andrastantos/unic/pics/fpga_solder_job.png

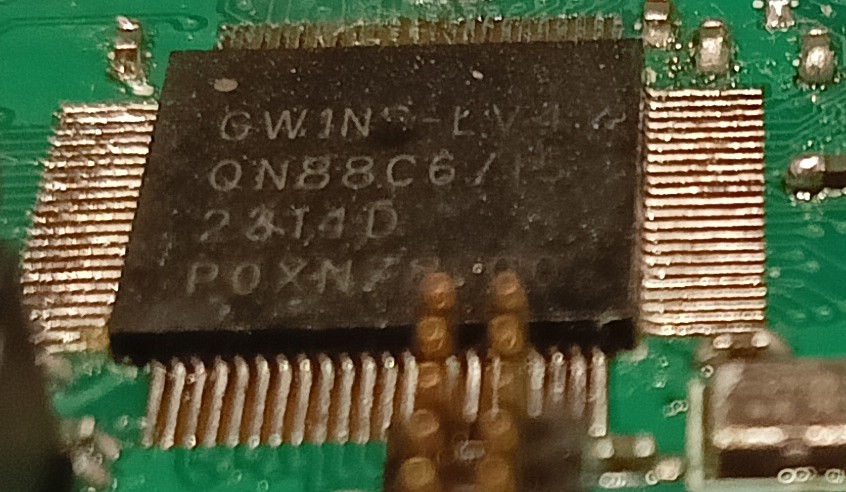
pics/fpga_solder_job.png
