andrastantos/unic/pics/IMG20240216153713.jpg

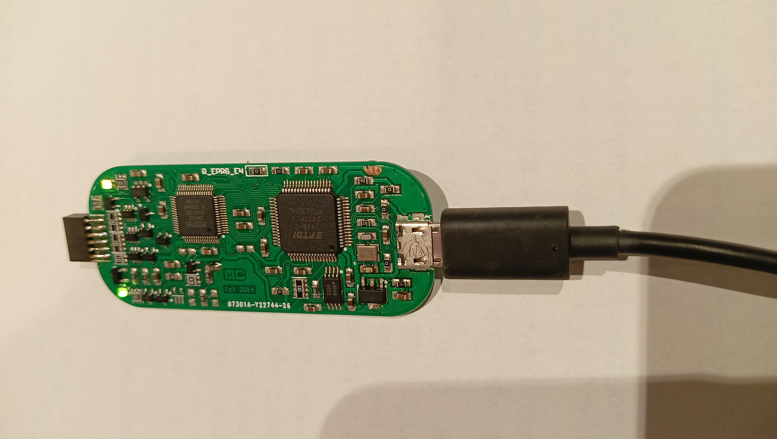
pics/IMG20240216153713.jpg
