andrastantos/unic/cores/unic_8088/readme.txt

cloned from https://github.com/MiSTer-devel/PCXT_MiSTer.git
