andrastantos/unic/datasheets/ledger_nano_s_display.webp

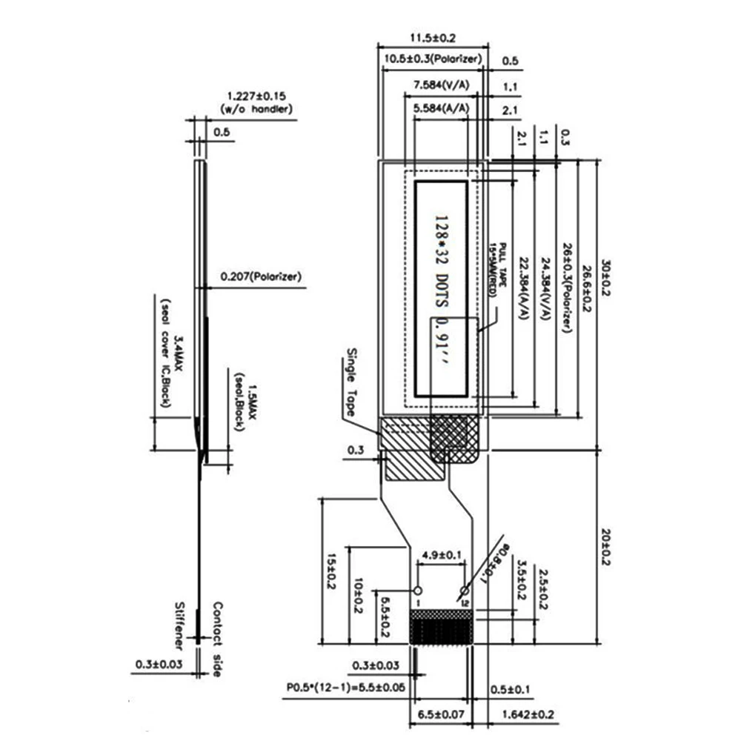
datasheets/ledger_nano_s_display.webp
