andrastantos/unic/pics/esd_protection.png

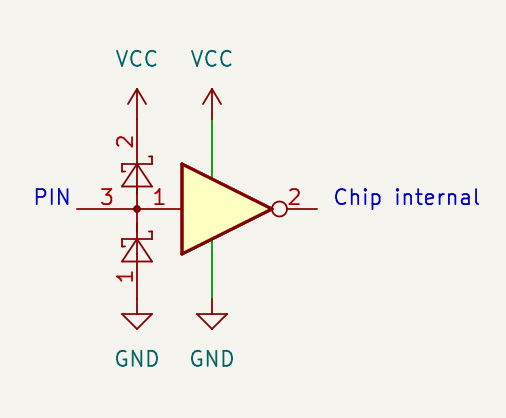
pics/esd_protection.png
