andrastantos/unic/pics/IMG20240216153532.jpg

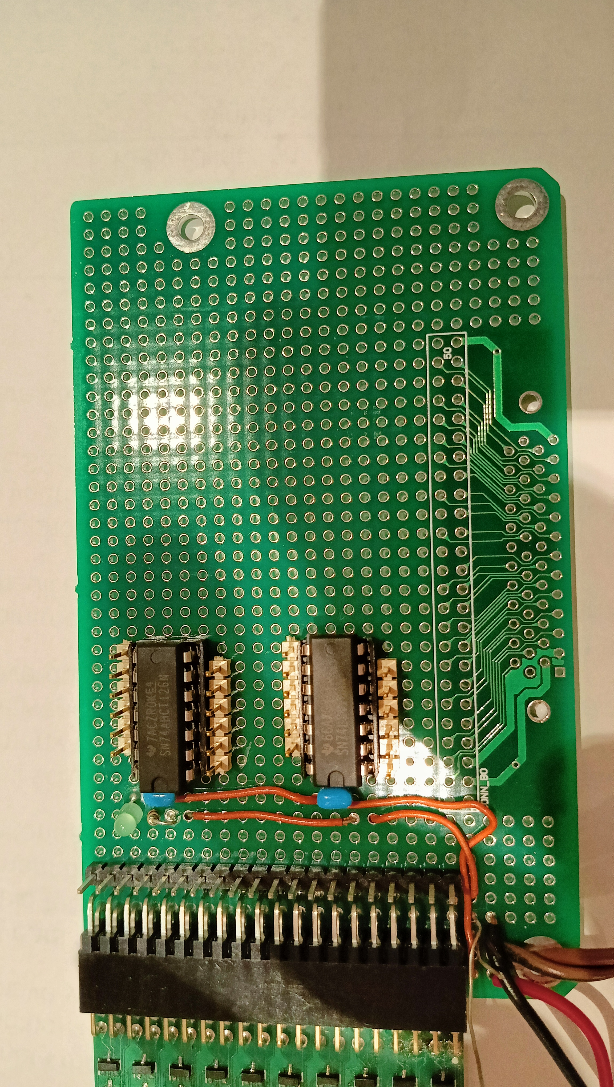
pics/IMG20240216153532.jpg
