andrastantos/unic/pics/IMG20240216153554.jpg

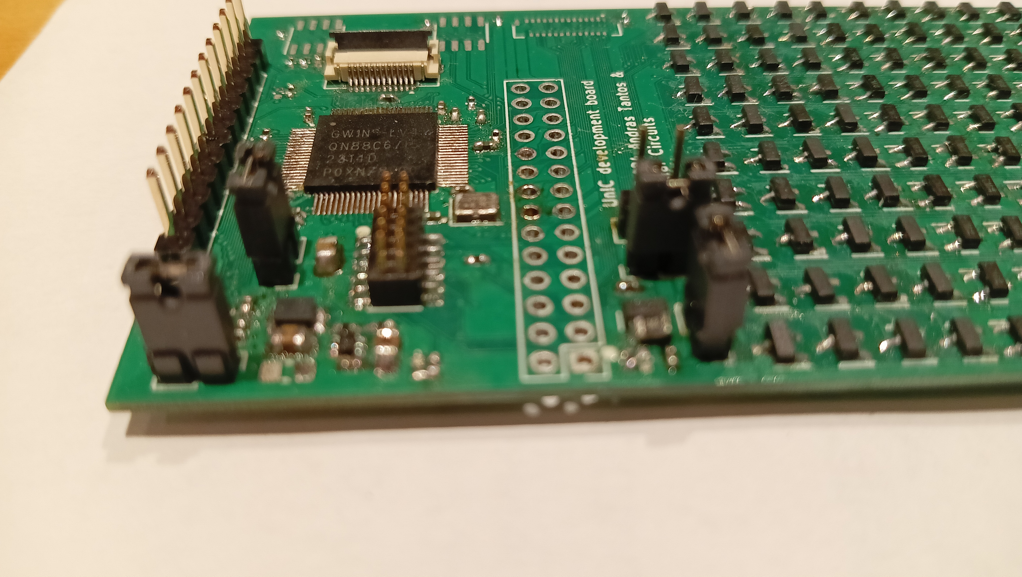
pics/IMG20240216153554.jpg
