andrastantos/unic/pics/level_shifter.png

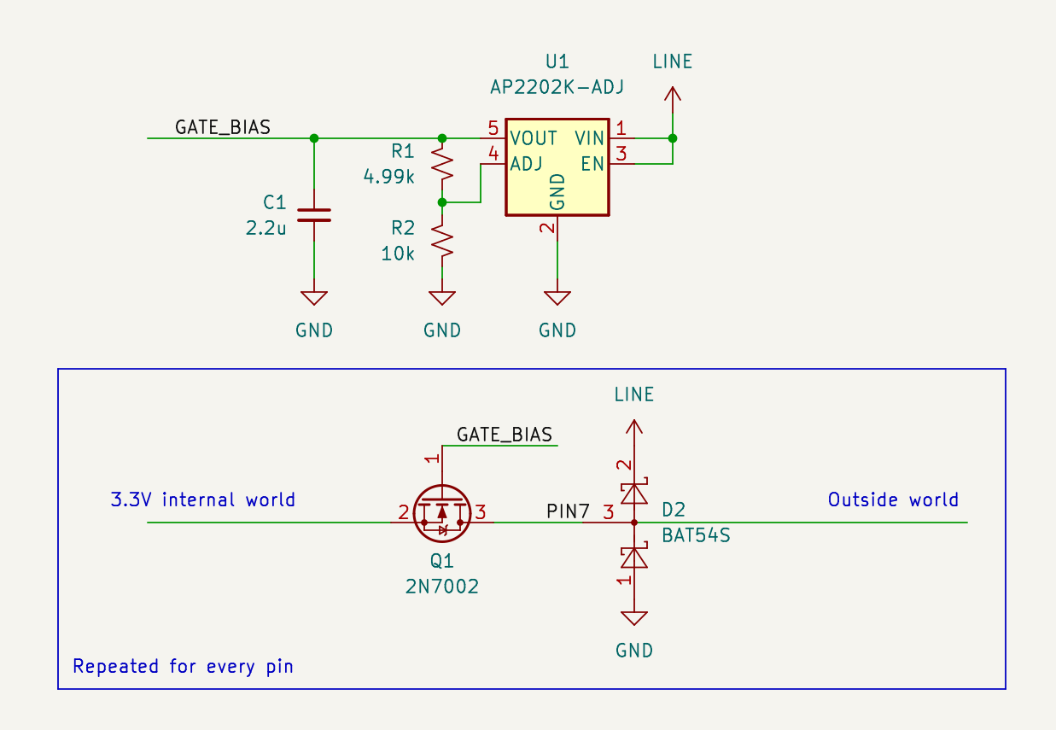
pics/level_shifter.png
