andrastantos/unic/pics/oled.png

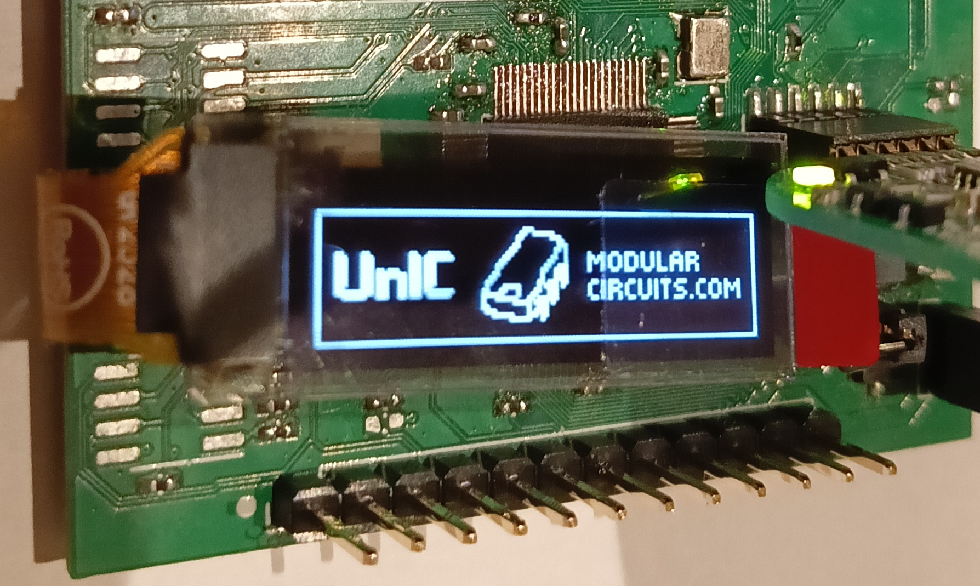
pics/oled.png
