andrastantos/unic/pics/Picture 2024-02-05 17-20-37.png

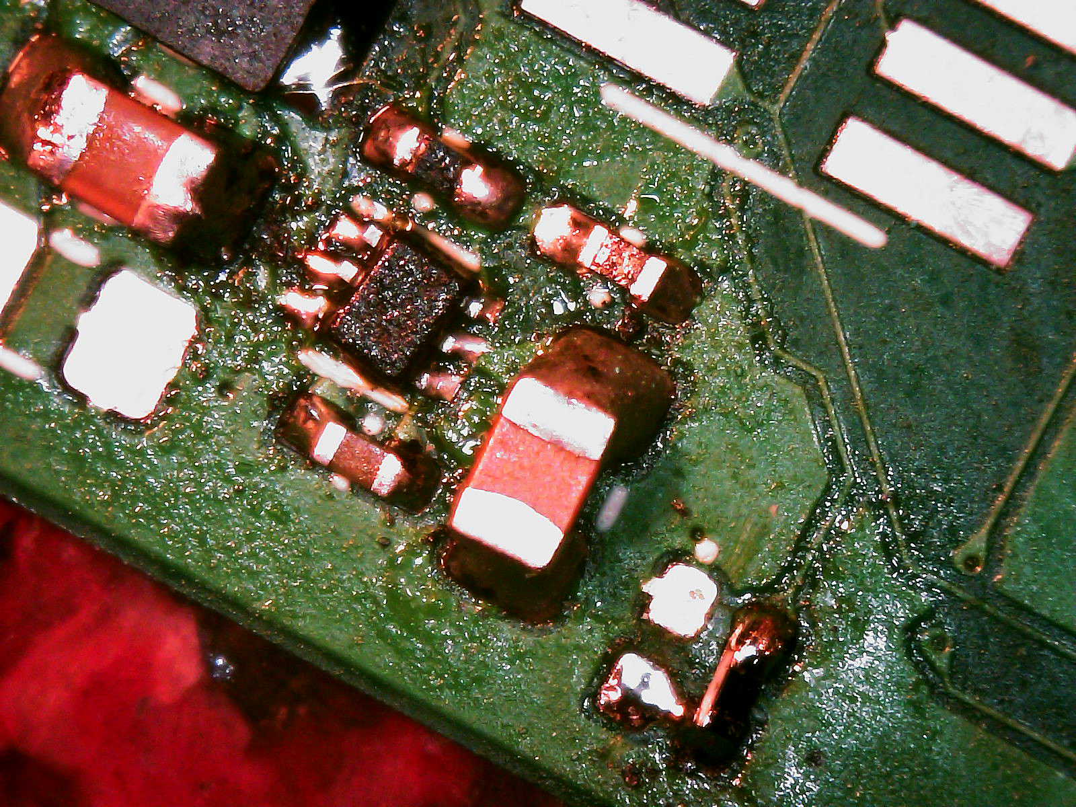
pics/Picture 2024-02-05 17-20-37.png
