andrastantos/unic/pics/SDS00025.png

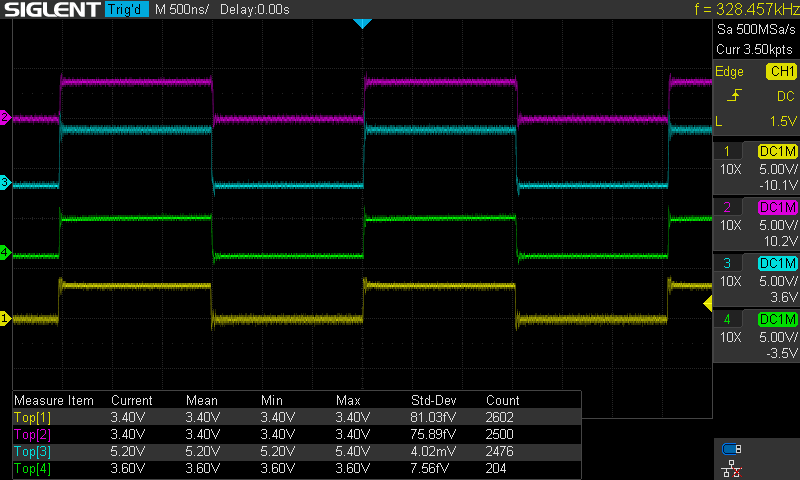
pics/SDS00025.png
