andrastantos/unic/pics/SDS00026.png

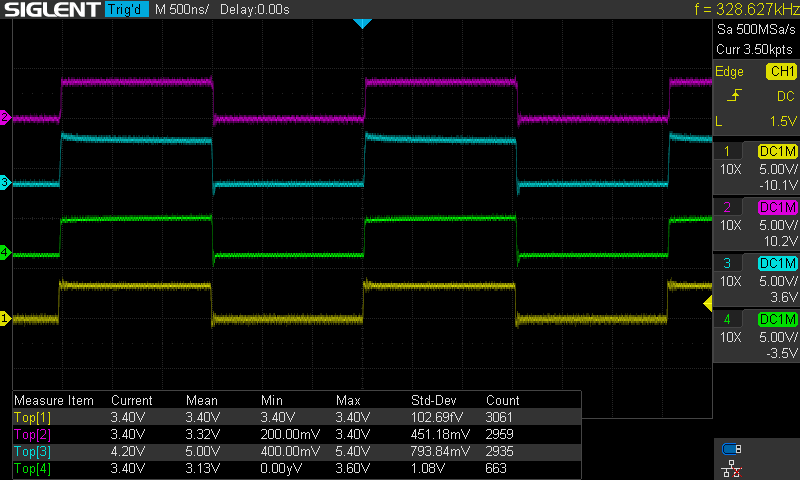
pics/SDS00026.png
