andrastantos/unic/pics/SDS00027.png

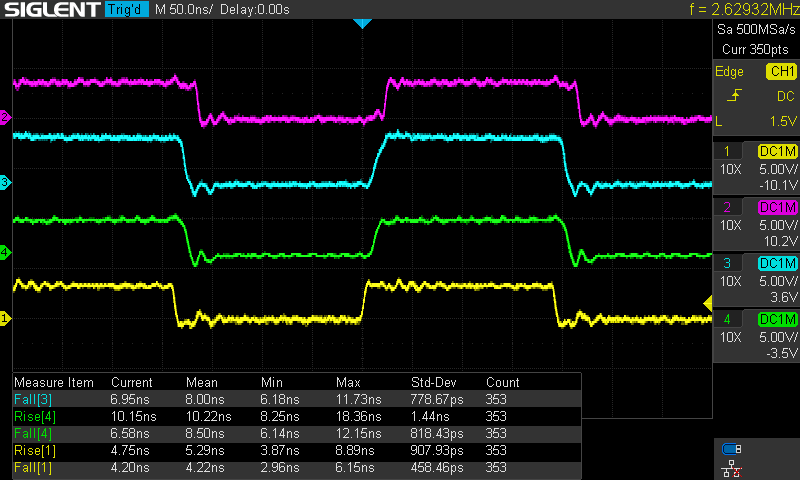
pics/SDS00027.png
