andrastantos/unic/pics/unic_gw1.png

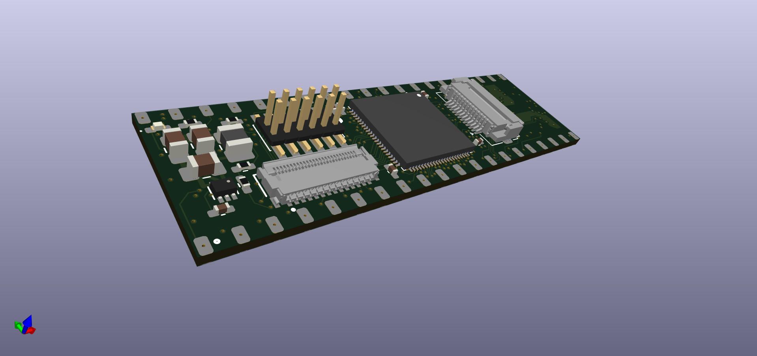
pics/unic_gw1.png
