andrastantos/unic/datasheets/gowin_fpga/UG168-1.2E_GW2A-18 & GW1N-9 FPGA Products Packages Compatibility Comparison.xlsx

Sheet: Version History
Date | Version | Description
03/10/2023 | 1.2E | The compatibility comparison of LQ144 removed.

Sheet: QN88
Note!
The shading with different colors is defined as follows:
1 |  | different pin functions
2 |  | different power
3 |  | different configuration functions
4 |  | different TRUE LVDS
5 | Pins with no shading are compatible
6 | No BANK compatibility comparison
7 | GW2A series VCC with 1.0V, GW1N series VCC with 1.2V
8 | GW2A series includes EXTR pin, GW1N series excludes EXTR pin
GW2A-18 QN88 |  |  |  |  |  |  |  | GW1N-9 QN88
QN88 | Pin Name | Function | DQS | BANK | Configuration Function | Differential Pair | LVDS | QN88 | Pin Name | Function | BANK | Configuration Function | Differential Pair | LVDS | X16
1 | VCC | Power |  | N/A |  |  |  | 1 | VCC | Power | N/A
2 | VSS | Ground |  | N/A |  |  |  | 2 | VSS | Ground | N/A
3 | VCCO7 | Power |  | N/A |  |  |  | 3 | IOL2A | I/O | 3 |  | True_of_IOL2B | TRUE | NONE
4 | IOL7A/LPLL1_T_in | I/O | DQ0 | 7 | LPLL1_T_in | True_of_IOL7B | NONE | 4 | IOL5A/JTAGSEL_N/LPLL_T_in | I/O | 3 | JTAGSEL_N/LPLL_T_in | True_of_IOL5B | NONE | NONE
5 | IOR25B/TMS | I/O | DQ10 | 2 | TMS | Comp_of_IOR25A | NONE | 5 | IOL11A/TMS | I/O | 3 | TMS | True_of_IOL11B | TRUE | NONE
6 | IOR26A/TCK | I/O | DQ10 | 2 | TCK | True_of_IOR26B | TRUE | 6 | IOL11B/TCK | I/O | 3 | TCK | Comp_of_IOL11A | TRUE | NONE
7 | IOR26B/TDI | I/O | DQ10 | 2 | TDI | Comp_of_IOR26A | TRUE | 7 | IOL12B/TDI | I/O | 3 | TDI | Comp_of_IOL12A | NONE | NONE
8 | IOR25A/TDO | I/O | DQ10 | 2 | TDO | True_of_IOR25B | NONE | 8 | IOL13A/TDO | I/O | 3 | TDO | True_of_IOL13B | TRUE | NONE
9 | IOR31B/RECONFIG_N | I/O | DQ9 | 3 | RECONFIG_N | Comp_of_IOR31A | TRUE | 9 | IOL13B/RECONFIG_N | I/O | 3 | RECONFIG_N | Comp_of_IOL13A | TRUE | NONE
10 | IOL29A/GCLKT_6 | I/O | DQ2 | 6 | GCLKT_6 | True_of_IOL29B | TRUE | 10 | IOL14A/DONE | I/O | 3 | DONE | True_of_IOL14B | NONE | NONE
11 | IOL29B/GCLKC_6 | I/O | DQ2 | 6 | GCLKC_6 | Comp_of_IOL29A | TRUE | 11 | IOL15A/GCLKT_6 | I/O | 3 | GCLKT_6 | True_of_IOL15B | TRUE | NONE
12 | VCCX/VCCO2/VCCO6 | Power |  | N/A |  |  |  | 12 | VCCO3 | Power | N/A
13 | IOL45A/LPLL2_T_in | I/O | DQ2 | 6 | LPLL2_T_in | True_of_IOL45B | NONE | 13 | IOL22A | I/O | 3 |  | True_of_IOL22B | TRUE | NONE
14 | VCCPLLL1 | Power |  | N/A |  |  |  | 14 | IOL22B | I/O | 3 |  | Comp_of_IOL22A | TRUE | NONE
15 | IOL47A/LPLL2_T_fb | I/O | DQ3 | 6 | LPLL2_T_fb | True_of_IOL47B | TRUE | 15 | IOL26A | I/O | 3 |  | True_of_IOL26B | TRUE | NONE
16 | IOL47B/LPLL2_C_fb | I/O | DQ3 | 6 | LPLL2_C_fb | Comp_of_IOL47A | TRUE | 16 | IOL26B | I/O | 3 |  | Comp_of_IOL26A | TRUE | NONE
17 | IOL49A | I/O | DQ3 | 6 |  | True_of_IOL49B | TRUE | 17 | IOB2A | I/O | 2 |  | True_of_IOB2B | TRUE | x16
18 | IOL49B | I/O | DQ3 | 6 |  | Comp_of_IOL49A | TRUE | 18 | IOB2B | I/O | 2 |  | Comp_of_IOB2A | TRUE | NONE
19 | IOL51A | I/O | DQ3 | 6 |  | True_of_IOL51B | TRUE | 19 | IOB4A | I/O | 2 |  | True_of_IOB4B | TRUE | x16
20 | IOL51B | I/O | DQ3 | 6 |  | Comp_of_IOL51A | TRUE | 20 | IOB4B | I/O | 2 |  | Comp_of_IOB4A | TRUE | NONE
21 | VSS | Ground |  | N/A |  |  |  | 21 | VSS | Ground | N/A
22 | VCC | Power |  | N/A |  |  |  | 22 | VCC | Power | N/A
23 | VCCO5 | Power |  | N/A |  |  |  | 23 | VCCO2 | Power | N/A
24 | VSS | Ground |  | N/A |  |  |  | 24 | VSS | Ground | N/A
25 | IOB6A | I/O | DQ4 | 5 |  | True_of_IOB6B | TRUE | 25 | IOB8A | I/O | 2 |  | True_of_IOB8B | TRUE | x16
26 | IOB6B | I/O | DQ4 | 5 |  | Comp_of_IOB6A | TRUE | 26 | IOB8B | I/O | 2 |  | Comp_of_IOB8A | TRUE | NONE
27 | IOB8A | I/O | DQ4 | 5 |  | True_of_IOB8B | TRUE | 27 | IOB11A | I/O | 2 |  | True_of_IOB11B | TRUE | x16
28 | IOB8B | I/O | DQ4 | 5 |  | Comp_of_IOB8A | TRUE | 28 | IOB11B | I/O | 2 |  | Comp_of_IOB11A | TRUE | NONE
29 | IOB14A | I/O | DQ5 | 5 |  | True_of_IOB14B | TRUE | 29 | IOB13A | I/O | 2 |  | True_of_IOB13B | TRUE | x16
30 | IOB14B | I/O | DQ5 | 5 |  | Comp_of_IOB14A | TRUE | 30 | IOB13B | I/O | 2 |  | Comp_of_IOB13A | TRUE | NONE
31 | IOB18A | I/O | DQ5 | 5 |  | True_of_IOB18B | TRUE | 31 | IOB17A | I/O | 2 |  | True_of_IOB17B | TRUE | x16
32 | IOB18B | I/O | DQ5 | 5 |  | Comp_of_IOB18A | TRUE | 32 | IOB17B | I/O | 2 |  | Comp_of_IOB17A | TRUE | NONE
33 | IOB24A | I/O | DQ5 | 5 |  | True_of_IOB24B | TRUE | 33 | IOB23A | I/O | 2 |  | True_of_IOB23B | TRUE | x16
34 | IOB24B | I/O | DQ5 | 5 |  | Comp_of_IOB24A | TRUE | 34 | IOB23B | I/O | 2 |  | Comp_of_IOB23A | TRUE | NONE
35 | IOB30A/GCLKT_4 | I/O | DQ6 | 4 | GCLKT_4 | True_of_IOB30B | TRUE | 35 | IOB29A/GCLKT_4 | I/O | 2 | GCLKT_4 | True_of_IOB29B | TRUE | x16
36 | IOB30B/GCLKC_4 | I/O | DQ6 | 4 | GCLKC_4 | Comp_of_IOB30A | TRUE | 36 | IOB29B/GCLKC_4 | I/O | 2 | GCLKC_4 | Comp_of_IOB29A | TRUE | NONE
37 | IOB34A | I/O | DQ6 | 4 |  | True_of_IOB34B | TRUE | 37 | IOB31A | I/O | 2 |  | True_of_IOB31B | TRUE | x16
38 | IOB34B | I/O | DQ6 | 4 |  | Comp_of_IOB34A | TRUE | 38 | IOB31B | I/O | 2 |  | Comp_of_IOB31A | TRUE | NONE
39 | IOB40A | I/O | DQ6 | 4 |  | True_of_IOB40B | TRUE | 39 | IOB33A | I/O | 2 |  | True_of_IOB33B | TRUE | x16
40 | IOB40B | I/O | DQ6 | 4 |  | Comp_of_IOB40A | TRUE | 40 | IOB33B | I/O | 2 |  | Comp_of_IOB33A | TRUE | NONE
41 | IOB43A | I/O | DQ6 | 4 |  | True_of_IOB43B | NONE | 41 | IOB41A | I/O | 2 |  | True_of_IOB41B | TRUE | x16
42 | IOB42B | I/O | DQ6 | 4 |  | Comp_of_IOB42A | TRUE | 42 | IOB41B | I/O | 2 |  | Comp_of_IOB41A | TRUE | NONE
43 | VSS | Ground |  | N/A |  |  |  | 43 | VSS | Ground | N/A
44 | VCCO4 | Power |  | N/A |  |  |  | 44 | VCCO2 | Power | N/A
45 | VCC | Power |  | N/A |  |  |  | 45 | VCC | Power | N/A
46 | VSS | Ground |  | N/A |  |  |  | 46 | VSS | Ground | N/A
47 | EXTR | Ground |  | N/A |  |  |  | 47 | IOB43B | I/O | 2 |  | Comp_of_IOB43A | TRUE | NONE
48 | IOR49B | I/O | DQ8 | 3 |  | Comp_of_IOR49A | TRUE | 48 | IOR24B | I/O | 1 |  | Comp_of_IOR24A | TRUE | NONE
49 | IOR49A | I/O | DQ8 | 3 |  | True_of_IOR49B | TRUE | 49 | IOR24A | I/O | 1 |  | True_of_IOR24B | TRUE | NONE
50 | VCCPLLR1 | Power |  | N/A |  |  |  | 50 | IOR22B | I/O | 1 |  | Comp_of_IOR22A | TRUE | NONE
51 | IOR45A/RPLL2_T_in | I/O | DQ9 | 3 | RPLL2_T_in | True_of_IOR45B | NONE | 51 | IOR17B/GCLKC_3 | I/O | 1 | GCLKC_3 | Comp_of_IOR17A | TRUE | NONE
52 | IOR39A/SCLK | I/O | DQ9 | 3 | SCLK | True_of_IOR39B | NONE | 52 | IOR17A/GCLKT_3 | I/O | 1 | GCLKT_3 | True_of_IOR17B | TRUE | NONE
53 | IOR38B/DOUT/WE_N | I/O | DQ9 | 3 | DOUT/WE_N | Comp_of_IOR38A | TRUE | 53 | IOR15B/DOUT/WE_N | I/O | 1 | DOUT/WE_N | Comp_of_IOR15A | TRUE | NONE
54 | IOR38A/DIN/CLKHOLD_N | I/O | DQ9 | 3 | DIN/CLKHOLD_N | True_of_IOR38B | TRUE | 54 | IOR15A/DIN/CLKHOLD_N | I/O | 1 | DIN/CLKHOLD_N | True_of_IOR15B | TRUE | NONE
55 | IOR36B/SSPI_CS_N/D0 | I/O | DQS9 | 3 | SSPI_CS_N/D0 | Comp_of_IOR36A | NONE | 55 | IOR14B/SSPI_CS_N/D0 | I/O | 1 | SSPI_CS_N/D0 | Comp_of_IOR14A | NONE | NONE
56 | IOR36A/SO/D1 | I/O | DQS9 | 3 | SO/D1 | True_of_IOR36B | NONE | 56 | IOR14A/SO/D1 | I/O | 1 | SO/D1 | True_of_IOR14B | NONE | NONE
57 | IOR35A/FASTRD_N/D3 | I/O | DQ9 | 3 | FASTRD_N/D3 | True_of_IOR35B | TRUE | 57 | IOR13A/FASTRD_N/D3 | I/O | 1 | FASTRD_N/D3 | True_of_IOR13B | TRUE | NONE
58 | VCCO3 | Power |  | N/A |  |  |  | 58 | VCCO1 | Power | N/A
59 | IOR34B/MCLK/D4 | I/O | DQ9 | 3 | MCLK/D4 | Comp_of_IOR34A | NONE | 59 | IOR12B/MCLK/D4 | I/O | 1 | MCLK/D4 | Comp_of_IOR12A | NONE | NONE
60 | IOR34A/MCS_N/D5 | I/O | DQ9 | 3 | MCS_N/D5 | True_of_IOR34B | NONE | 60 | IOR12A/MCS_N/D5 | I/O | 1 | MCS_N/D5 | True_of_IOR12B | NONE | NONE
61 | IOR33B/MO/D6 | I/O | DQ9 | 3 | MO/D6 | Comp_of_IOR33A | TRUE | 61 | IOR11B/MO/D6 | I/O | 1 | MO/D6 | Comp_of_IOR11A | TRUE | NONE
62 | IOR33A/MI/D7 | I/O | DQ9 | 3 | MI/D7 | True_of_IOR33B | TRUE | 62 | IOR11A/MI/D7 | I/O | 1 | MI/D7 | True_of_IOR11B | TRUE | NONE
63 | IOR29A/GCLKT_3 | I/O | DQ9 | 3 | GCLKT_3 | True_of_IOR29B | TRUE | 63 | IOR5A/RPLL_T_in | I/O | 1 | RPLL_T_in | True_of_IOR5B | NONE | NONE
64 | VCCX/VCCO2/VCCO6 | Power |  | N/A |  |  |  | 64 | VCCX | Power | N/A
65 | VSS | Ground |  | N/A |  |  |  | 65 | VSS | Ground | N/A
66 | VCC | Power |  | N/A |  |  |  | 66 | VCC | Power | N/A
67 | VCCO1 | Power |  | N/A |  |  |  | 67 | VCCO0 | Power | N/A
68 | VSS | Ground |  | N/A |  |  |  | 68 | IOT42B | I/O | 1 |  | Comp_of_IOT42A | NONE | NONE
69 | IOT50A | I/O | DQ12 | 1 |  | True_of_IOT50B | TRUE | 69 | IOT42A | I/O | 1 |  | True_of_IOT42B | NONE | NONE
70 | IOT44B | I/O | DQ13 | 1 |  | Comp_of_IOT44A | TRUE | 70 | IOT41B | I/O | 1 |  | Comp_of_IOT41A | NONE | NONE
71 | IOT44A | I/O | DQ13 | 1 |  | True_of_IOT44B | TRUE | 71 | IOT41A | I/O | 1 |  | True_of_IOT41B | NONE | x16
72 | IOT40B | I/O | DQ13 | 1 |  | Comp_of_IOT40A | TRUE | 72 | IOT39B | I/O | 1 |  | Comp_of_IOT39A | NONE | NONE
73 | IOT40A | I/O | DQ13 | 1 |  | True_of_IOT40B | TRUE | 73 | IOT39A | I/O | 1 |  | True_of_IOT39B | NONE | x16
74 | IOT34B | I/O | DQ13 | 1 |  | Comp_of_IOT34A | TRUE | 74 | IOT38B | I/O | 1 |  | Comp_of_IOT38A | NONE | NONE
75 | IOT34A | I/O | DQ13 | 1 |  | True_of_IOT34B | TRUE | 75 | IOT38A | I/O | 1 |  | True_of_IOT38B | NONE | NONE
76 | IOT30B/GCLKC_1 | I/O | DQ13 | 1 | GCLKC_1 | Comp_of_IOT30A | TRUE | 76 | IOT37B | I/O | 1 |  | Comp_of_IOT37A | NONE | NONE
77 | IOT30A/GCLKT_1 | I/O | DQ13 | 1 | GCLKT_1 | True_of_IOT30B | TRUE | 77 | IOT37A | I/O | 1 |  | True_of_IOT37B | NONE | NONE
78 | VCCO0 | Power |  | N/A |  |  |  | 78 | VCCX | Power | N/A
79 | IOT27B/GCLKC_0 | I/O | DQ14 | 0 | GCLKC_0 | Comp_of_IOT27A | NONE | 79 | IOT12B | I/O | 3 |  | Comp_of_IOT12A | NONE | NONE
80 | IOT27A/GCLKT_0 | I/O | DQ14 | 0 | GCLKT_0 | True_of_IOT27B | NONE | 80 | IOT12A | I/O | 3 |  | True_of_IOT12B | NONE | NONE
81 | IOT17B | I/O | DQ14 | 0 |  | Comp_of_IOT17A | NONE | 81 | IOT11B | I/O | 3 |  | Comp_of_IOT11A | NONE | NONE
82 | IOT17A | I/O | DQ14 | 0 |  | True_of_IOT17B | NONE | 82 | IOT11A | I/O | 3 |  | True_of_IOT11B | NONE | x16
83 | IOT6B | I/O | DQ15 | 0 |  | Comp_of_IOT6A | TRUE | 83 | IOT10B | I/O | 3 |  | Comp_of_IOT10A | NONE | NONE
84 | IOT6A | I/O | DQ15 | 0 |  | True_of_IOT6B | TRUE | 84 | IOT10A | I/O | 3 |  | True_of_IOT10B | NONE | NONE
85 | IOT4B | I/O | DQ15 | 0 |  | Comp_of_IOT4A | TRUE | 85 | IOT8B | I/O | 3 |  | Comp_of_IOT8A | NONE | NONE
86 | IOT4A | I/O | DQ15 | 0 |  | True_of_IOT4B | TRUE | 86 | IOT8A | I/O | 3 |  | True_of_IOT8B | NONE | x16
87 | IOR30B/MODE1 | I/O | DQ9 | 3 | MODE1 | Comp_of_IOR30A | NONE | 87 | IOT6B/MODE1 | I/O | 3 | MODE1 | Comp_of_IOT6A | NONE | NONE
88 | IOR30A/MODE0 | I/O | DQ9 | 3 | MODE0 | True_of_IOR30B | NONE | 88 | IOT5A/MODE0 | I/O | 3 | MODE0 | True_of_IOT5B | NONE | NONE

Sheet: PG256
Note!
The shading with different colors is defined as follows:
1 |  | different pin functions
2 |  | different power
3 |  | different configuration functions
4 |  | different TRUE LVDS
5 | Pins with no shading are compatible
6 | No BANK compatibility comparison
7 | GW2A series VCC with 1.0V, GW1N series VCC with 1.2V
8 | GW2A series includes EXTR pin, GW1N series excludes EXTR pin
GW2A-18 PG256 |  |  |  |  |  |  |  | GW1N-9 PG256
PG256 | Pin Name | Function | DQS | BANK | Configuration Function | Differential Pair | LVDS | PG256 | Pin Name | Function | BANK | Configuration Function | Differential Pair | LVDS | X16
A1 | VCC | Power |  | N/A |  |  |  | A1 | VCC | Power | N/A
A10 | IOL33B | I/O | DQ2 | 6 |  | Comp_of_IOL33A | TRUE | A10 | IOL18B | I/O | 3 |  | Comp_of_IOL18A | NONE | NONE
A11 | IOL15A | I/O | DQ1 | 7 |  | True_of_IOL15B | TRUE | A11 | IOL7A | I/O | 3 |  | True_of_IOL7B | NONE | NONE
A12 | IOL13B | I/O | DQ1 | 7 |  | Comp_of_IOL13A | TRUE | A12 | IOL4B | I/O | 3 |  | Comp_of_IOL4A | TRUE | NONE
A13 | IOR32A/READY | I/O | DQ9 | 3 | READY | True_of_IOR32B | NONE | A13 | IOL14B/READY | I/O | 3 | READY | Comp_of_IOL14A | NONE | NONE
A14 | IOL8B/LPLL1_C_fb | I/O | DQ0 | 7 | LPLL1_C_fb | Comp_of_IOL8A | TRUE | A14 | IOL6B/LPLL_C_fb | I/O | 3 | LPLL_C_fb | Comp_of_IOL6A | TRUE | NONE
A15 | IOL2B | I/O | DQ0 | 7 |  | Comp_of_IOL2A | TRUE | A15 | IOL2B | I/O | 3 |  | Comp_of_IOL2A | TRUE | NONE
A16 | VCC | Power |  | N/A |  |  |  | A16 | VCC | Power | N/A
A2 | IOB13B | I/O | DQ5 | 5 |  | Comp_of_IOB13A | NONE | A2 | IOB12B | I/O | 2 |  | Comp_of_IOB12A | NONE | NONE
A3 | IOB4A | I/O | DQ4 | 5 |  | True_of_IOB4B | TRUE | A3 | IOB8A | I/O | 2 |  | True_of_IOB8B | TRUE | x16
A4 | IOB2A | I/O | DQ4 | 5 |  | True_of_IOB2B | TRUE | A4 | IOB6A | I/O | 2 |  | True_of_IOB6B | TRUE | x16
A5 | IOB7A | I/O | DQ4 | 5 |  | True_of_IOB7B | NONE | A5 | IOB7A | I/O | 2 |  | True_of_IOB7B | NONE | NONE
A6 | IOR26B/TDI | I/O | DQ10 | 2 | TDI | Comp_of_IOR26A | TRUE | A6 | IOL12B/TDI | I/O | 3 | TDI | Comp_of_IOL12A | NONE | NONE
A7 | IOR26A/TCK | I/O | DQ10 | 2 | TCK | True_of_IOR26B | TRUE | A7 | IOL11B/TCK | I/O | 3 | TCK | Comp_of_IOL11A | TRUE | NONE
A8 | IOL29B/GCLKC_6 | I/O | DQ2 | 6 | GCLKC_6 | Comp_of_IOL29A | TRUE | A8 | IOL15B/GCLKC_6 | I/O | 3 | GCLKC_6 | Comp_of_IOL15A | TRUE | NONE
A9 | IOL27A/GCLKT_7 | I/O | DQ1 | 7 | GCLKT_7 | True_of_IOL27B | NONE | A9 | IOL9A/GCLKT_7 | I/O | 3 | GCLKT_7 | True_of_IOL9B | NONE | NONE
B1 | IOB8A | I/O | DQ4 | 5 |  | True_of_IOB8B | TRUE | B1 | IOB11A | I/O | 2 |  | True_of_IOB11B | TRUE | x16
B10 | IOR31B/RECONFIG_N | I/O | DQ9 | 3 | RECONFIG_N | Comp_of_IOR31A | TRUE | B10 | IOL13B/RECONFIG_N | I/O | 3 | RECONFIG_N | Comp_of_IOL13A | TRUE | NONE
B11 | IOL13A | I/O | DQ1 | 7 |  | True_of_IOL13B | TRUE | B11 | IOL4A | I/O | 3 |  | True_of_IOL4B | TRUE | NONE
B12 | IOL7B/LPLL1_C_in | I/O | DQ0 | 7 | LPLL1_C_in | Comp_of_IOL7A | NONE | B12 | IOL5B/LPLL_C_in | I/O | 3 | LPLL_C_in | Comp_of_IOL5A | NONE | NONE
B13 | IOL8A/LPLL1_T_fb | I/O | DQ0 | 7 | LPLL1_T_fb | True_of_IOL8B | TRUE | B13 | IOL6A/LPLL_T_fb | I/O | 3 | LPLL_T_fb | True_of_IOL6B | TRUE | NONE
B14 | IOL2A | I/O | DQ0 | 7 |  | True_of_IOL2B | TRUE | B14 | IOL2A | I/O | 3 |  | True_of_IOL2B | TRUE | NONE
B15 | VSS | Ground |  | N/A |  |  |  | B15 | VSS | Ground | N/A
B16 | IOR30B/MODE1 | I/O | DQ9 | 3 | MODE1 | Comp_of_IOR30A | NONE | B16 | IOT6B/MODE1 | I/O | 3 | MODE1 | Comp_of_IOT6A | NONE | NONE
B2 | VSS | Ground |  | N/A |  |  |  | B2 | VSS | Ground | N/A
B3 | IOB13A | I/O | DQ5 | 5 |  | True_of_IOB13B | NONE | B3 | IOB12A | I/O | 2 |  | True_of_IOB12B | NONE | NONE
B4 | IOB4B | I/O | DQ4 | 5 |  | Comp_of_IOB4A | TRUE | B4 | IOB8B | I/O | 2 |  | Comp_of_IOB8A | TRUE | NONE
B5 | IOL47B/LPLL2_C_fb | I/O | DQ3 | 6 | LPLL2_C_fb | Comp_of_IOL47A | TRUE | B5 | IOL24B | I/O | 3 |  | Comp_of_IOL24A | TRUE | NONE
B6 | IOB7B | I/O | DQ4 | 5 |  | Comp_of_IOB7A | NONE | B6 | IOB7B | I/O | 2 |  | Comp_of_IOB7A | NONE | NONE
B7 | IOL40A | I/O | DQ2 | 6 |  | True_of_IOL40B | TRUE | B7 | IOL22A | I/O | 3 |  | True_of_IOL22B | TRUE | NONE
B8 | IOR25B/TMS | I/O | DQ10 | 2 | TMS | Comp_of_IOR25A | NONE | B8 | IOL11A/TMS | I/O | 3 | TMS | True_of_IOL11B | TRUE | NONE
B9 | IOL33A | I/O | DQ2 | 6 |  | True_of_IOL33B | TRUE | B9 | IOL18A | I/O | 3 |  | True_of_IOL18B | NONE | NONE
C1 | IOB14A | I/O | DQ5 | 5 |  | True_of_IOB14B | TRUE | C1 | IOB10A | I/O | 2 |  | True_of_IOB10B | NONE | NONE
C10 | IOR39A/SCLK | I/O | DQ9 | 3 | SCLK | True_of_IOR39B | NONE | C10 | IOL12A/SCLK | I/O | 3 | SCLK | True_of_IOL12B | NONE | NONE
C11 | IOL15B | I/O | DQ1 | 7 |  | Comp_of_IOL15A | TRUE | C11 | IOL7B | I/O | 3 |  | Comp_of_IOL7A | NONE | NONE
C12 | IOL7A/LPLL1_T_in | I/O | DQ0 | 7 | LPLL1_T_in | True_of_IOL7B | NONE | C12 | IOL5A/JTAGSEL_N/LPLL_T_in | I/O | 3 | JTAGSEL_N/LPLL_T_in | True_of_IOL5B | NONE | NONE
C13 | IOR32B/DONE | I/O | DQ9 | 3 | DONE | Comp_of_IOR32A | NONE | C13 | IOL14A/DONE | I/O | 3 | DONE | True_of_IOL14B | NONE | NONE
C14 | VSS | Ground |  | N/A |  |  |  | C14 | VSS | Ground | N/A
C15 | IOR31A/MODE2 | I/O | DQ9 | 3 | MODE2 | True_of_IOR31B | TRUE | C15 | IOT5B/MODE2 | I/O | 3 | MODE2 | Comp_of_IOT5A | NONE | NONE
C16 | IOT5A | I/O | DQ15 | 0 |  | True_of_IOT5B | NONE | C16 | IOT10A | I/O | 3 |  | True_of_IOT10B | NONE | NONE
C2 | IOB8B | I/O | DQ4 | 5 |  | Comp_of_IOB8A | TRUE | C2 | IOB11B | I/O | 2 |  | Comp_of_IOB11A | TRUE | NONE
C3 | VSS | Ground |  | N/A |  |  |  | C3 | VSS | Ground | N/A
C4 | IOL47A/LPLL2_T_fb | I/O | DQ3 | 6 | LPLL2_T_fb | True_of_IOL47B | TRUE | C4 | IOL24A | I/O | 3 |  | True_of_IOL24B | TRUE | NONE
C5 | IOB2B | I/O | DQ4 | 5 |  | Comp_of_IOB2A | TRUE | C5 | IOB6B | I/O | 2 |  | Comp_of_IOB6A | TRUE | NONE
C6 | IOR25A/TDO | I/O | DQ10 | 2 | TDO | True_of_IOR25B | NONE | C6 | IOL13A/TDO | I/O | 3 | TDO | True_of_IOL13B | TRUE | NONE
C7 | IOL40B | I/O | DQ2 | 6 |  | Comp_of_IOL40A | TRUE | C7 | IOL22B | I/O | 3 |  | Comp_of_IOL22A | TRUE | NONE
C8 | IOL29A/GCLKT_6 | I/O | DQ2 | 6 | GCLKT_6 | True_of_IOL29B | TRUE | C8 | IOL15A/GCLKT_6 | I/O | 3 | GCLKT_6 | True_of_IOL15B | TRUE | NONE
C9 | IOL27B/GCLKC_7 | I/O | DQ1 | 7 | GCLKC_7 | Comp_of_IOL27A | NONE | C9 | IOL9B/GCLKC_7 | I/O | 3 | GCLKC_7 | Comp_of_IOL9A | NONE | NONE
D1 | IOB9B | I/O | DQS4 | 5 |  | Comp_of_IOB9A | NONE | D1 | IOB9B | I/O | 2 |  | Comp_of_IOB9A | NONE | NONE
D10 | IOL17A | I/O | DQ1 | 7 |  | True_of_IOL17B | TRUE | D10 | IOL8A | I/O | 3 |  | True_of_IOL8B | TRUE | NONE
D11 | IOL22A | I/O | DQS1 | 7 |  | True_of_IOL22B | TRUE | D11 | IOL3B | I/O | 3 |  | Comp_of_IOL3A | NONE | NONE
D12 | VCCO7 | Power |  | N/A |  |  |  | D12 | VCCO3 | Power | N/A
D13 | VSS | Ground |  | N/A |  |  |  | D13 | VSS | Ground | N/A
D14 | IOT44A | I/O | DQ13 | 1 |  | True_of_IOT44B | TRUE | D14 | IOT38A | I/O | 1 |  | True_of_IOT38B | NONE | NONE
D15 | IOT5B | I/O | DQ15 | 0 |  | Comp_of_IOT5A | NONE | D15 | IOT10B | I/O | 3 |  | Comp_of_IOT10A | NONE | NONE
D16 | IOT4A | I/O | DQ15 | 0 |  | True_of_IOT4B | TRUE | D16 | IOT9A | I/O | 3 |  | True_of_IOT9B | NONE | NONE
D2 | IOB14B | I/O | DQ5 | 5 |  | Comp_of_IOB14A | TRUE | D2 | IOB10B | I/O | 2 |  | Comp_of_IOB10A | NONE | NONE
D3 | IOB9A | I/O | DQS4 | 5 |  | True_of_IOB9B | NONE | D3 | IOB9A | I/O | 2 |  | True_of_IOB9B | NONE | NONE
D4 | VSS | Ground |  | N/A |  |  |  | D4 | VSS | Ground | N/A
D5 | VCCO6 | Power |  | N/A |  |  |  | D5 | VCCO3 | Power | N/A
D6 | IOB3A | I/O | DQ4 | 5 |  | True_of_IOB3B | NONE | D6 | IOB5A | I/O | 2 |  | True_of_IOB5B | NONE | NONE
D7 | IOL53B | I/O | DQ3 | 6 |  | Comp_of_IOL53A | TRUE | D7 | IOL25B | I/O | 3 |  | Comp_of_IOL25A | NONE | NONE
D8 | IOL38A | I/O | DQ2 | 6 |  | True_of_IOL38B | TRUE | D8 | IOL21A | I/O | 3 |  | True_of_IOL21B | NONE | NONE
D9 | IOL35B | I/O | DQ2 | 6 |  | Comp_of_IOL35A | TRUE | D9 | IOL20B | I/O | 3 |  | Comp_of_IOL20A | TRUE | NONE
E1 | IOB16A | I/O | DQ5 | 5 |  | True_of_IOB16B | TRUE | E1 | IOB14A | I/O | 2 |  | True_of_IOB14B | NONE | NONE
E10 | IOL17B | I/O | DQ1 | 7 |  | Comp_of_IOL17A | TRUE | E10 | IOL8B | I/O | 3 |  | Comp_of_IOL8A | TRUE | NONE
E11 | IOL31B | I/O | DQ2 | 6 |  | Comp_of_IOL31A | TRUE | E11 | IOL16B | I/O | 3 |  | Comp_of_IOL16A | NONE | NONE
E12 | VSS | Ground |  | N/A |  |  |  | E12 | VSS | Ground | N/A
E13 | VCCO0 | Power |  | N/A |  |  |  | E13 | VCCO0 | Power | N/A
E14 | IOT4B | I/O | DQ15 | 0 |  | Comp_of_IOT4A | TRUE | E14 | IOT9B | I/O | 3 |  | Comp_of_IOT9A | NONE | NONE
E15 | IOT44B | I/O | DQ13 | 1 |  | Comp_of_IOT44A | TRUE | E15 | IOT38B | I/O | 1 |  | Comp_of_IOT38A | NONE | NONE
E16 | IOT6A | I/O | DQ15 | 0 |  | True_of_IOT6B | TRUE | E16 | IOT13A | I/O | 0 |  | True_of_IOT13B | NONE | x16
E2 | IOB12A | I/O | DQ5 | 5 |  | True_of_IOB12B | TRUE | E2 | IOB13A | I/O | 2 |  | True_of_IOB13B | TRUE | x16
E3 | IOB12B | I/O | DQ5 | 5 |  | Comp_of_IOB12A | TRUE | E3 | IOB13B | I/O | 2 |  | Comp_of_IOB13A | TRUE | NONE
E4 | VCCO5 | Power |  | N/A |  |  |  | E4 | VCCO2 | Power | N/A
E5 | VSS | Ground |  | N/A |  |  |  | E5 | VSS | Ground | N/A
E6 | IOL53A | I/O | DQ3 | 6 |  | True_of_IOL53B | TRUE | E6 | IOL25A | I/O | 3 |  | True_of_IOL25B | NONE | NONE
E7 | IOB3B | I/O | DQ4 | 5 |  | Comp_of_IOB3A | NONE | E7 | IOB5B | I/O | 2 |  | Comp_of_IOB5A | NONE | NONE
E8 | IOL45B/LPLL2_C_in | I/O | DQ2 | 6 | LPLL2_C_in | Comp_of_IOL45A | NONE | E8 | IOL23B | I/O | 3 |  | Comp_of_IOL23A | NONE | NONE
E9 | IOL38B | I/O | DQ2 | 6 |  | Comp_of_IOL38A | TRUE | E9 | IOL21B | I/O | 3 |  | Comp_of_IOL21A | NONE | NONE
F1 | IOB19B | I/O | DQ5 | 5 |  | Comp_of_IOB19A | NONE | F1 | IOB16B | I/O | 2 |  | Comp_of_IOB16A | NONE | NONE
F10 | IOL11A | I/O | DQ1 | 7 |  | True_of_IOL11B | TRUE | F10 | IOL3A | I/O | 3 |  | True_of_IOL3B | NONE | NONE
F11 | VSS | Ground |  | N/A |  |  |  | F11 | VSS | Ground | N/A
F12 | IOT12A | I/O | DQ14 | 0 |  | True_of_IOT12B | TRUE | F12 | IOT16A | I/O | 0 |  | True_of_IOT16B | NONE | NONE
F13 | IOT8A | I/O | DQ15 | 0 |  | True_of_IOT8B | TRUE | F13 | IOT15A | I/O | 0 |  | True_of_IOT15B | NONE | x16
F14 | IOT9A | I/O | DQS15 | 0 |  | True_of_IOT9B | NONE | F14 | IOT14A | I/O | 0 |  | True_of_IOT14B | NONE | NONE
F15 | IOT6B | I/O | DQ15 | 0 |  | Comp_of_IOT6A | TRUE | F15 | IOT13B | I/O | 0 |  | Comp_of_IOT13A | NONE | NONE
F16 | IOT9B | I/O | DQS15 | 0 |  | Comp_of_IOT9A | NONE | F16 | IOT14B | I/O | 0 |  | Comp_of_IOT14A | NONE | NONE
F2 | IOB16B | I/O | DQ5 | 5 |  | Comp_of_IOB16A | TRUE | F2 | IOB14B | I/O | 2 |  | Comp_of_IOB14A | NONE | NONE
F3 | IOB19A | I/O | DQ5 | 5 |  | True_of_IOB19B | NONE | F3 | IOB16A | I/O | 2 |  | True_of_IOB16B | NONE | NONE
F4 | IOB18A | I/O | DQ5 | 5 |  | True_of_IOB18B | TRUE | F4 | IOB15A | I/O | 2 |  | True_of_IOB15B | TRUE | x16
F5 | IOB22A | I/O | DQ5 | 5 |  | True_of_IOB22B | TRUE | F5 | IOB23A | I/O | 2 |  | True_of_IOB23B | TRUE | x16
F6 | VSS | Ground |  | N/A |  |  |  | F6 | VSS | Ground | N/A
F7 | IOL45A/LPLL2_T_in | I/O | DQ2 | 6 | LPLL2_T_in | True_of_IOL45B | NONE | F7 | IOL23A | I/O | 3 |  | True_of_IOL23B | NONE | NONE
F8 | IOL35A | I/O | DQ2 | 6 |  | True_of_IOL35B | TRUE | F8 | IOL20A | I/O | 3 |  | True_of_IOL20B | TRUE | NONE
F9 | IOL31A | I/O | DQ2 | 6 |  | True_of_IOL31B | TRUE | F9 | IOL16A | I/O | 3 |  | True_of_IOL16B | NONE | NONE
G1 | IOB24A | I/O | DQ5 | 5 |  | True_of_IOB24B | TRUE | G1 | IOB26A | I/O | 2 |  | True_of_IOB26B | NONE | NONE
G10 | VCCPLLL | Power |  | N/A |  |  |  | G10 | VCC | Power | N/A
G11 | IOT14A | I/O | DQ14 | 0 |  | True_of_IOT14B | TRUE | G11 | IOT19A | I/O | 0 |  | True_of_IOT19B | NONE | NONE
G12 | IOT8B | I/O | DQ15 | 0 |  | Comp_of_IOT8A | TRUE | G12 | IOT15B | I/O | 0 |  | Comp_of_IOT15A | NONE | NONE
G13 | IOT12B | I/O | DQ14 | 0 |  | Comp_of_IOT12A | TRUE | G13 | IOT16B | I/O | 0 |  | Comp_of_IOT16A | NONE | NONE
G14 | IOT13B | I/O | DQ14 | 0 |  | Comp_of_IOT13A | NONE | G14 | IOT17B | I/O | 0 |  | Comp_of_IOT17A | NONE | NONE
G15 | IOT13A | I/O | DQ14 | 0 |  | True_of_IOT13B | NONE | G15 | IOT17A | I/O | 0 |  | True_of_IOT17B | NONE | x16
G16 | IOT16A | I/O | DQ14 | 0 |  | True_of_IOT16B | TRUE | G16 | IOT20A | I/O | 0 |  | True_of_IOT20B | NONE | NONE
G2 | IOB21A | I/O | DQS5 | 5 |  | True_of_IOB21B | NONE | G2 | IOB22A | I/O | 2 |  | True_of_IOB22B | NONE | NONE
G3 | IOB21B | I/O | DQS5 | 5 |  | Comp_of_IOB21A | NONE | G3 | IOB22B | I/O | 2 |  | Comp_of_IOB22A | NONE | NONE
G4 | IOB20B | I/O | DQ5 | 5 |  | Comp_of_IOB20A | TRUE | G4 | IOB17B | I/O | 2 |  | Comp_of_IOB17A | TRUE | NONE
G5 | IOB20A | I/O | DQ5 | 5 |  | True_of_IOB20B | TRUE | G5 | IOB17A | I/O | 2 |  | True_of_IOB17B | TRUE | x16
G6 | IOB18B | I/O | DQ5 | 5 |  | Comp_of_IOB18A | TRUE | G6 | IOB15B | I/O | 2 |  | Comp_of_IOB15A | TRUE | NONE
G7 | VCC | Power |  | N/A |  |  |  | G7 | VCC | Power | N/A
G8 | VCCX | Power |  | N/A |  |  |  | G8 | VCCX | Power | N/A
G9 | VCCO7 | Power |  | N/A |  |  |  | G9 | VCCO3 | Power | N/A
H1 | IOB32B | I/O | DQ6 | 4 |  | Comp_of_IOB32A | TRUE | H1 | IOB30B | I/O | 2 |  | Comp_of_IOB30A | NONE | NONE
H10 | VCCO0 | Power |  | N/A |  |  |  | H10 | VCCO0 | Power | N/A
H11 | IOT27A/GCLKT_0 | I/O | DQ14 | 0 | GCLKT_0 | True_of_IOT27B | NONE | H11 | IOT28A/GCLKT_0 | I/O | 0 | GCLKT_0 | True_of_IOT28B | NONE | NONE
H12 | IOT14B | I/O | DQ14 | 0 |  | Comp_of_IOT14A | TRUE | H12 | IOT19B | I/O | 0 |  | Comp_of_IOT19A | NONE | NONE
H13 | IOT18A | I/O | DQ14 | 0 |  | True_of_IOT18B | TRUE | H13 | IOT22A | I/O | 0 |  | True_of_IOT22B | NONE | NONE
H14 | IOT20A | I/O | DQ14 | 0 |  | True_of_IOT20B | TRUE | H14 | IOT23A | I/O | 0 |  | True_of_IOT23B | NONE | x16
H15 | IOT16B | I/O | DQ14 | 0 |  | Comp_of_IOT16A | TRUE | H15 | IOT20B | I/O | 0 |  | Comp_of_IOT20A | NONE | NONE
H16 | IOT20B | I/O | DQ14 | 0 |  | Comp_of_IOT20A | TRUE | H16 | IOT23B | I/O | 0 |  | Comp_of_IOT23A | NONE | NONE
H2 | IOB24B | I/O | DQ5 | 5 |  | Comp_of_IOB24A | TRUE | H2 | IOB26B | I/O | 2 |  | Comp_of_IOB26A | NONE | NONE
H3 | IOB32A | I/O | DQ6 | 4 |  | True_of_IOB32B | TRUE | H3 | IOB30A | I/O | 2 |  | True_of_IOB30B | NONE | NONE
H4 | IOB26A | I/O | DQ5 | 5 |  | True_of_IOB26B | TRUE | H4 | IOB27A | I/O | 2 |  | True_of_IOB27B | TRUE | x16
H5 | IOB35A | I/O | DQ6 | 4 |  | True_of_IOB35B | NONE | H5 | IOB32A | I/O | 2 |  | True_of_IOB32B | NONE | NONE
H6 | IOB22B | I/O | DQ5 | 5 |  | Comp_of_IOB22A | TRUE | H6 | IOB23B | I/O | 2 |  | Comp_of_IOB23A | TRUE | NONE
H7 | VCCO5 | Power |  | N/A |  |  |  | H7 | VCCO2 | Power | N/A
H8 | VSS | Ground |  | N/A |  |  |  | H8 | VSS | Ground | N/A
H9 | VSS | Ground |  | N/A |  |  |  | H9 | VSS | Ground | N/A
J1 | IOB27A/GCLKT_5 | I/O | DQ5 | 5 | GCLKT_5 | True_of_IOB27B | NONE | J1 | IOB28A/GCLKT_5 | I/O | 2 | GCLKT_5 | True_of_IOB28B | NONE | NONE
J10 | VCCO1 | Power |  | N/A |  |  |  | J10 | VCCO0 | Power | N/A
J11 | IOT32A | I/O | DQ13 | 1 |  | True_of_IOT32B | TRUE | J11 | IOT30A | I/O | 0 |  | True_of_IOT30B | NONE | NONE
J12 | IOT18B | I/O | DQ14 | 0 |  | Comp_of_IOT18A | TRUE | J12 | IOT22B | I/O | 0 |  | Comp_of_IOT22A | NONE | NONE
J13 | IOT27B/GCLKC_0 | I/O | DQ14 | 0 | GCLKC_0 | Comp_of_IOT27A | NONE | J13 | IOT28B/GCLKC_0 | I/O | 0 | GCLKC_0 | Comp_of_IOT28A | NONE | NONE
J14 | IOT22B | I/O | DQ14 | 0 |  | Comp_of_IOT22A | TRUE | J14 | IOT25B | I/O | 0 |  | Comp_of_IOT25A | NONE | NONE
J15 | IOT24A | I/O | DQ14 | 0 |  | True_of_IOT24B | TRUE | J15 | IOT27A | I/O | 0 |  | True_of_IOT27B | NONE | x16
J16 | IOT22A | I/O | DQ14 | 0 |  | True_of_IOT22B | TRUE | J16 | IOT25A | I/O | 0 |  | True_of_IOT25B | NONE | x16
J2 | IOB34A | I/O | DQ6 | 4 |  | True_of_IOB34B | TRUE | J2 | IOB31A | I/O | 2 |  | True_of_IOB31B | TRUE | x16
J3 | IOB27B/GCLKC_5 | I/O | DQ5 | 5 | GCLKC_5 | Comp_of_IOB27A | NONE | J3 | IOB28B/GCLKC_5 | I/O | 2 | GCLKC_5 | Comp_of_IOB28A | NONE | NONE
J4 | IOB35B | I/O | DQ6 | 4 |  | Comp_of_IOB35A | NONE | J4 | IOB32B | I/O | 2 |  | Comp_of_IOB32A | NONE | NONE
J5 | IOB37A | I/O | DQS6 | 4 |  | True_of_IOB37B | NONE | J5 | IOB34A | I/O | 2 |  | True_of_IOB34B | NONE | NONE
J6 | IOB26B | I/O | DQ5 | 5 |  | Comp_of_IOB26A | TRUE | J6 | IOB27B | I/O | 2 |  | Comp_of_IOB27A | TRUE | NONE
J7 | VCCO4 | Power |  | N/A |  |  |  | J7 | VCCO2 | Power | N/A
J8 | VSS | Ground |  | N/A |  |  |  | J8 | VSS | Ground | N/A
J9 | VSS | Ground |  | N/A |  |  |  | J9 | VSS | Ground | N/A
K1 | IOB34B | I/O | DQ6 | 4 |  | Comp_of_IOB34A | TRUE | K1 | IOB31B | I/O | 2 |  | Comp_of_IOB31A | TRUE | NONE
K10 | VCC | Power |  | N/A |  |  |  | K10 | VCC | Power | N/A
K11 | IOT38A | I/O | DQ13 | 1 |  | True_of_IOT38B | TRUE | K11 | IOT36A | I/O | 1 |  | True_of_IOT36B | NONE | NONE
K12 | IOT36B | I/O | DQ13 | 1 |  | Comp_of_IOT36A | TRUE | K12 | IOT34B | I/O | 0 |  | Comp_of_IOT34A | NONE | NONE
K13 | IOT36A | I/O | DQ13 | 1 |  | True_of_IOT36B | TRUE | K13 | IOT34A | I/O | 0 |  | True_of_IOT34B | NONE | NONE
K14 | IOT30A/GCLKT_1 | I/O | DQ13 | 1 | GCLKT_1 | True_of_IOT30B | TRUE | K14 | IOT29A/GCLKT_1 | I/O | 0 | GCLKT_1 | True_of_IOT29B | NONE | x16
K15 | IOT30B/GCLKC_1 | I/O | DQ13 | 1 | GCLKC_1 | Comp_of_IOT30A | TRUE | K15 | IOT29B/GCLKC_1 | I/O | 0 | GCLKC_1 | Comp_of_IOT29A | NONE | NONE
K16 | IOT24B | I/O | DQ14 | 0 |  | Comp_of_IOT24A | TRUE | K16 | IOT27B | I/O | 0 |  | Comp_of_IOT27A | NONE | NONE
K2 | IOB36B | I/O | DQ6 | 4 |  | Comp_of_IOB36A | TRUE | K2 | IOB33B | I/O | 2 |  | Comp_of_IOB33A | TRUE | NONE
K3 | IOB36A | I/O | DQ6 | 4 |  | True_of_IOB36B | TRUE | K3 | IOB33A | I/O | 2 |  | True_of_IOB33B | TRUE | x16
K4 | IOB39A | I/O | DQ6 | 4 |  | True_of_IOB39B | NONE | K4 | IOB36A | I/O | 2 |  | True_of_IOB36B | NONE | NONE
K5 | IOB40A | I/O | DQ6 | 4 |  | True_of_IOB40B | TRUE | K5 | IOB37A | I/O | 2 |  | True_of_IOB37B | NONE | NONE
K6 | IOB37B | I/O | DQS6 | 4 |  | Comp_of_IOB37A | NONE | K6 | IOB34B | I/O | 2 |  | Comp_of_IOB34A | NONE | NONE
K7 | VCCPLLR | Power |  | N/A |  |  |  | K7 | VCC | Power | N/A
K8 | VCCO3 | Power |  | N/A |  |  |  | K8 | VCCO1 | Power | N/A
K9 | VCCX | Power |  | N/A |  |  |  | K9 | VCCX | Power | N/A
L1 | IOB38A | I/O | DQ6 | 4 |  | True_of_IOB38B | TRUE | L1 | IOB35A | I/O | 2 |  | True_of_IOB35B | TRUE | x16
L10 | IOR34B/MCLK/D4 | I/O | DQ9 | 3 | MCLK/D4 | Comp_of_IOR34A | NONE | L10 | IOR12B/MCLK/D4 | I/O | 1 | MCLK/D4 | Comp_of_IOR12A | NONE | NONE
L11 | VSS | Ground |  | N/A |  |  |  | L11 | VSS | Ground | N/A
L12 | IOT32B | I/O | DQ13 | 1 |  | Comp_of_IOT32A | TRUE | L12 | IOT30B | I/O | 0 |  | Comp_of_IOT30A | NONE | NONE
L13 | IOT38B | I/O | DQ13 | 1 |  | Comp_of_IOT38A | TRUE | L13 | IOT36B | I/O | 1 |  | Comp_of_IOT36A | NONE | NONE
L14 | IOT34B | I/O | DQ13 | 1 |  | Comp_of_IOT34A | TRUE | L14 | IOT32B | I/O | 0 |  | Comp_of_IOT32A | NONE | NONE
L15 | IOT2A | I/O | DQ15 | 0 |  | True_of_IOT2B | TRUE | L15 | IOT2A | I/O | 3 |  | True_of_IOT2B | NONE | x16
L16 | IOT34A | I/O | DQ13 | 1 |  | True_of_IOT34B | TRUE | L16 | IOT32A | I/O | 0 |  | True_of_IOT32B | NONE | NONE
L2 | IOB30A/GCLKT_4 | I/O | DQ6 | 4 | GCLKT_4 | True_of_IOB30B | TRUE | L2 | IOB29A/GCLKT_4 | I/O | 2 | GCLKT_4 | True_of_IOB29B | TRUE | x16
L3 | IOB38B | I/O | DQ6 | 4 |  | Comp_of_IOB38A | TRUE | L3 | IOB35B | I/O | 2 |  | Comp_of_IOB35A | TRUE | NONE
L4 | IOB40B | I/O | DQ6 | 4 |  | Comp_of_IOB40A | TRUE | L4 | IOB37B | I/O | 2 |  | Comp_of_IOB37A | NONE | NONE
L5 | IOB39B | I/O | DQ6 | 4 |  | Comp_of_IOB39A | NONE | L5 | IOB36B | I/O | 2 |  | Comp_of_IOB36A | NONE | NONE
L6 | VSS | Ground |  | N/A |  |  |  | L6 | VSS | Ground | N/A
L7 | EXTR | Ground |  | N/A |  |  |  | L7 | IOR24B | I/O | 1 |  | Comp_of_IOR24A | TRUE | NONE
L8 | IOR44B | I/O | DQ9 | 3 |  | Comp_of_IOR44A | TRUE | L8 | IOR21B | I/O | 1 |  | Comp_of_IOR21A | NONE | NONE
L9 | IOR40B | I/O | DQ9 | 3 |  | Comp_of_IOR40A | TRUE | L9 | IOR18B | I/O | 1 |  | Comp_of_IOR18A | NONE | NONE
M1 | IOB30B/GCLKC_4 | I/O | DQ6 | 4 | GCLKC_4 | Comp_of_IOB30A | TRUE | M1 | IOB29B/GCLKC_4 | I/O | 2 | GCLKC_4 | Comp_of_IOB29A | TRUE | NONE
M10 | IOR22A | I/O | DQS10 | 2 |  | True_of_IOR22B | TRUE | M10 | IOR7A | I/O | 1 |  | True_of_IOR7B | NONE | NONE
M11 | IOR27B/GCLKC_2 | I/O | DQ10 | 2 | GCLKC_2 | Comp_of_IOR27A | NONE | M11 | IOR9B/GCLKC_2 | I/O | 1 | GCLKC_2 | Comp_of_IOR9A | NONE | NONE
M12 | VSS | Ground |  | N/A |  |  |  | M12 | VSS | Ground | N/A
M13 | VCCO1 | Power |  | N/A |  |  |  | M13 | VCCO0 | Power | N/A
M14 | IOT40A | I/O | DQ13 | 1 |  | True_of_IOT40B | TRUE | M14 | IOT37A | I/O | 1 |  | True_of_IOT37B | NONE | NONE
M15 | IOT40B | I/O | DQ13 | 1 |  | Comp_of_IOT40A | TRUE | M15 | IOT37B | I/O | 1 |  | Comp_of_IOT37A | NONE | NONE
M16 | IOR30A/MODE0 | I/O | DQ9 | 3 | MODE0 | True_of_IOR30B | NONE | M16 | IOT5A/MODE0 | I/O | 3 | MODE0 | True_of_IOT5B | NONE | NONE
M2 | IOB43A | I/O | DQ6 | 4 |  | True_of_IOB43B | NONE | M2 | IOB40A | I/O | 2 |  | True_of_IOB40B | NONE | NONE
M3 | IOB42A | I/O | DQ6 | 4 |  | True_of_IOB42B | TRUE | M3 | IOB39A | I/O | 2 |  | True_of_IOB39B | TRUE | x16
M4 | VCCO4 | Power |  | N/A |  |  |  | M4 | VCCO2 | Power | N/A
M5 | VSS | Ground |  | N/A |  |  |  | M5 | VSS | Ground | N/A
M6 | IOR44A | I/O | DQ9 | 3 |  | True_of_IOR44B | TRUE | M6 | IOR21A | I/O | 1 |  | True_of_IOR21B | NONE | NONE
M7 | IOR47A/RPLL2_T_fb | I/O | DQ8 | 3 | RPLL2_T_fb | True_of_IOR47B | TRUE | M7 | IOR22A | I/O | 1 |  | True_of_IOR22B | TRUE | NONE
M8 | IOR36A/SO/D1 | I/O | DQS9 | 3 | SO/D1 | True_of_IOR36B | NONE | M8 | IOR14A/SO/D1 | I/O | 1 | SO/D1 | True_of_IOR14B | NONE | NONE
M9 | IOR34A/MCS_N/D5 | I/O | DQ9 | 3 | MCS_N/D5 | True_of_IOR34B | NONE | M9 | IOR12A/MCS_N/D5 | I/O | 1 | MCS_N/D5 | True_of_IOR12B | NONE | NONE
N1 | IOB42B | I/O | DQ6 | 4 |  | Comp_of_IOB42A | TRUE | N1 | IOB39B | I/O | 2 |  | Comp_of_IOB39A | TRUE | NONE
N10 | IOR27A/GCLKT_2 | I/O | DQ10 | 2 | GCLKT_2 | True_of_IOR27B | NONE | N10 | IOR9A/GCLKT_2 | I/O | 1 | GCLKT_2 | True_of_IOR9B | NONE | NONE
N11 | IOR22B | I/O | DQS10 | 2 |  | Comp_of_IOR22A | TRUE | N11 | IOR7B | I/O | 1 |  | Comp_of_IOR7A | NONE | NONE
N12 | VCCO2 | Power |  | N/A |  |  |  | N12 | VCCO1 | Power | N/A
N13 | VSS | Ground |  | N/A |  |  |  | N13 | VSS | Ground | N/A
N14 | IOT52B | I/O | DQ12 | 1 |  | Comp_of_IOT52A | TRUE | N14 | IOT41B | I/O | 1 |  | Comp_of_IOT41A | NONE | NONE
N15 | IOT48A | I/O | DQS12 | 1 |  | True_of_IOT48B | TRUE | N15 | IOT39A | I/O | 1 |  | True_of_IOT39B | NONE | x16
N16 | IOT52A | I/O | DQ12 | 1 |  | True_of_IOT52B | TRUE | N16 | IOT41A | I/O | 1 |  | True_of_IOT41B | NONE | x16
N2 | IOB41A | I/O | DQ6 | 4 |  | True_of_IOB41B | NONE | N2 | IOB38A | I/O | 2 |  | True_of_IOB38B | NONE | NONE
N3 | IOB43B | I/O | DQ6 | 4 |  | Comp_of_IOB43A | NONE | N3 | IOB40B | I/O | 2 |  | Comp_of_IOB40A | NONE | NONE
N4 | VSS | Ground |  | N/A |  |  |  | N4 | VSS | Ground | N/A
N5 | VCCO3 | Power |  | N/A |  |  |  | N5 | VCCO1 | Power | N/A
N6 | IOR51A | I/O | DQ8 | 3 |  | True_of_IOR51B | TRUE | N6 | IOR24A | I/O | 1 |  | True_of_IOR24B | TRUE | NONE
N7 | IOR47B/RPLL2_C_fb | I/O | DQ8 | 3 | RPLL2_C_fb | Comp_of_IOR47A | TRUE | N7 | IOR22B | I/O | 1 |  | Comp_of_IOR22A | TRUE | NONE
N8 | IOR40A | I/O | DQ9 | 3 |  | True_of_IOR40B | TRUE | N8 | IOR18A | I/O | 1 |  | True_of_IOR18B | NONE | NONE
N9 | IOR36B/SSPI_CS_N/D0 | I/O | DQS9 | 3 | SSPI_CS_N/D0 | Comp_of_IOR36A | NONE | N9 | IOR14B/SSPI_CS_N/D0 | I/O | 1 | SSPI_CS_N/D0 | Comp_of_IOR14A | NONE | NONE
P1 | IOB41B | I/O | DQ6 | 4 |  | Comp_of_IOB41A | NONE | P1 | IOB38B | I/O | 2 |  | Comp_of_IOB38A | NONE | NONE
P10 | IOR33A/MI/D7 | I/O | DQ9 | 3 | MI/D7 | True_of_IOR33B | TRUE | P10 | IOR11A/MI/D7 | I/O | 1 | MI/D7 | True_of_IOR11B | TRUE | NONE
P11 | IOR24B | I/O | DQ10 | 2 |  | Comp_of_IOR24A | TRUE | P11 | IOR8B | I/O | 1 |  | Comp_of_IOR8A | TRUE | NONE
P12 | IOR8A/RPLL1_T_fb | I/O | DQ11 | 2 | RPLL1_T_fb | True_of_IOR8B | TRUE | P12 | IOR6A/RPLL_T_fb | I/O | 1 | RPLL_T_fb | True_of_IOR6B | TRUE | NONE
P13 | IOR11B | I/O | DQ10 | 2 |  | Comp_of_IOR11A | TRUE | P13 | IOT46B | I/O | 1 |  | Comp_of_IOT46A | NONE | NONE
P14 | VSS | Ground |  | N/A |  |  |  | P14 | VSS | Ground | N/A
P15 | IOT54A | I/O | DQ12 | 1 |  | True_of_IOT54B | TRUE | P15 | IOT42A | I/O | 1 |  | True_of_IOT42B | NONE | NONE
P16 | IOT48B | I/O | DQS12 | 1 |  | Comp_of_IOT48A | TRUE | P16 | IOT39B | I/O | 1 |  | Comp_of_IOT39A | NONE | NONE
P2 | IOB44B | I/O | DQ6 | 4 |  | Comp_of_IOB44A | TRUE | P2 | IOB41B | I/O | 2 |  | Comp_of_IOB41A | TRUE | NONE
P3 | VSS | Ground |  | N/A |  |  |  | P3 | VSS | Ground | N/A
P4 | IOB45A | I/O | DQ6 | 4 |  | True_of_IOB45B | NONE | P4 | IOB42B | I/O | 2 |  | Comp_of_IOB42A | NONE | NONE
P5 | IOB50A | I/O | DQ7 | 4 |  | True_of_IOB50B | TRUE | P5 | IOB44B | I/O | 2 |  | Comp_of_IOB44A | NONE | NONE
P6 | IOR53A | I/O | DQ8 | 3 |  | True_of_IOR53B | TRUE | P6 | IOR25A | I/O | 1 |  | True_of_IOR25B | NONE | NONE
P7 | IOR49B | I/O | DQ8 | 3 |  | Comp_of_IOR49A | TRUE | P7 | IOR23B | I/O | 1 |  | Comp_of_IOR23A | NONE | NONE
P8 | IOR42A | I/O | DQ9 | 3 |  | True_of_IOR42B | TRUE | P8 | IOR20A | I/O | 1 |  | True_of_IOR20B | TRUE | NONE
P9 | IOR38B/DOUT/WE_N | I/O | DQ9 | 3 | DOUT/WE_N | Comp_of_IOR38A | TRUE | P9 | IOR15B/DOUT/WE_N | I/O | 1 | DOUT/WE_N | Comp_of_IOR15A | TRUE | NONE
R1 | IOB44A | I/O | DQ6 | 4 |  | True_of_IOB44B | TRUE | R1 | IOB41A | I/O | 2 |  | True_of_IOB41B | TRUE | x16
R10 | IOR33B/MO/D6 | I/O | DQ9 | 3 | MO/D6 | Comp_of_IOR33A | TRUE | R10 | IOR11B/MO/D6 | I/O | 1 | MO/D6 | Comp_of_IOR11A | TRUE | NONE
R11 | IOR17A | I/O | DQ10 | 2 |  | True_of_IOR17B | TRUE | R11 | IOR3A | I/O | 1 |  | True_of_IOR3B | NONE | NONE
R12 | IOR11A | I/O | DQ10 | 2 |  | True_of_IOR11B | TRUE | R12 | IOT46A | I/O | 1 |  | True_of_IOT46B | NONE | NONE
R13 | IOR20A | I/O | DQ10 | 2 |  | True_of_IOR20B | TRUE | R13 | IOR4A | I/O | 1 |  | True_of_IOR4B | TRUE | NONE
R14 | IOR7B/RPLL1_C_in | I/O | DQ11 | 2 | RPLL1_C_in | Comp_of_IOR7A | NONE | R14 | IOR5B/RPLL_C_in | I/O | 1 | RPLL_C_in | Comp_of_IOR5A | NONE | NONE
R15 | VSS | Ground |  | N/A |  |  |  | R15 | VSS | Ground | N/A
R16 | IOT54B | I/O | DQ12 | 1 |  | Comp_of_IOT54A | TRUE | R16 | IOT42B | I/O | 1 |  | Comp_of_IOT42A | NONE | NONE
R2 | VSS | Ground |  | N/A |  |  |  | R2 | VSS | Ground | N/A
R3 | IOB48A | I/O | DQS7 | 4 |  | True_of_IOB48B | TRUE | R3 | IOB43B | I/O | 2 |  | Comp_of_IOB43A | TRUE | NONE
R4 | IOB52A | I/O | DQ7 | 4 |  | True_of_IOB52B | TRUE | R4 | IOB45B | I/O | 2 |  | Comp_of_IOB45A | TRUE | NONE
R5 | IOB50B | I/O | DQ7 | 4 |  | Comp_of_IOB50A | TRUE | R5 | IOB44A | I/O | 2 |  | True_of_IOB44B | NONE | NONE
R6 | IOB54A | I/O | DQ7 | 4 |  | True_of_IOB54B | TRUE | R6 | IOR27B | I/O | 1 |  | Comp_of_IOR27A | NONE | NONE
R7 | IOR49A | I/O | DQ8 | 3 |  | True_of_IOR49B | TRUE | R7 | IOR23A | I/O | 1 |  | True_of_IOR23B | NONE | NONE
R8 | IOR29B/GCLKC_3 | I/O | DQ9 | 3 | GCLKC_3 | Comp_of_IOR29A | TRUE | R8 | IOR17B/GCLKC_3 | I/O | 1 | GCLKC_3 | Comp_of_IOR17A | TRUE | NONE
R9 | IOR35A/FASTRD_N/D3 | I/O | DQ9 | 3 | FASTRD_N/D3 | True_of_IOR35B | TRUE | R9 | IOR13A/FASTRD_N/D3 | I/O | 1 | FASTRD_N/D3 | True_of_IOR13B | TRUE | NONE
T1 | VCC | Power |  | N/A |  |  |  | T1 | VCC | Power | N/A
T10 | IOR35B/SI/D2 | I/O | DQ9 | 3 | SI/D2 | Comp_of_IOR35A | TRUE | T10 | IOR13B/SI/D2 | I/O | 1 | SI/D2 | Comp_of_IOR13A | TRUE | NONE
T11 | IOR24A | I/O | DQ10 | 2 |  | True_of_IOR24B | TRUE | T11 | IOR8A | I/O | 1 |  | True_of_IOR8B | TRUE | NONE
T12 | IOR17B | I/O | DQ10 | 2 |  | Comp_of_IOR17A | TRUE | T12 | IOR3B | I/O | 1 |  | Comp_of_IOR3A | NONE | NONE
T13 | IOR8B/RPLL1_C_fb | I/O | DQ11 | 2 | RPLL1_C_fb | Comp_of_IOR8A | TRUE | T13 | IOR6B/RPLL_C_fb | I/O | 1 | RPLL_C_fb | Comp_of_IOR6A | TRUE | NONE
T14 | IOR20B | I/O | DQ10 | 2 |  | Comp_of_IOR20A | TRUE | T14 | IOR4B | I/O | 1 |  | Comp_of_IOR4A | TRUE | NONE
T15 | IOR7A/RPLL1_T_in | I/O | DQ11 | 2 | RPLL1_T_in | True_of_IOR7B | NONE | T15 | IOR5A/RPLL_T_in | I/O | 1 | RPLL_T_in | True_of_IOR5B | NONE | NONE
T16 | VCC | Power |  | N/A |  |  |  | T16 | VCC | Power | N/A
T2 | IOB48B | I/O | DQS7 | 4 |  | Comp_of_IOB48A | TRUE | T2 | IOB43A | I/O | 2 |  | True_of_IOB43B | TRUE | x16
T3 | IOB52B | I/O | DQ7 | 4 |  | Comp_of_IOB52A | TRUE | T3 | IOB45A | I/O | 2 |  | True_of_IOB45B | TRUE | x16
T4 | IOB45B | I/O | DQ6 | 4 |  | Comp_of_IOB45A | NONE | T4 | IOB42A | I/O | 2 |  | True_of_IOB42B | NONE | NONE
T5 | IOB54B | I/O | DQ7 | 4 |  | Comp_of_IOB54A | TRUE | T5 | IOR27A | I/O | 1 |  | True_of_IOR27B | NONE | NONE
T6 | IOR53B | I/O | DQ8 | 3 |  | Comp_of_IOR53A | TRUE | T6 | IOR25B | I/O | 1 |  | Comp_of_IOR25A | NONE | NONE
T7 | IOR29A/GCLKT_3 | I/O | DQ9 | 3 | GCLKT_3 | True_of_IOR29B | TRUE | T7 | IOR17A/GCLKT_3 | I/O | 1 | GCLKT_3 | True_of_IOR17B | TRUE | NONE
T8 | IOR42B | I/O | DQ9 | 3 |  | Comp_of_IOR42A | TRUE | T8 | IOR20B | I/O | 1 |  | Comp_of_IOR20A | TRUE | NONE
T9 | IOR38A/DIN/CLKHOLD_N | I/O | DQ9 | 3 | DIN/CLKHOLD_N | True_of_IOR38B | TRUE | T9 | IOR15A/DIN/CLKHOLD_N | I/O | 1 | DIN/CLKHOLD_N | True_of_IOR15B | TRUE | NONE
