andrastantos/unic/devel_gw1/devel_gw1_bom.xlsx

Prj: | UNIC 40 |  |  |  |  |  | Board Qty: | 2
Co.: | Modular Circuits |  |  |  |  |  | Unit Cost: | $32.35
Prj date: | Thu 04 Jan 2024 12:11:40 PM PST |  |  |  |  |  | Total Cost: | $64.70 |  |  |  |  | $58.27 | 26 of 29 parts found |  |  |  |  | $38.96 | 18 of 29 parts found |  |  |  |  | $26.36 | 3 of 29 parts found
$ date: | 2024-01-04 12:13:38
Global Part Info |  |  |  |  |  |  |  |  | Digi-Key |  |  |  |  |  | Mouser |  |  |  |  |  | Local
Refs | Value | Desc | Footprint | Manf | Manf# | Qty | Unit$ | Ext$ | Avail | Purch | Unit$ | MOQ | Ext$ | Cat# | Avail | Purch | Unit$ | MOQ | Ext$ | Cat# | Avail | Purch | Unit$ | MOQ | Ext$ | Cat#
C1-C4,C6,C9-C11,C13-C23 | 2.2u | OK | C_0402_1005Metric_Pad0.74x0.62mm_HandSolder |  | CC0402MRX5R6BB225 | 38 | $0.036 | $1.37 | 120429 | 38 | $0.061 | 1 | $2.32 | 311-1733-1-ND (https://www.digikey.com/en/products/detail/yageo/CC0402MRX5R6BB225/5195142) | 49932 |  | $0.036 | 1 | $1.37 | 603-CC402MRX5R6BB225 (https://www.mouser.com/ProductDetail/YAGEO/CC0402MRX5R6BB225?qs=HEu%2FF%2FCqxzLmtiQC%2Fs%252BBmA%3D%3D)
C5,C12 | 10u | OK | C_0805_2012Metric_Pad1.18x1.45mm_HandSolder |  | CL21A106KAYNNNG | 4 | $0.180 | $0.72 | 434824 | 4 | $0.180 | 1 | $0.72 | 1276-6454-1-ND (https://www.digikey.com/en/products/detail/samsung-electro-mechanics/CL21A106KAYNNNG/3894413) | 285104 |  | $0.180 | 1 | $0.72 | 187-CL21A106KAYNNNG (https://www.mouser.com/ProductDetail/Samsung-Electro-Mechanics/CL21A106KAYNNNG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)
C7,C8 | 22u | OK | C_0805_2012Metric_Pad1.18x1.45mm_HandSolder |  | CL21A226MQQNNNE | 4 | $0.130 | $0.52 | 1122902 | 4 | $0.130 | 1 | $0.52 | 1276-1100-1-ND (https://www.digikey.com/en/products/detail/samsung-electro-mechanics/CL21A226MQQNNNE/3886758) | 26485 |  | $0.130 | 1 | $0.52 | 187-CL21A226MQQNNNE (https://www.mouser.com/ProductDetail/Samsung-Electro-Mechanics/CL21A226MQQNNNE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)
D1,D2,D4,D6,D8,D11,D13,D15,D17,D19,D21,D23,D25,D27,D29,D31,D33,D35,D37,D39,D41,D43,D45,D47,D49,D51,D53,D55,D57,D59,D61,D63,D65,D67,D69,D71,D73,D75,D77,D79 | BAT54 | OK | SOT-23 |  | BAT54-7-F (https://www.diodes.com/assets/Datasheets/BAT54_A_C_S.pdf) | 80 | $0.073 | $5.84 | 222608 | 80 | $0.108 | 1 | $8.64 | BAT54-FDICT-ND (https://www.digikey.com/en/products/detail/diodes-incorporated/BAT54-7-F/717699) | 291880 |  | $0.073 | 1 | $5.84 | 621-BAT54-F (https://www.mouser.com/ProductDetail/Diodes-Incorporated/BAT54-7-F?qs=MTaYh%2FqtpVeQXpTE0N4TXQ%3D%3D)
D3,D5,D7,D9,D10,D12,D14,D16,D18,D20,D22,D24,D26,D28,D30,D32,D34,D36,D38,D40,D42,D44,D46,D48,D50,D52,D54,D56,D58,D60,D62,D64,D66,D68,D70,D72,D74,D76,D78,D80 | BAT54S | OK | SOT-23 |  | BAT54S-7-F (https://www.diodes.com/assets/Datasheets/ds11005.pdf) | 80 | $0.099 | $7.92 | 422480 | 80 | $0.141 | 1 | $11.28 | BAT54S-FDICT-ND (https://www.digikey.com/en/products/detail/diodes-incorporated/BAT54S-7-F/717925) | 1204943 |  | $0.099 | 1 | $7.92 | 621-BAT54S-F (https://www.mouser.com/ProductDetail/Diodes-Incorporated/BAT54S-7-F?qs=SrifhsLOLf4kNGw4QqCzrA%3D%3D)
DISPLAY1 | Housing |  | CFAL12832C-0091B-W_A |  | https://www.crystalfontz.com/products/document/4150/CFAL12832C-0091B-W_Datasheet.pdf | 2 | $6.590 | $13.18 |  | 0 |  |  |  |  |  |  |  |  |  |  | NonStk |  | $6.590 | 1 | $13.18 | #NO_CATALOG0001 (https://www.crystalfontz.com/product/cfal12832c0091bw-small-oled-white-monochrome)
J2 | Conn_01x02 | OK | PinHeader_1x02_P2.54mm_Vertical |  | PRPC002SAAN-RC | 2 | $0.100 | $0.20 | 24412 | 2 | $0.100 | 1 | $0.20 | S1011EC-02-ND (https://www.digikey.com/en/products/detail/sullins-connector-solutions/PRPC002SAAN-RC/2775252)
JP1-JP4 | Jumper_2_Bridged | OK | PinHeader_1x02_P2.54mm_Vertical |  | PRPC002SAAN-RC | 8 | $0.100 | $0.80 | 24412 | 8 | $0.100 | 1 | $0.80 | S1011EC-02-ND (https://www.digikey.com/en/products/detail/sullins-connector-solutions/PRPC002SAAN-RC/2775252)
J_DISPLAY1 | Conn_01x12_MountingPin | OK | CF4212FH0R0-05-NH |  | CF4212FH0R0-05-NH (https://www.cvilux.com/uploads/drawings/101/210/CF4201S.pdf) | 2 | $0.280 | $0.56 | 2728 | 2 | $0.280 | 1 | $0.56 | 2987-CF4212FH0R0-05-NHCT-ND (https://www.digikey.com/en/products/detail/cvilux-usa/CF4212FH0R0-05-NH/15793122)
J_DISPLAY2 | Conn_01x12 | OK | PinHeader_1x12_P2.54mm_Vertical |  | PRPC012SAAN-RC | 2 | $0.290 | $0.58 | 2091 | 2 | $0.290 | 1 | $0.58 | S1011EC-12-ND (https://www.digikey.com/en/products/detail/sullins-connector-solutions/PRPC012SAAN-RC/2775242)
J_DISPLAY3 | Conn_01x12_MountingPin | OK | CF31121D0R0-05-NH |  | CF31121D0R0-05-NH (https://www.cvilux.com/uploads/drawings/101/073/CF3103S.pdf) | 2 | $0.270 | $0.54 | 939 | 2 | $0.270 | 1 | $0.54 | 2987-CF31121D0R0-05-NHCT-ND (https://www.digikey.com/en/products/detail/cvilux-usa/CF31121D0R0-05-NH/15792917)
J_EXT1 | Conn_01x27_MountingPin | OK | Molex_502598-2793_2Rows-23P~0.60mm_Horizontal |  | 502598-2793 | 2 | $2.240 | $4.48 | 35131 | 2 | $2.260 | 1 | $4.52 | WM9774CT-ND (https://www.digikey.com/en/products/detail/molex/5025982793/4141911) | 2549 |  | $2.240 | 1 | $4.48 | 538-502598-2793 (https://www.mouser.com/ProductDetail/Molex/502598-2793?qs=yd8XiKYcH9mkFMks3MrQ0A%3D%3D)
J_EXT2 | Conn_01x27 | OK | PinHeader_2x14_P2.54mm_Vertical |  | PRPC014DAAN-RC | 2 | $0.580 | $1.16 | 938 | 2 | $0.580 | 1 | $1.16 | S2011EC-14-ND (https://www.digikey.com/en/products/detail/sullins-connector-solutions/PRPC014DAAN-RC/2775280)
J_JTAG1 | Conn_02x06_Odd_Even | OK | PinHeader_2x06_P1.27mm_Vertical_SMD |  | 10152265-1121HF | 2 | $0.760 | $1.52 | 13000 | 2 | $0.760 | 1 | $1.52 | 609-10152265-1121HFCT-ND (https://www.digikey.com/en/products/detail/amphenol-cs-fci/10152265-1121HF/21592876) | NonStk |  | MOQ=26000 | 26000 |  | 649-10152265-1121HF (https://www.mouser.com/ProductDetail/Amphenol-FCI/10152265-1121HF?qs=1Kr7Jg1SGW%252BgBc0SJsgwZQ%3D%3D) | NonStk |  | $6.590 | 1 | $13.18 | 10152265-1121HF (https://www.crystalfontz.com/product/cfal12832c0091bw-small-oled-white-monochrome)
L1 | 10uH | OK | L_1008_2520Metric_Pad1.43x2.20mm_HandSolder |  | UHP 252012BF-100M (https://mm.digikey.com/Volume0/opasdata/d220001/medias/docus/4806/UHP%20Series.pdf) | 2 | $0.180 | $0.36 | 3698 | 2 | $0.180 | 1 | $0.36 | 4816-UHP252012BF-100MCT-ND (https://www.digikey.com/en/products/detail/tai-tech-advanced-electronics-co-ltd/UHP-252012BF-100M/17835969)
LED_DONE1 | LED | OK | LED_0402_1005Metric_Pad0.77x0.64mm_HandSolder |  | CS42C-QL4 (https://chromeled.com/pdf/smd/CS42C-QL4.pdf) | 2 | $0.040 | $0.08 | 50000 | 2 | $0.040 | 1 | $0.08 | 2661-CS42C-QL4TR-ND (https://www.digikey.com/en/products/detail/chromeled/CS42C-QL4/12819246)
Q1-Q39,Q41 | 2N7002 | OK | SOT-23 |  | 2N7002NXAKR (https://assets.nexperia.com/documents/data-sheet/2N7002NXAK.pdf) | 80 | $0.108 | $8.64 | 71565 | 80 | $0.138 | 1 | $11.04 | 1727-8643-1-ND (https://www.digikey.com/en/products/detail/nexperia-usa-inc/2N7002NXAKR/10416554) | 1981751 |  | $0.108 | 1 | $8.64 | 771-2N7002NXAKR (https://www.mouser.com/ProductDetail/Nexperia/2N7002NXAKR?qs=%252B6g0mu59x7JoAsZYPFXqhw%3D%3D)
R1 | 220 | OK | R_0402_1005Metric_Pad0.72x0.64mm_HandSolder |  | CR0402-JW-221GLF | 2 | $0.100 | $0.20 | 58482 | 2 | $0.100 | 1 | $0.20 | CR0402-JW-221GLFCT-ND (https://www.digikey.com/en/products/detail/bourns-inc/CR0402-JW-221GLF/3724075) | 43547 |  | $0.100 | 1 | $0.20 | 652-CR0402JW-221GLF (https://www.mouser.com/ProductDetail/Bourns/CR0402-JW-221GLF?qs=K5ddiUFZPT76N0%252BwSTMuPg%3D%3D)
R2 | 1k | OK | R_0402_1005Metric_Pad0.72x0.64mm_HandSolder |  | CR0402-JW-102GLF | 2 | $0.100 | $0.20 | 377620 | 2 | $0.100 | 1 | $0.20 | CR0402-JW-102GLFCT-ND (https://www.digikey.com/en/products/detail/bourns-inc/CR0402-JW-102GLF/3783558) | 137935 |  | $0.100 | 1 | $0.20 | 652-CR0402JW-102GLF (https://www.mouser.com/ProductDetail/Bourns/CR0402-JW-102GLF?qs=K5ddiUFZPT6U8pP11HX1MQ%3D%3D)
R3,R5-R13,R15,R16 | 10k | OK | R_0402_1005Metric_Pad0.72x0.64mm_HandSolder |  | CR0402-FX-1002GLF | 24 | $0.007 | $0.17 | 1619226 | 24 | $0.012 | 1 | $0.29 | CR0402-FX-1002GLFCT-ND (https://www.digikey.com/en/products/detail/bourns-inc/CR0402-FX-1002GLF/3593192) | 200745 |  | $0.007 | 1 | $0.17 | 652-CR0402FX-1002GLF (https://www.mouser.com/ProductDetail/Bourns/CR0402-FX-1002GLF?qs=URDPQ%2Fj0cz0Xgk2sZso66A%3D%3D)
R4,R14 | 4.99k | OK | R_0402_1005Metric_Pad0.72x0.64mm_HandSolder |  | ERJ-2RKF4991X | 4 | $0.100 | $0.40 | 2978941 | 4 | $0.100 | 1 | $0.40 | P4.99KLCT-ND (https://www.digikey.com/en/products/detail/panasonic-electronic-components/ERJ-2RKF4991X/192345) | 745965 |  | $0.100 | 1 | $0.40 | 667-ERJ-2RKF4991X (https://www.mouser.com/ProductDetail/Panasonic/ERJ-2RKF4991X?qs=6%252BUraArZVSDr040UMVCnHQ%3D%3D)
SOCKET1 | Conn_02x20_Odd_Even | OK | PinSocket_2x20_P2.54mm_Horizontal |  | PPPC202LJBN-RC | 2 | $2.550 | $5.10 | 8655 | 2 | $2.550 | 1 | $5.10 | S5573-ND (https://www.digikey.com/en/products/detail/sullins-connector-solutions/PPPC202LJBN-RC/776031)
U1 | GW1N-LV9QN88C6_I5_ |  | Package | Gowin Semiconductor | GW1N-LV9QN88C6/I5/ (https://www.digikey.com/en/models/776031) | 2 |  |  |  | 0 |  |  |  |  | NonStk |  | MOQ=168 | 168 |  | 192-GW1N-LV9QN88C6I5 (https://www.mouser.com/ProductDetail/GOWIN-Semiconductor/GW1N-LV9QN88C6-I5?qs=OlC7AqGiEDnJD9x4EJLEKQ%3D%3D) | NonStk |  | MOQ=100 | 100 |  | GW1N-LV9QN88C6/I5/
U2 | LM3480-3.3 | OK | SOT-23 |  | LM3480IM3X-3.3/NOPB (http://www.ti.com/lit/ds/symlink/lm3480.pdf) | 2 | $1.210 | $2.42 | 5849 | 2 | $1.210 | 1 | $2.42 | LM3480IM3X-3.3/NOPBCT-ND (https://www.digikey.com/en/products/detail/texas-instruments/LM3480IM3X-3-3-NOPB/367043) | 30472 |  | $1.210 | 1 | $2.42 | 926-LM3480IM3X33NOPB (https://www.mouser.com/ProductDetail/Texas-Instruments/LM3480IM3X-3.3-NOPB?qs=X1J7HmVL2ZFPur3vrG7qOw%3D%3D)
U3 | AP2202K-ADJ | OK | SOT-23-5 |  | AP2202K-ADJTRE1 (https://www.diodes.com/assets/Datasheets/AP2204.pdf) | 2 | $0.630 | $1.26 | 3000 | 2 | $0.630 | 1 | $1.26 | 31-AP2202K-ADJTRE1CT-ND (https://www.digikey.com/en/products/detail/diodes-incorporated/AP2202K-ADJTRE1/5305708) | 8981 |  | $0.630 | 1 | $1.26 | 621-AP2202K-ADJTRE1 (https://www.mouser.com/ProductDetail/Diodes-Incorporated/AP2202K-ADJTRE1?qs=M%2FOdCRO8QQ2ktyrXGlOKlQ%3D%3D)
U4 | APS6404L-3SQR-SN |  | SOIC-8_3.9x4.9mm_P1.27mm |  | APS6404L-3SQR-SN (https://www.mouser.com/datasheet/2/1127/APM_PSRAM_QSPI_APS6404L_3SQR_v2_3_PKG-1954826.pdf) | 2 | $1.460 | $2.92 |  | 0 |  |  |  |  | 48339 |  | $1.460 | 1 | $2.92 | 878-APS6404L-3SQR-SN (https://www.mouser.com/ProductDetail/AP-Memory/APS6404L-3SQR-SN?qs=IS%252B4QmGtzzqsn3S5xo%2FEEg%3D%3D)
U6 | AP62150Z6 | OK | SOT-563 |  | AP62150Z6-7 (https://www.diodes.com/assets/Datasheets/AP62150.pdf) | 2 | $0.510 | $1.02 | 2279 | 2 | $0.510 | 1 | $1.02 | 31-AP62150Z6-7CT-ND (https://www.digikey.com/en/products/detail/diodes-incorporated/AP62150Z6-7/13161383) | 34488 |  | $0.510 | 1 | $1.02 | 621-AP62150Z6-7 (https://www.mouser.com/ProductDetail/Diodes-Incorporated/AP62150Z6-7?qs=yqaQSyyJnNiFuYpiXgADRw%3D%3D)
U7 | AT25SF081-SSHB-X | OK | SOIC-8_3.9x4.9mm_P1.27mm |  | AT25SF081B-SSHB-T (https://www.renesas.com/us/en/document/dst/at25sf081b-datasheet) | 2 | $0.440 | $0.88 | 129150 | 2 | $0.440 | 1 | $0.88 | 1265-AT25SF081B-SSHB-TCT-ND (https://www.digikey.com/en/products/detail/renesas-electronics-corporation/AT25SF081B-SSHB-T/12180765) | 14176 |  | $0.440 | 1 | $0.88 | 724-AT25SF081BSSHBT (https://www.mouser.com/ProductDetail/Renesas-Dialog/AT25SF081B-SSHB-T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)
X1 | 27MHz | OK | Oscillator_SMD_Abracon_ASE-4Pin_3.2x2.5mm |  | O 27,0-JO32-B-1V3-1-T1-LF (https://www.jauch.com/downloadfile/5ef1edcfb8e2f73163c8ce8009ef659d1/jo32-1.8-3.3v.pdf) | 2 | $0.830 | $1.66 | 1015 | 2 | $0.830 | 1 | $1.66 | 1908-O270-JO32-B-1V3-1-T1-LFCT-ND (https://www.digikey.com/en/products/detail/jauch-quartz/O-27-0-JO32-B-1V3-1-T1-LF/10416292)
 |  |  |  |  |  |  | Total Purchase: | $58.27 | Buy here (https://www.digikey.com/ordering/shoppingcart) | 26 of 26 parts purchased |  |  | $58.27 |  | Buy here (https://mouser.com/bom/) |  |  |  | $0.00 |  |  |  |  |  | $0.00
KiCost® v1.1.18 |  |  |  |  |  |  | Purchase description: |  |  | 38,311-1733-1-ND,C1-C4;C6;C9-C11;C13-C23 4,1276-6454-1-ND,C5;C12 4,1276-1100-1-ND,C7;C8 80,BAT54-FDICT-ND,D1;D2;D4;D6;D8;D11;D13;D15;D17;D19;D21;D23;D25;D27;D29;D31;D33;D35;D37;D39;D41;D43;D45;D47;D49;D51;D53;D55;D57;D59;D61;D63;D65;D67;D69;D71;D73;D75;D77;D79 80,BAT54S-FDICT-ND,D3;D5;D7;D9;D10;D12;D14;D16;D18;D20;D22;D24;D26;D28;D30;D32;D34;D36;D38;D40;D42;D44;D46;D48;D50;D52;D54;D56;D58;D60;D62;D64;D66;D68;D70;D72;D74;D76;D78;D80 2,S1011EC-02-ND,J2 8,S1011EC-02-ND,JP1-JP4 2,2987-CF4212FH0R0-05-NHCT-ND,J_DISPLAY1 2,S1011EC-12-ND,J_DISPLAY2 2,2987-CF31121D0R0-05-NHCT-ND,J_DISPLAY3 2,WM9774CT-ND,J_EXT1 2,S2011EC-14-ND,J_EXT2 2,609-10152265-1121HFCT-ND,J_JTAG1 2,4816-UHP252012BF-100MCT-ND,L1 2,2661-CS42C-QL4TR-ND,LED_DONE1 80,1727-8643-1-ND,Q1-Q39;Q41 2,CR0402-JW-221GLFCT-ND,R1 2,CR0402-JW-102GLFCT-ND,R2 24,CR0402-FX-1002GLFCT-ND,R3;R5-R13;R15;R16 4,P4.99KLCT-ND,R4;R14 2,S5573-ND,SOCKET1 2,LM3480IM3X-3.3/NOPBCT-ND,U2 2,31-AP2202K-ADJTRE1CT-ND,U3 2,31-AP62150Z6-7CT-ND,U6 2,1265-AT25SF081B-SSHB-TCT-ND,U7 2,1908-O270-JO32-B-1V3-1-T1-LFCT-ND,X1
 |  |  |  |  |  |  |  |  |  | 38,311-1733-1-ND,C1-C4;C6;C9-C11;C13-C23
 |  |  |  |  |  |  |  |  |  | 4,1276-6454-1-ND,C5;C12
 |  |  |  |  |  |  |  |  |  | 4,1276-1100-1-ND,C7;C8
 |  |  |  |  |  |  |  |  |  | 80,BAT54-FDICT-ND,D1;D2;D4;D6;D8;D11;D13;D15;D17;D19;D21;D23;D25;D27;D29;D31;D33;D35;D37;D39;D41;D43;D45;D47;D49;D51;D53;D55;D57;D59;D61;D63;D65;D67;D69;D71;D73;D75;D77;D79
 |  |  |  |  |  |  |  |  |  | 80,BAT54S-FDICT-ND,D3;D5;D7;D9;D10;D12;D14;D16;D18;D20;D22;D24;D26;D28;D30;D32;D34;D36;D38;D40;D42;D44;D46;D48;D50;D52;D54;D56;D58;D60;D62;D64;D66;D68;D70;D72;D74;D76;D78;D80
 |  |  |  |  |  |  |  |  |  | 2,S1011EC-02-ND,J2
 |  |  |  |  |  |  |  |  |  | 8,S1011EC-02-ND,JP1-JP4
 |  |  |  |  |  |  |  |  |  | 2,2987-CF4212FH0R0-05-NHCT-ND,J_DISPLAY1
 |  |  |  |  |  |  |  |  |  | 2,S1011EC-12-ND,J_DISPLAY2
 |  |  |  |  |  |  |  |  |  | 2,2987-CF31121D0R0-05-NHCT-ND,J_DISPLAY3
 |  |  |  |  |  |  |  |  |  | 2,WM9774CT-ND,J_EXT1
 |  |  |  |  |  |  |  |  |  | 2,S2011EC-14-ND,J_EXT2
 |  |  |  |  |  |  |  |  |  | 2,609-10152265-1121HFCT-ND,J_JTAG1
 |  |  |  |  |  |  |  |  |  | 2,4816-UHP252012BF-100MCT-ND,L1
 |  |  |  |  |  |  |  |  |  | 2,2661-CS42C-QL4TR-ND,LED_DONE1
 |  |  |  |  |  |  |  |  |  | 80,1727-8643-1-ND,Q1-Q39;Q41
 |  |  |  |  |  |  |  |  |  | 2,CR0402-JW-221GLFCT-ND,R1
 |  |  |  |  |  |  |  |  |  | 2,CR0402-JW-102GLFCT-ND,R2
 |  |  |  |  |  |  |  |  |  | 24,CR0402-FX-1002GLFCT-ND,R3;R5-R13;R15;R16
 |  |  |  |  |  |  |  |  |  | 4,P4.99KLCT-ND,R4;R14
 |  |  |  |  |  |  |  |  |  | 2,S5573-ND,SOCKET1
 |  |  |  |  |  |  |  |  |  | 2,LM3480IM3X-3.3/NOPBCT-ND,U2
 |  |  |  |  |  |  |  |  |  | 2,31-AP2202K-ADJTRE1CT-ND,U3
 |  |  |  |  |  |  |  |  |  | 2,31-AP62150Z6-7CT-ND,U6
 |  |  |  |  |  |  |  |  |  | 2,1265-AT25SF081B-SSHB-TCT-ND,U7
 |  |  |  |  |  |  |  |  |  | 2,1908-O270-JO32-B-1V3-1-T1-LFCT-ND,X1
