andrastantos/unic/cover/cover.FCStd

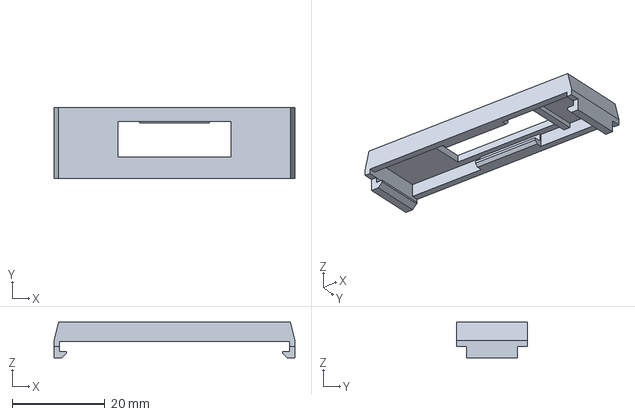
[picture p14: CAD file, 2025-01-09]
cover/cover.FCStd
52.0 x 15.2 x 7.70 mm
