andrastantos/unic/board_gw1/release/unic_gw1-F_Fab.pdf

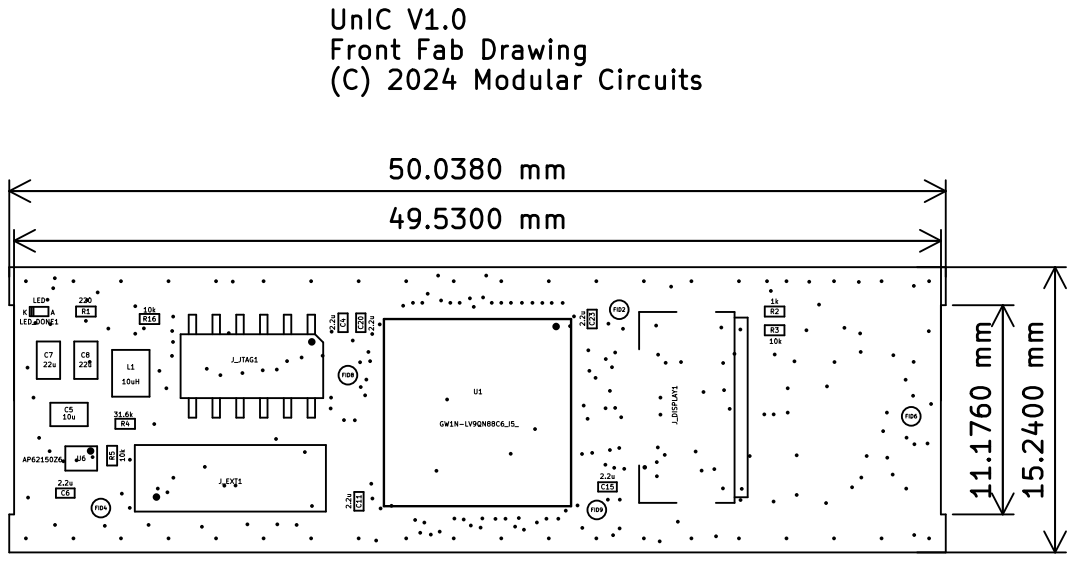
[picture p15: page 1]
