andrastantos/unic/board_gw1/release/unic_gw1_B_Fab.pdf

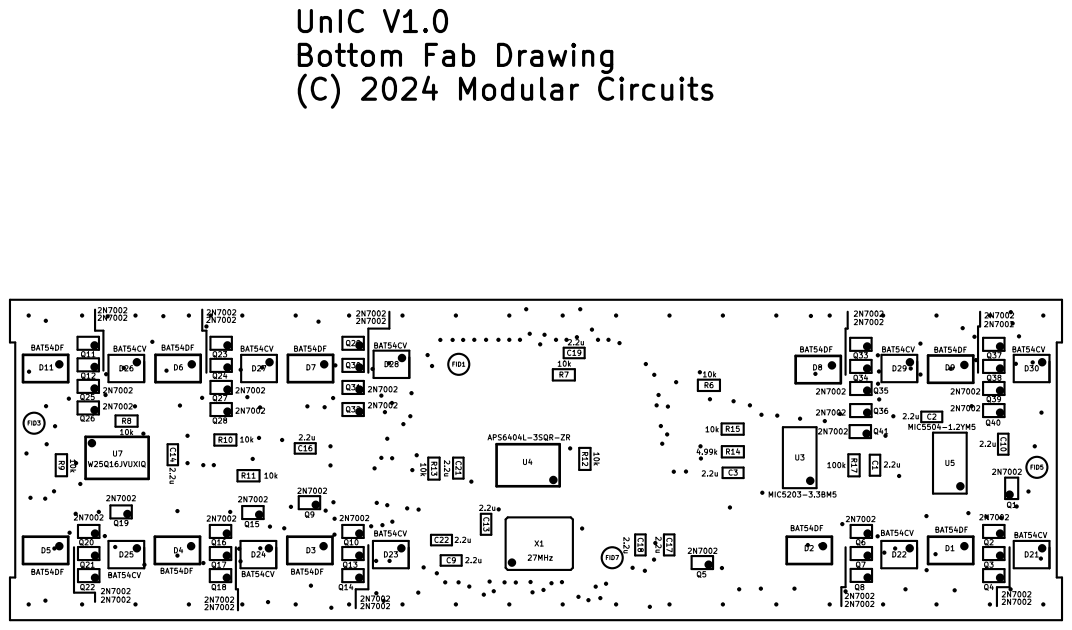
[picture p16: page 1]
