andrastantos/unic/sims/diode-tester.asc

D1: schottky; MBR0520L
I1: current; PULSE(0 0.1 0 1 1 1 4 10)
Named nets: 0
.tran 1
