andrastantos/unic/sims/gnd_bounce.asc

C1: cap; 1n
C2: cap; 100p
C3: cap; 100p
D1: schottky; BAT54
D2: schottky; BAT54
M1: nmos; 2N7002
M2: nmos; 2N7002
M3: nmos; 2N7002
R1: res; 100
R2: res; 0.1
R3: res; 10
R4: res; 0.1
R5: res; 10k
R6: res; 0.1
R7: res; 10k
V1: voltage; PULSE(0 3.3 0 1n 1n 100n 2000n 10)
V2: voltage; 5
Named nets: 0, toggle, open, low, VGND
.tran 10000n
Toggle gate
Open gate
Drive low gate
