andrastantos/unic/sims/bias_circuit.asc

C1: cap; 2.2µ
C2: cap; 2.2µ
C3: cap; 2.2µ
C4: cap; 2.2µ
M1: nmos; 2N7002
M2: nmos; 2N7002
M4: nmos; 2N7002
R1: res; 10k
R2: res; 1000k
R3: res; 1000k
U1: LT1790-3.3
U2: LT1790-3.3
V1: voltage; 5
V2: voltage; 1.435
V3: voltage; 5
Named nets: 0, Vout, Vfpga, Vout2, Vfpga2
.dc V1 0 12 0.1
.temp -40 25 85
