andrastantos/unic/sims/high-voltage-pin-protection-mosfet.asc

C1: cap; 15p
C2: cap; 20p
C3: cap; 1µ
C4: cap; 50p
C5: cap; 1µ
C6: cap; 2p
C7: cap; 2p
D1: schottky; BAT54
D2: schottky; BAT54
D3: schottky; BAT54
D4: schottky; BAT54
M1: nmos; RK7002BM
M2: nmos; RK7002BM
M3: nmos; RK7002BM
M4: nmos; RK7002BM
M5: nmos; RK7002BM
M6: nmos; RK7002BM
M7: nmos; RK7002BM
R1: res; 1Mega
R2: res; 0.01
R3: res; 1Mega
R4: res; 100
R5: res; 1Mega
R6: res; 100k
R7: res; 1Mega
R8: res; 10
R9: res; 100k
R10: res; 1Mega
R11: res; 100k
R12: res; 1Mega
R13: res; 100
R14: res; 100k
R15: res; 10
R16: res; 3.3k
R17: res; 1Mega
R18: res; 50
R19: res; 1Mega
R20: res; 50
V1: voltage; PULSE(0 5 0 1n 1n 100n 200n 2000)
V2: voltage; 4.5
V3: voltage; PULSE(0 3.3 0 1n 1n 100n 200n 20)
V4: voltage; 4.5
V5: voltage; PULSE(0 5 1n 1n 1n 1000 1000 1000)
V6: voltage; 5
V7: voltage; PULSE(0 3.3 1n 1n 1n 1000 1000 1000)
V8: voltage; 5
V9: voltage; PULSE(5 0 1n 1n 1n 1000 1000 1000)
V10: voltage; 5
V11: voltage; 5
V12: voltage; PULSE(3.3 0 1n 1n 1n 1000 1000 1000)
V13: voltage; PULSE(0 5 0 1n 1n 100n 200n 20)
V14: voltage; 3.3
V15: voltage; PULSE(1.025 1.375 0 100p 100p 4n 8n 200)
V16: voltage; 4.5
V17: voltage; PULSE(1.025 1.375 0 100p 100p 1n 2n 200)
V18: voltage; 5
V19: voltage; 3.3
Named nets: 0, LVDS_OUT, LVDS_OUT_REF
.tran 400n
Lots of good data of logic signals: https://www.ti.com/lit/an/sdya009c/sdya009c.pdf?ts=1687728163429
The problem seems to be that the MOSFET presents 
a really high input capacitance
thus, slowing the signal down quite a bit.
 
If this ciruit was inserted into a large fan-out
net, things would get ugly pretty quickly.
 
As it stands now, we add abour 5ns of
rise/fall to a 50pF reference load. That is
high, but probably acceptable.
11ns rise/fall
20pF external load gets us to 11ns rise/fall
This means ~30pF load from the circuit.
15pF external load gets us to ~11ns rise/fall
This means ~35pF load from the circuit.
;.step temp 0 85 85
This is a simulation for an LVDS output from GoWin
This is a simulation for an LVDS output from GoWin without the limiter circuit
