andrastantos/unic/sims/high-voltage-pin-protection.asc

J2: pjf; J175
R1: res; 1k
R2: res; 100
V1: voltage; PULSE(-10 10 0 1 1 5 10 2)
V2: voltage; 3.3
Named nets: 0
.tran 20
