andrastantos/unic/sims/pin-protection.asc

D1: schottky; BAT54
D2: schottky; BAT54
D3: schottky; BAT54
D4: schottky; BAT54
D5: schottky; BAT54
R1: res; 330
R2: res; 30
U1: ADP160-3.3
V1: voltage; 5
Named nets: 0
.tran 1u
The front BAS70SDW has 4 diodes, so can do the front-end of 2 pins.
Similarly a single BAS70CDW can handle the back-end of 4 pins.
 
A total of 30 of these device ($0.03 in quantity each) can do a DIP40.
 
A SN74S1053 can give us 16 pin front-end protection.
