andrastantos/unic/board_gw1_40/board_gw1_40.kicad_pcb

## KiCad design board_gw1_40/board_gw1_40.kicad_pcb (2025-01-27)

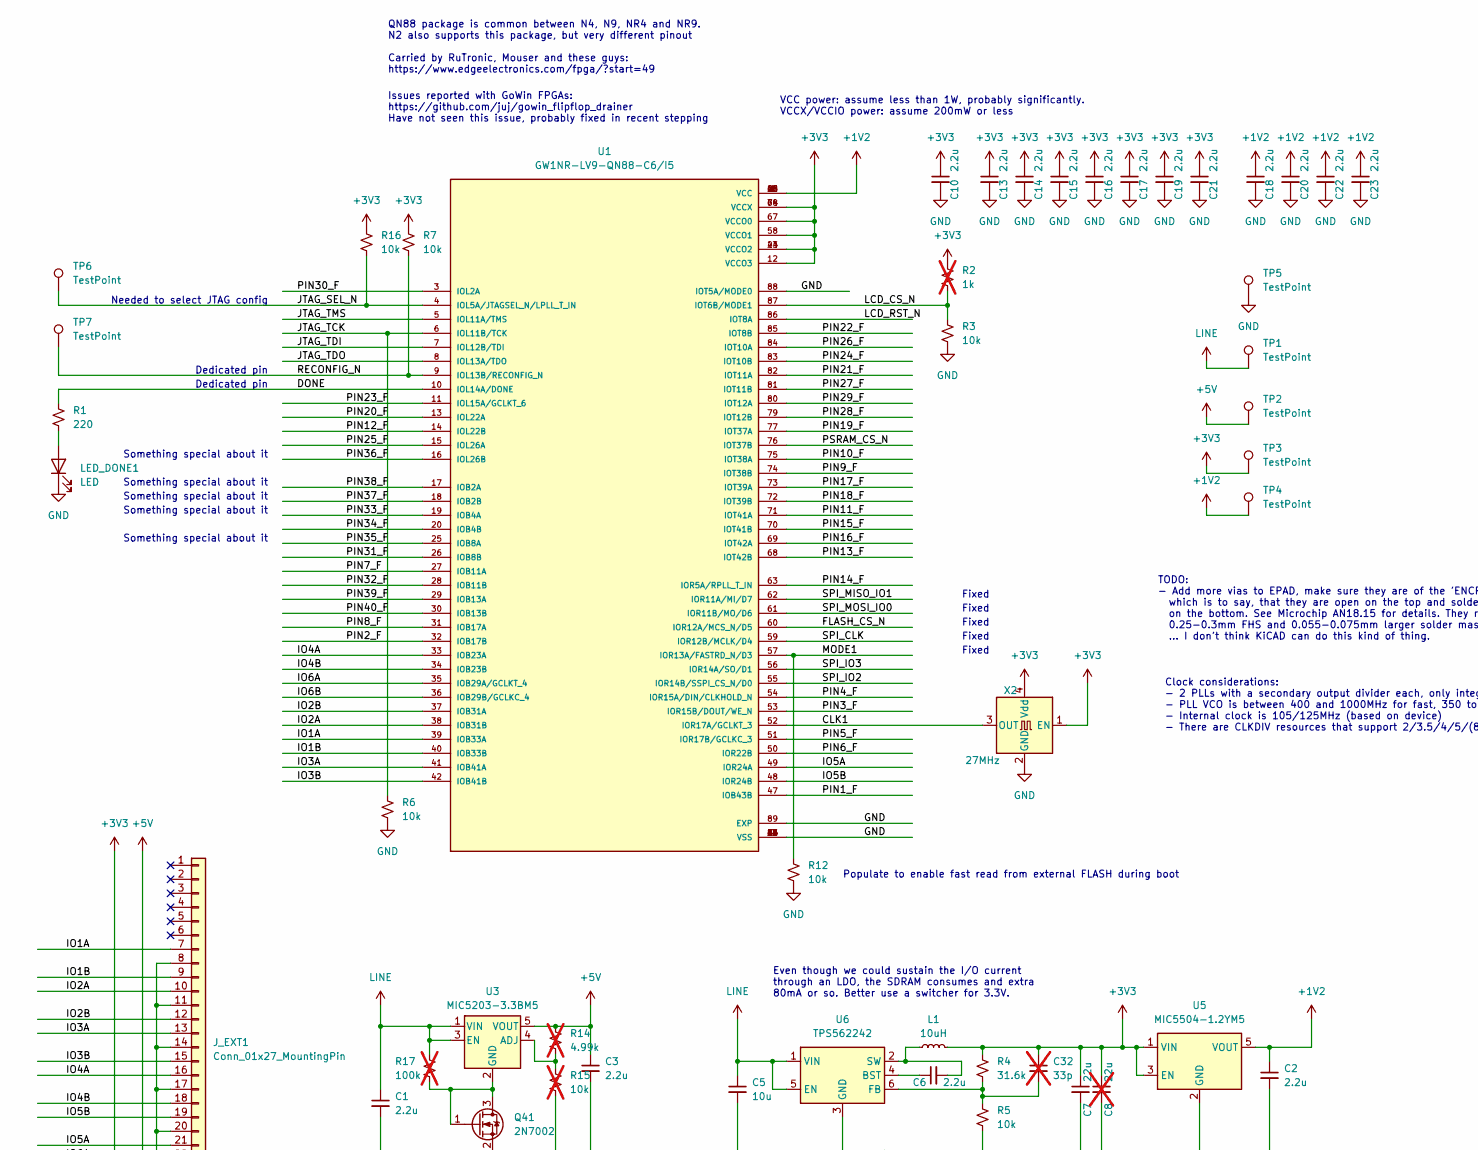
[picture p17: schematic board_gw1_40.kicad_sch, UNIC 40, part in row 1, column 1]

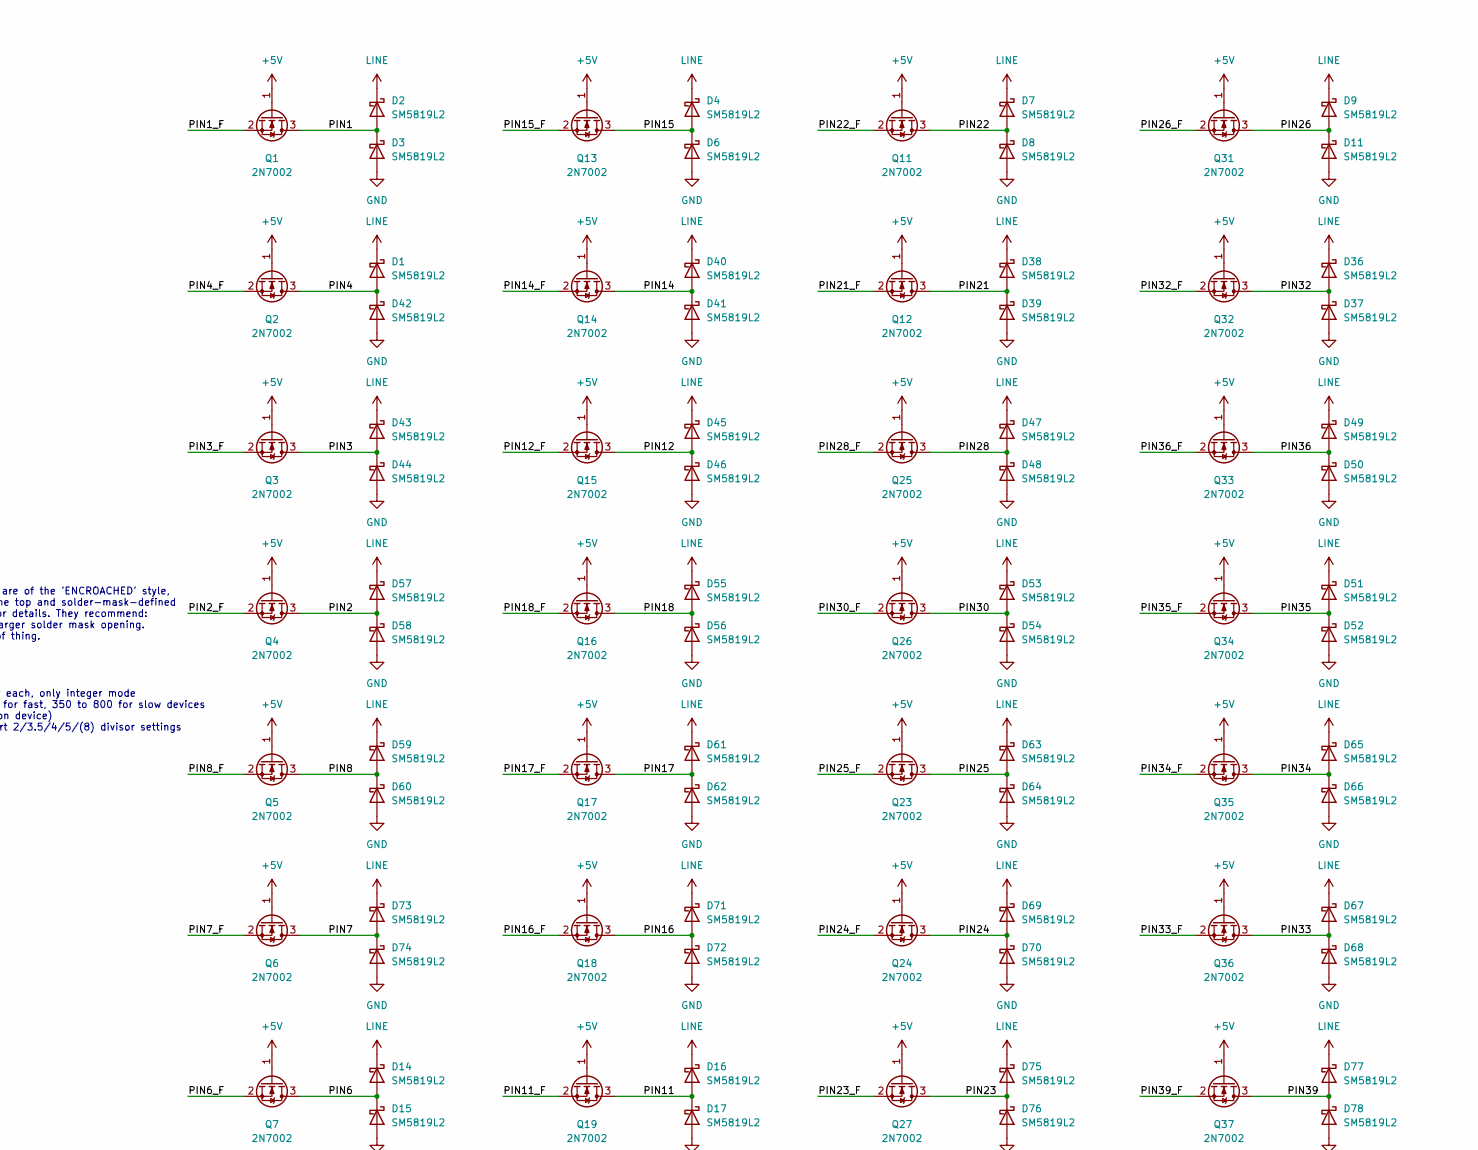
[picture p18: schematic board_gw1_40.kicad_sch, UNIC 40, part in row 1, column 2]

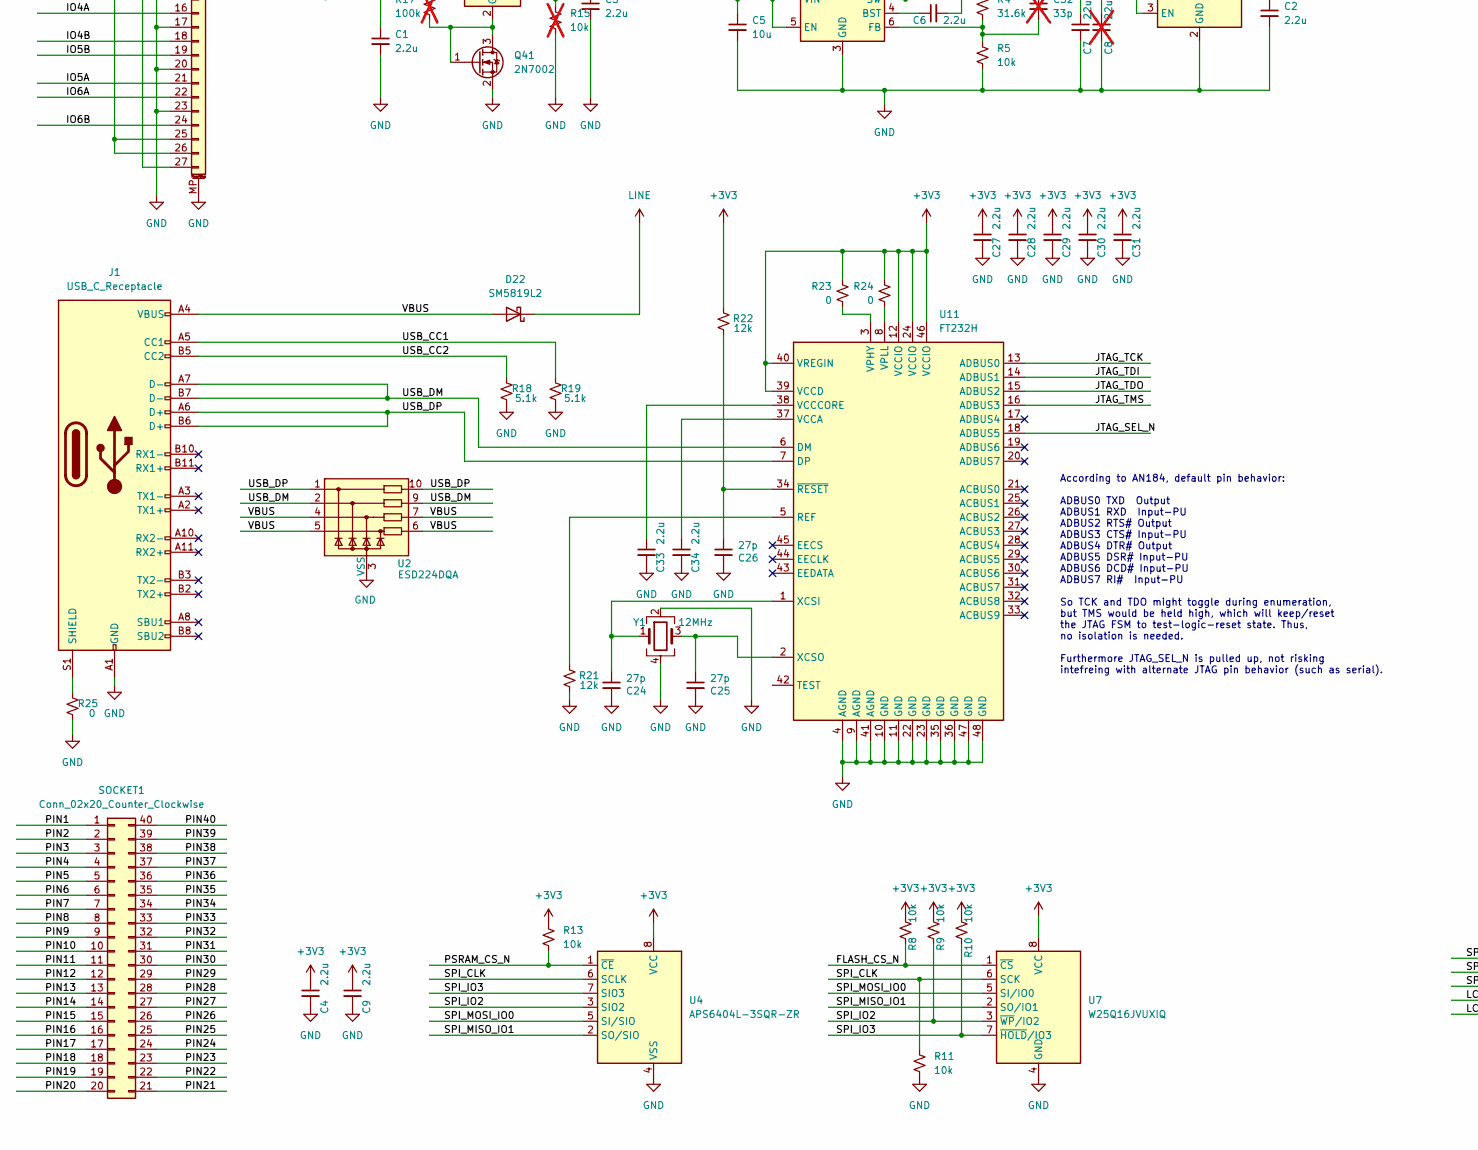
[picture p19: schematic board_gw1_40.kicad_sch, UNIC 40, part in row 2, column 1]

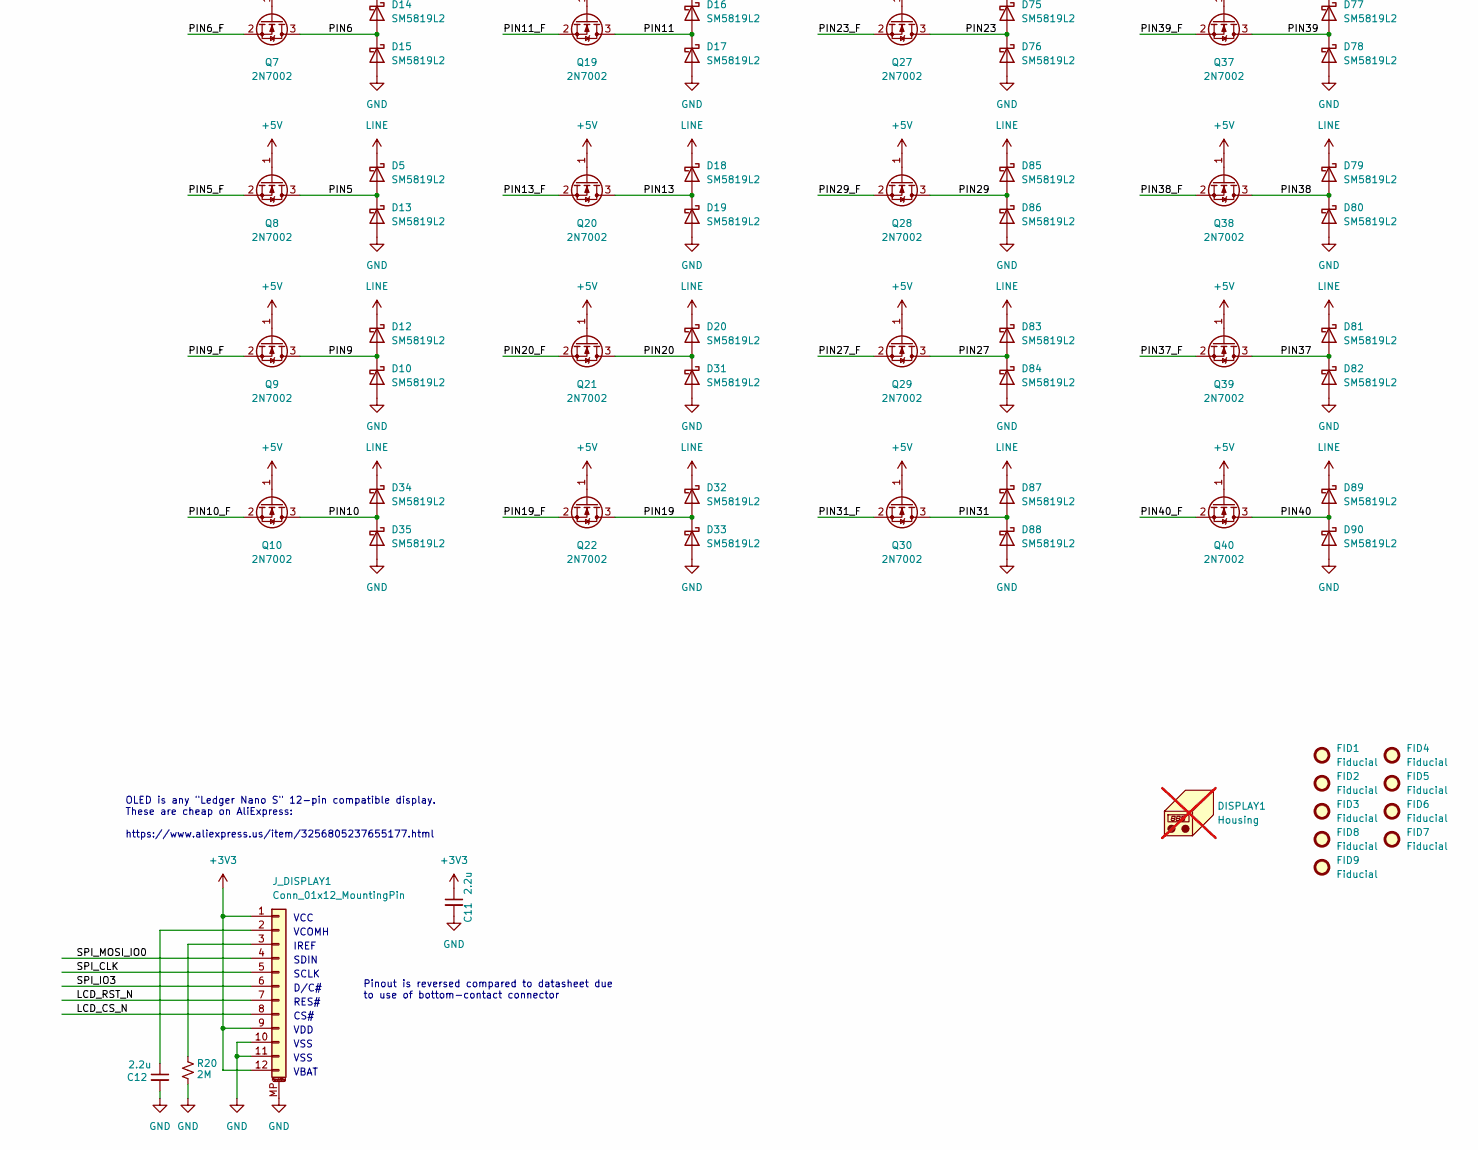
[picture p20: schematic board_gw1_40.kicad_sch, UNIC 40, part in row 2, column 2]

Parts:
C1: 2.2u; C_0402_1005Metric_Pad0.74x0.62mm_HandSolder; mpn CC0402MRX5R6BB225
C2, C3, C4, C6, C9, C10, C11, C12, C13, C14, C15, C16, C17, C18, C19, C20, C21, C22, C23, C27, C28, C29, C30, C31, C33, C34: 2.2u; C_0201_0603Metric; mpn CC0402MRX5R6BB225
C5: 10u; C_0805_2012Metric_Pad1.18x1.45mm_HandSolder; mpn CL21A106KAYNNNG
C7: 22u; C_0805_2012Metric_Pad1.18x1.45mm_HandSolder; mpn CL21A226MQQNNNE
C8: 22u; C_0805_2012Metric_Pad1.18x1.45mm_HandSolder; mpn CL21A226MQQNNNE; not fitted
C24, C25, C26: 27p; C_0201_0603Metric
C32: 33p; C_0201_0603Metric; mpn CC0402MRX5R6BB225; not fitted
D1, D2, D3, D4, D5, D6, D7, D8, D9, D10, D11, D12, D13, D14, D15, D16, D17, D18, D19, D20, D22, D31, D32, D33, D34, D35, D36, D37, D38, D39, D40, D41, D42, D43, D44, D45, D46, D47, D48, D49, D50, D51, D52, D53, D54, D55, D56, D57, D58, D59, D60, D61, D62, D63, D64, D65, D66, D67, D68, D69, D70, D71, D72, D73, D74, D75, D76, D77, D78, D79, D80, D81, D82, D83, D84, D85, D86, D87, D88, D89, D90: SM5819L2; D_SOD-882
DISPLAY1: Housing; CFAL12832C-0091B-W_A; mpn CFAL12832C-0091B-W_A; not fitted
FID1, FID2, FID3, FID4, FID5, FID6, FID7, FID8, FID9: Fiducial; Fiducial_0.5mm_Mask1mm
J1: USB_C_Receptacle; USB_C_Receptacle_GCT_USB4115-03-C
J_DISPLAY1: Conn_01x12_MountingPin; CF4212FH0R0-05-NH; mpn CF31121D0R0-05-NH
J_EXT1: Conn_01x27_MountingPin; Molex_502598-2793_2Rows-23P~0.60mm_Horizontal; mpn 502598-2793
L1: 10uH; L_1008_2520Metric_Pad1.43x2.20mm_HandSolder; mpn UHP 252012BF-100M
LED_DONE1: LED; LED_0402_1005Metric_Pad0.77x0.64mm_HandSolder; mpn CS42C-QL4
Q1, Q2, Q3, Q4, Q5, Q6, Q7, Q8, Q9, Q10, Q11, Q12, Q13, Q14, Q15, Q16, Q17, Q18, Q19, Q20, Q21, Q22, Q23, Q24, Q25, Q26, Q27, Q28, Q29, Q30, Q31, Q32, Q33, Q34, Q35, Q36, Q37, Q38, Q39, Q40, Q41: 2N7002; SOT-883; mpn 2N7002KL3A-TP
R1: 220; R_0201_0603Metric; mpn CR0402-JW-221GLF
R2: 1k; R_0201_0603Metric; mpn CR0402-JW-102GLF; not fitted
R3, R5, R6, R7, R8, R9, R10, R11, R12, R13, R16: 10k; R_0201_0603Metric; mpn CR0402-FX-1002GLF
R4: 31.6k; R_0201_0603Metric; mpn CR0402-FX-3162GLF
R14: 4.99k; R_0201_0603Metric; mpn CR0402-FX-4991GLF; not fitted
R15: 10k; R_0201_0603Metric; mpn CR0402-FX-1002GLF; not fitted
R17: 100k; R_0201_0603Metric; mpn CR0402-FX-1002GLF; not fitted
R18, R19: 5.1k; R_0201_0603Metric
R20: 2M; R_0201_0603Metric
R21, R22: 12k; R_0201_0603Metric
R23, R24, R25: 0; R_0201_0603Metric
SOCKET1: Conn_02x20_Counter_Clockwise; DIP-40_pin_header; mpn BA3760-TUBL-4A-F5
TP1, TP2, TP3, TP4, TP5, TP6, TP7: TestPoint; TestPoint_Pad_D2.0mm
U1: GW1NR-LV9-QN88-C6/I5; QFN40P1000X1000X95-89N; PARTREV UG103-2.3E
U2: ESD224DQA; Diodes_UDFN-10_1.0x2.5mm_P0.5mm; mpn TVU1240R1ADG
U3: MIC5203-3.3BM5; SOT-23-5; mpn MIC5203-3.3YM5-TR
U4: APS6404L-3SQR-ZR; W25Q16JVUXIQ_TR; mpn APS6404L-3SQR-ZR
U5: MIC5504-1.2YM5; SOT-23-5; mpn MIC5504-1.2YM5-TR
U6: TPS562242; SOT-563; mpn TPS562242
U7: W25Q16JVUXIQ; W25Q16JVUXIQ_TR; mpn W25Q16JVUXIQ TR
U11: FT232H; LQFP-48_7x7mm_P0.5mm
X2: 27MHz; Oscillator_SMD_2.5x2.0mm; mpn SG-210STF 27.0000ML5
Y1: 12MHz; Crystal_SMD_2016-4Pin_2.0x1.6mm; mpn E9X250101G03

Connections:
+1V2: C2.1, C18.1, C20.1, C22.1, C23.1, TP4.1, U1.1 (VCC), U1.22 (VCC), U1.45 (VCC), U1.66 (VCC), U5.5 (VOUT)
+3V3: C4.1, C7.1, C8.1, C9.1, C10.1, C11.1, C13.1, C14.1, C15.1, C16.1, C17.1, C19.1, C21.1, C27.1, C28.1, C29.1, C30.1, C31.1, C32.1, J_DISPLAY1.1, J_DISPLAY1.9, J_DISPLAY1.12, J_EXT1.25, J_EXT1.26, L1.2, R2.1, R4.1, R7.1, R8.1, R9.1, R10.1, R13.1, R16.1, R22.2, R23.2, R24.2, TP3.1, U1.12 (VCCO3), U1.23 (VCCO2), U1.44 (VCCO2), U1.58 (VCCO1), U1.64 (VCCX), U1.67 (VCCO0), U1.78 (VCCX), U4.8 (VCC), U5.1 (VIN), U5.3 (EN), U7.8 (VCC), U11.12 (VCCIO), U11.24 (VCCIO), U11.39 (VCCD), U11.40 (VREGIN), U11.46 (VCCIO), X2.1 (EN), X2.4 (Vdd)
+5V: C3.1, J_EXT1.27, Q1.1 (G), Q2.1 (G), Q3.1 (G), Q4.1 (G), Q5.1 (G), Q6.1 (G), Q7.1 (G), Q8.1 (G), Q9.1 (G), Q10.1 (G), Q11.1 (G), Q12.1 (G), Q13.1 (G), Q14.1 (G), Q15.1 (G), Q16.1 (G), Q17.1 (G), Q18.1 (G), Q19.1 (G), Q20.1 (G), Q21.1 (G), Q22.1 (G), Q23.1 (G), Q24.1 (G), Q25.1 (G), Q26.1 (G), Q27.1 (G), Q28.1 (G), Q29.1 (G), Q30.1 (G), Q31.1 (G), Q32.1 (G), Q33.1 (G), Q34.1 (G), Q35.1 (G), Q36.1 (G), Q37.1 (G), Q38.1 (G), Q39.1 (G), Q40.1 (G), R14.1, TP2.1, U3.5 (VOUT)
/CLK1: U1.52 (IOR17A/GCLKT_3), X2.3 (OUT)
/DONE: R1.1, U1.10 (IOL14A/DONE)
/FLASH_CS_N: R8.2, U1.60 (IOR12A/MCS_N/D5), U7.1 (~CS)
/IO1A: J_EXT1.7, U1.39 (IOB33A)
/IO1B: J_EXT1.9, U1.40 (IOB33B)
/IO2A: J_EXT1.10, U1.38 (IOB31B)
/IO2B: J_EXT1.12, U1.37 (IOB31A)
/IO3A: J_EXT1.13, U1.41 (IOB41A)
/IO3B: J_EXT1.15, U1.42 (IOB41B)
/IO4A: J_EXT1.16, U1.33 (IOB23A)
/IO4B: J_EXT1.18, U1.34 (IOB23B)
/IO5A: J_EXT1.21, U1.49 (IOR24A)
/IO5B: J_EXT1.19, U1.48 (IOR24B)
/IO6A: J_EXT1.22, U1.35 (IOB29A/GCLKT_4)
/IO6B: J_EXT1.24, U1.36 (IOB29B/GCLKC_4)
/JTAG_SEL_N: R16.2, TP6.1, U1.4 (IOL5A/JTAGSEL_N/LPLL_T_IN), U11.18 (ADBUS5)
/JTAG_TCK: R6.1, U1.6 (IOL11B/TCK), U11.13 (ADBUS0)
/JTAG_TDI: U1.7 (IOL12B/TDI), U11.14 (ADBUS1)
/JTAG_TDO: U1.8 (IOL13A/TDO), U11.15 (ADBUS2)
/JTAG_TMS: U1.5 (IOL11A/TMS), U11.16 (ADBUS3)
/LCD_CS_N: J_DISPLAY1.8, R2.2, R3.1, U1.87 (IOT6B/MODE1)
/LCD_RST_N: J_DISPLAY1.7, U1.86 (IOT8A)
/MODE1: R12.1, U1.57 (IOR13A/FASTRD_N/D3)
/PIN1: D2.2 (A), D3.1 (K), Q1.3 (D), SOCKET1.1
/PIN1_F: Q1.2 (S), U1.47 (IOB43B)
/PIN2: D57.2 (A), D58.1 (K), Q4.3 (D), SOCKET1.2
/PIN2_F: Q4.2 (S), U1.32 (IOB17B)
/PIN3: D43.2 (A), D44.1 (K), Q3.3 (D), SOCKET1.3
/PIN3_F: Q3.2 (S), U1.53 (IOR15B/DOUT/WE_N)
/PIN4: D1.2 (A), D42.1 (K), Q2.3 (D), SOCKET1.4
/PIN4_F: Q2.2 (S), U1.54 (IOR15A/DIN/CLKHOLD_N)
/PIN5: D5.2 (A), D13.1 (K), Q8.3 (D), SOCKET1.5
/PIN5_F: Q8.2 (S), U1.51 (IOR17B/GCLKC_3)
/PIN6: D14.2 (A), D15.1 (K), Q7.3 (D), SOCKET1.6
/PIN6_F: Q7.2 (S), U1.50 (IOR22B)
/PIN7: D73.2 (A), D74.1 (K), Q6.3 (D), SOCKET1.7
/PIN7_F: Q6.2 (S), U1.27 (IOB11A)
/PIN8: D59.2 (A), D60.1 (K), Q5.3 (D), SOCKET1.8
/PIN8_F: Q5.2 (S), U1.31 (IOB17A)
/PIN9: D10.1 (K), D12.2 (A), Q9.3 (D), SOCKET1.9
/PIN9_F: Q9.2 (S), U1.74 (IOT38B)
/PIN10: D34.2 (A), D35.1 (K), Q10.3 (D), SOCKET1.10
/PIN10_F: Q10.2 (S), U1.75 (IOT38A)
/PIN11: D16.2 (A), D17.1 (K), Q19.3 (D), SOCKET1.11
/PIN11_F: Q19.2 (S), U1.71 (IOT41A)
/PIN12: D45.2 (A), D46.1 (K), Q15.3 (D), SOCKET1.12
/PIN12_F: Q15.2 (S), U1.14 (IOL22B)
/PIN13: D18.2 (A), D19.1 (K), Q20.3 (D), SOCKET1.13
/PIN13_F: Q20.2 (S), U1.68 (IOT42B)
/PIN14: D40.2 (A), D41.1 (K), Q14.3 (D), SOCKET1.14
/PIN14_F: Q14.2 (S), U1.63 (IOR5A/RPLL_T_IN)
/PIN15: D4.2 (A), D6.1 (K), Q13.3 (D), SOCKET1.15
/PIN15_F: Q13.2 (S), U1.70 (IOT41B)
/PIN16: D71.2 (A), D72.1 (K), Q18.3 (D), SOCKET1.16
/PIN16_F: Q18.2 (S), U1.69 (IOT42A)
/PIN17: D61.2 (A), D62.1 (K), Q17.3 (D), SOCKET1.17
/PIN17_F: Q17.2 (S), U1.73 (IOT39A)
/PIN18: D55.2 (A), D56.1 (K), Q16.3 (D), SOCKET1.18
/PIN18_F: Q16.2 (S), U1.72 (IOT39B)
/PIN19: D32.2 (A), D33.1 (K), Q22.3 (D), SOCKET1.19
/PIN19_F: Q22.2 (S), U1.77 (IOT37A)
/PIN20: D20.2 (A), D31.1 (K), Q21.3 (D), SOCKET1.20
/PIN20_F: Q21.2 (S), U1.13 (IOL22A)
/PIN21: D38.2 (A), D39.1 (K), Q12.3 (D), SOCKET1.21
/PIN21_F: Q12.2 (S), U1.82 (IOT11A)
/PIN22: D7.2 (A), D8.1 (K), Q11.3 (D), SOCKET1.22
/PIN22_F: Q11.2 (S), U1.85 (IOT8B)
/PIN23: D75.2 (A), D76.1 (K), Q27.3 (D), SOCKET1.23
/PIN23_F: Q27.2 (S), U1.11 (IOL15A/GCLKT_6)
/PIN24: D69.2 (A), D70.1 (K), Q24.3 (D), SOCKET1.24
/PIN24_F: Q24.2 (S), U1.83 (IOT10B)
/PIN25: D63.2 (A), D64.1 (K), Q23.3 (D), SOCKET1.25
/PIN25_F: Q23.2 (S), U1.15 (IOL26A)
/PIN26: D9.2 (A), D11.1 (K), Q31.3 (D), SOCKET1.26
/PIN26_F: Q31.2 (S), U1.84 (IOT10A)
/PIN27: D83.2 (A), D84.1 (K), Q29.3 (D), SOCKET1.27
/PIN27_F: Q29.2 (S), U1.81 (IOT11B)
/PIN28: D47.2 (A), D48.1 (K), Q25.3 (D), SOCKET1.28
/PIN28_F: Q25.2 (S), U1.79 (IOT12B)
/PIN29: D85.2 (A), D86.1 (K), Q28.3 (D), SOCKET1.29
/PIN29_F: Q28.2 (S), U1.80 (IOT12A)
/PIN30: D53.2 (A), D54.1 (K), Q26.3 (D), SOCKET1.30
/PIN30_F: Q26.2 (S), U1.3 (IOL2A)
/PIN31: D87.2 (A), D88.1 (K), Q30.3 (D), SOCKET1.31
/PIN31_F: Q30.2 (S), U1.26 (IOB8B)
/PIN32: D36.2 (A), D37.1 (K), Q32.3 (D), SOCKET1.32
/PIN32_F: Q32.2 (S), U1.28 (IOB11B)
/PIN33: D67.2 (A), D68.1 (K), Q36.3 (D), SOCKET1.33
/PIN33_F: Q36.2 (S), U1.19 (IOB4A)
/PIN34: D65.2 (A), D66.1 (K), Q35.3 (D), SOCKET1.34
/PIN34_F: Q35.2 (S), U1.20 (IOB4B)
/PIN35: D51.2 (A), D52.1 (K), Q34.3 (D), SOCKET1.35
/PIN35_F: Q34.2 (S), U1.25 (IOB8A)
/PIN36: D49.2 (A), D50.1 (K), Q33.3 (D), SOCKET1.36
/PIN36_F: Q33.2 (S), U1.16 (IOL26B)
/PIN37: D81.2 (A), D82.1 (K), Q39.3 (D), SOCKET1.37
/PIN37_F: Q39.2 (S), U1.18 (IOB2B)
/PIN38: D79.2 (A), D80.1 (K), Q38.3 (D), SOCKET1.38
/PIN38_F: Q38.2 (S), U1.17 (IOB2A)
/PIN39: D77.2 (A), D78.1 (K), Q37.3 (D), SOCKET1.39
/PIN39_F: Q37.2 (S), U1.29 (IOB13A)
/PIN40: D89.2 (A), D90.1 (K), Q40.3 (D), SOCKET1.40
/PIN40_F: Q40.2 (S), U1.30 (IOB13B)
/PSRAM_CS_N: R13.2, U1.76 (IOT37B), U4.1 (~CE)
/RECONFIG_N: R7.2, TP7.1, U1.9 (IOL13B/RECONFIG_N)
/SPI_CLK: J_DISPLAY1.5, R11.1, U1.59 (IOR12B/MCLK/D4), U4.6 (SCLK), U7.6 (SCK)
/SPI_IO2: R9.2, U1.55 (IOR14B/SSPI_CS_N/D0), U4.3 (SIO2), U7.3 (~WP/IO2)
/SPI_IO3: J_DISPLAY1.6, R10.2, U1.56 (IOR14A/SO/D1), U4.7 (SIO3), U7.7 (~HOLD/IO3)
/SPI_MISO_IO1: U1.62 (IOR11A/MI/D7), U4.2 (SO/SIO), U7.2 (SO/IO1)
/SPI_MOSI_IO0: J_DISPLAY1.4, U1.61 (IOR11B/MO/D6), U4.5 (SI/SIO), U7.5 (SI/IO0)
/USB_CC1: J1.A5 (CC1), R19.2
/USB_CC2: J1.B5 (CC2), R18.2
/USB_DM: J1.A7 (D-), J1.B7 (D-), U2.2, U2.9, U11.6 (DM)
/USB_DP: J1.A6 (D+), J1.B6 (D+), U2.1, U2.10, U11.7 (DP)
/VBUS: D22.2 (A), J1.A4 (VBUS), J1.A9 (VBUS), J1.B4 (VBUS), J1.B9 (VBUS), U2.4, U2.5, U2.6, U2.7
GND: C1.2, C2.2, C3.2, C4.2, C5.2, C7.2, C8.2, C9.2, C10.2, C11.2, C12.2, C13.2, C14.2, C15.2, C16.2, C17.2, C18.2, C19.2, C20.2, C21.2, C22.2, C23.2, C24.2, C25.2, C26.2, C27.2, C28.2, C29.2, C30.2, C31.2, C33.2, C34.2, D3.2 (A), D6.2 (A), D8.2 (A), D10.2 (A), D11.2 (A), D13.2 (A), D15.2 (A), D17.2 (A), D19.2 (A), D31.2 (A), D33.2 (A), D35.2 (A), D37.2 (A), D39.2 (A), D41.2 (A), D42.2 (A), D44.2 (A), D46.2 (A), D48.2 (A), D50.2 (A), D52.2 (A), D54.2 (A), D56.2 (A), D58.2 (A), D60.2 (A), D62.2 (A), D64.2 (A), D66.2 (A), D68.2 (A), D70.2 (A), D72.2 (A), D74.2 (A), D76.2 (A), D78.2 (A), D80.2 (A), D82.2 (A), D84.2 (A), D86.2 (A), D88.2 (A), D90.2 (A), J1.A1 (GND), J1.A12 (GND), J1.B1 (GND), J1.B12 (GND), J_DISPLAY1.10, J_DISPLAY1.11, J_DISPLAY1.MP (MountPin), J_EXT1.8, J_EXT1.11, J_EXT1.14, J_EXT1.17, J_EXT1.20, J_EXT1.23, J_EXT1.MP (MountPin), LED_DONE1.1 (K), Q41.2 (S), R3.2, R5.2, R6.2, R11.2, R12.2, R15.2, R18.1, R19.1, R20.2, R21.1, R25.1, TP5.1, U1.2 (VSS), U1.21 (VSS), U1.24 (VSS), U1.43 (VSS), U1.46 (VSS), U1.65 (VSS), U1.88 (IOT5A/MODE0), U1.89 (EXP), U2.3 (VSS), U2.8 (VSS), U4.4 (VSS), U5.2 (GND), U6.3 (GND), U7.4 (GND), U11.4 (AGND), U11.9 (AGND), U11.10 (GND), U11.11 (GND), U11.22 (GND), U11.23 (GND), U11.35 (GND), U11.36 (GND), U11.41 (AGND), U11.47 (GND), U11.48 (GND), X2.2 (GND), Y1.2, Y1.4
LINE: C1.1, C5.1, D1.1 (K), D2.1 (K), D4.1 (K), D5.1 (K), D7.1 (K), D9.1 (K), D12.1 (K), D14.1 (K), D16.1 (K), D18.1 (K), D20.1 (K), D22.1 (K), D32.1 (K), D34.1 (K), D36.1 (K), D38.1 (K), D40.1 (K), D43.1 (K), D45.1 (K), D47.1 (K), D49.1 (K), D51.1 (K), D53.1 (K), D55.1 (K), D57.1 (K), D59.1 (K), D61.1 (K), D63.1 (K), D65.1 (K), D67.1 (K), D69.1 (K), D71.1 (K), D73.1 (K), D75.1 (K), D77.1 (K), D79.1 (K), D81.1 (K), D83.1 (K), D85.1 (K), D87.1 (K), D89.1 (K), R17.1, TP1.1, U3.1 (VIN), U3.3 (EN), U6.1 (VIN), U6.5 (EN)
unnamed: J1.S1 (SHIELD), R25.2
unnamed: C12.1, J_DISPLAY1.2
unnamed: J_DISPLAY1.3, R20.1
unnamed: LED_DONE1.2 (A), R1.2
unnamed: Q41.1 (G), Q41.3 (D), R17.2, U3.2 (GND)
unnamed: R14.2, R15.1, U3.4 (ADJ)
unnamed: C6.1, U6.4 (BST)
unnamed: C32.2, R4.2, R5.1, U6.6 (FB)
unnamed: C6.2, L1.1, U6.2 (SW)
unnamed: R21.2, U11.5 (REF)
unnamed: C34.1, U11.37 (VCCA)
unnamed: C33.1, U11.38 (VCCCORE)
unnamed: R23.1, U11.3 (VPHY)
unnamed: R24.1, U11.8 (VPLL)
unnamed: C24.1, U11.1 (XCSI), Y1.1
unnamed: C25.1, U11.2 (XCSO), Y1.3
unnamed: C26.1, R22.1, U11.34 (~RESET)

Notes on the sheet:
Issues reported with GoWin FPGAs: https://github.com/juj/gowin_flipflop_drainer Have not seen this issue, probably fixed in recent stepping
Populate to enable fast read from external FLASH during boot
Pinout is reversed compared to datasheet due to use of bottom-contact connector
Fixed
Something special about it
CS#
TODO: - Add more vias to EPAD, make sure they are of the 'ENCROACHED' style, which is to say, that they are open on the top and solder-mask-defined on the bottom. See Microchip AN18.15 for details. They recommend: 0.25-0.3mm FHS and 0.055-0.075mm larger solder mask opening. ... I don't think KiCAD 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
VCC
VSS
VCC power: assume less than 1W, probably significantly. VCCX/VCCIO power: assume 200mW or less
OLED is any "Ledger Nano S" 12-pin compatible display. These are cheap on AliExpress: https://www.aliexpress.us/item/3256805237655177.html
SCLK
Clock considerations: - 2 PLLs with a secondary output divider each, only integer mode - PLL VCO is between 400 and 1000MHz for fast, 350 to 800 for slow devices - Internal clock is 105/125MHz (based on device) - There are CLKDIV resources that support 2/3.5/4/5/(8) divisor settings
Even though we could sustain the I/O current through an LDO, the SDRAM consumes and extra 80mA or so. Better use a switcher for 3.3V.
Dedicated pin
VDD
RES#
SDIN
Needed to select JTAG config
VCOMH
IREF
QN88 package is common between N4, N9, NR4 and NR9. N2 also supports this package, but very different pinout Carried by RuTronic, Mouser and these guys: https://www.edgeelectronics.com/fpga/?start=49
According to AN184, default pin behavior: ADBUS0 TXD Output ADBUS1 RXD Input-PU ADBUS2 RTS# Output ADBUS3 CTS# Input-PU ADBUS4 DTR# Output ADBUS5 DSR# Input-PU ADBUS6 DCD# Input-PU ADBUS7 RI# Input-PU So TCK and TDO might toggle during enumeration, but TMS would be held high, which will keep/reset 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
D/C#
VBAT

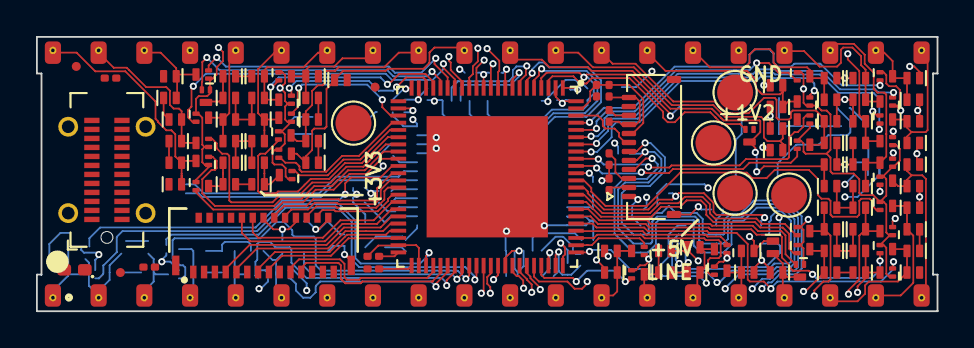
[picture p21: board board_gw1_40.kicad_pcb from above]

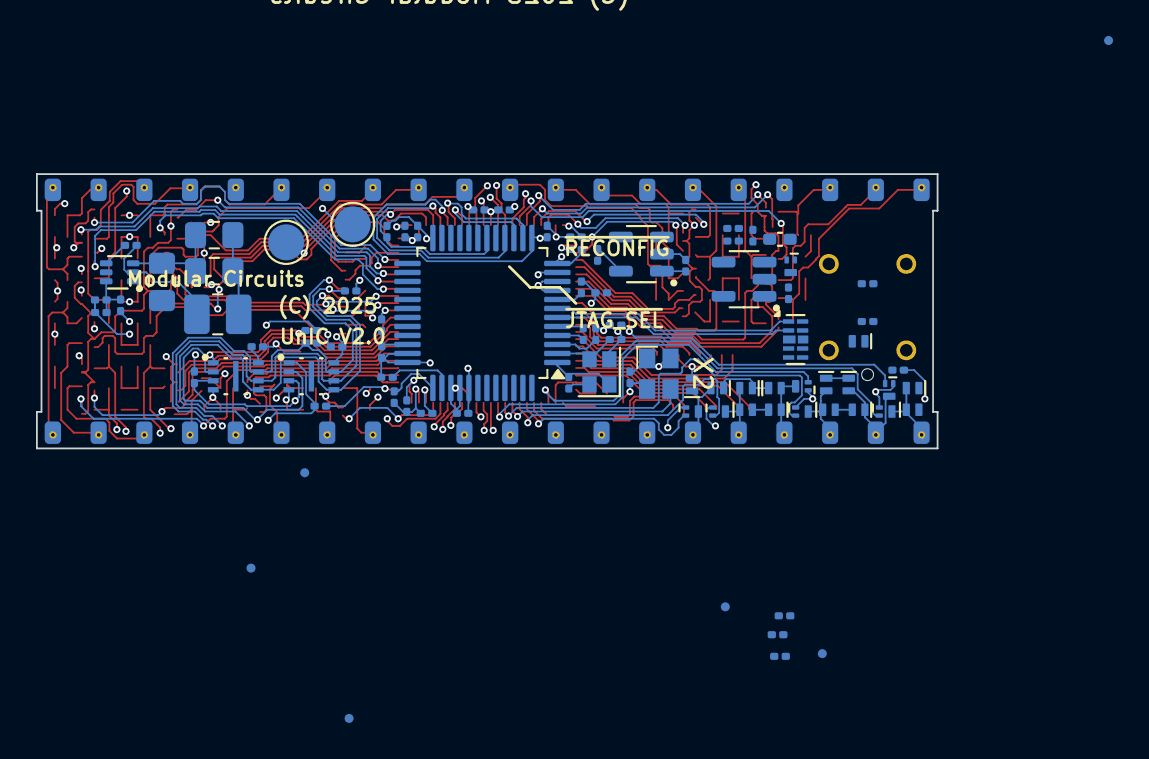
[picture p22: board board_gw1_40.kicad_pcb from below]

Board: 4 copper layers, 50.0 x 15.2 mm, 214 parts (88 on the bottom side), 137 nets.
