andrastantos/unic/z80_sampler/z80_sampler.kicad_pcb

## KiCad design z80_sampler/z80_sampler.kicad_pcb (2024-10-23)

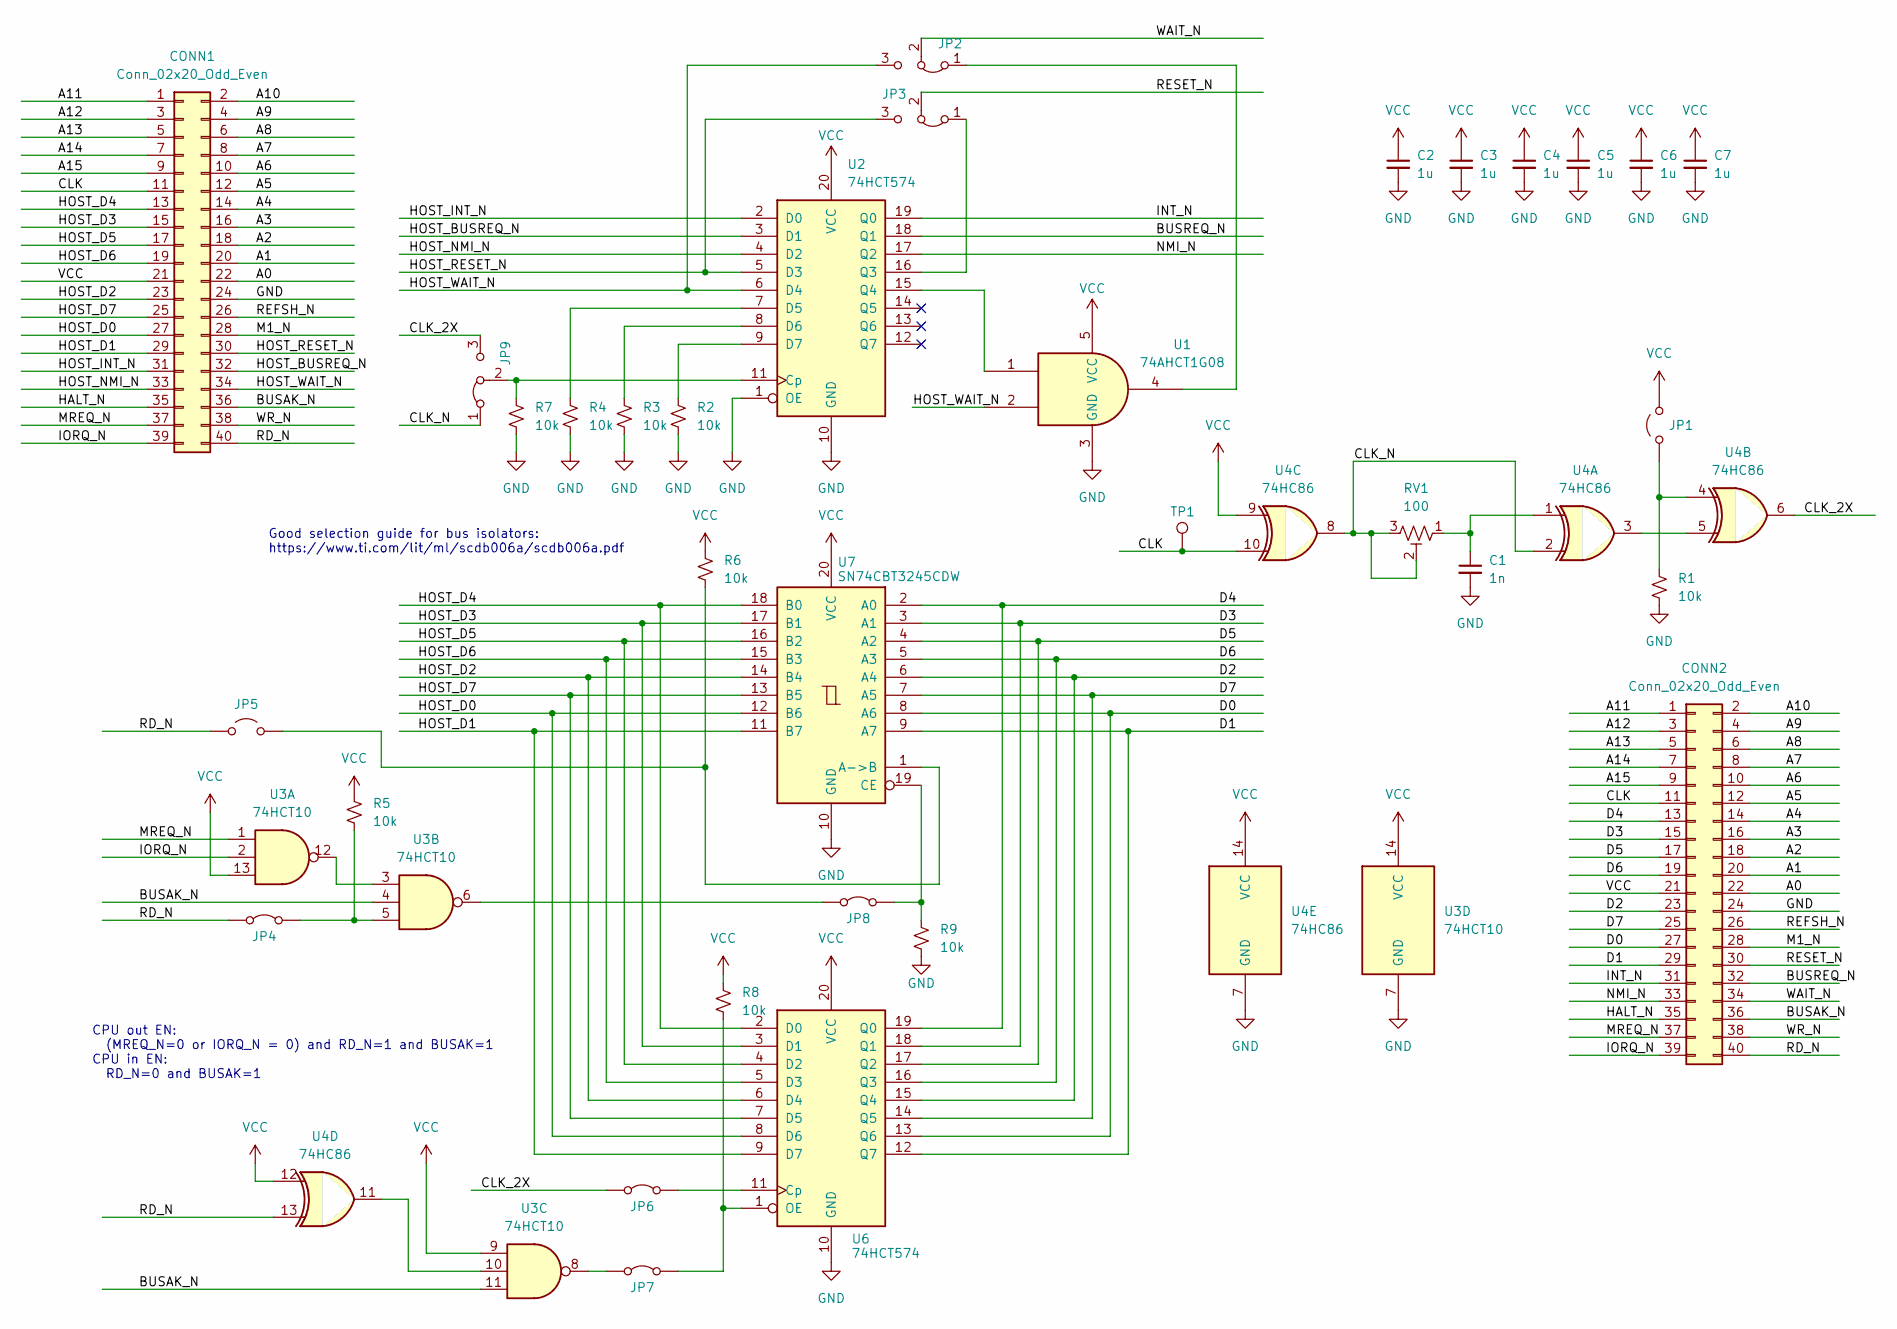
[picture p27: schematic z80_sampler.kicad_sch, Shadow Tracer Z80 Sampler]

Parts:
C1: 1n; C_0603_1608Metric_Pad1.08x0.95mm_HandSolder
C2, C3, C4, C5, C6, C7: 1u; C_0603_1608Metric_Pad1.08x0.95mm_HandSolder
CONN1: Conn_02x20_Odd_Even; PinSocket_2x20_P2.54mm_Horizontal
CONN2: Conn_02x20_Odd_Even; PinHeader_2x20_P2.54mm_Horizontal
JP1, JP5: Jumper_2_Open; PinHeader_1x02_P2.54mm_Vertical
JP2, JP3, JP9: Jumper_3_Bridged12; PinHeader_1x03_P2.54mm_Vertical
JP4, JP6, JP7, JP8: Jumper_2_Bridged; PinHeader_1x02_P2.54mm_Vertical
R1, R2, R3, R4, R5, R6, R7, R8, R9: 10k; R_0603_1608Metric_Pad0.98x0.95mm_HandSolder
RV1: 100; Potentiometer_Bourns_TC33X_Vertical; mpn TC33X-2-101E
TP1: TestPoint; PinHeader_1x01_P2.54mm_Vertical
U1: 74AHCT1G08; SOT-353_SC-70-5_Handsoldering
U2, U6: 74HCT574; SOIC-20W_7.5x12.8mm_P1.27mm
U3: 74HCT10; SOIC-14_3.9x8.7mm_P1.27mm
U4: 74HC86; SOIC-14_3.9x8.7mm_P1.27mm
U7: SN74CBT3245CDW; SOIC-20W_7.5x12.8mm_P1.27mm

Connections:
/A0: CONN1.22, CONN2.22
/A1: CONN1.20, CONN2.20
/A2: CONN1.18, CONN2.18
/A3: CONN1.16, CONN2.16
/A4: CONN1.14, CONN2.14
/A5: CONN1.12, CONN2.12
/A6: CONN1.10, CONN2.10
/A7: CONN1.8, CONN2.8
/A8: CONN1.6, CONN2.6
/A9: CONN1.4, CONN2.4
/A10: CONN1.2, CONN2.2
/A11: CONN1.1, CONN2.1
/A12: CONN1.3, CONN2.3
/A13: CONN1.5, CONN2.5
/A14: CONN1.7, CONN2.7
/A15: CONN1.9, CONN2.9
/BUSAK_N: CONN1.36, CONN2.36, U3.4, U3.11
/BUSREQ_N: CONN2.32, U2.18 (Q1)
/CLK: CONN1.11, CONN2.11, TP1.1, U4.10
/CLK_2X: JP6.1 (A), JP9.3 (B), U4.6
/CLK_N: JP9.1 (A), RV1.2, RV1.3, U4.2, U4.8
/D0: CONN2.27, U6.13 (Q6), U7.8 (A6)
/D1: CONN2.29, U6.12 (Q7), U7.9 (A7)
/D2: CONN2.23, U6.15 (Q4), U7.6 (A4)
/D3: CONN2.15, U6.18 (Q1), U7.3 (A1)
/D4: CONN2.13, U6.19 (Q0), U7.2 (A0)
/D5: CONN2.17, U6.17 (Q2), U7.4 (A2)
/D6: CONN2.19, U6.16 (Q3), U7.5 (A3)
/D7: CONN2.25, U6.14 (Q5), U7.7 (A5)
/HALT_N: CONN1.35, CONN2.35
/HOST_BUSREQ_N: CONN1.32, U2.3 (D1)
/HOST_D0: CONN1.27, U6.8 (D6), U7.12 (B6)
/HOST_D1: CONN1.29, U6.9 (D7), U7.11 (B7)
/HOST_D2: CONN1.23, U6.6 (D4), U7.14 (B4)
/HOST_D3: CONN1.15, U6.3 (D1), U7.17 (B1)
/HOST_D4: CONN1.13, U6.2 (D0), U7.18 (B0)
/HOST_D5: CONN1.17, U6.4 (D2), U7.16 (B2)
/HOST_D6: CONN1.19, U6.5 (D3), U7.15 (B3)
/HOST_D7: CONN1.25, U6.7 (D5), U7.13 (B5)
/HOST_INT_N: CONN1.31, U2.2 (D0)
/HOST_NMI_N: CONN1.33, U2.4 (D2)
/HOST_RESET_N: CONN1.30, JP3.3 (B), U2.5 (D3)
/HOST_WAIT_N: CONN1.34, JP2.3 (B), U1.2, U2.6 (D4)
/INT_N: CONN2.31, U2.19 (Q0)
/IORQ_N: CONN1.39, CONN2.39, U3.2
/M1_N: CONN1.28, CONN2.28
/MREQ_N: CONN1.37, CONN2.37, U3.1
/NMI_N: CONN2.33, U2.17 (Q2)
/RD_N: CONN1.40, CONN2.40, JP4.1 (A), JP5.1 (A), U4.13
/REFSH_N: CONN1.26, CONN2.26
/RESET_N: CONN2.30, JP3.2 (C)
/WAIT_N: CONN2.34, JP2.2 (C)
/WR_N: CONN1.38, CONN2.38
GND: C1.2, C2.2, C3.2, C4.2, C5.2, C6.2, C7.2, CONN1.24, CONN2.24, R1.2, R2.2, R3.2, R4.2, R7.2, R9.2, U1.3 (GND), U2.1 (OE), U2.10 (GND), U3.7 (GND), U4.7 (GND), U6.10 (GND), U7.10 (GND)
unnamed: C1.1, RV1.1, U4.1
unnamed: JP1.1 (A), R1.1, U4.4
unnamed: JP2.1 (A), U1.4
unnamed: JP3.1 (A), U2.16 (Q3)
unnamed: JP4.2 (B), R5.2, U3.5
unnamed: JP5.2 (B), R6.2, U7.1 (A->B)
unnamed: JP6.2 (B), U6.11 (Cp)
unnamed: JP7.1 (A), U3.8
unnamed: JP7.2 (B), R8.2, U6.1 (OE)
unnamed: JP8.1 (A), U3.6
unnamed: JP8.2 (B), R9.1, U7.19 (CE)
unnamed: JP9.2 (C), R7.1, U2.11 (Cp)
unnamed: R4.1, U2.7 (D5)
unnamed: R3.1, U2.8 (D6)
unnamed: R2.1, U2.9 (D7)
unnamed: U1.1, U2.15 (Q4)
unnamed: U3.10, U4.11
unnamed: U3.3, U3.12
unnamed: U4.3, U4.5
VCC: C2.1, C3.1, C4.1, C5.1, C6.1, C7.1, CONN1.21, CONN2.21, JP1.2 (B), R5.1, R6.1, R8.1, U1.5 (VCC), U2.20 (VCC), U3.9, U3.13, U3.14 (VCC), U4.9, U4.12, U4.14 (VCC), U6.20 (VCC), U7.20 (VCC)

Notes on the sheet:
Good selection guide for bus isolators: https://www.ti.com/lit/ml/scdb006a/scdb006a.pdf
CPU out EN: (MREQ_N=0 or IORQ_N = 0) and RD_N=1 and BUSAK=1 CPU in EN: RD_N=0 and BUSAK=1

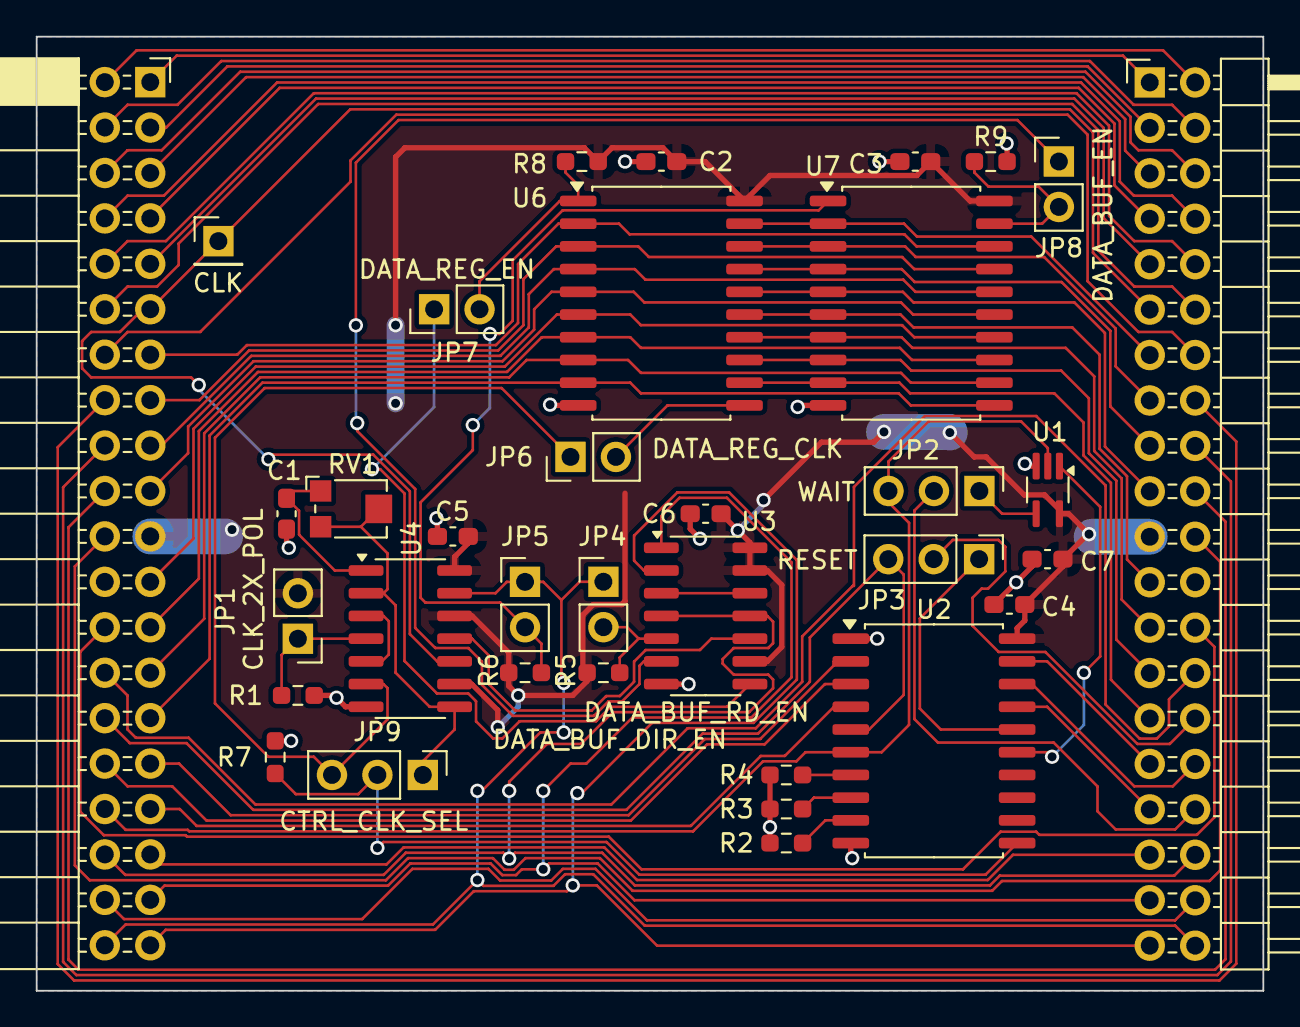
[picture p28: board z80_sampler.kicad_pcb from above]

Board: 2 copper layers, 68.6 x 53.3 mm, 35 parts (0 on the bottom side), 74 nets.
