andrastantos/unic/programmer2/programmer2.kicad_pcb

## KiCad design programmer2/programmer2.kicad_pcb (2024-09-08)

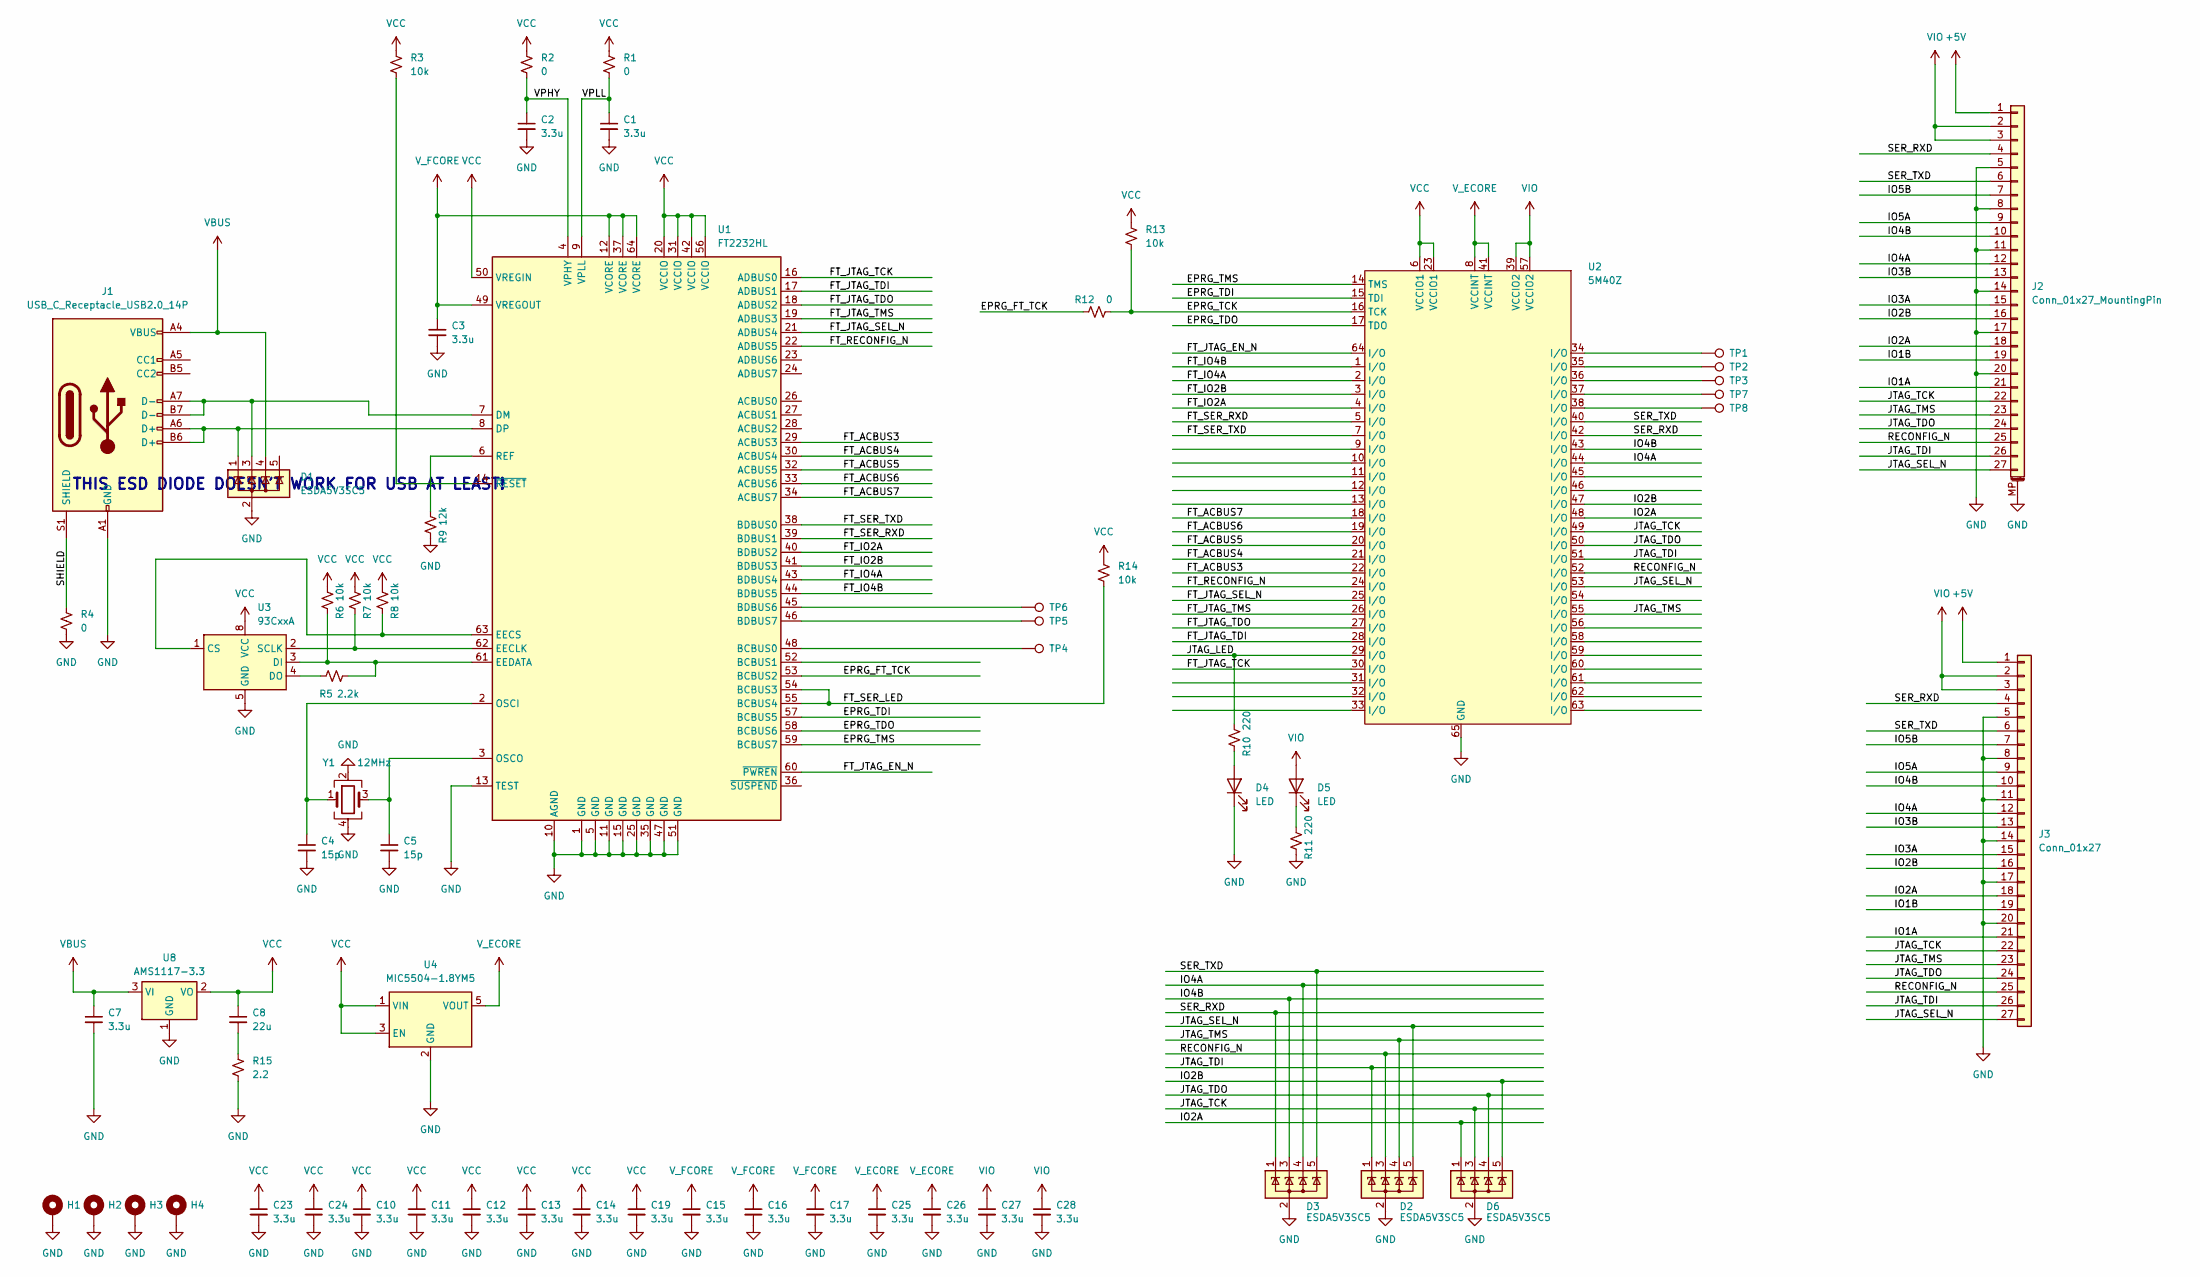
[picture p29: schematic programmer2.kicad_sch, UNIC Programmer 2]

Parts:
C1, C2, C3, C7, C10, C11, C12, C13, C14, C15, C16, C17, C19, C23, C24, C25, C26, C27, C28: 3.3u; C_0603_1608Metric_Pad1.08x0.95mm_HandSolder
C4, C5: 15p; C_0603_1608Metric_Pad1.08x0.95mm_HandSolder
C8: 22u; C_0805_2012Metric_Pad1.18x1.45mm_HandSolder
D1, D2, D3, D6: ESDA5V3SC5; SOT-23-5
D4, D5: LED; LED_0603_1608Metric_Pad1.05x0.95mm_HandSolder
H1, H2, H3, H4: MountingHole; MountingHole_3.2mm_M3_DIN965_Pad
J1: USB_C_Receptacle_USB2.0_14P; USB_C_Receptacle_HRO_TYPE-C-31-M-12; mpn 44116B01231
J2: Conn_01x27_MountingPin; Molex_502598-2793_2Rows-23P~0.60mm_Horizontal; mpn 502598-2793
J3: Conn_01x27; PinHeader_2x14_P2.54mm_Vertical
R1, R2, R4, R12: 0; R_0603_1608Metric_Pad0.98x0.95mm_HandSolder
R3, R6, R7, R8, R13, R14: 10k; R_0603_1608Metric_Pad0.98x0.95mm_HandSolder
R5: 2.2k; R_0603_1608Metric_Pad0.98x0.95mm_HandSolder
R9: 12k; R_0603_1608Metric_Pad0.98x0.95mm_HandSolder
R10, R11: 220; R_0603_1608Metric_Pad0.98x0.95mm_HandSolder
R15: 2.2; R_0603_1608Metric_Pad0.98x0.95mm_HandSolder
TP1, TP2, TP3, TP4, TP5, TP6, TP7, TP8: TestPoint; TestPoint_THTPad_1.0x1.0mm_Drill0.5mm
U1: FT2232HL; LQFP-64_10x10mm_P0.5mm
U2: 5M40Z; TQFP-64-1EP_10x10mm_P0.5mm_EP8x8mm
U3: 93CxxA; SO-8_3.9x4.9mm_P1.27mm
U4: MIC5504-1.8YM5; SOT-23-5
U8: AMS1117-3.3; SOT-223-3_TabPin2
Y1: 12MHz; Oscillator_SMD_Abracon_ASE-4Pin_3.2x2.5mm; mpn RH100-13.560-10-1020-EXT-TR

Connections:
+5V: J2.1, J3.1
/EPRG_FT_TCK: R12.1, U1.53 (BCBUS2)
/EPRG_TCK: R12.2, R13.2, U2.16 (TCK)
/EPRG_TDI: U1.57 (BCBUS5), U2.15 (TDI)
/EPRG_TDO: U1.58 (BCBUS6), U2.17 (TDO)
/EPRG_TMS: U1.59 (BCBUS7), U2.14 (TMS)
/FT_ACBUS3: U1.29 (ACBUS3), U2.22 (I/O)
/FT_ACBUS4: U1.30 (ACBUS4), U2.21 (I/O)
/FT_ACBUS5: U1.32 (ACBUS5), U2.20 (I/O)
/FT_ACBUS6: U1.33 (ACBUS6), U2.19 (I/O)
/FT_ACBUS7: U1.34 (ACBUS7), U2.18 (I/O)
/FT_IO2A: U1.40 (BDBUS2), U2.4 (I/O)
/FT_IO2B: U1.41 (BDBUS3), U2.3 (I/O)
/FT_IO4A: U1.43 (BDBUS4), U2.2 (I/O)
/FT_IO4B: U1.44 (BDBUS5), U2.1 (I/O)
/FT_JTAG_EN_N: U1.60 (~PWREN), U2.64 (I/O)
/FT_JTAG_SEL_N: U1.21 (ADBUS4), U2.25 (I/O)
/FT_JTAG_TCK: U1.16 (ADBUS0), U2.30 (I/O)
/FT_JTAG_TDI: U1.17 (ADBUS1), U2.28 (I/O)
/FT_JTAG_TDO: U1.18 (ADBUS2), U2.27 (I/O)
/FT_JTAG_TMS: U1.19 (ADBUS3), U2.26 (I/O)
/FT_RECONFIG_N: U1.22 (ADBUS5), U2.24 (I/O)
/FT_SER_LED: R14.2, U1.54 (BCBUS3), U1.55 (BCBUS4)
/FT_SER_RXD: U1.39 (BDBUS1), U2.5 (I/O)
/FT_SER_TXD: U1.38 (BDBUS0), U2.7 (I/O)
/IO1A: J2.21, J3.21
/IO1B: J2.19, J3.19
/IO2A: D6.1 (K), J2.18, J3.18, U2.48 (I/O)
/IO2B: D6.5 (K), J2.16, J3.16, U2.47 (I/O)
/IO3A: J2.15, J3.15
/IO3B: J2.13, J3.13
/IO4A: D3.4 (K), J2.12, J3.12, U2.44 (I/O)
/IO4B: D3.3 (K), J2.10, J3.10, U2.43 (I/O)
/IO5A: J2.9, J3.9
/IO5B: J2.7, J3.7
/JTAG_LED: R10.1, U2.29 (I/O)
/JTAG_SEL_N: D2.5 (K), J2.27, J3.27, U2.53 (I/O)
/JTAG_TCK: D6.3 (K), J2.22, J3.22, U2.49 (I/O)
/JTAG_TDI: D2.1 (K), J2.26, J3.26, U2.51 (I/O)
/JTAG_TDO: D6.4 (K), J2.24, J3.24, U2.50 (I/O)
/JTAG_TMS: D2.4 (K), J2.23, J3.23, U2.55 (I/O)
/RECONFIG_N: D2.3 (K), J2.25, J3.25, U2.52 (I/O)
/SER_RXD: D3.1 (K), J2.4, J3.4, U2.42 (I/O)
/SER_TXD: D3.5 (K), J2.6, J3.6, U2.40 (I/O)
/SHIELD: J1.S1 (SHIELD), R4.1
/VPHY: C2.1, R2.2, U1.4 (VPHY)
/VPLL: C1.1, R1.2, U1.9 (VPLL)
GND: C1.2, C2.2, C3.2, C4.2, C5.2, C7.2, C10.2, C11.2, C12.2, C13.2, C14.2, C15.2, C16.2, C17.2, C19.2, C23.2, C24.2, C25.2, C26.2, C27.2, C28.2, D1.2 (A), D2.2 (A), D3.2 (A), D4.1 (K), D6.2 (A), H1.1, H2.1, H3.1, H4.1, J1.A1 (GND), J1.A12 (GND), J1.B1 (GND), J1.B12 (GND), J2.5, J2.8, J2.11, J2.14, J2.17, J2.20, J2.MP (MountPin), J3.5, J3.8, J3.11, J3.14, J3.17, J3.20, R4.2, R9.2, R11.2, R15.2, U1.1 (GND), U1.5 (GND), U1.10 (AGND), U1.11 (GND), U1.13 (TEST), U1.15 (GND), U1.25 (GND), U1.35 (GND), U1.47 (GND), U1.51 (GND), U2.65 (GND), U3.5 (GND), U4.2 (GND), U8.1 (GND), Y1.2, Y1.4
unnamed: C8.2, R15.1
unnamed: D4.2 (A), R10.2
unnamed: D5.1 (K), R11.1
unnamed: TP1.1, U2.34 (I/O)
unnamed: TP2.1, U2.35 (I/O)
unnamed: TP3.1, U2.36 (I/O)
unnamed: TP7.1, U2.37 (I/O)
unnamed: TP8.1, U2.38 (I/O)
unnamed: TP4.1, U1.48 (BCBUS0)
unnamed: TP6.1, U1.45 (BDBUS6)
unnamed: TP5.1, U1.46 (BDBUS7)
unnamed: D1.3 (K), J1.A7 (D-), J1.B7 (D-), U1.7 (DM)
unnamed: D1.1 (K), J1.A6 (D+), J1.B6 (D+), U1.8 (DP)
unnamed: R7.2, U1.62 (EECLK), U3.2 (SCLK)
unnamed: R8.2, U1.63 (EECS), U3.1 (CS)
unnamed: R5.2, R6.2, U1.61 (EEDATA), U3.3 (DI)
unnamed: C4.1, U1.2 (OSCI), Y1.1
unnamed: C5.1, U1.3 (OSCO), Y1.3
unnamed: R9.1, U1.6 (REF)
unnamed: R3.2, U1.14 (~RESET)
unnamed: R5.1, U3.4 (DO)
VBUS: C7.1, D1.4 (K), J1.A4 (VBUS), J1.A9 (VBUS), J1.B4 (VBUS), J1.B9 (VBUS), U8.3 (VI)
VCC: C8.1, C10.1, C11.1, C12.1, C13.1, C14.1, C19.1, C23.1, C24.1, R1.1, R2.1, R3.1, R6.1, R7.1, R8.1, R13.1, R14.1, U1.20 (VCCIO), U1.31 (VCCIO), U1.42 (VCCIO), U1.50 (VREGIN), U1.56 (VCCIO), U2.6 (VCCIO1), U2.23 (VCCIO1), U3.8 (VCC), U4.1 (VIN), U4.3 (EN), U8.2 (VO)
VIO: C27.1, C28.1, D5.2 (A), J2.2, J2.3, J3.2, J3.3, U2.39 (VCCIO2), U2.57 (VCCIO2)
V_ECORE: C25.1, C26.1, U2.8 (VCCINT), U2.41 (VCCINT), U4.5 (VOUT)
V_FCORE: C3.1, C15.1, C16.1, C17.1, U1.12 (VCORE), U1.37 (VCORE), U1.49 (VREGOUT), U1.64 (VCORE)

Notes on the sheet:
THIS ESD DIODE DOESN'T WORK FOR USB AT LEAST!

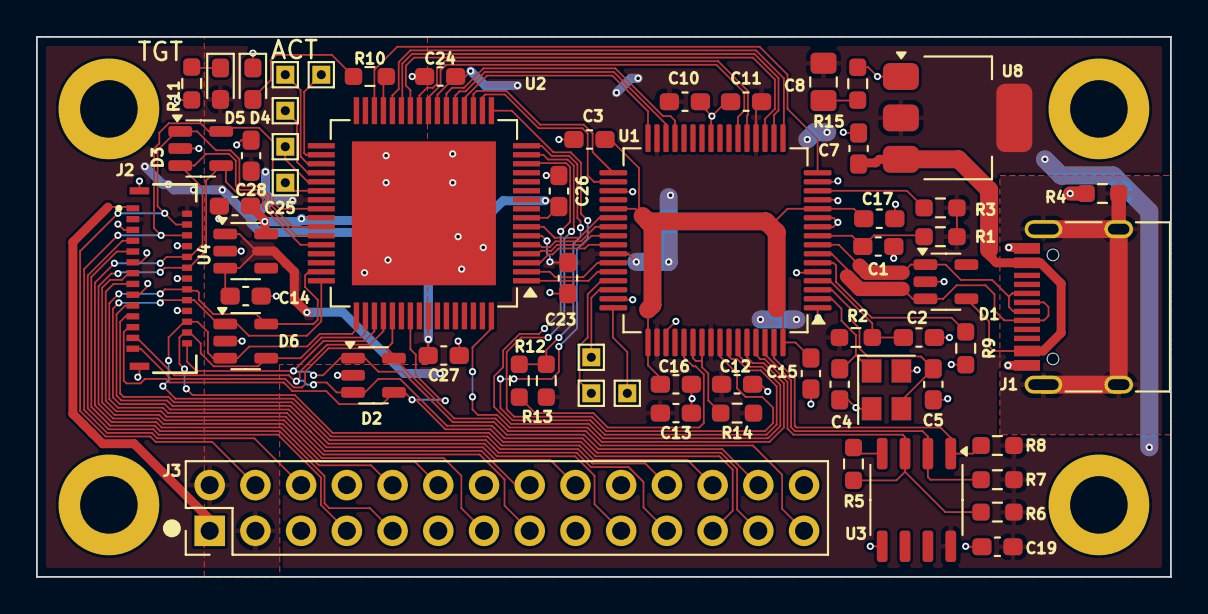
[picture p30: board programmer2.kicad_pcb from above]

Board: 2 copper layers, 63.0 x 30.0 mm, 64 parts (0 on the bottom side), 74 nets.
