andrastantos/unic/board_rp/unic_rp.kicad_pcb

## KiCad design board_rp/unic_rp.kicad_pcb (2024-09-04)

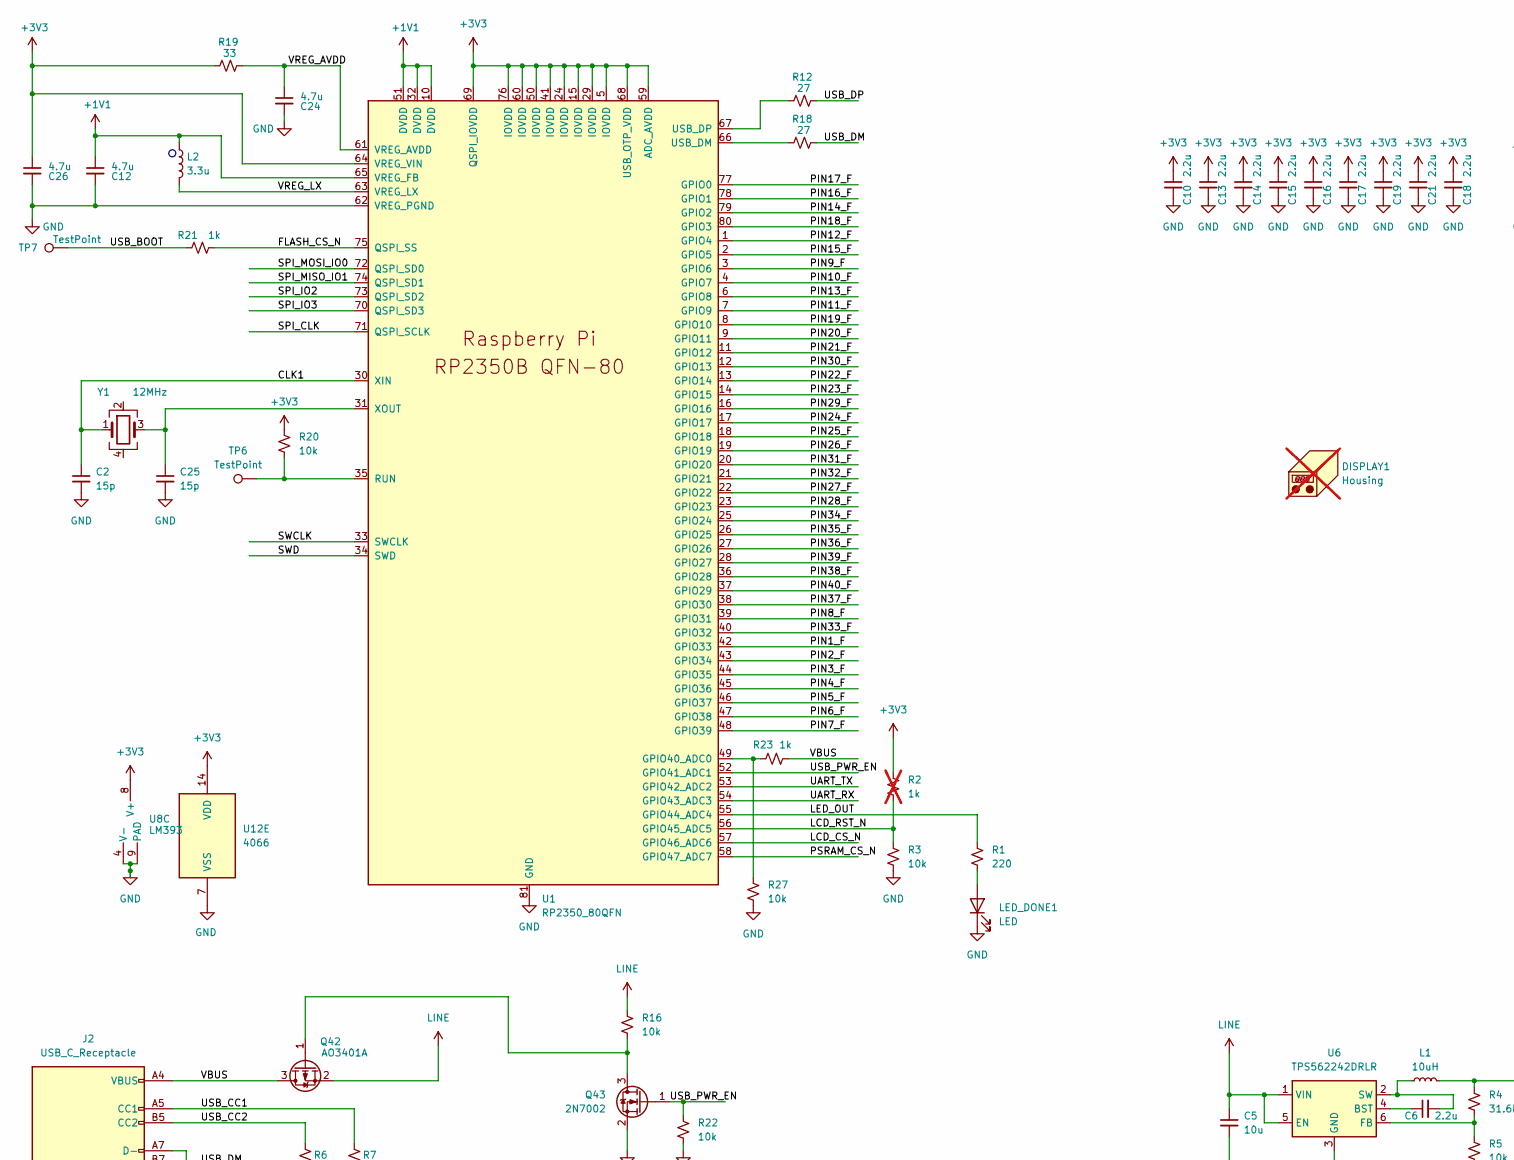
[picture p31: schematic unic_rp.kicad_sch, UNIC 40, part in row 1, column 1]

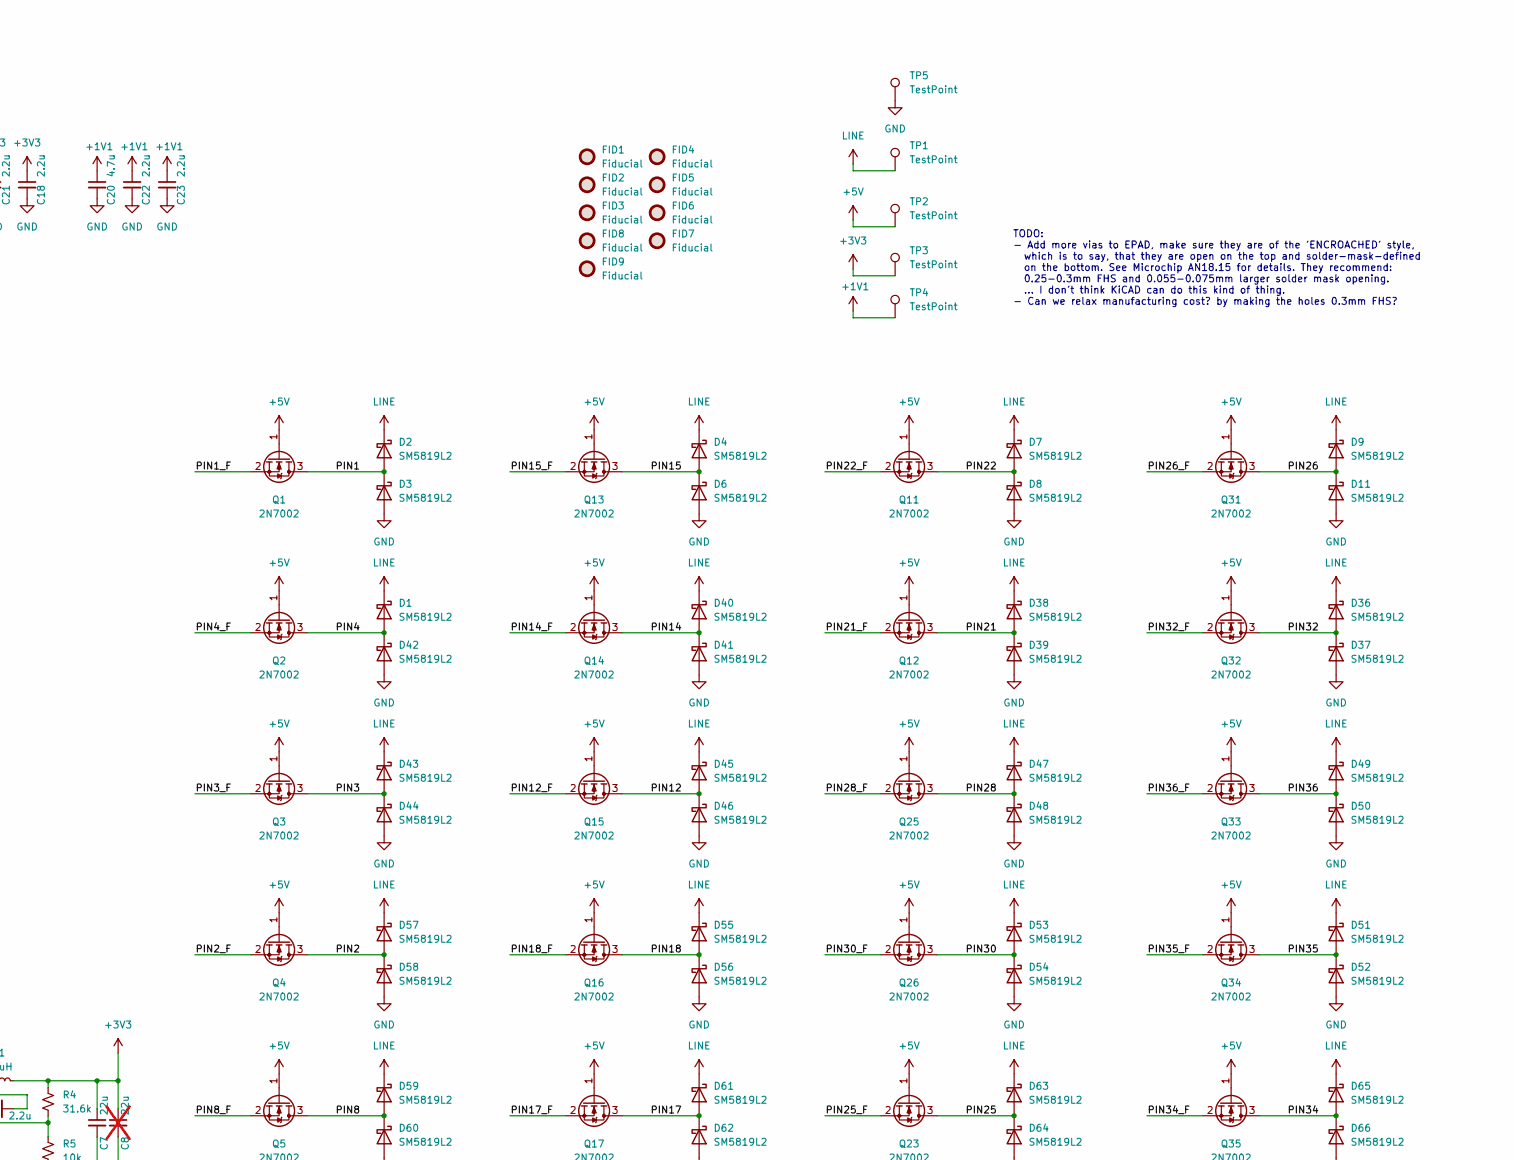
[picture p32: schematic unic_rp.kicad_sch, UNIC 40, part in row 1, column 2]

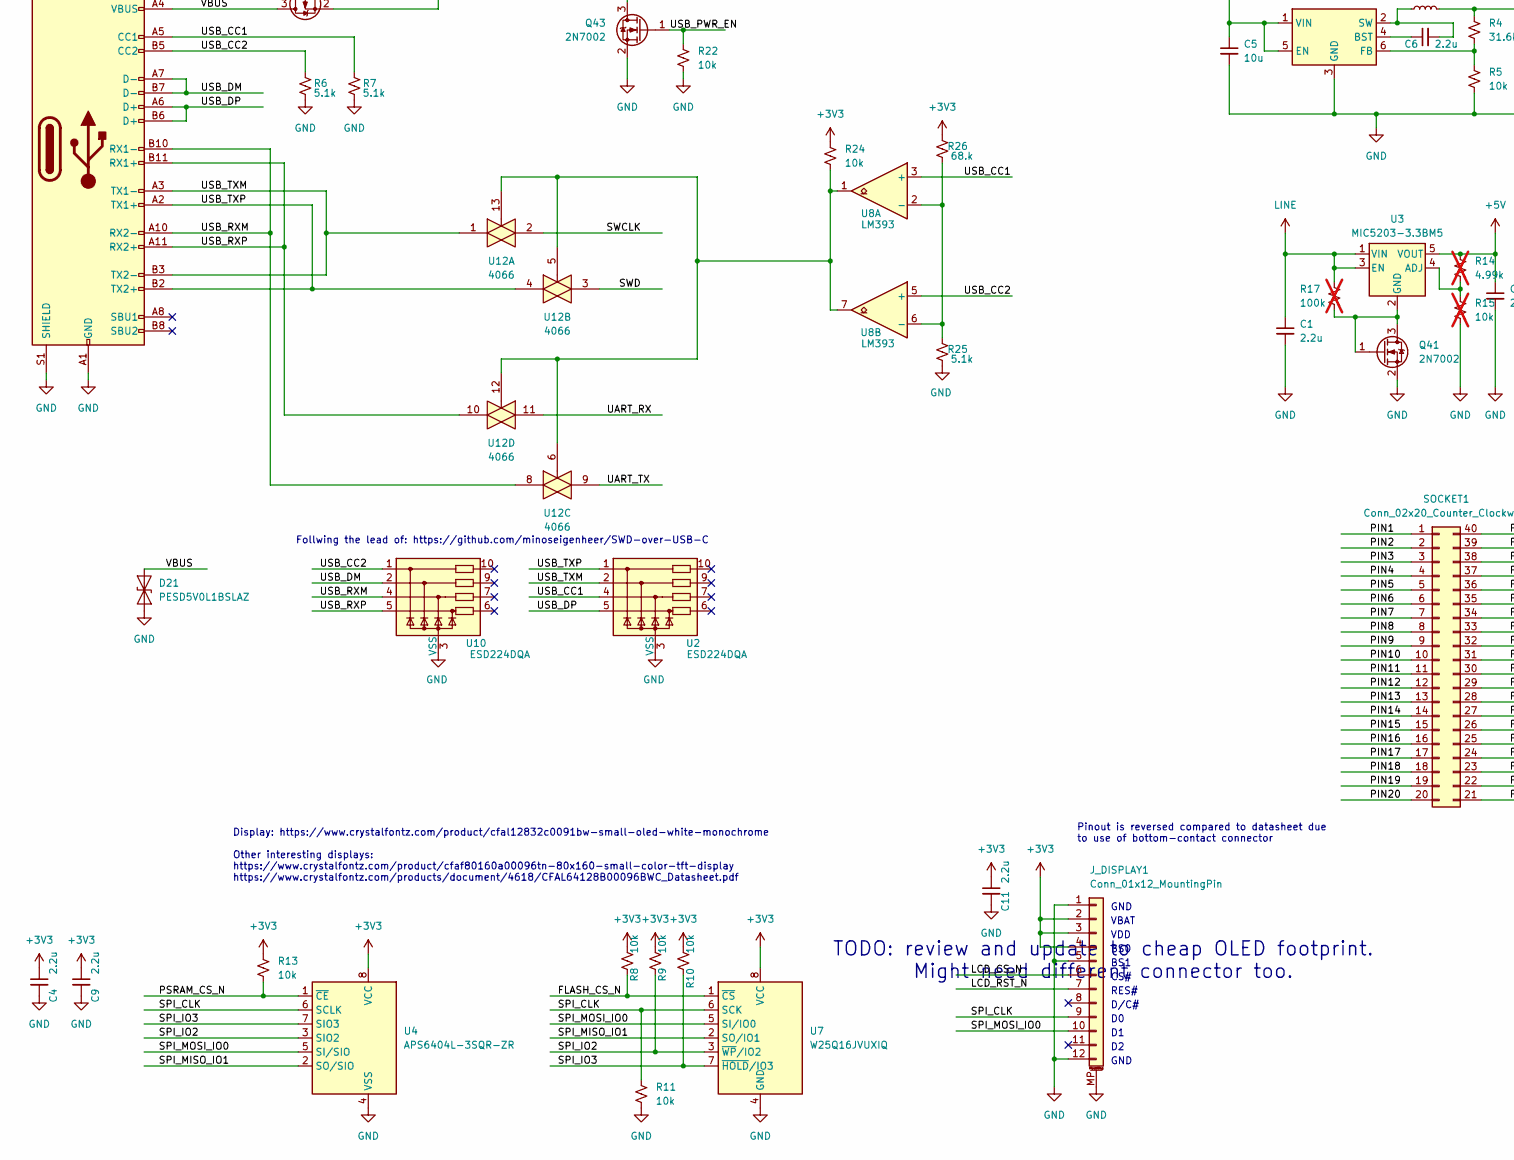
[picture p33: schematic unic_rp.kicad_sch, UNIC 40, part in row 2, column 1]

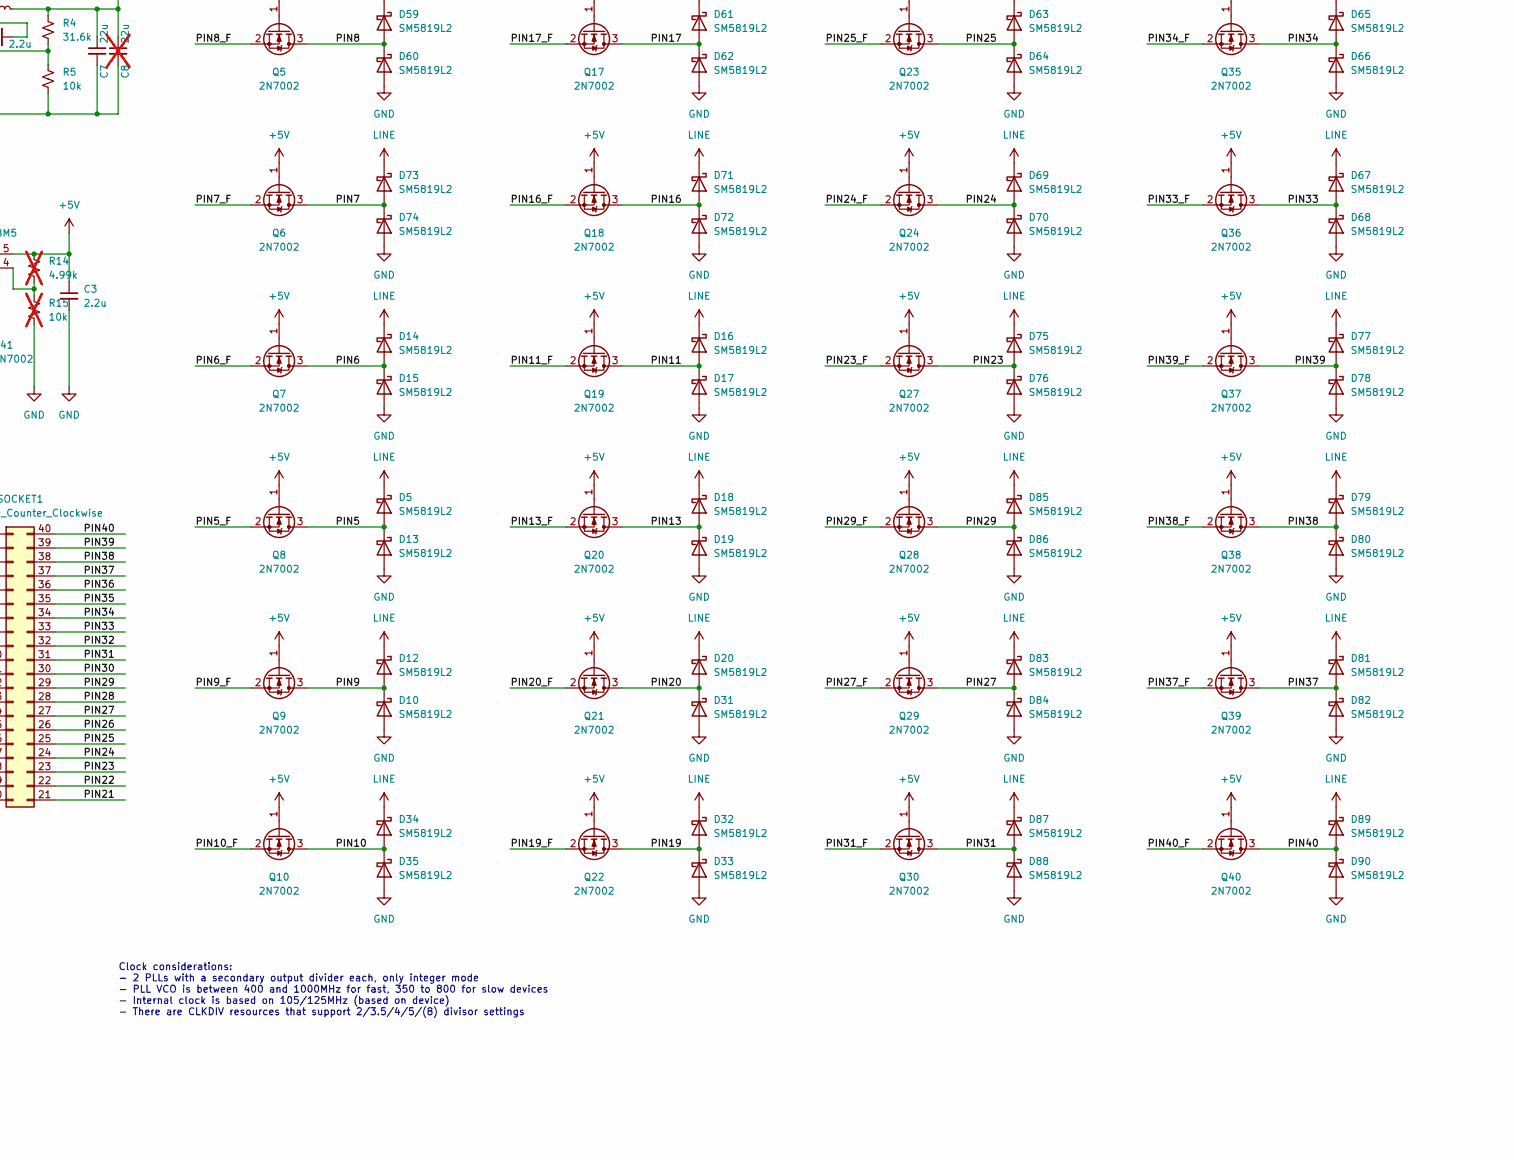
[picture p34: schematic unic_rp.kicad_sch, UNIC 40, part in row 2, column 2]

Parts:
C1, C3, C4, C6, C9, C10, C11, C13, C14, C15, C16, C17, C18, C19, C21, C22, C23: 2.2u; C_0402_1005Metric_Pad0.74x0.62mm_HandSolder; mpn CC0402MRX5R6BB225
C2, C25: 15p; C_0402_1005Metric_Pad0.74x0.62mm_HandSolder
C5: 10u; C_0805_2012Metric_Pad1.18x1.45mm_HandSolder; mpn CL21A106KAYNNNG
C7: 22u; C_0805_2012Metric_Pad1.18x1.45mm_HandSolder; mpn CL21A226MQQNNNE
C8: 22u; C_0805_2012Metric_Pad1.18x1.45mm_HandSolder; mpn CL21A226MQQNNNE; not fitted
C12, C20, C24, C26: 4.7u; C_0402_1005Metric_Pad0.74x0.62mm_HandSolder
D1, D2, D3, D4, D5, D6, D7, D8, D9, D10, D11, D12, D13, D14, D15, D16, D17, D18, D19, D20, D31, D32, D33, D34, D35, D36, D37, D38, D39, D40, D41, D42, D43, D44, D45, D46, D47, D48, D49, D50, D51, D52, D53, D54, D55, D56, D57, D58, D59, D60, D61, D62, D63, D64, D65, D66, D67, D68, D69, D70, D71, D72, D73, D74, D75, D76, D77, D78, D79, D80, D81, D82, D83, D84, D85, D86, D87, D88, D89, D90: SM5819L2; D_SOD-882
D21: PESD5V0L1BSLAZ; D_SOD-882
DISPLAY1: Housing; CFAL12832C-0091B-W_A; mpn CFAL12832C-0091B-W_A; not fitted
FID1, FID2, FID3, FID4, FID5, FID6, FID7, FID8, FID9: Fiducial; Fiducial_0.5mm_Mask1mm
J2: USB_C_Receptacle; USB_C_Receptacle_GCT_USB4115-03-C
J_DISPLAY1: Conn_01x12_MountingPin; CF31121D0R0-05-NH; mpn CF31121D0R0-05-NH
L1: 10uH; L_1008_2520Metric_Pad1.43x2.20mm_HandSolder; mpn UHP 252012BF-100M
L2: 3.3u; L_Cenker_CKCS201610; mpn WIP201610S-4R7MLDG
LED_DONE1: LED; LED_0402_1005Metric_Pad0.77x0.64mm_HandSolder; mpn CS42C-QL4
Q1, Q2, Q3, Q4, Q5, Q6, Q7, Q8, Q9, Q10, Q11, Q12, Q13, Q14, Q15, Q16, Q17, Q18, Q19, Q20, Q21, Q22, Q23, Q24, Q25, Q26, Q27, Q28, Q29, Q30, Q31, Q32, Q33, Q34, Q35, Q36, Q37, Q38, Q39, Q40, Q41, Q43: 2N7002; SOT-883; mpn 2N7002KL3A-TP
Q42: AO3401A; SOT-23
R1: 220; R_0402_1005Metric_Pad0.72x0.64mm_HandSolder; mpn CR0402-JW-221GLF
R2: 1k; R_0402_1005Metric_Pad0.72x0.64mm_HandSolder; mpn CR0402-JW-102GLF; not fitted
R3, R5, R8, R9, R10, R11, R13, R16, R20, R22, R24, R27: 10k; R_0402_1005Metric_Pad0.72x0.64mm_HandSolder; mpn CR0402-FX-1002GLF
R4: 31.6k; R_0402_1005Metric_Pad0.72x0.64mm_HandSolder; mpn CR0402-FX-3162GLF
R6, R7, R25: 5.1k; R_0402_1005Metric_Pad0.72x0.64mm_HandSolder
R12, R18: 27; R_0402_1005Metric_Pad0.72x0.64mm_HandSolder
R14: 4.99k; R_0402_1005Metric_Pad0.72x0.64mm_HandSolder; mpn CR0402-FX-4991GLF; not fitted
R15: 10k; R_0402_1005Metric_Pad0.72x0.64mm_HandSolder; mpn CR0402-FX-1002GLF; not fitted
R17: 100k; R_0402_1005Metric_Pad0.72x0.64mm_HandSolder; mpn CR0402-FX-1002GLF; not fitted
R19: 33; R_0402_1005Metric_Pad0.72x0.64mm_HandSolder
R21: 1k; R_0402_1005Metric_Pad0.72x0.64mm_HandSolder
R23: 1k; R_0402_1005Metric_Pad0.72x0.64mm_HandSolder; mpn CR0402-JW-102GLF
R26: 68.k; R_0402_1005Metric_Pad0.72x0.64mm_HandSolder
SOCKET1: Conn_02x20_Counter_Clockwise; DIP-40_pin_header; mpn BA3760-TUBL-4A-F5
TP1, TP2, TP3, TP4, TP5, TP6, TP7: TestPoint; TestPoint_Pad_D2.0mm
U1: RP2350_80QFN; RP2350-QFN-80-1EP_10x10_P0.4mm_EP3.4x3.4mm
U2, U10: ESD224DQA; Diodes_UDFN-10_1.0x2.5mm_P0.5mm; mpn TVU1240R1ADG
U3: MIC5203-3.3BM5; SOT-23-5; mpn MIC5203-3.3YM5-TR
U4: APS6404L-3SQR-ZR; W25Q16JVUXIQ_TR; mpn APS6404L-3SQR-ZR
U6: TPS562242DRLR; SOT-563; mpn AP62150Z6-7
U7: W25Q16JVUXIQ; W25Q16JVUXIQ_TR; mpn W25Q16JVUXIQ TR
U8: LM393; WSON-8-1EP_2x2mm_P0.5mm_EP0.9x1.6mm; mpn LM393BIDSGR
U12: 4066; DHVQFN-14-1EP_2.5x3mm_P0.5mm_EP1x1.5mm; mpn 74HC4066BQ,115
Y1: 12MHz; Oscillator_SMD_Abracon_ASE-4Pin_3.2x2.5mm; mpn RH100-13.560-10-1020-EXT-TR

Connections:
+1V1: C12.1, C20.1, C22.1, C23.1, L2.1, TP4.1, U1.10 (DVDD), U1.32 (DVDD), U1.51 (DVDD), U1.65 (VREG_FB)
+3V3: C4.1, C7.1, C8.1, C9.1, C10.1, C11.1, C13.1, C14.1, C15.1, C16.1, C17.1, C18.1, C19.1, C21.1, C26.1, J_DISPLAY1.2, J_DISPLAY1.3, J_DISPLAY1.4, L1.2, R2.1, R4.1, R8.1, R9.1, R10.1, R13.1, R19.1, R20.1, R24.1, R26.2, TP3.1, U1.5 (IOVDD), U1.15 (IOVDD), U1.24 (IOVDD), U1.29 (IOVDD), U1.41 (IOVDD), U1.50 (IOVDD), U1.59 (ADC_AVDD), U1.60 (IOVDD), U1.64 (VREG_VIN), U1.68 (USB_OTP_VDD), U1.69 (QSPI_IOVDD), U1.76 (IOVDD), U4.8 (VCC), U7.8 (VCC), U8.8 (V+), U12.14 (VDD)
+5V: C3.1, Q1.1 (G), Q2.1 (G), Q3.1 (G), Q4.1 (G), Q5.1 (G), Q6.1 (G), Q7.1 (G), Q8.1 (G), Q9.1 (G), Q10.1 (G), Q11.1 (G), Q12.1 (G), Q13.1 (G), Q14.1 (G), Q15.1 (G), Q16.1 (G), Q17.1 (G), Q18.1 (G), Q19.1 (G), Q20.1 (G), Q21.1 (G), Q22.1 (G), Q23.1 (G), Q24.1 (G), Q25.1 (G), Q26.1 (G), Q27.1 (G), Q28.1 (G), Q29.1 (G), Q30.1 (G), Q31.1 (G), Q32.1 (G), Q33.1 (G), Q34.1 (G), Q35.1 (G), Q36.1 (G), Q37.1 (G), Q38.1 (G), Q39.1 (G), Q40.1 (G), R14.1, TP2.1, U3.5 (VOUT)
/CLK1: C2.1, U1.30 (XIN), Y1.1
/FLASH_CS_N: R8.2, R21.2, U1.75 (QSPI_SS), U7.1 (~CS)
/LCD_CS_N: J_DISPLAY1.6, U1.57 (GPIO46_ADC6)
/LCD_RST_N: J_DISPLAY1.7, R2.2, R3.1, U1.56 (GPIO45_ADC5)
/LED_OUT: R1.1, U1.55 (GPIO44_ADC4)
/PIN1: D2.2 (A), D3.1 (K), Q1.3 (D), SOCKET1.1
/PIN1_F: Q1.2 (S), U1.42 (GPIO33)
/PIN2: D57.2 (A), D58.1 (K), Q4.3 (D), SOCKET1.2
/PIN2_F: Q4.2 (S), U1.43 (GPIO34)
/PIN3: D43.2 (A), D44.1 (K), Q3.3 (D), SOCKET1.3
/PIN3_F: Q3.2 (S), U1.44 (GPIO35)
/PIN4: D1.2 (A), D42.1 (K), Q2.3 (D), SOCKET1.4
/PIN4_F: Q2.2 (S), U1.45 (GPIO36)
/PIN5: D5.2 (A), D13.1 (K), Q8.3 (D), SOCKET1.5
/PIN5_F: Q8.2 (S), U1.46 (GPIO37)
/PIN6: D14.2 (A), D15.1 (K), Q7.3 (D), SOCKET1.6
/PIN6_F: Q7.2 (S), U1.47 (GPIO38)
/PIN7: D73.2 (A), D74.1 (K), Q6.3 (D), SOCKET1.7
/PIN7_F: Q6.2 (S), U1.48 (GPIO39)
/PIN8: D59.2 (A), D60.1 (K), Q5.3 (D), SOCKET1.8
/PIN8_F: Q5.2 (S), U1.39 (GPIO31)
/PIN9: D10.1 (K), D12.2 (A), Q9.3 (D), SOCKET1.9
/PIN9_F: Q9.2 (S), U1.3 (GPIO6)
/PIN10: D34.2 (A), D35.1 (K), Q10.3 (D), SOCKET1.10
/PIN10_F: Q10.2 (S), U1.4 (GPIO7)
/PIN11: D16.2 (A), D17.1 (K), Q19.3 (D), SOCKET1.11
/PIN11_F: Q19.2 (S), U1.7 (GPIO9)
/PIN12: D45.2 (A), D46.1 (K), Q15.3 (D), SOCKET1.12
/PIN12_F: Q15.2 (S), U1.1 (GPIO4)
/PIN13: D18.2 (A), D19.1 (K), Q20.3 (D), SOCKET1.13
/PIN13_F: Q20.2 (S), U1.6 (GPIO8)
/PIN14: D40.2 (A), D41.1 (K), Q14.3 (D), SOCKET1.14
/PIN14_F: Q14.2 (S), U1.79 (GPIO2)
/PIN15: D4.2 (A), D6.1 (K), Q13.3 (D), SOCKET1.15
/PIN15_F: Q13.2 (S), U1.2 (GPIO5)
/PIN16: D71.2 (A), D72.1 (K), Q18.3 (D), SOCKET1.16
/PIN16_F: Q18.2 (S), U1.78 (GPIO1)
/PIN17: D61.2 (A), D62.1 (K), Q17.3 (D), SOCKET1.17
/PIN17_F: Q17.2 (S), U1.77 (GPIO0)
/PIN18: D55.2 (A), D56.1 (K), Q16.3 (D), SOCKET1.18
/PIN18_F: Q16.2 (S), U1.80 (GPIO3)
/PIN19: D32.2 (A), D33.1 (K), Q22.3 (D), SOCKET1.19
/PIN19_F: Q22.2 (S), U1.8 (GPIO10)
/PIN20: D20.2 (A), D31.1 (K), Q21.3 (D), SOCKET1.20
/PIN20_F: Q21.2 (S), U1.9 (GPIO11)
/PIN21: D38.2 (A), D39.1 (K), Q12.3 (D), SOCKET1.21
/PIN21_F: Q12.2 (S), U1.11 (GPIO12)
/PIN22: D7.2 (A), D8.1 (K), Q11.3 (D), SOCKET1.22
/PIN22_F: Q11.2 (S), U1.13 (GPIO14)
/PIN23: D75.2 (A), D76.1 (K), Q27.3 (D), SOCKET1.23
/PIN23_F: Q27.2 (S), U1.14 (GPIO15)
/PIN24: D69.2 (A), D70.1 (K), Q24.3 (D), SOCKET1.24
/PIN24_F: Q24.2 (S), U1.17 (GPIO17)
/PIN25: D63.2 (A), D64.1 (K), Q23.3 (D), SOCKET1.25
/PIN25_F: Q23.2 (S), U1.18 (GPIO18)
/PIN26: D9.2 (A), D11.1 (K), Q31.3 (D), SOCKET1.26
/PIN26_F: Q31.2 (S), U1.19 (GPIO19)
/PIN27: D83.2 (A), D84.1 (K), Q29.3 (D), SOCKET1.27
/PIN27_F: Q29.2 (S), U1.22 (GPIO22)
/PIN28: D47.2 (A), D48.1 (K), Q25.3 (D), SOCKET1.28
/PIN28_F: Q25.2 (S), U1.23 (GPIO23)
/PIN29: D85.2 (A), D86.1 (K), Q28.3 (D), SOCKET1.29
/PIN29_F: Q28.2 (S), U1.16 (GPIO16)
/PIN30: D53.2 (A), D54.1 (K), Q26.3 (D), SOCKET1.30
/PIN30_F: Q26.2 (S), U1.12 (GPIO13)
/PIN31: D87.2 (A), D88.1 (K), Q30.3 (D), SOCKET1.31
/PIN31_F: Q30.2 (S), U1.20 (GPIO20)
/PIN32: D36.2 (A), D37.1 (K), Q32.3 (D), SOCKET1.32
/PIN32_F: Q32.2 (S), U1.21 (GPIO21)
/PIN33: D67.2 (A), D68.1 (K), Q36.3 (D), SOCKET1.33
/PIN33_F: Q36.2 (S), U1.40 (GPIO32)
/PIN34: D65.2 (A), D66.1 (K), Q35.3 (D), SOCKET1.34
/PIN34_F: Q35.2 (S), U1.25 (GPIO24)
/PIN35: D51.2 (A), D52.1 (K), Q34.3 (D), SOCKET1.35
/PIN35_F: Q34.2 (S), U1.26 (GPIO25)
/PIN36: D49.2 (A), D50.1 (K), Q33.3 (D), SOCKET1.36
/PIN36_F: Q33.2 (S), U1.27 (GPIO26)
/PIN37: D81.2 (A), D82.1 (K), Q39.3 (D), SOCKET1.37
/PIN37_F: Q39.2 (S), U1.38 (GPIO30)
/PIN38: D79.2 (A), D80.1 (K), Q38.3 (D), SOCKET1.38
/PIN38_F: Q38.2 (S), U1.36 (GPIO28)
/PIN39: D77.2 (A), D78.1 (K), Q37.3 (D), SOCKET1.39
/PIN39_F: Q37.2 (S), U1.28 (GPIO27)
/PIN40: D89.2 (A), D90.1 (K), Q40.3 (D), SOCKET1.40
/PIN40_F: Q40.2 (S), U1.37 (GPIO29)
/PSRAM_CS_N: R13.2, U1.58 (GPIO47_ADC7), U4.1 (~CE)
/SPI_CLK: J_DISPLAY1.9, R11.1, U1.71 (QSPI_SCLK), U4.6 (SCLK), U7.6 (SCK)
/SPI_IO2: R9.2, U1.73 (QSPI_SD2), U4.3 (SIO2), U7.3 (~WP/IO2)
/SPI_IO3: R10.2, U1.70 (QSPI_SD3), U4.7 (SIO3), U7.7 (~HOLD/IO3)
/SPI_MISO_IO1: U1.74 (QSPI_SD1), U4.2 (SO/SIO), U7.2 (SO/IO1)
/SPI_MOSI_IO0: J_DISPLAY1.10, U1.72 (QSPI_SD0), U4.5 (SI/SIO), U7.5 (SI/IO0)
/SWCLK: U1.33 (SWCLK), U12.2
/SWD: U1.34 (SWD), U12.3
/UART_RX: U1.54 (GPIO43_ADC3), U12.11
/UART_TX: U1.53 (GPIO42_ADC2), U12.9
/USB_BOOT: R21.1, TP7.1
/USB_CC1: J2.A5 (CC1), R7.2, U2.4, U8.3 (+)
/USB_CC2: J2.B5 (CC2), R6.2, U8.5 (+), U10.1
/USB_DM: J2.A7 (D-), J2.B7 (D-), R18.2, U10.2
/USB_DP: J2.A6 (D+), J2.B6 (D+), R12.2, U2.5
/USB_PWR_EN: Q43.1 (G), R22.1, U1.52 (GPIO41_ADC1)
/USB_RXM: J2.A10 (RX2-), J2.B10 (RX1-), U10.4, U12.8
/USB_RXP: J2.A11 (RX2+), J2.B11 (RX1+), U10.5, U12.10
/USB_TXM: J2.A3 (TX1-), J2.B3 (TX2-), U2.2, U12.1
/USB_TXP: J2.A2 (TX1+), J2.B2 (TX2+), U2.1, U12.4
/VBUS: D21.2 (A2), J2.A4 (VBUS), J2.A9 (VBUS), J2.B4 (VBUS), J2.B9 (VBUS), Q42.3 (D), R23.2
/VREG_AVDD: C24.1, R19.2, U1.61 (VREG_AVDD)
/VREG_LX: L2.2, U1.63 (VREG_LX)
GND: C1.2, C2.2, C3.2, C4.2, C5.2, C7.2, C8.2, C9.2, C10.2, C11.2, C12.2, C13.2, C14.2, C15.2, C16.2, C17.2, C18.2, C19.2, C20.2, C21.2, C22.2, C23.2, C24.2, C25.2, C26.2, D3.2 (A), D6.2 (A), D8.2 (A), D10.2 (A), D11.2 (A), D13.2 (A), D15.2 (A), D17.2 (A), D19.2 (A), D21.1 (A1), D31.2 (A), D33.2 (A), D35.2 (A), D37.2 (A), D39.2 (A), D41.2 (A), D42.2 (A), D44.2 (A), D46.2 (A), D48.2 (A), D50.2 (A), D52.2 (A), D54.2 (A), D56.2 (A), D58.2 (A), D60.2 (A), D62.2 (A), D64.2 (A), D66.2 (A), D68.2 (A), D70.2 (A), D72.2 (A), D74.2 (A), D76.2 (A), D78.2 (A), D80.2 (A), D82.2 (A), D84.2 (A), D86.2 (A), D88.2 (A), D90.2 (A), J2.A1 (GND), J2.A12 (GND), J2.B1 (GND), J2.B12 (GND), J2.S1 (SHIELD), J_DISPLAY1.1, J_DISPLAY1.5, J_DISPLAY1.12, J_DISPLAY1.MP (MountPin), LED_DONE1.1 (K), Q41.2 (S), Q43.2 (S), R3.2, R5.2, R6.1, R7.1, R11.2, R15.2, R22.2, R25.1, R27.2, TP5.1, U1.62 (VREG_PGND), U1.81 (GND), U2.3 (VSS), U2.8 (VSS), U4.4 (VSS), U6.3 (GND), U7.4 (GND), U8.4 (V-), U8.9 (PAD), U10.3 (VSS), U10.8 (VSS), U12.7 (VSS)
LINE: C1.1, C5.1, D1.1 (K), D2.1 (K), D4.1 (K), D5.1 (K), D7.1 (K), D9.1 (K), D12.1 (K), D14.1 (K), D16.1 (K), D18.1 (K), D20.1 (K), D32.1 (K), D34.1 (K), D36.1 (K), D38.1 (K), D40.1 (K), D43.1 (K), D45.1 (K), D47.1 (K), D49.1 (K), D51.1 (K), D53.1 (K), D55.1 (K), D57.1 (K), D59.1 (K), D61.1 (K), D63.1 (K), D65.1 (K), D67.1 (K), D69.1 (K), D71.1 (K), D73.1 (K), D75.1 (K), D77.1 (K), D79.1 (K), D81.1 (K), D83.1 (K), D85.1 (K), D87.1 (K), D89.1 (K), Q42.2 (S), R16.1, R17.1, TP1.1, U3.1 (VIN), U3.3 (EN), U6.1 (VIN), U6.5 (EN)
unnamed: LED_DONE1.2 (A), R1.2
unnamed: Q41.1 (G), Q41.3 (D), R17.2, U3.2 (GND)
unnamed: Q42.1 (G), Q43.3 (D), R16.2
unnamed: R24.2, U8.1, U8.7, U12.5, U12.6, U12.12, U12.13
unnamed: R23.1, R27.1, U1.49 (GPIO40_ADC0)
unnamed: R20.2, TP6.1, U1.35 (RUN)
unnamed: R18.1, U1.66 (USB_DM)
unnamed: R12.1, U1.67 (USB_DP)
unnamed: C25.1, U1.31 (XOUT), Y1.3
unnamed: R14.2, R15.1, U3.4 (ADJ)
unnamed: C6.1, U6.4 (BST)
unnamed: R4.2, R5.1, U6.6 (FB)
unnamed: C6.2, L1.1, U6.2 (SW)
unnamed: R25.2, R26.1, U8.2 (-), U8.6 (-)

Notes on the sheet:
Pinout is reversed compared to datasheet due to use of bottom-contact connector
CS#
Follwing the lead of: https://github.com/minoseigenheer/SWD-over-USB-C
TODO: - Add more vias to EPAD, make sure they are of the 'ENCROACHED' style, which is to say, that they are open on the top and solder-mask-defined on the bottom. See Microchip AN18.15 for details. They recommend: 0.25-0.3mm FHS and 0.055-0.075mm larger solder mask opening. ... I don't think KiCAD 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
GND
Clock considerations: - 2 PLLs with a secondary output divider each, only integer mode - PLL VCO is between 400 and 1000MHz for fast, 350 to 800 for slow devices - Internal clock is based on 105/125MHz (based on device) - There are CLKDIV resources that support 2/3.5/4/5/(8) divisor settings
VDD
RES#
BS1
TODO: review and update to cheap OLED footprint. Might need different connector too.
D/C#
Display: https://www.crystalfontz.com/product/cfal12832c0091bw-small-oled-white-monochrome Other interesting displays: https://www.crystalfontz.com/product/cfaf80160a00096tn-80x160-small-color-tft-display https://www.crystalfontz.com/products/document/4618/CFAL64128B00096BWC_Datasheet.pdf
BS0
VBAT

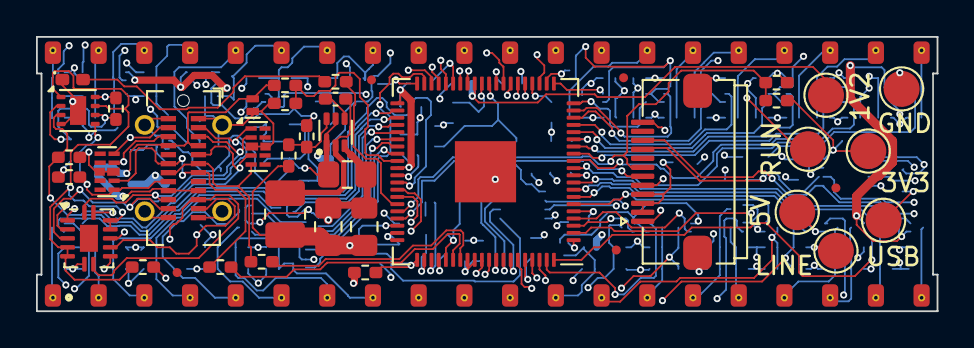
[picture p35: board unic_rp.kicad_pcb from above]

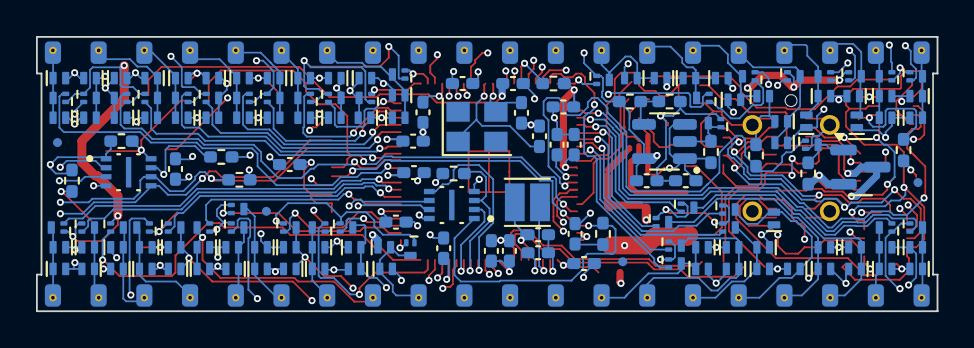
[picture p36: board unic_rp.kicad_pcb from below]

Board: 4 copper layers, 50.0 x 15.2 mm, 210 parts (167 on the bottom side), 127 nets.
