andrastantos/unic/shadow_tracer/shadow_tracer.kicad_pcb

## KiCad design shadow_tracer/shadow_tracer.kicad_pcb (2024-08-21)

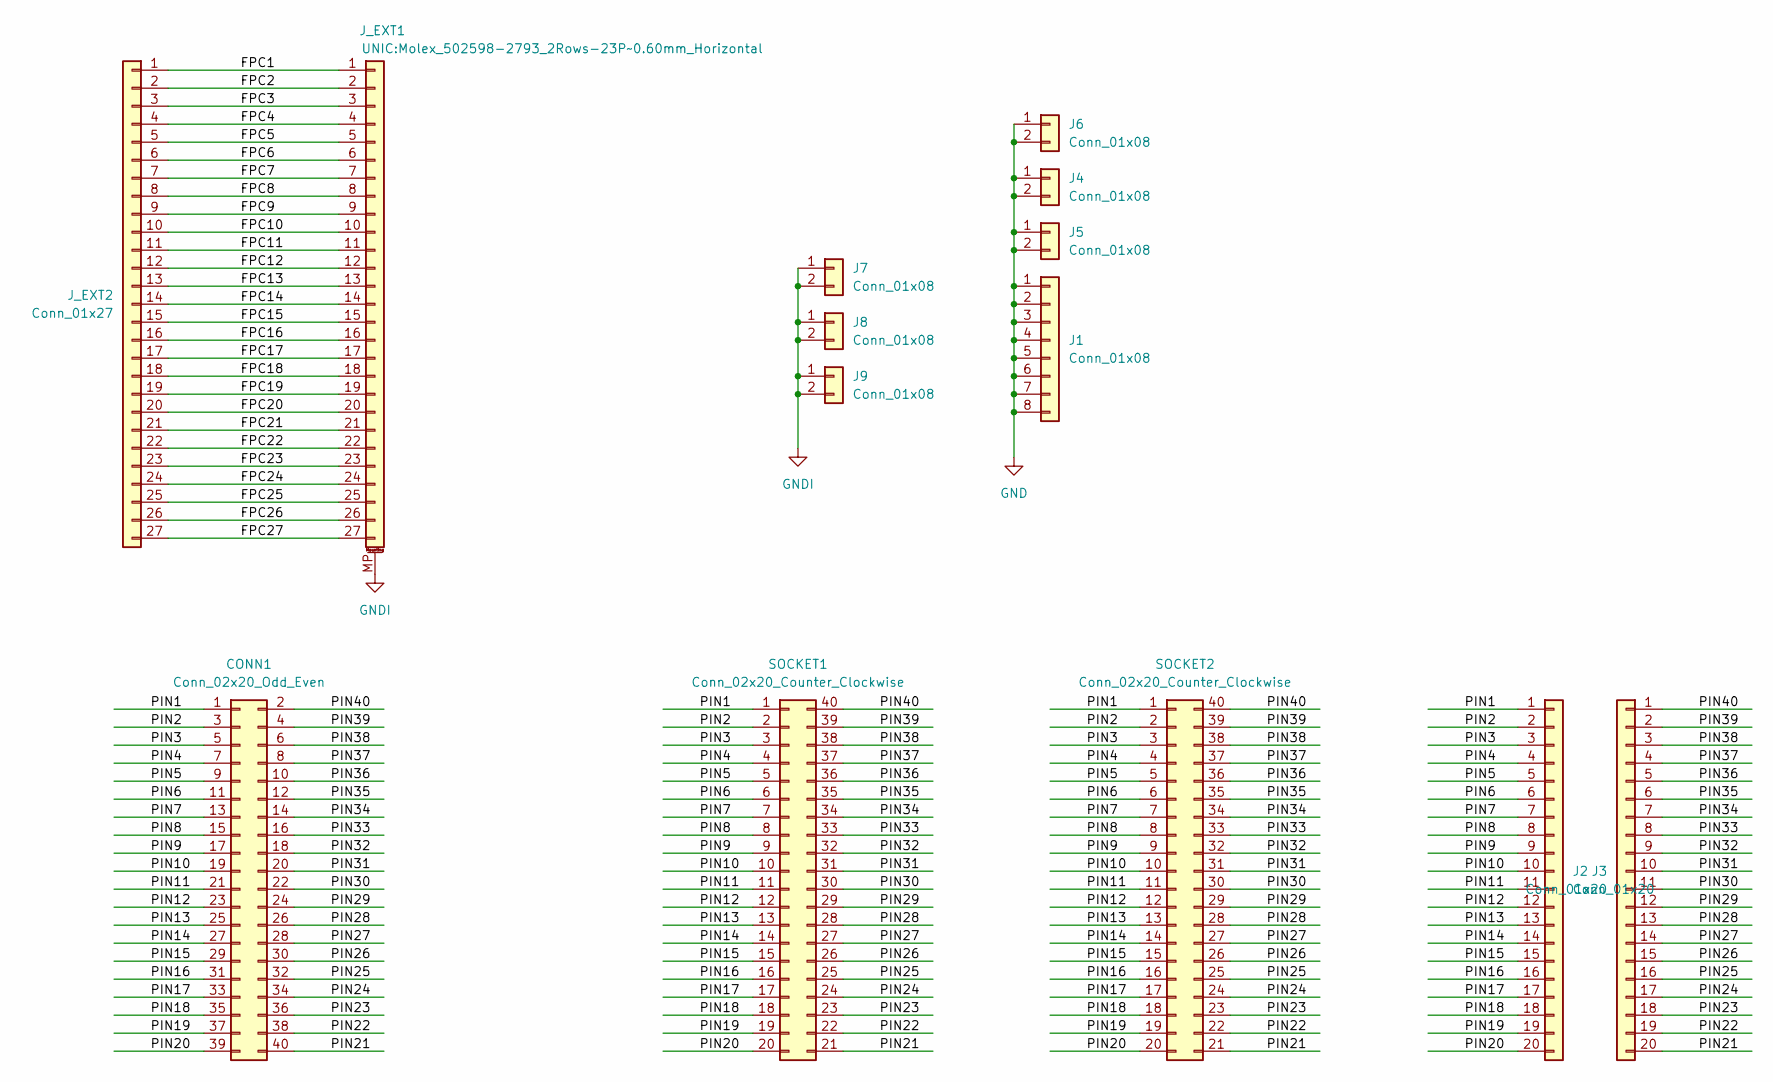
[picture p37: schematic shadow_tracer.kicad_sch, UNIC 40]

Parts:
CONN1: Conn_02x20_Odd_Even; PinSocket_2x20_P2.54mm_Horizontal
J1: Conn_01x08; PinHeader_1x08_P2.54mm_Vertical
J2, J3: Conn_01x20; PinHeader_1x20_P2.54mm_Vertical
J4, J5, J6, J7, J8, J9: Conn_01x08; PinHeader_1x02_P2.54mm_Vertical
J_EXT1: Conn_01x27_MountingPin; Molex_502598-2793_2Rows-23P~0.60mm_Horizontal
J_EXT2: Conn_01x27; PinHeader_2x14_P2.54mm_Vertical
SOCKET1, SOCKET2: Conn_02x20_Counter_Clockwise; DIP-40_W15.24mm_Socket_LongPads

Connections:
/FPC1: J_EXT1.1, J_EXT2.1
/FPC2: J_EXT1.2, J_EXT2.2
/FPC3: J_EXT1.3, J_EXT2.3
/FPC4: J_EXT1.4, J_EXT2.4
/FPC5: J_EXT1.5, J_EXT2.5
/FPC6: J_EXT1.6, J_EXT2.6
/FPC7: J_EXT1.7, J_EXT2.7
/FPC8: J_EXT1.8, J_EXT2.8
/FPC9: J_EXT1.9, J_EXT2.9
/FPC10: J_EXT1.10, J_EXT2.10
/FPC11: J_EXT1.11, J_EXT2.11
/FPC12: J_EXT1.12, J_EXT2.12
/FPC13: J_EXT1.13, J_EXT2.13
/FPC14: J_EXT1.14, J_EXT2.14
/FPC15: J_EXT1.15, J_EXT2.15
/FPC16: J_EXT1.16, J_EXT2.16
/FPC17: J_EXT1.17, J_EXT2.17
/FPC18: J_EXT1.18, J_EXT2.18
/FPC19: J_EXT1.19, J_EXT2.19
/FPC20: J_EXT1.20, J_EXT2.20
/FPC21: J_EXT1.21, J_EXT2.21
/FPC22: J_EXT1.22, J_EXT2.22
/FPC23: J_EXT1.23, J_EXT2.23
/FPC24: J_EXT1.24, J_EXT2.24
/FPC25: J_EXT1.25, J_EXT2.25
/FPC26: J_EXT1.26, J_EXT2.26
/FPC27: J_EXT1.27, J_EXT2.27
/PIN1: CONN1.1, J2.1, SOCKET1.1, SOCKET2.1
/PIN2: CONN1.3, J2.2, SOCKET1.2, SOCKET2.2
/PIN3: CONN1.5, J2.3, SOCKET1.3, SOCKET2.3
/PIN4: CONN1.7, J2.4, SOCKET1.4, SOCKET2.4
/PIN5: CONN1.9, J2.5, SOCKET1.5, SOCKET2.5
/PIN6: CONN1.11, J2.6, SOCKET1.6, SOCKET2.6
/PIN7: CONN1.13, J2.7, SOCKET1.7, SOCKET2.7
/PIN8: CONN1.15, J2.8, SOCKET1.8, SOCKET2.8
/PIN9: CONN1.17, J2.9, SOCKET1.9, SOCKET2.9
/PIN10: CONN1.19, J2.10, SOCKET1.10, SOCKET2.10
/PIN11: CONN1.21, J2.11, SOCKET1.11, SOCKET2.11
/PIN12: CONN1.23, J2.12, SOCKET1.12, SOCKET2.12
/PIN13: CONN1.25, J2.13, SOCKET1.13, SOCKET2.13
/PIN14: CONN1.27, J2.14, SOCKET1.14, SOCKET2.14
/PIN15: CONN1.29, J2.15, SOCKET1.15, SOCKET2.15
/PIN16: CONN1.31, J2.16, SOCKET1.16, SOCKET2.16
/PIN17: CONN1.33, J2.17, SOCKET1.17, SOCKET2.17
/PIN18: CONN1.35, J2.18, SOCKET1.18, SOCKET2.18
/PIN19: CONN1.37, J2.19, SOCKET1.19, SOCKET2.19
/PIN20: CONN1.39, J2.20, SOCKET1.20, SOCKET2.20
/PIN21: CONN1.40, J3.20, SOCKET1.21, SOCKET2.21
/PIN22: CONN1.38, J3.19, SOCKET1.22, SOCKET2.22
/PIN23: CONN1.36, J3.18, SOCKET1.23, SOCKET2.23
/PIN24: CONN1.34, J3.17, SOCKET1.24, SOCKET2.24
/PIN25: CONN1.32, J3.16, SOCKET1.25, SOCKET2.25
/PIN26: CONN1.30, J3.15, SOCKET1.26, SOCKET2.26
/PIN27: CONN1.28, J3.14, SOCKET1.27, SOCKET2.27
/PIN28: CONN1.26, J3.13, SOCKET1.28, SOCKET2.28
/PIN29: CONN1.24, J3.12, SOCKET1.29, SOCKET2.29
/PIN30: CONN1.22, J3.11, SOCKET1.30, SOCKET2.30
/PIN31: CONN1.20, J3.10, SOCKET1.31, SOCKET2.31
/PIN32: CONN1.18, J3.9, SOCKET1.32, SOCKET2.32
/PIN33: CONN1.16, J3.8, SOCKET1.33, SOCKET2.33
/PIN34: CONN1.14, J3.7, SOCKET1.34, SOCKET2.34
/PIN35: CONN1.12, J3.6, SOCKET1.35, SOCKET2.35
/PIN36: CONN1.10, J3.5, SOCKET1.36, SOCKET2.36
/PIN37: CONN1.8, J3.4, SOCKET1.37, SOCKET2.37
/PIN38: CONN1.6, J3.3, SOCKET1.38, SOCKET2.38
/PIN39: CONN1.4, J3.2, SOCKET1.39, SOCKET2.39
/PIN40: CONN1.2, J3.1, SOCKET1.40, SOCKET2.40
GND: J1.1, J1.2, J1.3, J1.4, J1.5, J1.6, J1.7, J1.8, J4.1, J4.2, J5.1, J5.2, J6.1, J6.2
GNDI: J7.1, J7.2, J8.1, J8.2, J9.1, J9.2, J_EXT1.MP (MountPin)

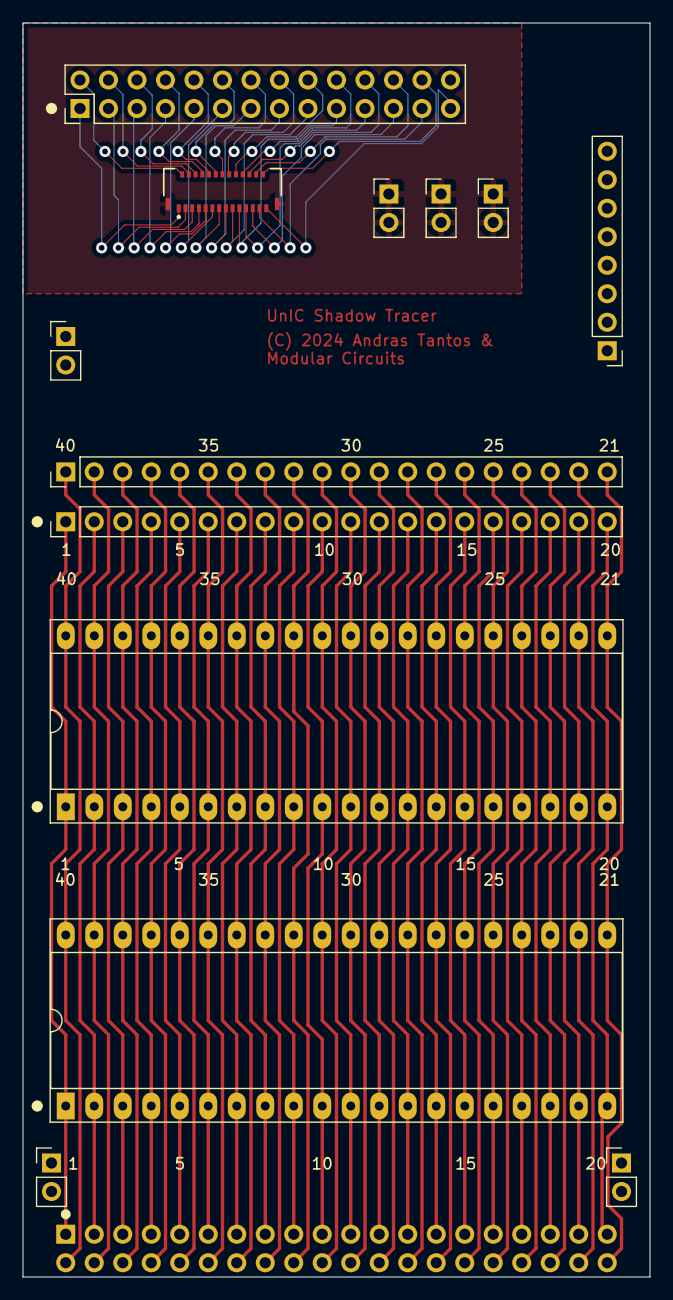
[picture p38: board shadow_tracer.kicad_pcb from above]

Board: 2 copper layers, 55.9 x 111.8 mm, 14 parts (0 on the bottom side), 69 nets.
