andrastantos/unic/diode_upgrade/diode_upgrade.kicad_pcb

## KiCad design diode_upgrade/diode_upgrade.kicad_pcb (2024-08-19)

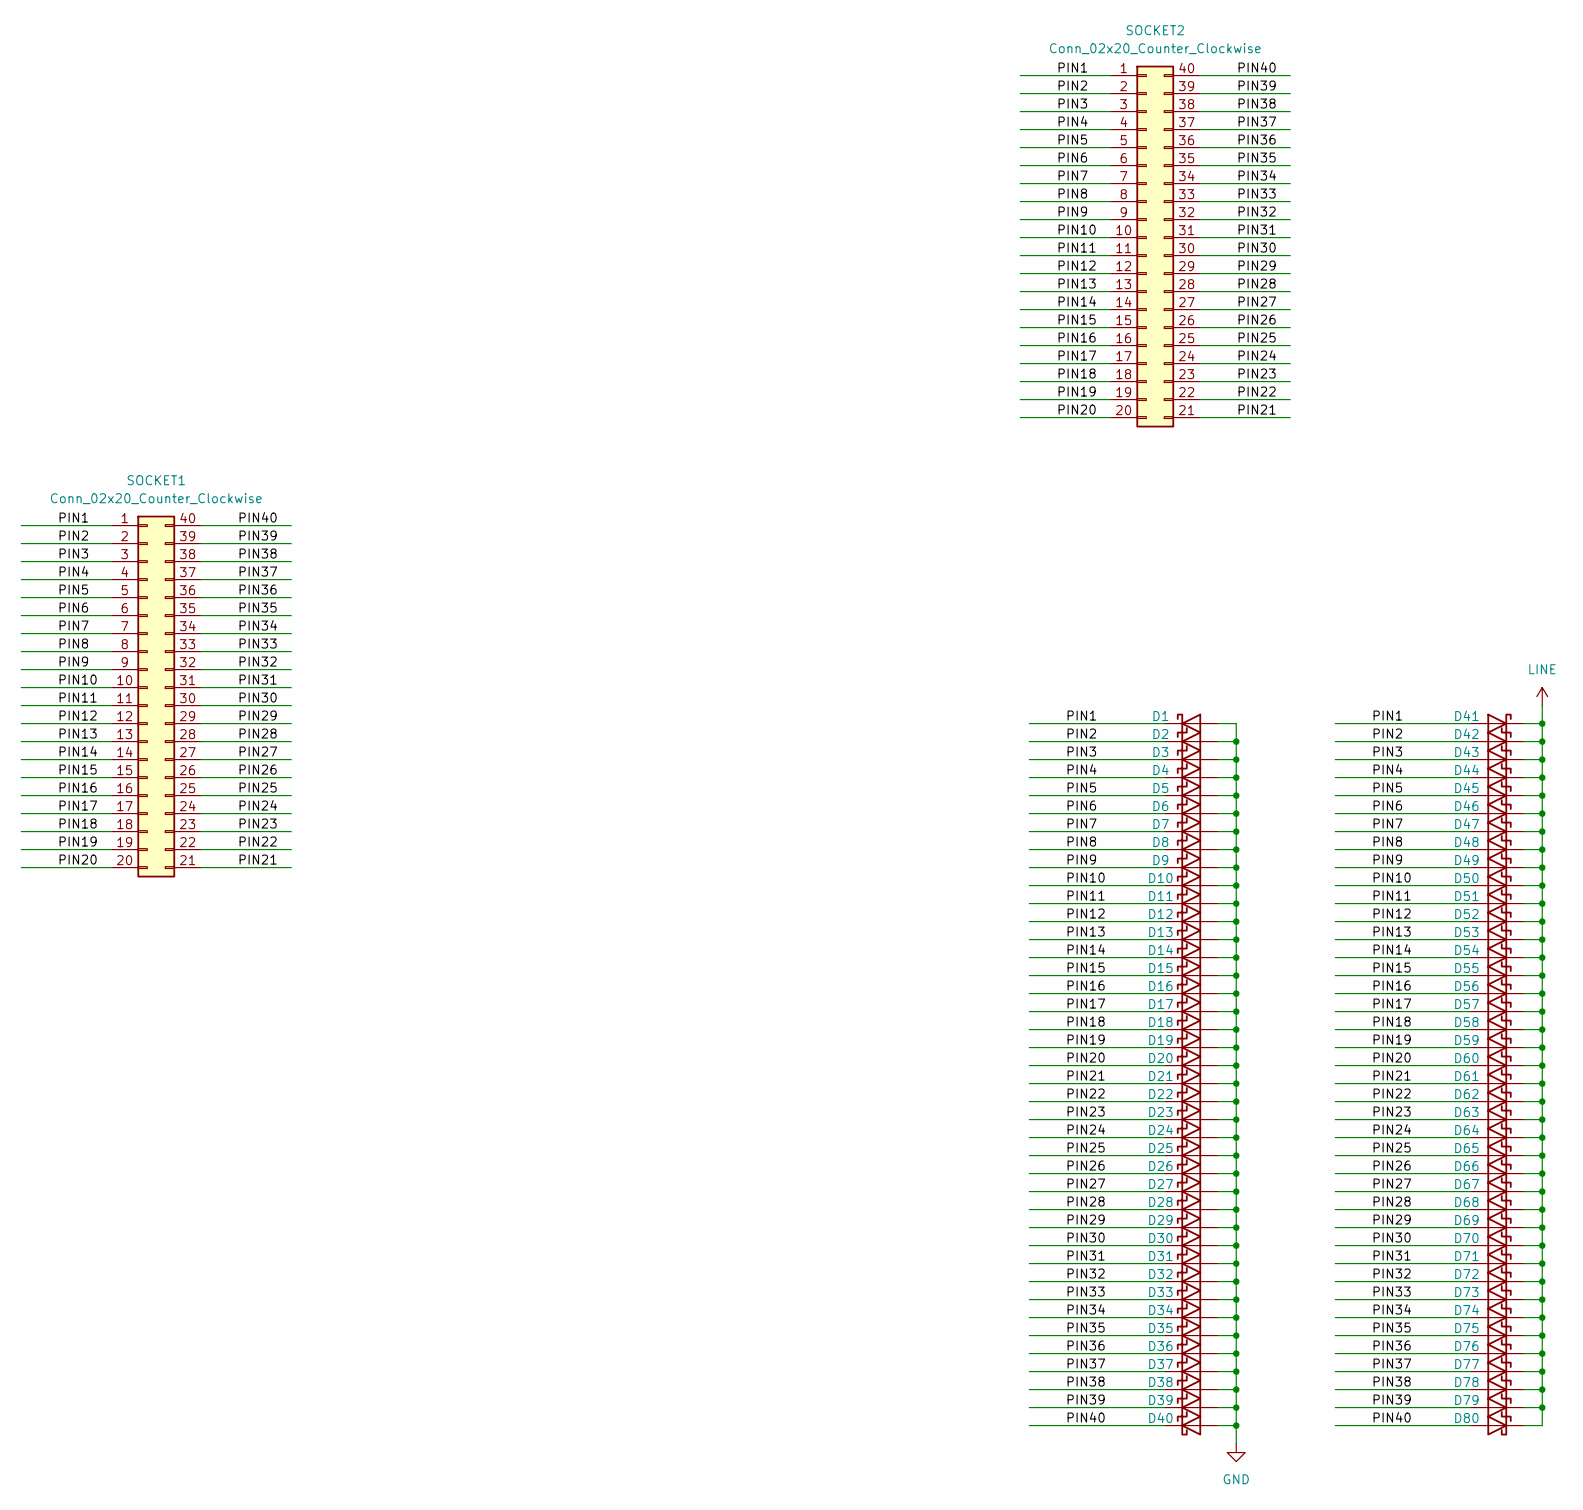
[picture p39: schematic diode_upgrade.kicad_sch, UNIC 40]

Parts:
D1, D2, D3, D4, D5, D6, D7, D8, D9, D10, D11, D12, D13, D14, D15, D16, D17, D18, D19, D20, D21, D22, D23, D24, D25, D26, D27, D28, D29, D30, D31, D32, D33, D34, D35, D36, D37, D38, D39, D40, D41, D42, D43, D44, D45, D46, D47, D48, D49, D50, D51, D52, D53, D54, D55, D56, D57, D58, D59, D60, D61, D62, D63, D64, D65, D66, D67, D68, D69, D70, D71, D72, D73, D74, D75, D76, D77, D78, D79, D80: D_Schottky; D_SOD-123; mpn SM5817PL-TP
SOCKET1: Conn_02x20_Counter_Clockwise; DIP-40_pin_header; mpn BA3760-TUBL-4A-F5
SOCKET2: Conn_02x20_Counter_Clockwise; DIP-40_W15.24mm_Socket_LongPads

Connections:
/PIN1: D1.1 (K), D41.2 (A), SOCKET1.1, SOCKET2.1
/PIN2: D2.1 (K), D42.2 (A), SOCKET1.2, SOCKET2.2
/PIN3: D3.1 (K), D43.2 (A), SOCKET1.3, SOCKET2.3
/PIN4: D4.1 (K), D44.2 (A), SOCKET1.4, SOCKET2.4
/PIN5: D5.1 (K), D45.2 (A), SOCKET1.5, SOCKET2.5
/PIN6: D6.1 (K), D46.2 (A), SOCKET1.6, SOCKET2.6
/PIN7: D7.1 (K), D47.2 (A), SOCKET1.7, SOCKET2.7
/PIN8: D8.1 (K), D48.2 (A), SOCKET1.8, SOCKET2.8
/PIN9: D9.1 (K), D49.2 (A), SOCKET1.9, SOCKET2.9
/PIN10: D10.1 (K), D50.2 (A), SOCKET1.10, SOCKET2.10
/PIN11: D11.1 (K), D51.2 (A), SOCKET1.11, SOCKET2.11
/PIN12: D12.1 (K), D52.2 (A), SOCKET1.12, SOCKET2.12
/PIN13: D13.1 (K), D53.2 (A), SOCKET1.13, SOCKET2.13
/PIN14: D14.1 (K), D54.2 (A), SOCKET1.14, SOCKET2.14
/PIN15: D15.1 (K), D55.2 (A), SOCKET1.15, SOCKET2.15
/PIN16: D16.1 (K), D56.2 (A), SOCKET1.16, SOCKET2.16
/PIN17: D17.1 (K), D57.2 (A), SOCKET1.17, SOCKET2.17
/PIN18: D18.1 (K), D58.2 (A), SOCKET1.18, SOCKET2.18
/PIN19: D19.1 (K), D59.2 (A), SOCKET1.19, SOCKET2.19
/PIN20: D20.1 (K), D60.2 (A), SOCKET1.20, SOCKET2.20
/PIN21: D21.1 (K), D61.2 (A), SOCKET1.21, SOCKET2.21
/PIN22: D22.1 (K), D62.2 (A), SOCKET1.22, SOCKET2.22
/PIN23: D23.1 (K), D63.2 (A), SOCKET1.23, SOCKET2.23
/PIN24: D24.1 (K), D64.2 (A), SOCKET1.24, SOCKET2.24
/PIN25: D25.1 (K), D65.2 (A), SOCKET1.25, SOCKET2.25
/PIN26: D26.1 (K), D66.2 (A), SOCKET1.26, SOCKET2.26
/PIN27: D27.1 (K), D67.2 (A), SOCKET1.27, SOCKET2.27
/PIN28: D28.1 (K), D68.2 (A), SOCKET1.28, SOCKET2.28
/PIN29: D29.1 (K), D69.2 (A), SOCKET1.29, SOCKET2.29
/PIN30: D30.1 (K), D70.2 (A), SOCKET1.30, SOCKET2.30
/PIN31: D31.1 (K), D71.2 (A), SOCKET1.31, SOCKET2.31
/PIN32: D32.1 (K), D72.2 (A), SOCKET1.32, SOCKET2.32
/PIN33: D33.1 (K), D73.2 (A), SOCKET1.33, SOCKET2.33
/PIN34: D34.1 (K), D74.2 (A), SOCKET1.34, SOCKET2.34
/PIN35: D35.1 (K), D75.2 (A), SOCKET1.35, SOCKET2.35
/PIN36: D36.1 (K), D76.2 (A), SOCKET1.36, SOCKET2.36
/PIN37: D37.1 (K), D77.2 (A), SOCKET1.37, SOCKET2.37
/PIN38: D38.1 (K), D78.2 (A), SOCKET1.38, SOCKET2.38
/PIN39: D39.1 (K), D79.2 (A), SOCKET1.39, SOCKET2.39
/PIN40: D40.1 (K), D80.2 (A), SOCKET1.40, SOCKET2.40
GND: D1.2 (A), D2.2 (A), D3.2 (A), D4.2 (A), D5.2 (A), D6.2 (A), D7.2 (A), D8.2 (A), D9.2 (A), D10.2 (A), D11.2 (A), D12.2 (A), D13.2 (A), D14.2 (A), D15.2 (A), D16.2 (A), D17.2 (A), D18.2 (A), D19.2 (A), D20.2 (A), D21.2 (A), D22.2 (A), D23.2 (A), D24.2 (A), D25.2 (A), D26.2 (A), D27.2 (A), D28.2 (A), D29.2 (A), D30.2 (A), D31.2 (A), D32.2 (A), D33.2 (A), D34.2 (A), D35.2 (A), D36.2 (A), D37.2 (A), D38.2 (A), D39.2 (A), D40.2 (A)
LINE: D41.1 (K), D42.1 (K), D43.1 (K), D44.1 (K), D45.1 (K), D46.1 (K), D47.1 (K), D48.1 (K), D49.1 (K), D50.1 (K), D51.1 (K), D52.1 (K), D53.1 (K), D54.1 (K), D55.1 (K), D56.1 (K), D57.1 (K), D58.1 (K), D59.1 (K), D60.1 (K), D61.1 (K), D62.1 (K), D63.1 (K), D64.1 (K), D65.1 (K), D66.1 (K), D67.1 (K), D68.1 (K), D69.1 (K), D70.1 (K), D71.1 (K), D72.1 (K), D73.1 (K), D74.1 (K), D75.1 (K), D76.1 (K), D77.1 (K), D78.1 (K), D79.1 (K), D80.1 (K)

Board: 2 copper layers, 82 parts (40 on the bottom side), 42 nets, no tracks yet.
