andrastantos/unic/dip64_gw/dip64_gw.kicad_pcb

## KiCad design dip64_gw/dip64_gw.kicad_pcb (2024-02-12)

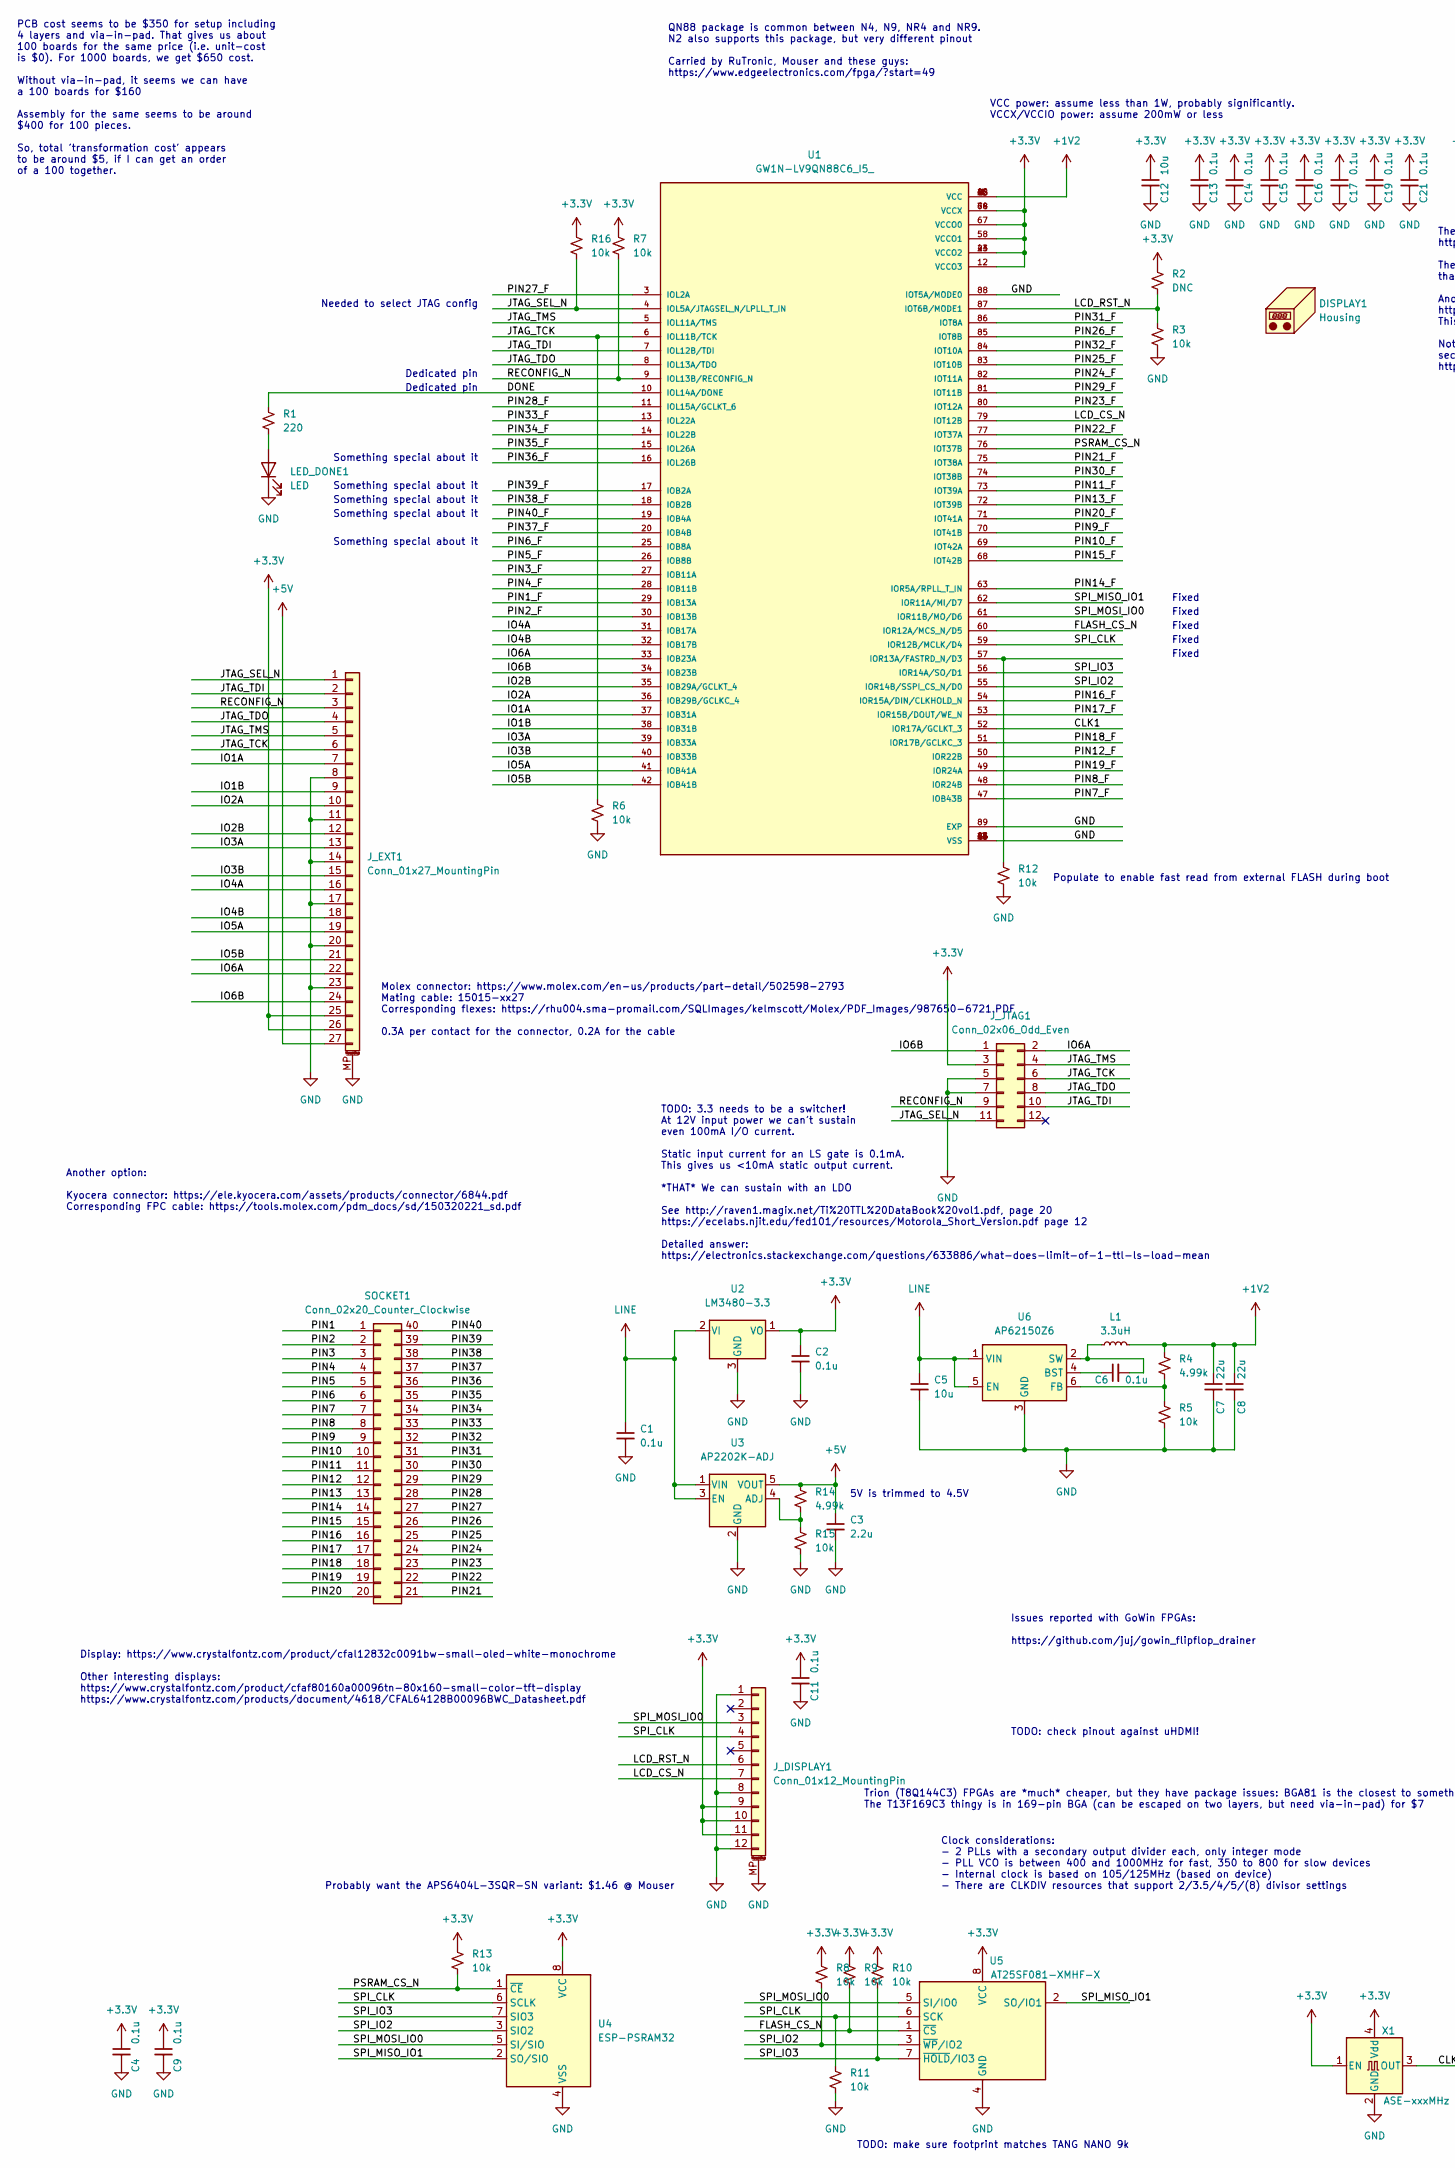
[picture p40: schematic dip64_gw.kicad_sch, UNIC 40, part in row 1, column 1]

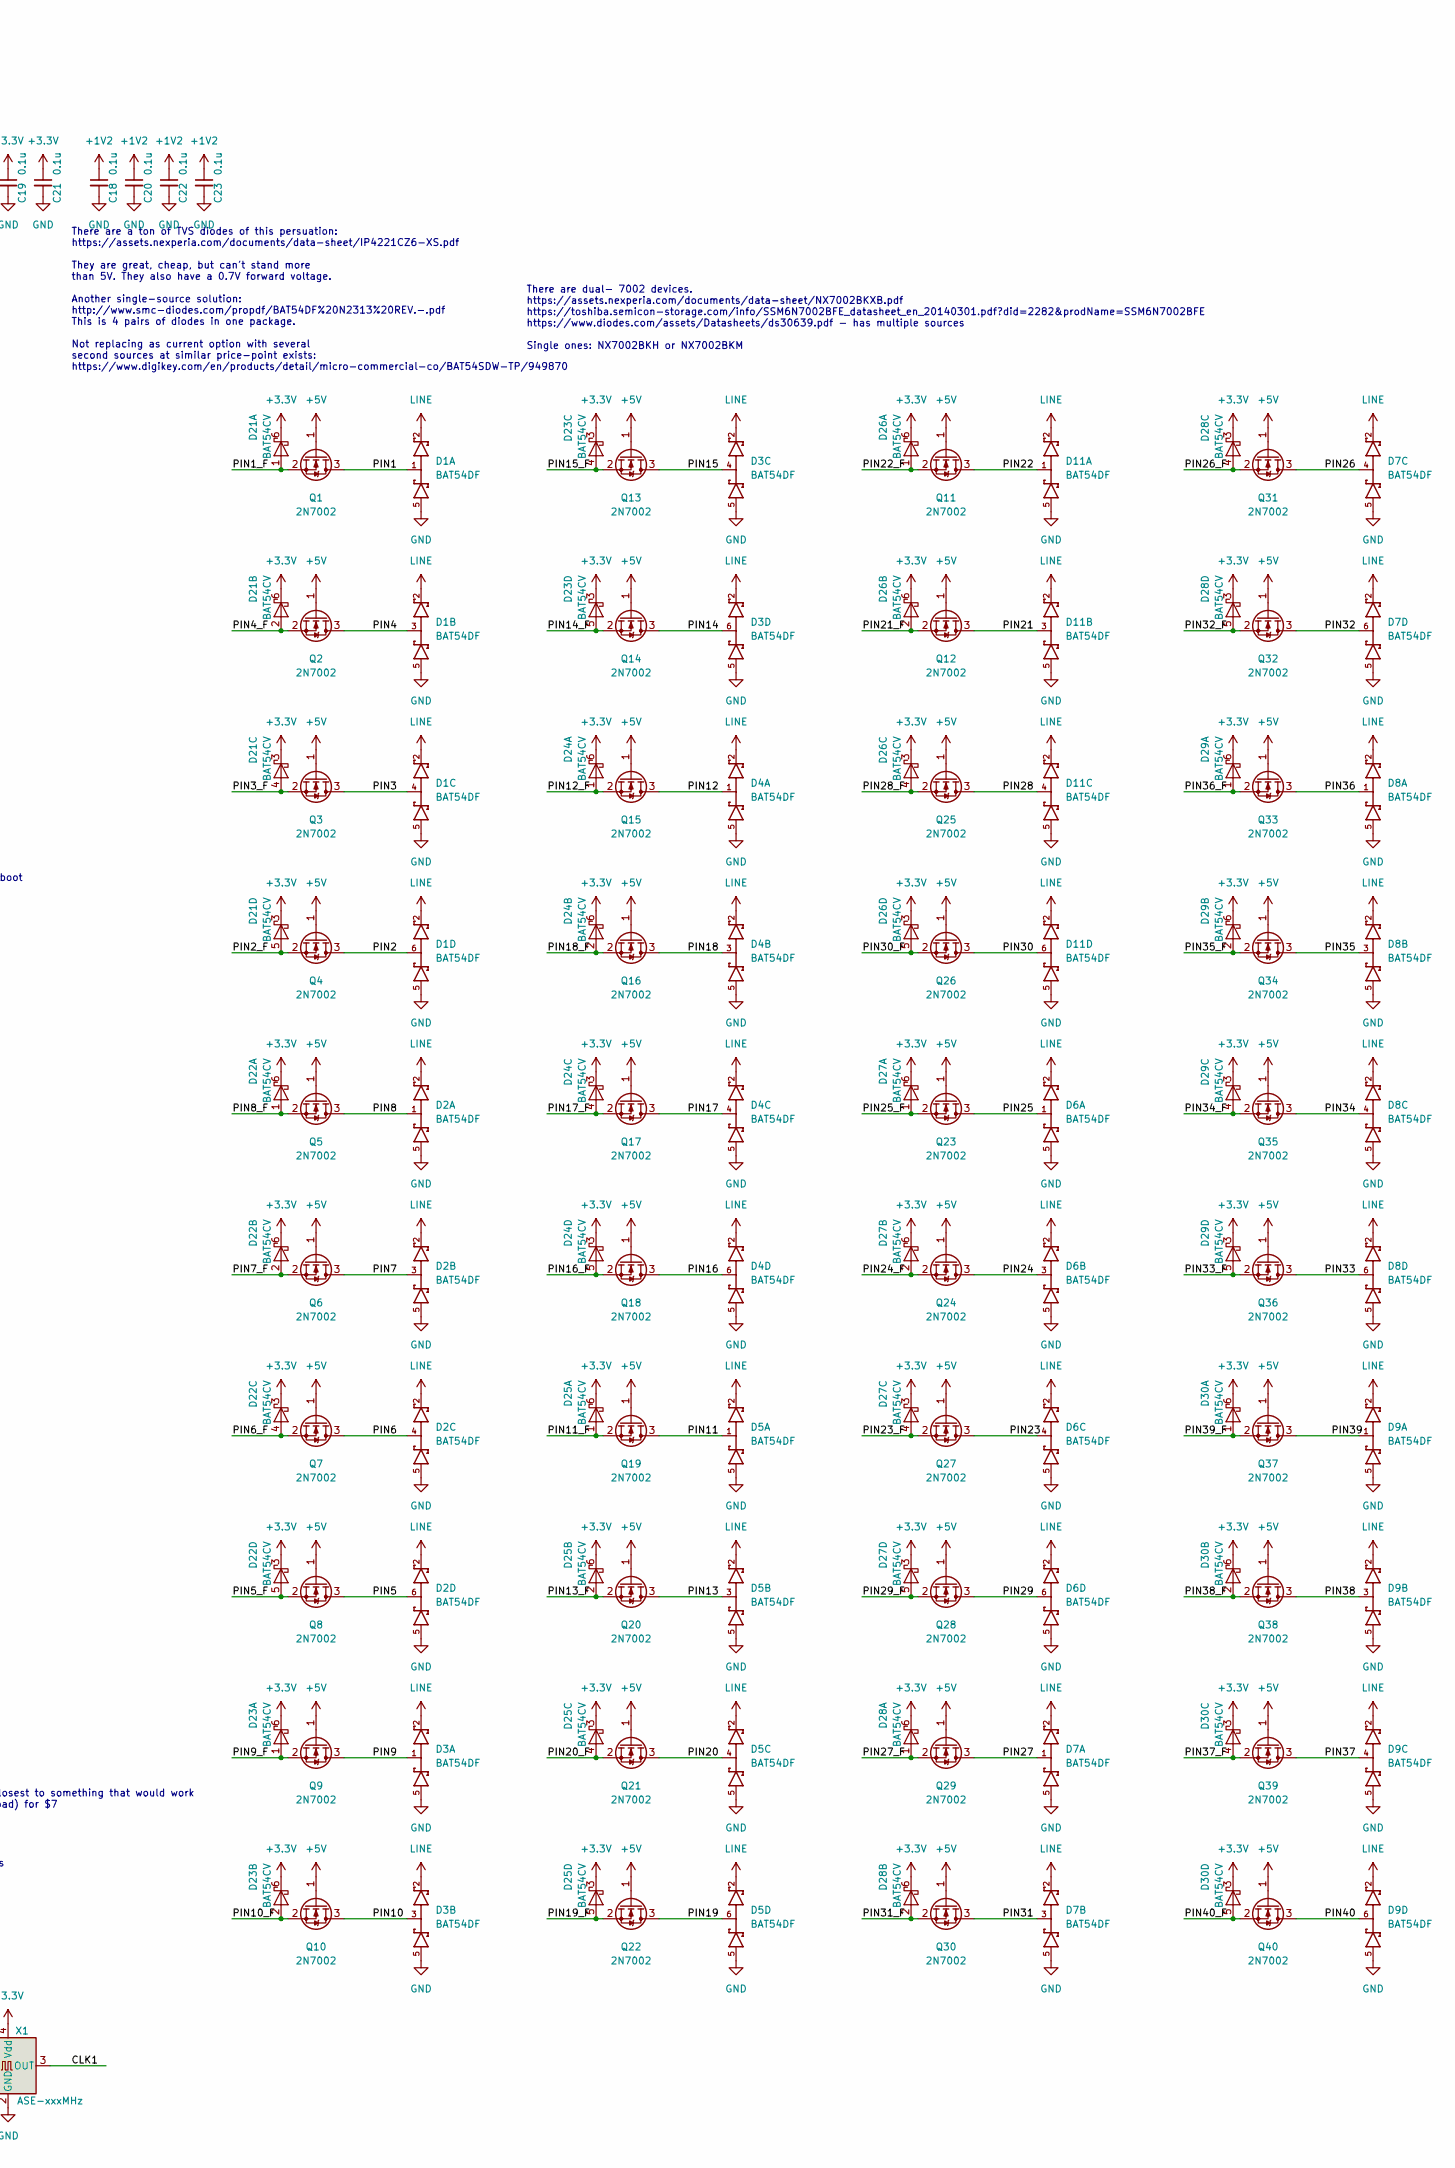
[picture p41: schematic dip64_gw.kicad_sch, UNIC 40, part in row 1, column 2]

Parts:
C1, C2, C4, C6, C9, C11, C13, C14, C15, C16, C17, C18, C19, C20, C21, C22, C23: 0.1u; C_0402_1005Metric_Pad0.74x0.62mm_HandSolder
C3: 2.2u; C_0402_1005Metric_Pad0.74x0.62mm_HandSolder
C5: 10u; C_0805_2012Metric_Pad1.18x1.45mm_HandSolder
C7, C8: 22u; C_0805_2012Metric_Pad1.18x1.45mm_HandSolder
C12: 10u; C_0603_1608Metric_Pad1.08x0.95mm_HandSolder
D1, D2, D3, D4, D5, D6, D7, D8, D9, D11: BAT54DF; SOT65P210X110-6N
D21, D22, D23, D24, D25, D26, D27, D28, D29, D30: BAT54CV; SOT-666
DISPLAY1: Housing; CFAL12832C-0091B-W_A
J_DISPLAY1: Conn_01x12_MountingPin; CF31121D0R0-05-NH
J_EXT1: Conn_01x27_MountingPin; Molex_502598-2793_2Rows-23P~0.60mm_Horizontal
J_JTAG1: Conn_02x06_Odd_Even; PinHeader_2x06_P1.27mm_Vertical_SMD
L1: 3.3uH; L_1008_2520Metric_Pad1.43x2.20mm_HandSolder
LED_DONE1: LED; LED_0402_1005Metric_Pad0.77x0.64mm_HandSolder
Q1, Q2, Q3, Q4, Q5, Q6, Q7, Q8, Q9, Q10, Q11, Q12, Q13, Q14, Q15, Q16, Q17, Q18, Q19, Q20, Q21, Q22, Q23, Q24, Q25, Q26, Q27, Q28, Q29, Q30, Q31, Q32, Q33, Q34, Q35, Q36, Q37, Q38, Q39, Q40: 2N7002; SOT-883
R1: 220; R_0402_1005Metric_Pad0.72x0.64mm_HandSolder
R2: DNC; R_0402_1005Metric_Pad0.72x0.64mm_HandSolder
R3, R5, R6, R7, R8, R9, R10, R11, R12, R13, R15, R16: 10k; R_0402_1005Metric_Pad0.72x0.64mm_HandSolder
R4, R14: 4.99k; R_0402_1005Metric_Pad0.72x0.64mm_HandSolder
SOCKET1: Conn_02x20_Counter_Clockwise; DIP-40_pin_header
U1: GW1N-LV9QN88C6_I5_; QFN40P1000X1000X95-89N; PARTREV UG103-2.3E
U2: LM3480-3.3; SOT-23
U3: AP2202K-ADJ; SOT-23-5
U4: ESP-PSRAM32; SOIC-8_3.9x4.9mm_P1.27mm
U5: AT25SF081-XMHF-X; TSSOP-8_4.4x3mm_P0.65mm
U6: AP62150Z6; SOT-563
X1: ASE-xxxMHz; Oscillator_SMD_Abracon_ASE-4Pin_3.2x2.5mm

Connections:
+1V2: C7.1, C8.1, C18.1, C20.1, C22.1, C23.1, L1.2, R4.1, U1.1 (VCC), U1.22 (VCC), U1.45 (VCC), U1.66 (VCC)
+3V3: C2.1, C4.1, C9.1, C11.1, C12.1, C13.1, C14.1, C15.1, C16.1, C17.1, C19.1, C21.1, D21.3 (A), D21.6 (A), D22.3 (A), D22.6 (A), D23.3 (A), D23.6 (A), D24.3 (A), D24.6 (A), D25.3 (A), D25.6 (A), D26.3 (A), D26.6 (A), D27.3 (A), D27.6 (A), D28.3 (A), D28.6 (A), D29.3 (A), D29.6 (A), D30.3 (A), D30.6 (A), J_DISPLAY1.9, J_DISPLAY1.10, J_DISPLAY1.11, J_EXT1.25, J_EXT1.26, J_JTAG1.3, R2.1, R7.1, R8.1, R9.1, R10.1, R13.1, R16.1, U1.12 (VCCO3), U1.23 (VCCO2), U1.44 (VCCO2), U1.58 (VCCO1), U1.64 (VCCX), U1.67 (VCCO0), U1.78 (VCCX), U2.1 (VO), U4.8 (VCC), U5.8 (VCC), X1.1 (EN), X1.4 (Vdd)
+5V: C3.1, J_EXT1.27, Q1.1 (G), Q2.1 (G), Q3.1 (G), Q4.1 (G), Q5.1 (G), Q6.1 (G), Q7.1 (G), Q8.1 (G), Q9.1 (G), Q10.1 (G), Q11.1 (G), Q12.1 (G), Q13.1 (G), Q14.1 (G), Q15.1 (G), Q16.1 (G), Q17.1 (G), Q18.1 (G), Q19.1 (G), Q20.1 (G), Q21.1 (G), Q22.1 (G), Q23.1 (G), Q24.1 (G), Q25.1 (G), Q26.1 (G), Q27.1 (G), Q28.1 (G), Q29.1 (G), Q30.1 (G), Q31.1 (G), Q32.1 (G), Q33.1 (G), Q34.1 (G), Q35.1 (G), Q36.1 (G), Q37.1 (G), Q38.1 (G), Q39.1 (G), Q40.1 (G), R14.1, U3.5 (VOUT)
/CLK1: U1.52 (IOR17A/GCLKT_3), X1.3 (OUT)
/DONE: R1.1, U1.10 (IOL14A/DONE)
/FLASH_CS_N: R9.2, U1.60 (IOR12A/MCS_N/D5), U5.1 (~CS)
/IO1A: J_EXT1.7, U1.37 (IOB31A)
/IO1B: J_EXT1.9, U1.38 (IOB31B)
/IO2A: J_EXT1.10, U1.36 (IOB29B/GCLKC_4)
/IO2B: J_EXT1.12, U1.35 (IOB29A/GCLKT_4)
/IO3A: J_EXT1.13, U1.39 (IOB33A)
/IO3B: J_EXT1.15, U1.40 (IOB33B)
/IO4A: J_EXT1.16, U1.31 (IOB17A)
/IO4B: J_EXT1.18, U1.32 (IOB17B)
/IO5A: J_EXT1.19, U1.41 (IOB41A)
/IO5B: J_EXT1.21, U1.42 (IOB41B)
/IO6A: J_EXT1.22, J_JTAG1.2, U1.33 (IOB23A)
/IO6B: J_EXT1.24, J_JTAG1.1, U1.34 (IOB23B)
/JTAG_SEL_N: J_EXT1.1, J_JTAG1.11, R16.2, U1.4 (IOL5A/JTAGSEL_N/LPLL_T_IN)
/JTAG_TCK: J_EXT1.6, J_JTAG1.6, R6.1, U1.6 (IOL11B/TCK)
/JTAG_TDI: J_EXT1.2, J_JTAG1.10, U1.7 (IOL12B/TDI)
/JTAG_TDO: J_EXT1.4, J_JTAG1.8, U1.8 (IOL13A/TDO)
/JTAG_TMS: J_EXT1.5, J_JTAG1.4, U1.5 (IOL11A/TMS)
/LCD_CS_N: J_DISPLAY1.7, U1.79 (IOT12B)
/LCD_RST_N: J_DISPLAY1.6, R2.2, R3.1, U1.87 (IOT6B/MODE1)
/PIN1: D1.1, Q1.3 (D), SOCKET1.1
/PIN1_F: D21.1 (K), Q1.2 (S), U1.29 (IOB13A)
/PIN2: D1.6, Q4.3 (D), SOCKET1.2
/PIN2_F: D21.5 (K), Q4.2 (S), U1.30 (IOB13B)
/PIN3: D1.4, Q3.3 (D), SOCKET1.3
/PIN3_F: D21.4 (K), Q3.2 (S), U1.27 (IOB11A)
/PIN4: D1.3, Q2.3 (D), SOCKET1.4
/PIN4_F: D21.2 (K), Q2.2 (S), U1.28 (IOB11B)
/PIN5: D2.6, Q8.3 (D), SOCKET1.5
/PIN5_F: D22.5 (K), Q8.2 (S), U1.26 (IOB8B)
/PIN6: D2.4, Q7.3 (D), SOCKET1.6
/PIN6_F: D22.4 (K), Q7.2 (S), U1.25 (IOB8A)
/PIN7: D2.3, Q6.3 (D), SOCKET1.7
/PIN7_F: D22.2 (K), Q6.2 (S), U1.47 (IOB43B)
/PIN8: D2.1, Q5.3 (D), SOCKET1.8
/PIN8_F: D22.1 (K), Q5.2 (S), U1.48 (IOR24B)
/PIN9: D3.1, Q9.3 (D), SOCKET1.9
/PIN9_F: D23.1 (K), Q9.2 (S), U1.70 (IOT41B)
/PIN10: D3.3, Q10.3 (D), SOCKET1.10
/PIN10_F: D23.2 (K), Q10.2 (S), U1.69 (IOT42A)
/PIN11: D5.1, Q19.3 (D), SOCKET1.11
/PIN11_F: D25.1 (K), Q19.2 (S), U1.73 (IOT39A)
/PIN12: D4.1, Q15.3 (D), SOCKET1.12
/PIN12_F: D24.1 (K), Q15.2 (S), U1.50 (IOR22B)
/PIN13: D5.3, Q20.3 (D), SOCKET1.13
/PIN13_F: D25.2 (K), Q20.2 (S), U1.72 (IOT39B)
/PIN14: D3.6, Q14.3 (D), SOCKET1.14
/PIN14_F: D23.5 (K), Q14.2 (S), U1.63 (IOR5A/RPLL_T_IN)
/PIN15: D3.4, Q13.3 (D), SOCKET1.15
/PIN15_F: D23.4 (K), Q13.2 (S), U1.68 (IOT42B)
/PIN16: D4.6, Q18.3 (D), SOCKET1.16
/PIN16_F: D24.5 (K), Q18.2 (S), U1.54 (IOR15A/DIN/CLKHOLD_N)
/PIN17: D4.4, Q17.3 (D), SOCKET1.17
/PIN17_F: D24.4 (K), Q17.2 (S), U1.53 (IOR15B/DOUT/WE_N)
/PIN18: D4.3, Q16.3 (D), SOCKET1.18
/PIN18_F: D24.2 (K), Q16.2 (S), U1.51 (IOR17B/GCLKC_3)
/PIN19: D5.6, Q22.3 (D), SOCKET1.19
/PIN19_F: D25.5 (K), Q22.2 (S), U1.49 (IOR24A)
/PIN20: D5.4, Q21.3 (D), SOCKET1.20
/PIN20_F: D25.4 (K), Q21.2 (S), U1.71 (IOT41A)
/PIN21: D11.3, Q12.3 (D), SOCKET1.21
/PIN21_F: D26.2 (K), Q12.2 (S), U1.75 (IOT38A)
/PIN22: D11.1, Q11.3 (D), SOCKET1.22
/PIN22_F: D26.1 (K), Q11.2 (S), U1.77 (IOT37A)
/PIN23: D6.4, Q27.3 (D), SOCKET1.23
/PIN23_F: D27.4 (K), Q27.2 (S), U1.80 (IOT12A)
/PIN24: D6.3, Q24.3 (D), SOCKET1.24
/PIN24_F: D27.2 (K), Q24.2 (S), U1.82 (IOT11A)
/PIN25: D6.1, Q23.3 (D), SOCKET1.25
/PIN25_F: D27.1 (K), Q23.2 (S), U1.83 (IOT10B)
/PIN26: D7.4, Q31.3 (D), SOCKET1.26
/PIN26_F: D28.4 (K), Q31.2 (S), U1.85 (IOT8B)
/PIN27: D7.1, Q29.3 (D), SOCKET1.27
/PIN27_F: D28.1 (K), Q29.2 (S), U1.3 (IOL2A)
/PIN28: D11.4, Q25.3 (D), SOCKET1.28
/PIN28_F: D26.4 (K), Q25.2 (S), U1.11 (IOL15A/GCLKT_6)
/PIN29: D6.6, Q28.3 (D), SOCKET1.29
/PIN29_F: D27.5 (K), Q28.2 (S), U1.81 (IOT11B)
/PIN30: D11.6, Q26.3 (D), SOCKET1.30
/PIN30_F: D26.5 (K), Q26.2 (S), U1.74 (IOT38B)
/PIN31: D7.3, Q30.3 (D), SOCKET1.31
/PIN31_F: D28.2 (K), Q30.2 (S), U1.86 (IOT8A)
/PIN32: D7.6, Q32.3 (D), SOCKET1.32
/PIN32_F: D28.5 (K), Q32.2 (S), U1.84 (IOT10A)
/PIN33: D8.6, Q36.3 (D), SOCKET1.33
/PIN33_F: D29.5 (K), Q36.2 (S), U1.13 (IOL22A)
/PIN34: D8.4, Q35.3 (D), SOCKET1.34
/PIN34_F: D29.4 (K), Q35.2 (S), U1.14 (IOL22B)
/PIN35: D8.3, Q34.3 (D), SOCKET1.35
/PIN35_F: D29.2 (K), Q34.2 (S), U1.15 (IOL26A)
/PIN36: D8.1, Q33.3 (D), SOCKET1.36
/PIN36_F: D29.1 (K), Q33.2 (S), U1.16 (IOL26B)
/PIN37: D9.4, Q39.3 (D), SOCKET1.37
/PIN37_F: D30.4 (K), Q39.2 (S), U1.20 (IOB4B)
/PIN38: D9.3, Q38.3 (D), SOCKET1.38
/PIN38_F: D30.2 (K), Q38.2 (S), U1.18 (IOB2B)
/PIN39: D9.1, Q37.3 (D), SOCKET1.39
/PIN39_F: D30.1 (K), Q37.2 (S), U1.17 (IOB2A)
/PIN40: D9.6, Q40.3 (D), SOCKET1.40
/PIN40_F: D30.5 (K), Q40.2 (S), U1.19 (IOB4A)
/PSRAM_CS_N: R13.2, U1.76 (IOT37B), U4.1 (~CE)
/RECONFIG_N: J_EXT1.3, J_JTAG1.9, R7.2, U1.9 (IOL13B/RECONFIG_N)
/SPI_CLK: J_DISPLAY1.4, R11.1, U1.59 (IOR12B/MCLK/D4), U4.6 (SCLK), U5.6 (SCK)
/SPI_IO2: R8.2, U1.55 (IOR14B/SSPI_CS_N/D0), U4.3 (SIO2), U5.3 (~WP/IO2)
/SPI_IO3: R10.2, U1.56 (IOR14A/SO/D1), U4.7 (SIO3), U5.7 (~HOLD/IO3)
/SPI_MISO_IO1: U1.62 (IOR11A/MI/D7), U4.2 (SO/SIO), U5.2 (SO/IO1)
/SPI_MOSI_IO0: J_DISPLAY1.3, U1.61 (IOR11B/MO/D6), U4.5 (SI/SIO), U5.5 (SI/IO0)
GND: C1.2, C2.2, C3.2, C4.2, C5.2, C7.2, C8.2, C9.2, C11.2, C12.2, C13.2, C14.2, C15.2, C16.2, C17.2, C18.2, C19.2, C20.2, C21.2, C22.2, C23.2, D1.5, D2.5, D3.5, D4.5, D5.5, D6.5, D7.5, D8.5, D9.5, D11.5, J_DISPLAY1.1, J_DISPLAY1.8, J_DISPLAY1.12, J_DISPLAY1.MP (MountPin), J_EXT1.8, J_EXT1.11, J_EXT1.14, J_EXT1.17, J_EXT1.20, J_EXT1.23, J_EXT1.MP (MountPin), J_JTAG1.5, J_JTAG1.7, LED_DONE1.1 (K), R3.2, R5.2, R6.2, R11.2, R12.2, R15.2, U1.2 (VSS), U1.21 (VSS), U1.24 (VSS), U1.43 (VSS), U1.46 (VSS), U1.65 (VSS), U1.88 (IOT5A/MODE0), U1.89 (EXP), U2.3 (GND), U3.2 (GND), U4.4 (VSS), U5.4 (GND), U6.3 (GND), X1.2 (GND)
LINE: C1.1, C5.1, D1.2, D2.2, D3.2, D4.2, D5.2, D6.2, D7.2, D8.2, D9.2, D11.2, U2.2 (VI), U3.1 (VIN), U3.3 (EN), U6.1 (VIN), U6.5 (EN)
unnamed: C6.1, U6.4 (BST)
unnamed: C6.2, L1.1, U6.2 (SW)
unnamed: LED_DONE1.2 (A), R1.2
unnamed: R4.2, R5.1, U6.6 (FB)
unnamed: R12.1, U1.57 (IOR13A/FASTRD_N/D3)
unnamed: R14.2, R15.1, U3.4 (ADJ)

Notes on the sheet:
Issues reported with GoWin FPGAs: https://github.com/juj/gowin_flipflop_drainer
Populate to enable fast read from external FLASH during boot
Fixed
Something special about it
PCB cost seems to be $350 for setup including 4 layers and via-in-pad. That gives us about 100 boards for the same price (i.e. unit-cost is $0). For 1000 boards, we get $650 cost. Without via-in-pad, it seems we can have a 100 boards for $160 Assembly for the same seems to be around $400 for 100 pi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
VCC power: assume less than 1W, probably significantly. VCCX/VCCIO power: assume 200mW or less
Molex connector: https://www.molex.com/en-us/products/part-detail/502598-2793 Mating cable: 15015-xx27 Corresponding flexes: https://rhu004.sma-promail.com/SQLImages/kelmscott/Molex/PDF_Images/987650-6721.PDF 0.3A per contact for the connector, 0.2A for the cable
Another option: Kyocera connector: https://ele.kyocera.com/assets/products/connector/6844.pdf Corresponding FPC cable: https://tools.molex.com/pdm_docs/sd/150320221_sd.pdf
There are a ton of TVS diodes of this persuation: https://assets.nexperia.com/documents/data-sheet/IP4221CZ6-XS.pdf They are great, cheap, but can't stand more than 5V. They also have a 0.7V forward voltage. Another single-source solution: http://www.smc-diodes.com/propdf/BAT54DF%20N2313%20REV.-.pd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
Clock considerations: - 2 PLLs with a secondary output divider each, only integer mode - PLL VCO is between 400 and 1000MHz for fast, 350 to 800 for slow devices - Internal clock is based on 105/125MHz (based on device) - There are CLKDIV resources that support 2/3.5/4/5/(8) divisor settings
TODO: 3.3 needs to be a switcher! At 12V input power we can't sustain even 100mA I/O current. Static input current for an LS gate is 0.1mA. This gives us <10mA static output current. *THAT* We can sustain with an LDO See http://raven1.magix.net/Ti%20TTL%20DataBook%20vol1.pdf, page 20 https://ecelab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
Dedicated pin
Needed to select JTAG config
QN88 package is common between N4, N9, NR4 and NR9. N2 also supports this package, but very different pinout Carried by RuTronic, Mouser and these guys: https://www.edgeelectronics.com/fpga/?start=49
5V is trimmed to 4.5V
Probably want the APS6404L-3SQR-SN variant: $1.46 @ Mouser
TODO: make sure footprint matches TANG NANO 9k
Display: https://www.crystalfontz.com/product/cfal12832c0091bw-small-oled-white-monochrome Other interesting displays: https://www.crystalfontz.com/product/cfaf80160a00096tn-80x160-small-color-tft-display https://www.crystalfontz.com/products/document/4618/CFAL64128B00096BWC_Datasheet.pdf
Trion (T8Q144C3) FPGAs are *much* cheaper, but they have package issues: BGA81 is the closest to something that would work The T13F169C3 thingy is in 169-pin BGA (can be escaped on two layers, but need via-in-pad) for $7
TODO: check pinout against uHDMI!
There are dual- 7002 devices. https://assets.nexperia.com/documents/data-sheet/NX7002BKXB.pdf https://toshiba.semicon-storage.com/info/SSM6N7002BFE_datasheet_en_20140301.pdf?did=2282&prodName=SSM6N7002BFE https://www.diodes.com/assets/Datasheets/ds30639.pdf - has multiple sources Single ones: NX700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

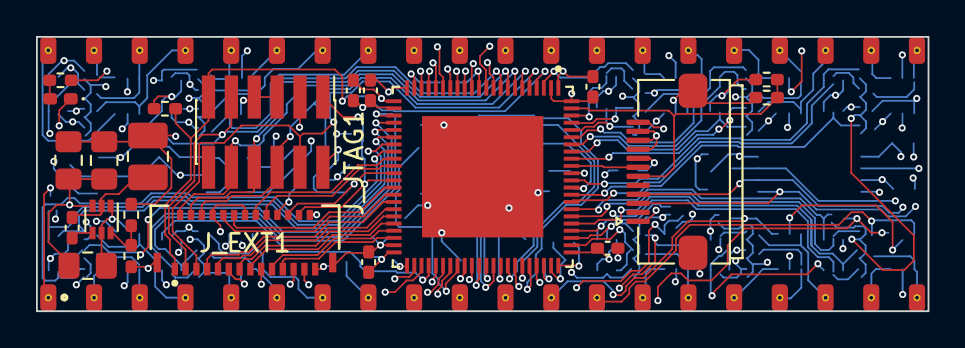
[picture p42: board dip64_gw.kicad_pcb from above]

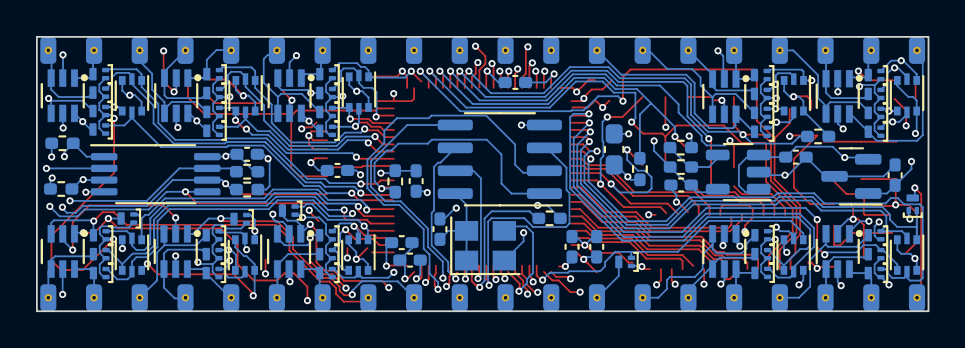
[picture p43: board dip64_gw.kicad_pcb from below]

Board: 4 copper layers, 49.5 x 15.2 mm, 112 parts (88 on the bottom side), 120 nets.
