andrastantos/unic/devel_adapter/devel_adapter.kicad_pcb

## KiCad design devel_adapter/devel_adapter.kicad_pcb (2024-01-04)

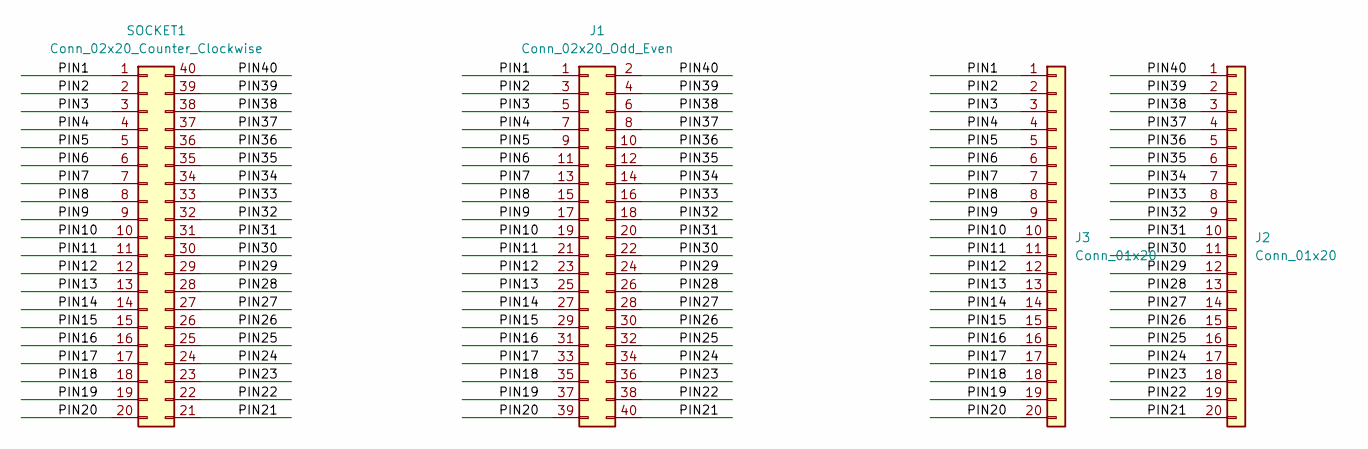
[picture p44: schematic devel_adapter.kicad_sch, UNIC 40]

Parts:
J1: Conn_02x20_Odd_Even; PinHeader_2x20_P2.54mm_Vertical
J2, J3: Conn_01x20; PinHeader_1x20_P2.54mm_Vertical
SOCKET1: Conn_02x20_Counter_Clockwise; DIP-40_pin_header

Connections:
/PIN1: J1.1, J3.1, SOCKET1.1
/PIN2: J1.3, J3.2, SOCKET1.2
/PIN3: J1.5, J3.3, SOCKET1.3
/PIN4: J1.7, J3.4, SOCKET1.4
/PIN5: J1.9, J3.5, SOCKET1.5
/PIN6: J1.11, J3.6, SOCKET1.6
/PIN7: J1.13, J3.7, SOCKET1.7
/PIN8: J1.15, J3.8, SOCKET1.8
/PIN9: J1.17, J3.9, SOCKET1.9
/PIN10: J1.19, J3.10, SOCKET1.10
/PIN11: J1.21, J3.11, SOCKET1.11
/PIN12: J1.23, J3.12, SOCKET1.12
/PIN13: J1.25, J3.13, SOCKET1.13
/PIN14: J1.27, J3.14, SOCKET1.14
/PIN15: J1.29, J3.15, SOCKET1.15
/PIN16: J1.31, J3.16, SOCKET1.16
/PIN17: J1.33, J3.17, SOCKET1.17
/PIN18: J1.35, J3.18, SOCKET1.18
/PIN19: J1.37, J3.19, SOCKET1.19
/PIN20: J1.39, J3.20, SOCKET1.20
/PIN21: J1.40, J2.20, SOCKET1.21
/PIN22: J1.38, J2.19, SOCKET1.22
/PIN23: J1.36, J2.18, SOCKET1.23
/PIN24: J1.34, J2.17, SOCKET1.24
/PIN25: J1.32, J2.16, SOCKET1.25
/PIN26: J1.30, J2.15, SOCKET1.26
/PIN27: J1.28, J2.14, SOCKET1.27
/PIN28: J1.26, J2.13, SOCKET1.28
/PIN29: J1.24, J2.12, SOCKET1.29
/PIN30: J1.22, J2.11, SOCKET1.30
/PIN31: J1.20, J2.10, SOCKET1.31
/PIN32: J1.18, J2.9, SOCKET1.32
/PIN33: J1.16, J2.8, SOCKET1.33
/PIN34: J1.14, J2.7, SOCKET1.34
/PIN35: J1.12, J2.6, SOCKET1.35
/PIN36: J1.10, J2.5, SOCKET1.36
/PIN37: J1.8, J2.4, SOCKET1.37
/PIN38: J1.6, J2.3, SOCKET1.38
/PIN39: J1.4, J2.2, SOCKET1.39
/PIN40: J1.2, J2.1, SOCKET1.40

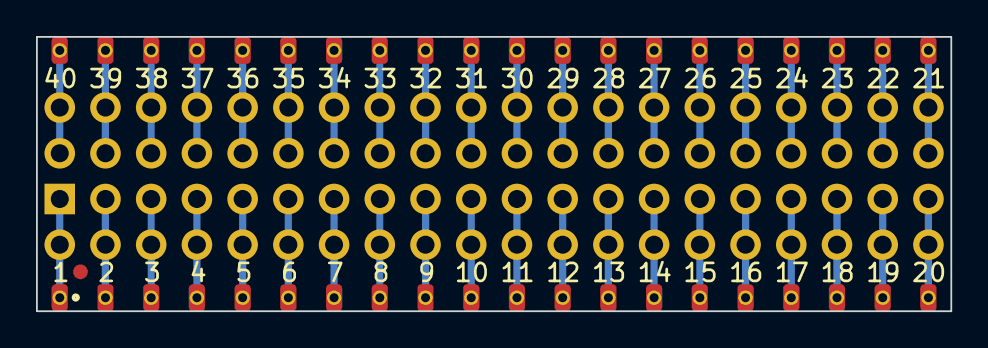
[picture p45: board devel_adapter.kicad_pcb from above]

Board: 2 copper layers, 50.8 x 15.2 mm, 4 parts (0 on the bottom side), 40 nets.
