andrastantos/unic/devel_gw1/devel_gw1.kicad_pcb

## KiCad design devel_gw1/devel_gw1.kicad_pcb (2024-01-04)

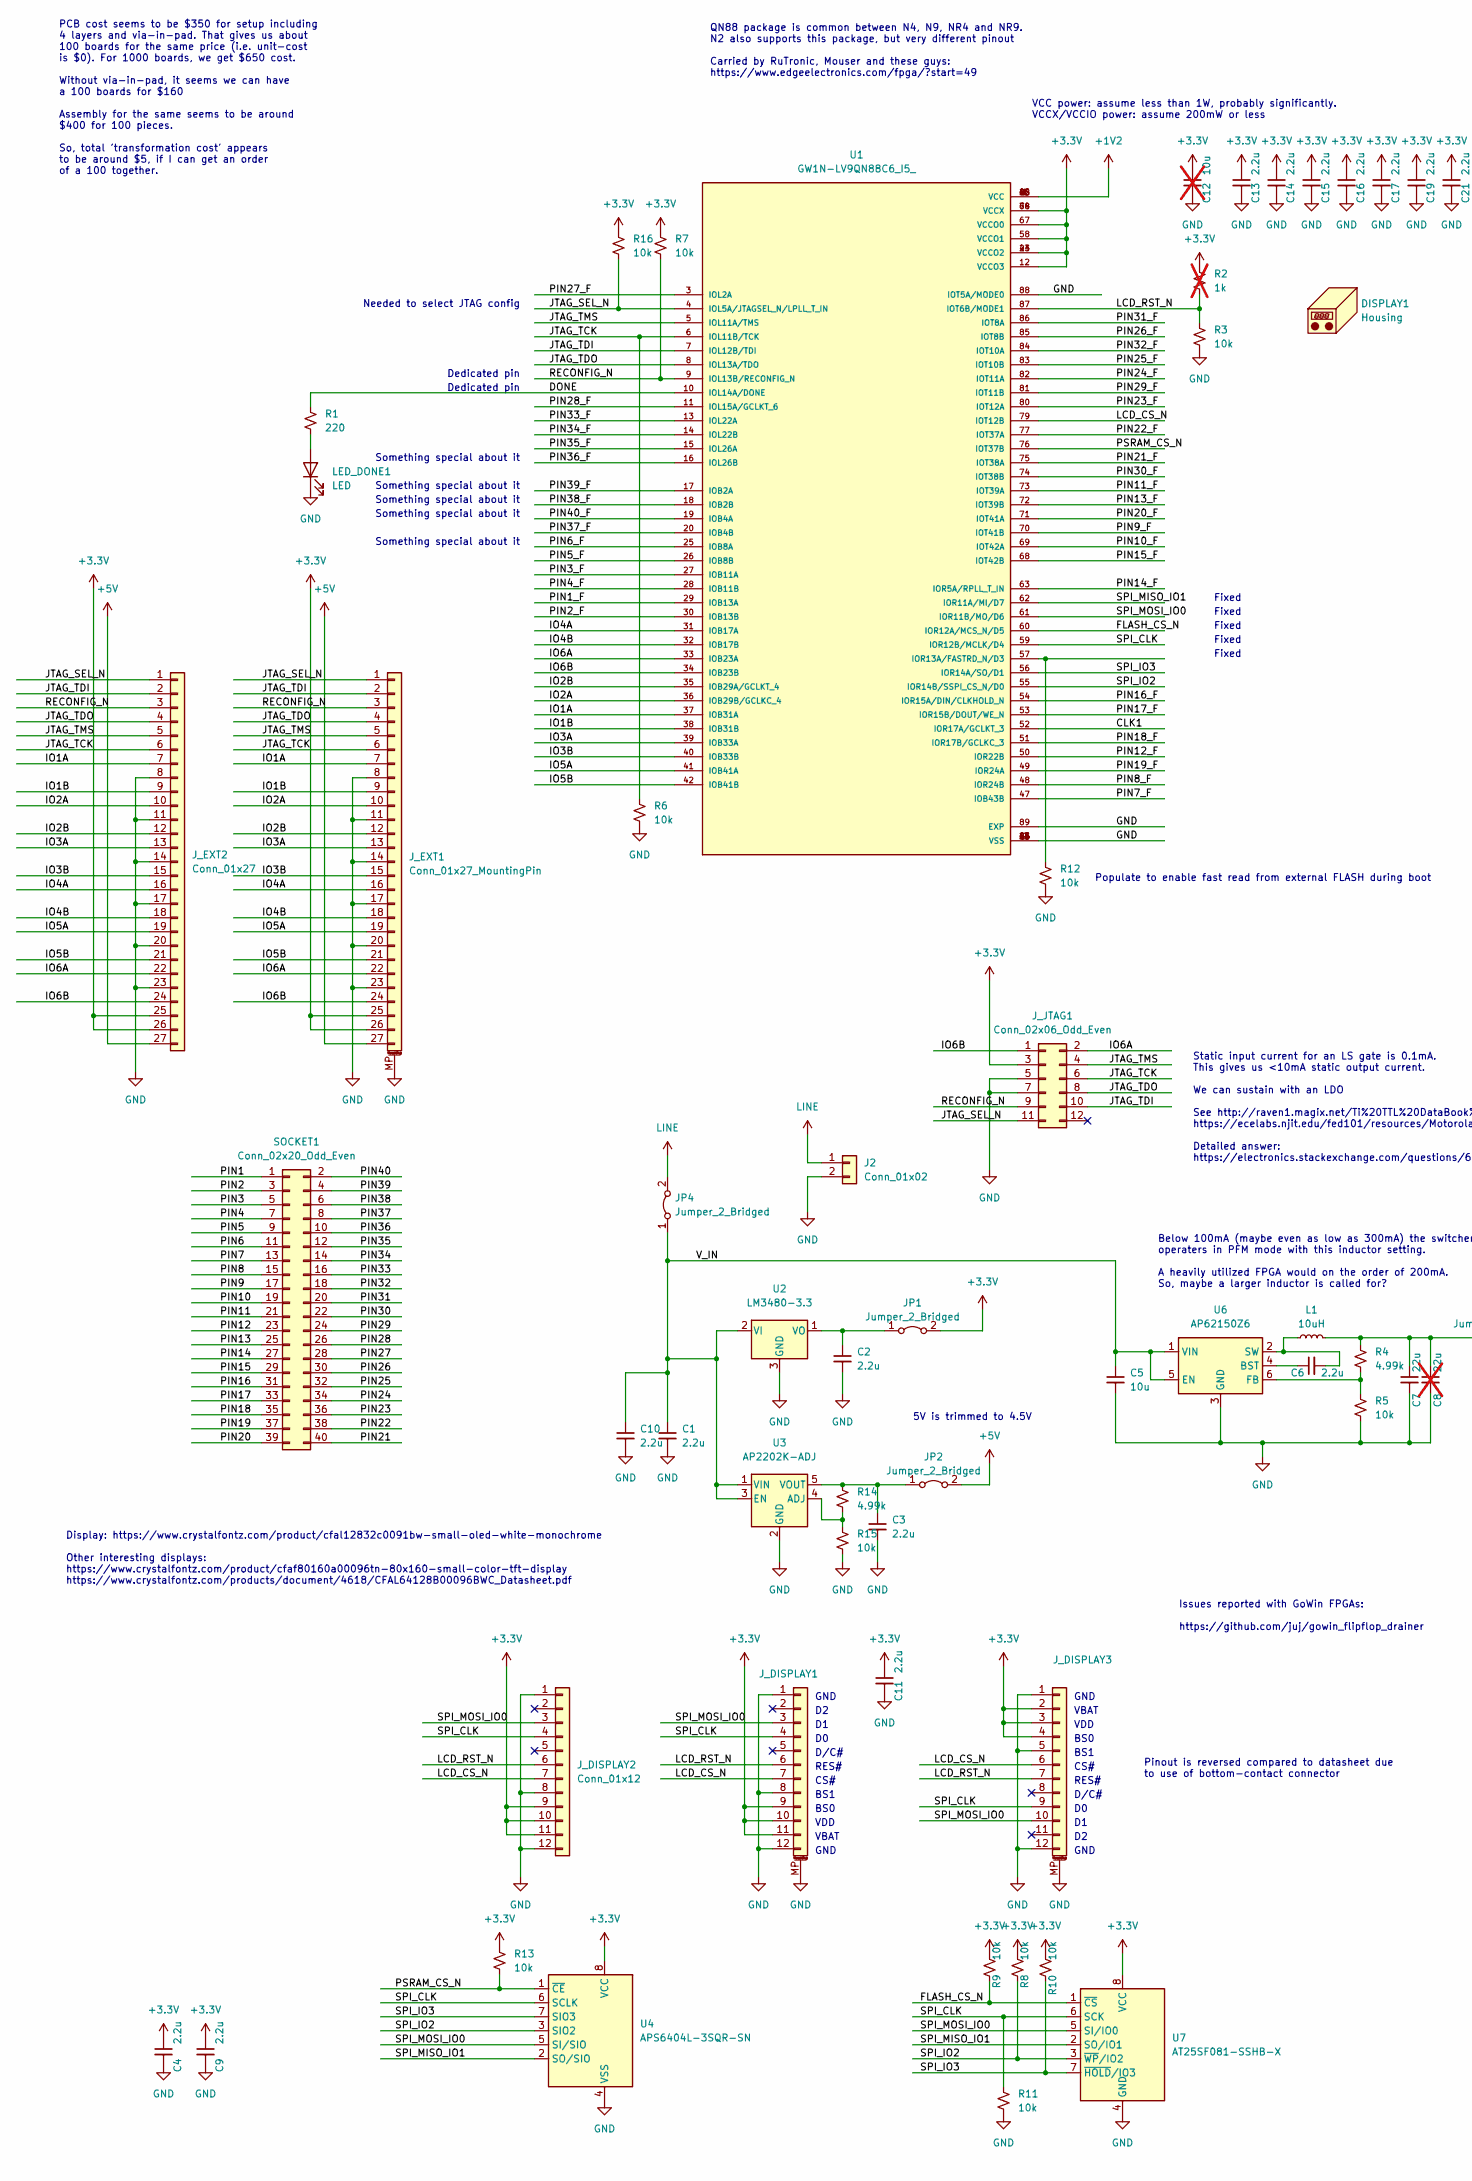
[picture p46: schematic devel_gw1.kicad_sch, UNIC 40, part in row 1, column 1]

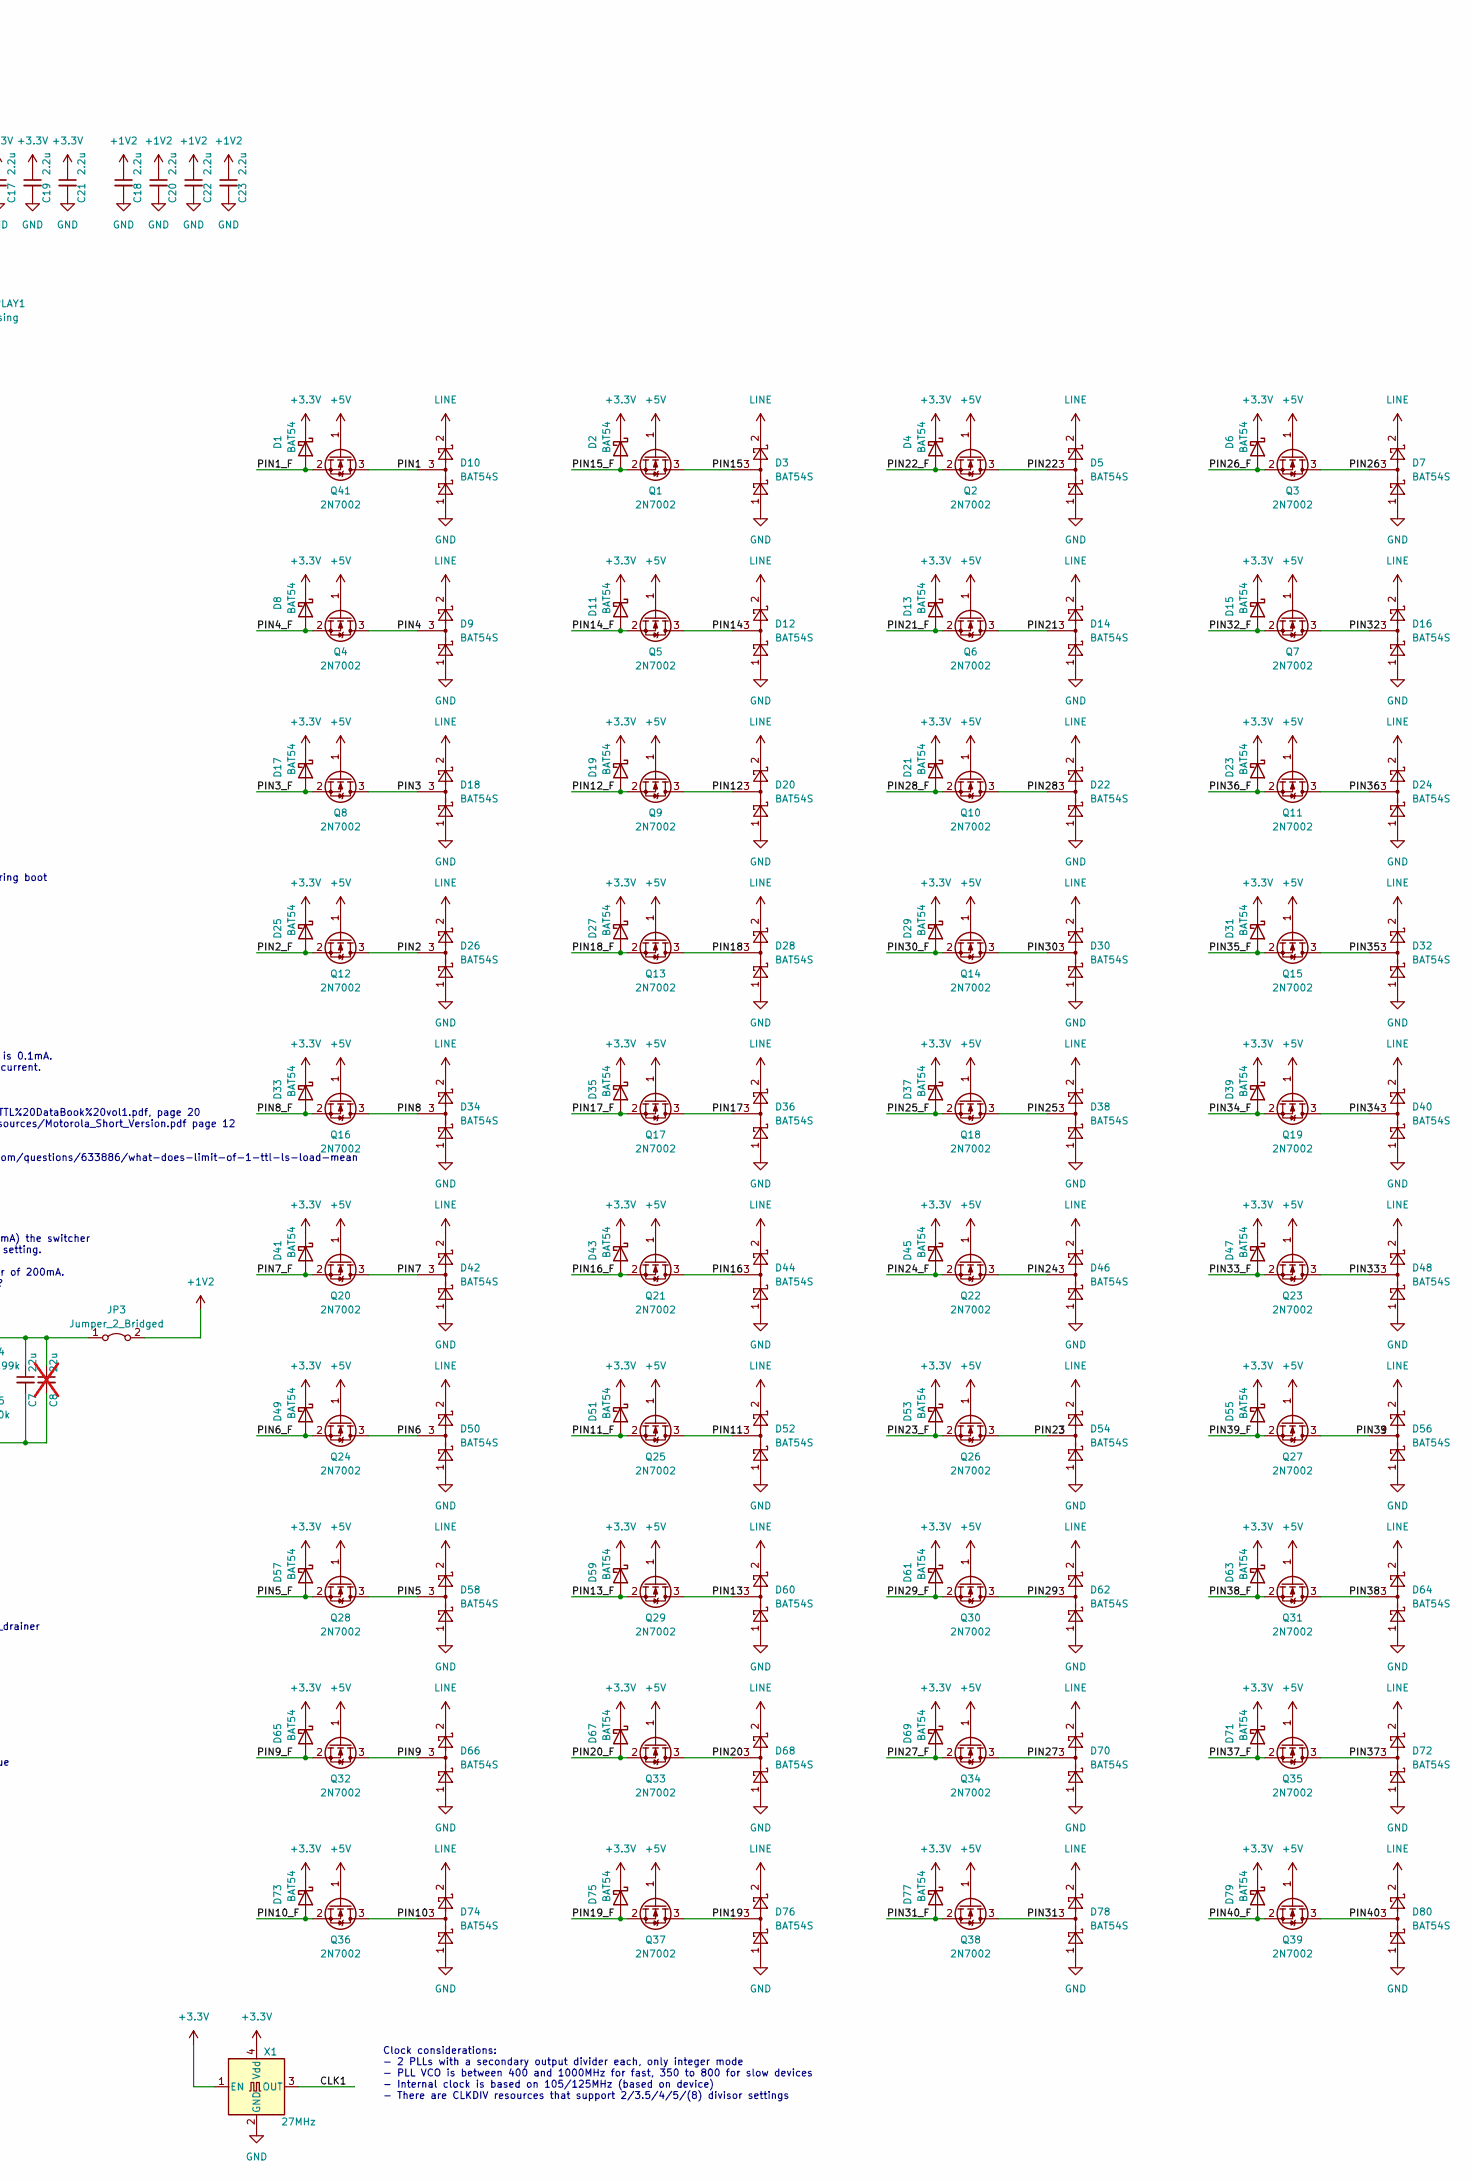
[picture p47: schematic devel_gw1.kicad_sch, UNIC 40, part in row 1, column 2]

Parts:
C1, C2, C3, C4, C6, C9, C10, C11, C13, C14, C15, C16, C17, C18, C19, C20, C21, C22, C23: 2.2u; C_0402_1005Metric_Pad0.74x0.62mm_HandSolder
C5: 10u; C_0805_2012Metric_Pad1.18x1.45mm_HandSolder
C7: 22u; C_0805_2012Metric_Pad1.18x1.45mm_HandSolder
C8: 22u; C_0805_2012Metric_Pad1.18x1.45mm_HandSolder; not fitted
C12: 10u; C_0805_2012Metric_Pad1.18x1.45mm_HandSolder; not fitted
D1, D2, D4, D6, D8, D11, D13, D15, D17, D19, D21, D23, D25, D27, D29, D31, D33, D35, D37, D39, D41, D43, D45, D47, D49, D51, D53, D55, D57, D59, D61, D63, D65, D67, D69, D71, D73, D75, D77, D79: BAT54; SOT-23
D3, D5, D7, D9, D10, D12, D14, D16, D18, D20, D22, D24, D26, D28, D30, D32, D34, D36, D38, D40, D42, D44, D46, D48, D50, D52, D54, D56, D58, D60, D62, D64, D66, D68, D70, D72, D74, D76, D78, D80: BAT54S; SOT-23
DISPLAY1: Housing; CFAL12832C-0091B-W_A
J2: Conn_01x02; PinHeader_1x02_P2.54mm_Vertical
JP1, JP2, JP3, JP4: Jumper_2_Bridged; PinHeader_1x02_P2.54mm_Vertical
J_DISPLAY1: Conn_01x12_MountingPin; CF4212FH0R0-05-NH
J_DISPLAY2: Conn_01x12; PinHeader_1x12_P2.54mm_Vertical
J_DISPLAY3: Conn_01x12_MountingPin; CF31121D0R0-05-NH
J_EXT1: Conn_01x27_MountingPin; Molex_502598-2793_2Rows-23P~0.60mm_Horizontal
J_EXT2: Conn_01x27; PinHeader_2x14_P2.54mm_Vertical
J_JTAG1: Conn_02x06_Odd_Even; PinHeader_2x06_P1.27mm_Vertical_SMD
L1: 10uH; L_1008_2520Metric_Pad1.43x2.20mm_HandSolder
LED_DONE1: LED; LED_0402_1005Metric_Pad0.77x0.64mm_HandSolder
Q1, Q2, Q3, Q4, Q5, Q6, Q7, Q8, Q9, Q10, Q11, Q12, Q13, Q14, Q15, Q16, Q17, Q18, Q19, Q20, Q21, Q22, Q23, Q24, Q25, Q26, Q27, Q28, Q29, Q30, Q31, Q32, Q33, Q34, Q35, Q36, Q37, Q38, Q39, Q41: 2N7002; SOT-23
R1: 220; R_0402_1005Metric_Pad0.72x0.64mm_HandSolder
R2: 1k; R_0402_1005Metric_Pad0.72x0.64mm_HandSolder; not fitted
R3, R5, R6, R7, R8, R9, R10, R11, R12, R13, R15, R16: 10k; R_0402_1005Metric_Pad0.72x0.64mm_HandSolder
R4, R14: 4.99k; R_0402_1005Metric_Pad0.72x0.64mm_HandSolder
SOCKET1: Conn_02x20_Odd_Even; PinSocket_2x20_P2.54mm_Horizontal
U1: GW1N-LV9QN88C6_I5_; QFN40P1000X1000X95-89N_hand_solder; PARTREV UG103-2.3E
U2: LM3480-3.3; SOT-23
U3: AP2202K-ADJ; SOT-23-5
U4: APS6404L-3SQR-SN; SOIC-8_3.9x4.9mm_P1.27mm
U6: AP62150Z6; SOT-563
U7: AT25SF081-SSHB-X; SOIC-8_3.9x4.9mm_P1.27mm
X1: 27MHz; Oscillator_SMD_Abracon_ASE-4Pin_3.2x2.5mm

Connections:
+1V2: C18.1, C20.1, C22.1, C23.1, JP3.2 (B), U1.1 (VCC), U1.22 (VCC), U1.45 (VCC), U1.66 (VCC)
+3V3: C4.1, C9.1, C11.1, C12.1, C13.1, C14.1, C15.1, C16.1, C17.1, C19.1, C21.1, D1.3 (K), D2.3 (K), D4.3 (K), D6.3 (K), D8.3 (K), D11.3 (K), D13.3 (K), D15.3 (K), D17.3 (K), D19.3 (K), D21.3 (K), D23.3 (K), D25.3 (K), D27.3 (K), D29.3 (K), D31.3 (K), D33.3 (K), D35.3 (K), D37.3 (K), D39.3 (K), D41.3 (K), D43.3 (K), D45.3 (K), D47.3 (K), D49.3 (K), D51.3 (K), D53.3 (K), D55.3 (K), D57.3 (K), D59.3 (K), D61.3 (K), D63.3 (K), D65.3 (K), D67.3 (K), D69.3 (K), D71.3 (K), D73.3 (K), D75.3 (K), D77.3 (K), D79.3 (K), JP1.2 (B), J_DISPLAY1.9, J_DISPLAY1.10, J_DISPLAY1.11, J_DISPLAY2.9, J_DISPLAY2.10, J_DISPLAY2.11, J_DISPLAY3.2, J_DISPLAY3.3, J_DISPLAY3.4, J_EXT1.25, J_EXT1.26, J_EXT2.25, J_EXT2.26, J_JTAG1.3, R2.1, R7.1, R8.1, R9.1, R10.1, R13.1, R16.1, U1.12 (VCCO3), U1.23 (VCCO2), U1.44 (VCCO2), U1.58 (VCCO1), U1.64 (VCCX), U1.67 (VCCO0), U1.78 (VCCX), U4.8 (VCC), U7.8 (VCC), X1.1 (EN), X1.4 (Vdd)
+5V: JP2.2 (B), J_EXT1.27, J_EXT2.27, Q1.1 (G), Q2.1 (G), Q3.1 (G), Q4.1 (G), Q5.1 (G), Q6.1 (G), Q7.1 (G), Q8.1 (G), Q9.1 (G), Q10.1 (G), Q11.1 (G), Q12.1 (G), Q13.1 (G), Q14.1 (G), Q15.1 (G), Q16.1 (G), Q17.1 (G), Q18.1 (G), Q19.1 (G), Q20.1 (G), Q21.1 (G), Q22.1 (G), Q23.1 (G), Q24.1 (G), Q25.1 (G), Q26.1 (G), Q27.1 (G), Q28.1 (G), Q29.1 (G), Q30.1 (G), Q31.1 (G), Q32.1 (G), Q33.1 (G), Q34.1 (G), Q35.1 (G), Q36.1 (G), Q37.1 (G), Q38.1 (G), Q39.1 (G), Q41.1 (G)
/CLK1: U1.52 (IOR17A/GCLKT_3), X1.3 (OUT)
/DONE: R1.1, U1.10 (IOL14A/DONE)
/FLASH_CS_N: R9.2, U1.60 (IOR12A/MCS_N/D5), U7.1 (~CS)
/IO1A: J_EXT1.7, J_EXT2.7, U1.37 (IOB31A)
/IO1B: J_EXT1.9, J_EXT2.9, U1.38 (IOB31B)
/IO2A: J_EXT1.10, J_EXT2.10, U1.36 (IOB29B/GCLKC_4)
/IO2B: J_EXT1.12, J_EXT2.12, U1.35 (IOB29A/GCLKT_4)
/IO3A: J_EXT1.13, J_EXT2.13, U1.39 (IOB33A)
/IO3B: J_EXT1.15, J_EXT2.15, U1.40 (IOB33B)
/IO4A: J_EXT1.16, J_EXT2.16, U1.31 (IOB17A)
/IO4B: J_EXT1.18, J_EXT2.18, U1.32 (IOB17B)
/IO5A: J_EXT1.19, J_EXT2.19, U1.41 (IOB41A)
/IO5B: J_EXT1.21, J_EXT2.21, U1.42 (IOB41B)
/IO6A: J_EXT1.22, J_EXT2.22, J_JTAG1.2, U1.33 (IOB23A)
/IO6B: J_EXT1.24, J_EXT2.24, J_JTAG1.1, U1.34 (IOB23B)
/JTAG_SEL_N: J_EXT1.1, J_EXT2.1, J_JTAG1.11, R16.2, U1.4 (IOL5A/JTAGSEL_N/LPLL_T_IN)
/JTAG_TCK: J_EXT1.6, J_EXT2.6, J_JTAG1.6, R6.1, U1.6 (IOL11B/TCK)
/JTAG_TDI: J_EXT1.2, J_EXT2.2, J_JTAG1.10, U1.7 (IOL12B/TDI)
/JTAG_TDO: J_EXT1.4, J_EXT2.4, J_JTAG1.8, U1.8 (IOL13A/TDO)
/JTAG_TMS: J_EXT1.5, J_EXT2.5, J_JTAG1.4, U1.5 (IOL11A/TMS)
/LCD_CS_N: J_DISPLAY1.7, J_DISPLAY2.7, J_DISPLAY3.6, U1.79 (IOT12B)
/LCD_RST_N: J_DISPLAY1.6, J_DISPLAY2.6, J_DISPLAY3.7, R2.2, R3.1, U1.87 (IOT6B/MODE1)
/PIN1: D10.3, Q41.3 (D), SOCKET1.1
/PIN1_F: D1.1 (A), Q41.2 (S), U1.29 (IOB13A)
/PIN2: D26.3, Q12.3 (D), SOCKET1.3
/PIN2_F: D25.1 (A), Q12.2 (S), U1.30 (IOB13B)
/PIN3: D18.3, Q8.3 (D), SOCKET1.5
/PIN3_F: D17.1 (A), Q8.2 (S), U1.27 (IOB11A)
/PIN4: D9.3, Q4.3 (D), SOCKET1.7
/PIN4_F: D8.1 (A), Q4.2 (S), U1.28 (IOB11B)
/PIN5: D58.3, Q28.3 (D), SOCKET1.9
/PIN5_F: D57.1 (A), Q28.2 (S), U1.26 (IOB8B)
/PIN6: D50.3, Q24.3 (D), SOCKET1.11
/PIN6_F: D49.1 (A), Q24.2 (S), U1.25 (IOB8A)
/PIN7: D42.3, Q20.3 (D), SOCKET1.13
/PIN7_F: D41.1 (A), Q20.2 (S), U1.47 (IOB43B)
/PIN8: D34.3, Q16.3 (D), SOCKET1.15
/PIN8_F: D33.1 (A), Q16.2 (S), U1.48 (IOR24B)
/PIN9: D66.3, Q32.3 (D), SOCKET1.17
/PIN9_F: D65.1 (A), Q32.2 (S), U1.70 (IOT41B)
/PIN10: D74.3, Q36.3 (D), SOCKET1.19
/PIN10_F: D73.1 (A), Q36.2 (S), U1.69 (IOT42A)
/PIN11: D52.3, Q25.3 (D), SOCKET1.21
/PIN11_F: D51.1 (A), Q25.2 (S), U1.73 (IOT39A)
/PIN12: D20.3, Q9.3 (D), SOCKET1.23
/PIN12_F: D19.1 (A), Q9.2 (S), U1.50 (IOR22B)
/PIN13: D60.3, Q29.3 (D), SOCKET1.25
/PIN13_F: D59.1 (A), Q29.2 (S), U1.72 (IOT39B)
/PIN14: D12.3, Q5.3 (D), SOCKET1.27
/PIN14_F: D11.1 (A), Q5.2 (S), U1.63 (IOR5A/RPLL_T_IN)
/PIN15: D3.3, Q1.3 (D), SOCKET1.29
/PIN15_F: D2.1 (A), Q1.2 (S), U1.68 (IOT42B)
/PIN16: D44.3, Q21.3 (D), SOCKET1.31
/PIN16_F: D43.1 (A), Q21.2 (S), U1.54 (IOR15A/DIN/CLKHOLD_N)
/PIN17: D36.3, Q17.3 (D), SOCKET1.33
/PIN17_F: D35.1 (A), Q17.2 (S), U1.53 (IOR15B/DOUT/WE_N)
/PIN18: D28.3, Q13.3 (D), SOCKET1.35
/PIN18_F: D27.1 (A), Q13.2 (S), U1.51 (IOR17B/GCLKC_3)
/PIN19: D76.3, Q37.3 (D), SOCKET1.37
/PIN19_F: D75.1 (A), Q37.2 (S), U1.49 (IOR24A)
/PIN20: D68.3, Q33.3 (D), SOCKET1.39
/PIN20_F: D67.1 (A), Q33.2 (S), U1.71 (IOT41A)
/PIN21: D14.3, Q6.3 (D), SOCKET1.40
/PIN21_F: D13.1 (A), Q6.2 (S), U1.75 (IOT38A)
/PIN22: D5.3, Q2.3 (D), SOCKET1.38
/PIN22_F: D4.1 (A), Q2.2 (S), U1.77 (IOT37A)
/PIN23: D54.3, Q26.3 (D), SOCKET1.36
/PIN23_F: D53.1 (A), Q26.2 (S), U1.80 (IOT12A)
/PIN24: D46.3, Q22.3 (D), SOCKET1.34
/PIN24_F: D45.1 (A), Q22.2 (S), U1.82 (IOT11A)
/PIN25: D38.3, Q18.3 (D), SOCKET1.32
/PIN25_F: D37.1 (A), Q18.2 (S), U1.83 (IOT10B)
/PIN26: D7.3, Q3.3 (D), SOCKET1.30
/PIN26_F: D6.1 (A), Q3.2 (S), U1.85 (IOT8B)
/PIN27: D70.3, Q34.3 (D), SOCKET1.28
/PIN27_F: D69.1 (A), Q34.2 (S), U1.3 (IOL2A)
/PIN28: D22.3, Q10.3 (D), SOCKET1.26
/PIN28_F: D21.1 (A), Q10.2 (S), U1.11 (IOL15A/GCLKT_6)
/PIN29: D62.3, Q30.3 (D), SOCKET1.24
/PIN29_F: D61.1 (A), Q30.2 (S), U1.81 (IOT11B)
/PIN30: D30.3, Q14.3 (D), SOCKET1.22
/PIN30_F: D29.1 (A), Q14.2 (S), U1.74 (IOT38B)
/PIN31: D78.3, Q38.3 (D), SOCKET1.20
/PIN31_F: D77.1 (A), Q38.2 (S), U1.86 (IOT8A)
/PIN32: D16.3, Q7.3 (D), SOCKET1.18
/PIN32_F: D15.1 (A), Q7.2 (S), U1.84 (IOT10A)
/PIN33: D48.3, Q23.3 (D), SOCKET1.16
/PIN33_F: D47.1 (A), Q23.2 (S), U1.13 (IOL22A)
/PIN34: D40.3, Q19.3 (D), SOCKET1.14
/PIN34_F: D39.1 (A), Q19.2 (S), U1.14 (IOL22B)
/PIN35: D32.3, Q15.3 (D), SOCKET1.12
/PIN35_F: D31.1 (A), Q15.2 (S), U1.15 (IOL26A)
/PIN36: D24.3, Q11.3 (D), SOCKET1.10
/PIN36_F: D23.1 (A), Q11.2 (S), U1.16 (IOL26B)
/PIN37: D72.3, Q35.3 (D), SOCKET1.8
/PIN37_F: D71.1 (A), Q35.2 (S), U1.20 (IOB4B)
/PIN38: D64.3, Q31.3 (D), SOCKET1.6
/PIN38_F: D63.1 (A), Q31.2 (S), U1.18 (IOB2B)
/PIN39: D56.3, Q27.3 (D), SOCKET1.4
/PIN39_F: D55.1 (A), Q27.2 (S), U1.17 (IOB2A)
/PIN40: D80.3, Q39.3 (D), SOCKET1.2
/PIN40_F: D79.1 (A), Q39.2 (S), U1.19 (IOB4A)
/PSRAM_CS_N: R13.2, U1.76 (IOT37B), U4.1 (~CE)
/RECONFIG_N: J_EXT1.3, J_EXT2.3, J_JTAG1.9, R7.2, U1.9 (IOL13B/RECONFIG_N)
/SPI_CLK: J_DISPLAY1.4, J_DISPLAY2.4, J_DISPLAY3.9, R11.1, U1.59 (IOR12B/MCLK/D4), U4.6 (SCLK), U7.6 (SCK)
/SPI_IO2: R8.2, U1.55 (IOR14B/SSPI_CS_N/D0), U4.3 (SIO2), U7.3 (~WP/IO2)
/SPI_IO3: R10.2, U1.56 (IOR14A/SO/D1), U4.7 (SIO3), U7.7 (~HOLD/IO3)
/SPI_MISO_IO1: U1.62 (IOR11A/MI/D7), U4.2 (SO/SIO), U7.2 (SO/IO1)
/SPI_MOSI_IO0: J_DISPLAY1.3, J_DISPLAY2.3, J_DISPLAY3.10, U1.61 (IOR11B/MO/D6), U4.5 (SI/SIO), U7.5 (SI/IO0)
/V_IN: C1.1, C5.1, C10.1, JP4.1 (A), U2.2 (VI), U3.1 (VIN), U3.3 (EN), U6.1 (VIN), U6.5 (EN)
GND: C1.2, C2.2, C3.2, C4.2, C5.2, C7.2, C8.2, C9.2, C10.2, C11.2, C12.2, C13.2, C14.2, C15.2, C16.2, C17.2, C18.2, C19.2, C20.2, C21.2, C22.2, C23.2, D3.1, D5.1, D7.1, D9.1, D10.1, D12.1, D14.1, D16.1, D18.1, D20.1, D22.1, D24.1, D26.1, D28.1, D30.1, D32.1, D34.1, D36.1, D38.1, D40.1, D42.1, D44.1, D46.1, D48.1, D50.1, D52.1, D54.1, D56.1, D58.1, D60.1, D62.1, D64.1, D66.1, D68.1, D70.1, D72.1, D74.1, D76.1, D78.1, D80.1, J2.2, J_DISPLAY1.1, J_DISPLAY1.8, J_DISPLAY1.12, J_DISPLAY1.MP (MountPin), J_DISPLAY2.1, J_DISPLAY2.8, J_DISPLAY2.12, J_DISPLAY3.1, J_DISPLAY3.5, J_DISPLAY3.12, J_DISPLAY3.MP (MountPin), J_EXT1.8, J_EXT1.11, J_EXT1.14, J_EXT1.17, J_EXT1.20, J_EXT1.23, J_EXT1.MP (MountPin), J_EXT2.8, J_EXT2.11, J_EXT2.14, J_EXT2.17, J_EXT2.20, J_EXT2.23, J_JTAG1.5, J_JTAG1.7, LED_DONE1.1 (K), R3.2, R5.2, R6.2, R11.2, R12.2, R15.2, U1.2 (VSS), U1.21 (VSS), U1.24 (VSS), U1.43 (VSS), U1.46 (VSS), U1.65 (VSS), U1.88 (IOT5A/MODE0), U1.89 (EXP), U2.3 (GND), U3.2 (GND), U4.4 (VSS), U6.3 (GND), U7.4 (GND), X1.2 (GND)
LINE: D3.2, D5.2, D7.2, D9.2, D10.2, D12.2, D14.2, D16.2, D18.2, D20.2, D22.2, D24.2, D26.2, D28.2, D30.2, D32.2, D34.2, D36.2, D38.2, D40.2, D42.2, D44.2, D46.2, D48.2, D50.2, D52.2, D54.2, D56.2, D58.2, D60.2, D62.2, D64.2, D66.2, D68.2, D70.2, D72.2, D74.2, D76.2, D78.2, D80.2, J2.1, JP4.2 (B)
unnamed: C2.1, JP1.1 (A), U2.1 (VO)
unnamed: C3.1, JP2.1 (A), R14.1, U3.5 (VOUT)
unnamed: C7.1, C8.1, JP3.1 (A), L1.2, R4.1
unnamed: LED_DONE1.2 (A), R1.2
unnamed: R12.1, U1.57 (IOR13A/FASTRD_N/D3)
unnamed: R14.2, R15.1, U3.4 (ADJ)
unnamed: C6.1, U6.4 (BST)
unnamed: R4.2, R5.1, U6.6 (FB)
unnamed: C6.2, L1.1, U6.2 (SW)

Notes on the sheet:
BS0
Issues reported with GoWin FPGAs: https://github.com/juj/gowin_flipflop_drainer
D/C#
Populate to enable fast read from external FLASH during boot
VBAT
Fixed
Something special about it
BS1
PCB cost seems to be $350 for setup including 4 layers and via-in-pad. That gives us about 100 boards for the same price (i.e. unit-cost is $0). For 1000 boards, we get $650 cost. Without via-in-pad, it seems we can have a 100 boards for $160 Assembly for the same seems to be around $400 for 100 pi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
RES#
GND
VCC power: assume less than 1W, probably significantly. VCCX/VCCIO power: assume 200mW or less
CS#
Clock considerations: - 2 PLLs with a secondary output divider each, only integer mode - PLL VCO is between 400 and 1000MHz for fast, 350 to 800 for slow devices - Internal clock is based on 105/125MHz (based on device) - There are CLKDIV resources that support 2/3.5/4/5/(8) divisor settings
Static input current for an LS gate is 0.1mA. This gives us <10mA static output current. We can sustain with an LDO See http://raven1.magix.net/Ti%20TTL%20DataBook%20vol1.pdf, page 20 https://ecelabs.njit.edu/fed101/resources/Motorola_Short_Version.pdf page 12 Detailed answer: https://electronics.s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
Dedicated pin
Pinout is reversed compared to datasheet due to use of bottom-contact connector
Needed to select JTAG config
Below 100mA (maybe even as low as 300mA) the switcher operaters in PFM mode with this inductor setting. A heavily utilized FPGA would on the order of 200mA. So, maybe a larger inductor is called for?
QN88 package is common between N4, N9, NR4 and NR9. N2 also supports this package, but very different pinout Carried by RuTronic, Mouser and these guys: https://www.edgeelectronics.com/fpga/?start=49
5V is trimmed to 4.5V
Display: https://www.crystalfontz.com/product/cfal12832c0091bw-small-oled-white-monochrome Other interesting displays: https://www.crystalfontz.com/product/cfaf80160a00096tn-80x160-small-color-tft-display https://www.crystalfontz.com/products/document/4618/CFAL64128B00096BWC_Datasheet.pdf
VDD

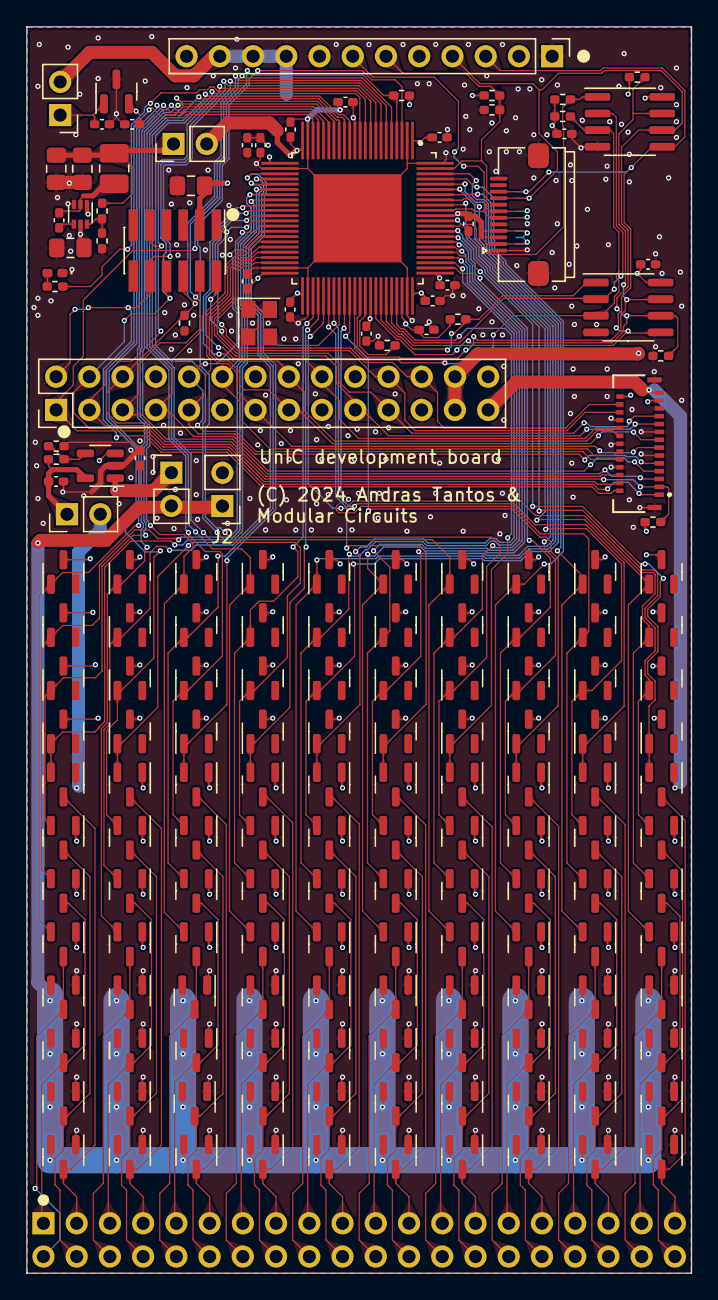
[picture p48: board devel_gw1.kicad_pcb from above]

Board: 2 copper layers, 50.8 x 95.2 mm, 181 parts (1 on the bottom side), 124 nets.
