andrastantos/unic/board_t13/unic_t13.kicad_pcb

## KiCad design board_t13/unic_t13.kicad_pcb (2023-12-11)

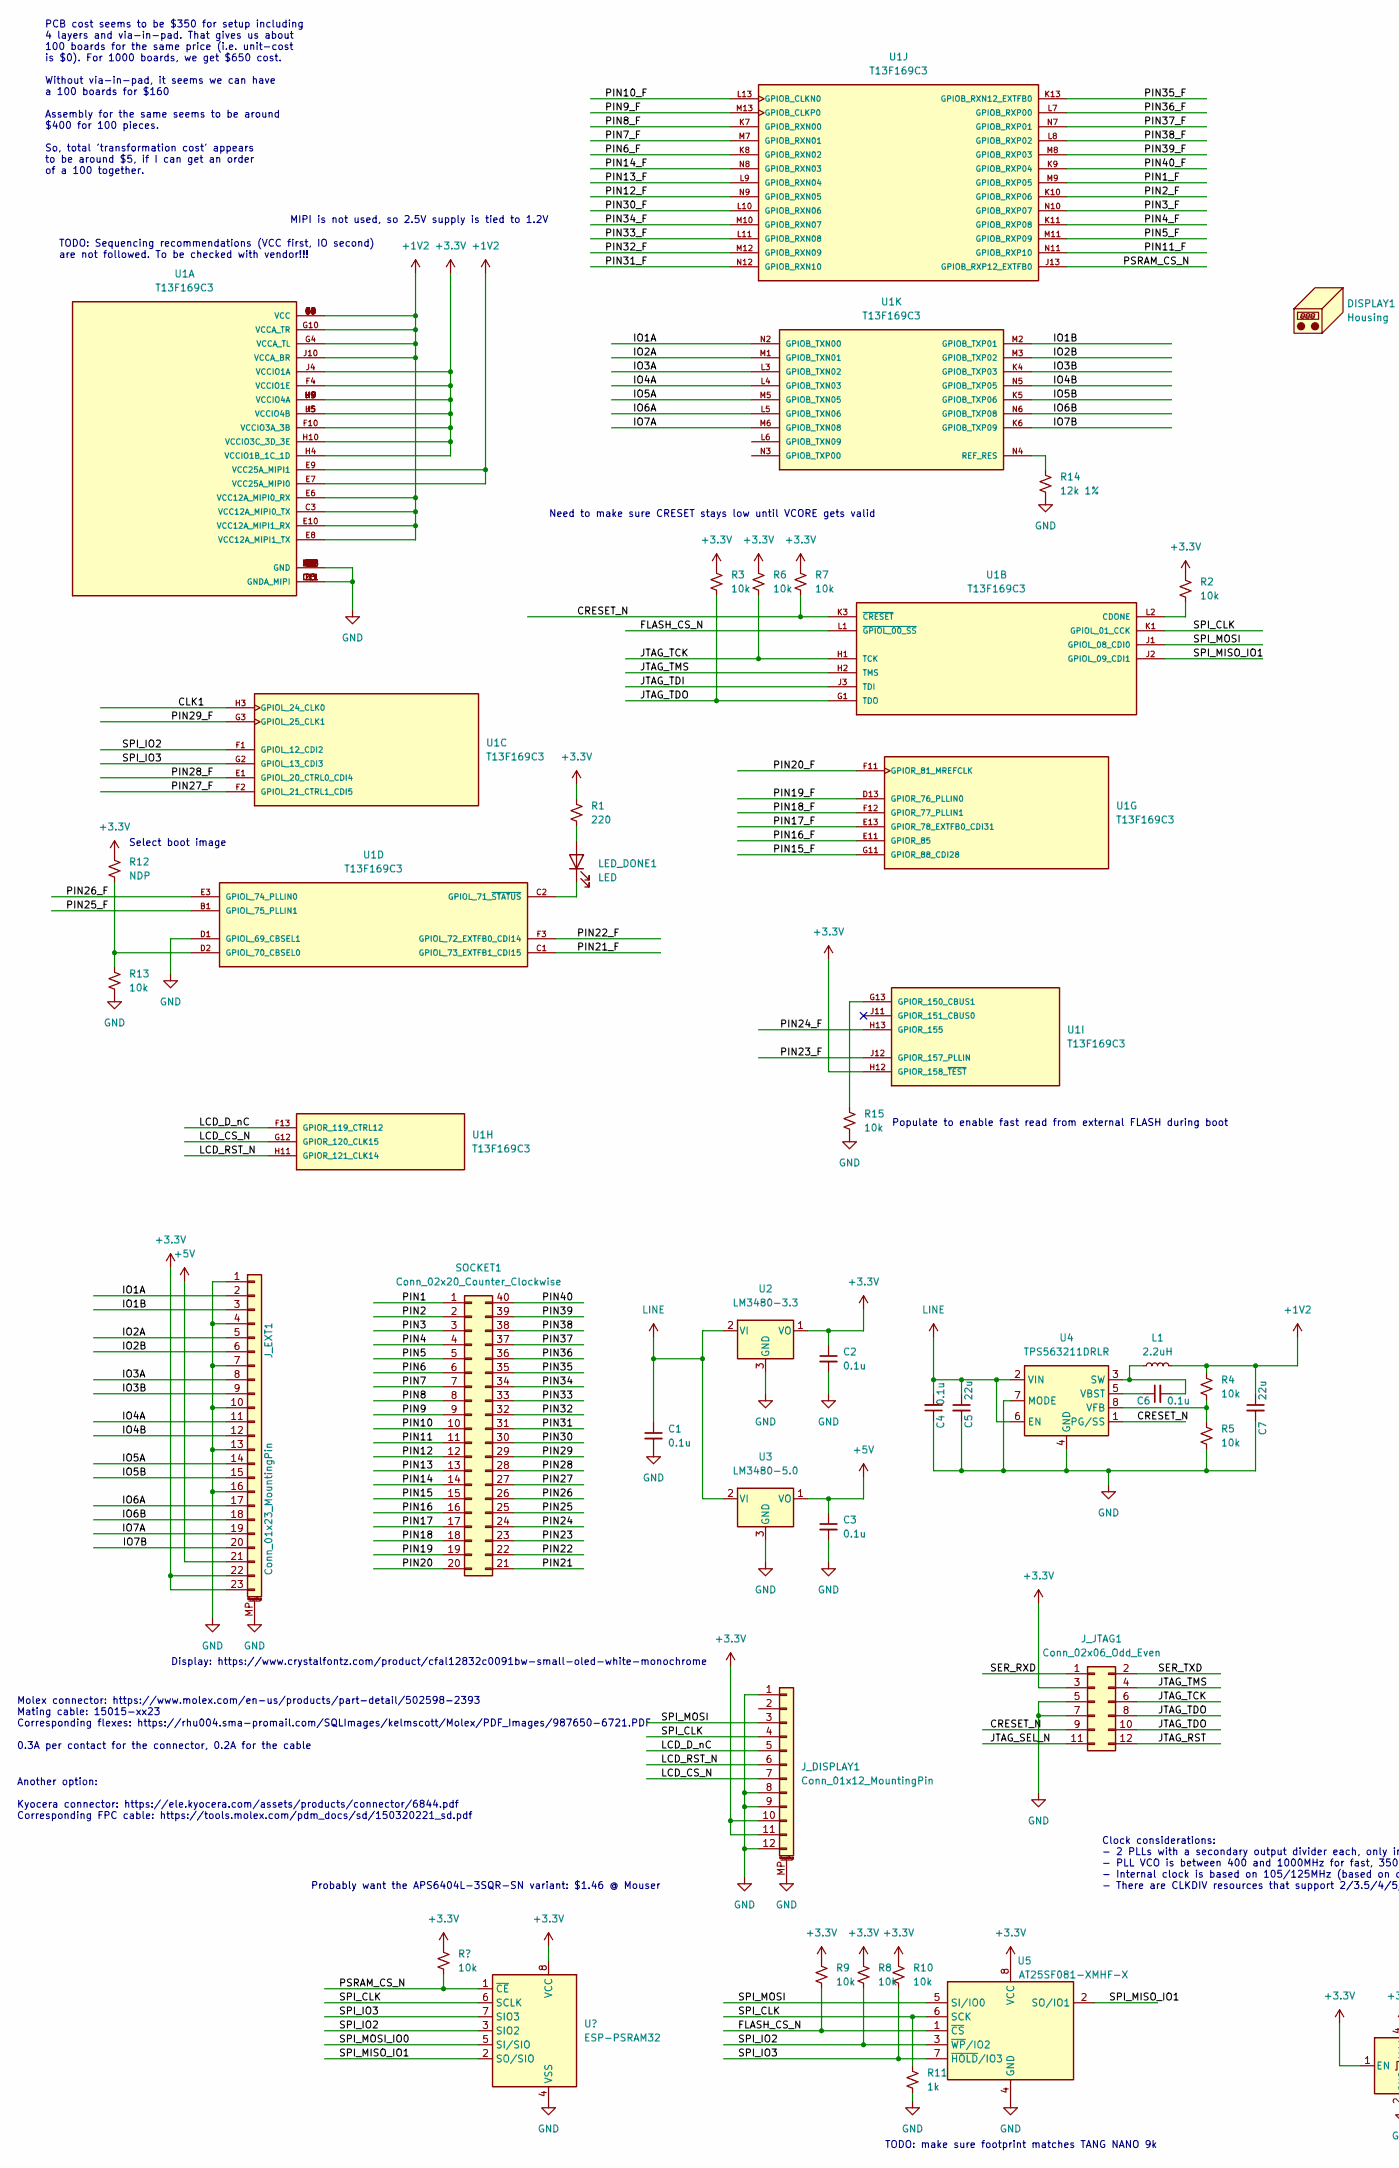
[picture p49: schematic unic_t13.kicad_sch, UNIC 40, part in row 1, column 1]

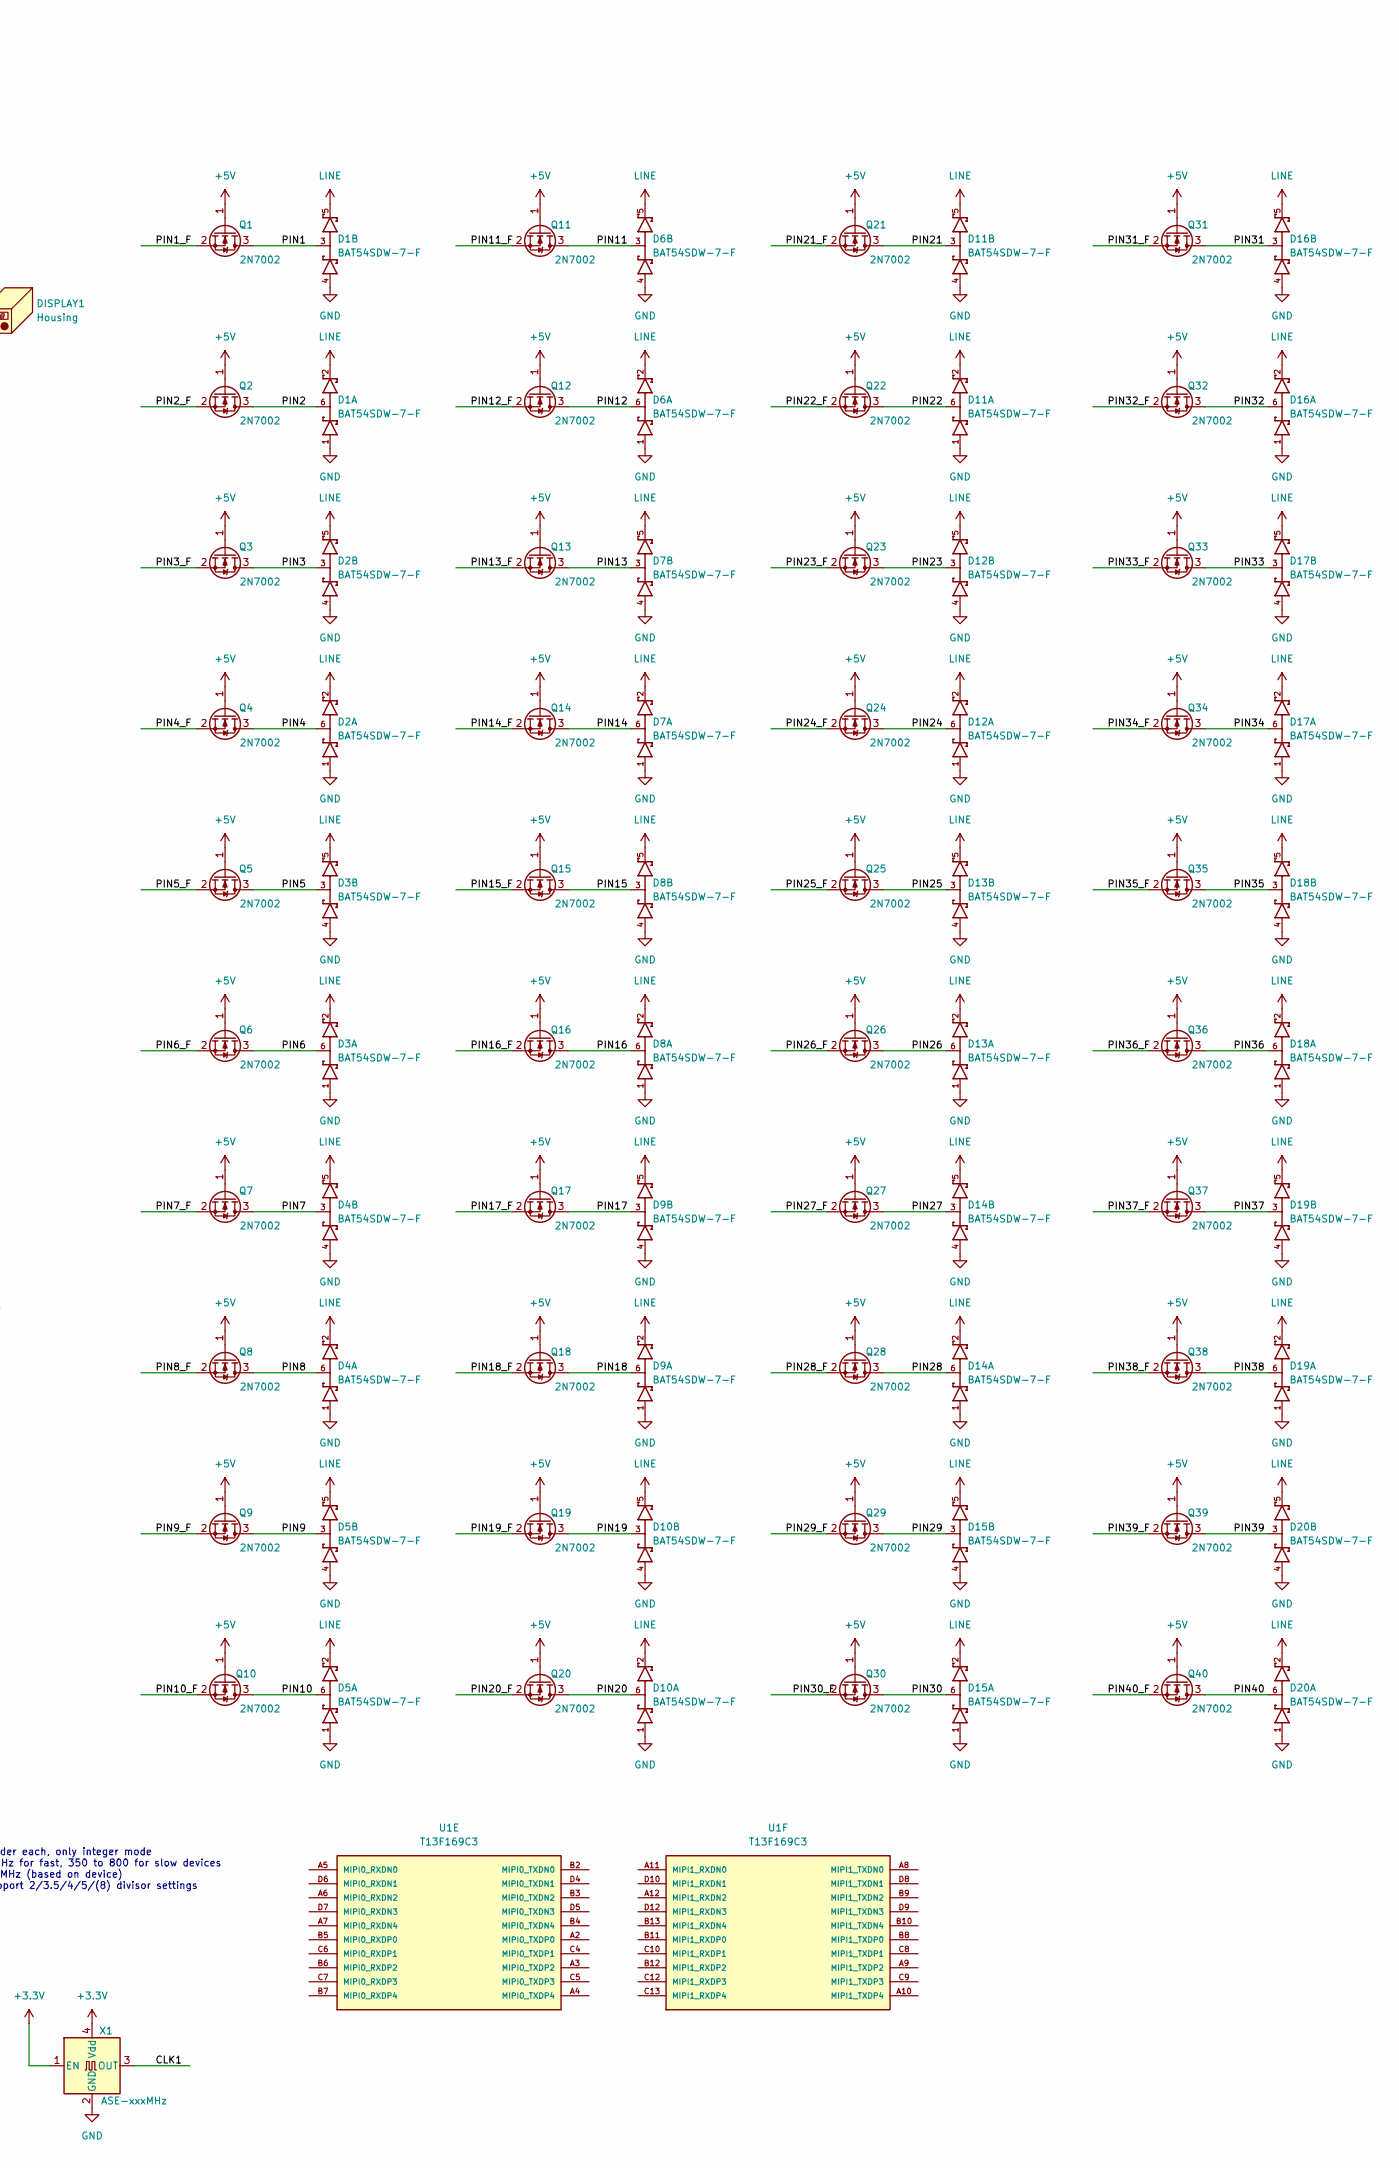
[picture p50: schematic unic_t13.kicad_sch, UNIC 40, part in row 1, column 2]

Parts:
C1, C2, C3, C4, C6: 0.1u; C_0402_1005Metric_Pad0.74x0.62mm_HandSolder
C5, C7: 22u; C_0805_2012Metric_Pad1.18x1.45mm_HandSolder
D1, D2, D3, D4, D5, D6, D7, D8, D9, D10, D11, D12, D13, D14, D15, D16, D17, D18, D19, D20: BAT54SDW-7-F; SOT65P210X110-6N; PARTREV 17 - 2
DISPLAY1: Housing; CFAL12832C-0091B-W_A
J_DISPLAY1: Conn_01x12_MountingPin; CF31121D0R0-05-NH
J_EXT1: Conn_01x23_MountingPin; Molex_502598-2393_2Rows-23Pins-1MP_P0.60mm_Horizontal
J_JTAG1: Conn_02x06_Odd_Even; PinHeader_2x06_P1.27mm_Vertical_SMD
L1: 2.2uH; L_1008_2520Metric_Pad1.43x2.20mm_HandSolder
LED_DONE1: LED; LED_0402_1005Metric_Pad0.77x0.64mm_HandSolder
Q1, Q2, Q3, Q4, Q5, Q6, Q7, Q8, Q9, Q10, Q11, Q12, Q13, Q14, Q15, Q16, Q17, Q18, Q19, Q20, Q21, Q22, Q23, Q24, Q25, Q26, Q27, Q28, Q29, Q30, Q31, Q32, Q33, Q34, Q35, Q36, Q37, Q38, Q39, Q40: 2N7002; Diodes_DFN1006-3
R1: 220; R_0402_1005Metric_Pad0.72x0.64mm_HandSolder
R2, R3, R4, R5, R6, R7, R8, R9, R10, R13, R15: 10k; R_0402_1005Metric_Pad0.72x0.64mm_HandSolder
R11: 1k; R_0402_1005Metric_Pad0.72x0.64mm_HandSolder
R12: NDP; R_0402_1005Metric_Pad0.72x0.64mm_HandSolder
R14: 12k 1%; R_0402_1005Metric_Pad0.72x0.64mm_HandSolder
SOCKET1: Conn_02x20_Counter_Clockwise; DIP-40_pin_header
U1: T13F169C3; BGA169C65P13X13_900X900X100; PARTREV v3.3
U2: LM3480-3.3; SOT-23
U3: LM3480-5.0; SOT-23
U4: TPS563211DRLR; SOT-583
U5: AT25SF081-XMHF-X; TSSOP-8_4.4x3mm_P0.65mm
X1: ASE-xxxMHz; Oscillator_SMD_Abracon_ASE-4Pin_3.2x2.5mm

Connections:
+1V2: C7.1, L1.2, R4.1, U1.C3 (VCC12A_MIPI0_TX), U1.E4 (VCC), U1.E6 (VCC12A_MIPI0_RX), U1.E7 (VCC25A_MIPI0), U1.E8 (VCC12A_MIPI1_TX), U1.E9 (VCC25A_MIPI1), U1.E10 (VCC12A_MIPI1_RX), U1.F7 (VCC), U1.F9 (VCC), U1.G4 (VCCA_TL), U1.G5 (VCC), U1.G8 (VCC), U1.G9 (VCC), U1.G10 (VCCA_TR), U1.H6 (VCC), U1.J6 (VCC), U1.J10 (VCCA_BR)
+3V3: C2.1, J_DISPLAY1.10, J_DISPLAY1.11, J_EXT1.22, J_EXT1.23, J_JTAG1.3, R1.1, R2.1, R3.1, R6.1, R7.1, R8.1, R9.1, R10.1, R12.1, U1.F4 (VCCIO1E), U1.F10 (VCCIO3A_3B), U1.H4 (VCCIO1B_1C_1D), U1.H5 (VCCIO4B), U1.H7 (VCCIO4A), U1.H8 (VCCIO4A), U1.H9 (VCCIO4A), U1.H10 (VCCIO3C_3D_3E), U1.H12 (GPIOR_158_~TEST), U1.J4 (VCCIO1A), U1.J5 (VCCIO4B), U1.J9 (VCCIO4A), U2.1 (VO), U5.8 (VCC), X1.1 (EN), X1.4 (Vdd)
+5V: C3.1, J_EXT1.21, Q1.1 (G), Q2.1 (G), Q3.1 (G), Q4.1 (G), Q5.1 (G), Q6.1 (G), Q7.1 (G), Q8.1 (G), Q9.1 (G), Q10.1 (G), Q11.1 (G), Q12.1 (G), Q13.1 (G), Q14.1 (G), Q15.1 (G), Q16.1 (G), Q17.1 (G), Q18.1 (G), Q19.1 (G), Q20.1 (G), Q21.1 (G), Q22.1 (G), Q23.1 (G), Q24.1 (G), Q25.1 (G), Q26.1 (G), Q27.1 (G), Q28.1 (G), Q29.1 (G), Q30.1 (G), Q31.1 (G), Q32.1 (G), Q33.1 (G), Q34.1 (G), Q35.1 (G), Q36.1 (G), Q37.1 (G), Q38.1 (G), Q39.1 (G), Q40.1 (G), U3.1 (VO)
/CLK1: U1.H3 (GPIOL_24_CLK0), X1.3 (OUT)
/CRESET_N: J_JTAG1.9, R7.2, U1.K3 (~CRESET), U4.1 (PG/SS)
/FLASH_CS_N: R9.2, U1.L1 (~GPIOL_00_SS), U5.1 (~CS)
/FLASH_IO2: R8.2, U1.F1 (GPIOL_12_CDI2), U5.3 (~WP/IO2)
/FLASH_IO3: R10.2, U1.G2 (GPIOL_13_CDI3), U5.7 (~HOLD/IO3)
/FLASH_MISO_IO1: U1.J2 (GPIOL_09_CDI1), U5.2 (SO/IO1)
/IO1A: J_EXT1.2, U1.N2 (GPIOB_TXN00)
/IO1B: J_EXT1.3, U1.M2 (GPIOB_TXP01)
/IO2A: J_EXT1.5, U1.M1 (GPIOB_TXN01)
/IO2B: J_EXT1.6, U1.M3 (GPIOB_TXP02)
/IO3A: J_EXT1.8, U1.L3 (GPIOB_TXN02)
/IO3B: J_EXT1.9, U1.K4 (GPIOB_TXP03)
/IO4A: J_EXT1.11, U1.L4 (GPIOB_TXN03)
/IO4B: J_EXT1.12, U1.N5 (GPIOB_TXP05)
/IO5A: J_EXT1.14, U1.M5 (GPIOB_TXN05)
/IO5B: J_EXT1.15, U1.K5 (GPIOB_TXP06)
/IO6A: J_EXT1.17, U1.L5 (GPIOB_TXN06)
/IO6B: J_EXT1.18, U1.N6 (GPIOB_TXP08)
/IO7A: J_EXT1.19, U1.M6 (GPIOB_TXN08)
/IO7B: J_EXT1.20, U1.K6 (GPIOB_TXP09)
/JTAG_RST: J_JTAG1.12
/JTAG_SEL_N: J_JTAG1.11
/JTAG_TCK: J_JTAG1.6, R6.2, U1.H1 (TCK)
/JTAG_TDI: U1.J3 (TDI)
/JTAG_TDO: J_JTAG1.8, J_JTAG1.10, R3.2, U1.G1 (TDO)
/JTAG_TMS: J_JTAG1.4, U1.H2 (TMS)
/LCD_CS_N: J_DISPLAY1.7, U1.G12 (GPIOR_120_CLK15)
/LCD_D_nC: J_DISPLAY1.5, U1.F13 (GPIOR_119_CTRL12)
/LCD_RST_N: J_DISPLAY1.6, U1.H11 (GPIOR_121_CLK14)
/PIN1: D1.3, Q1.3 (D), SOCKET1.1
/PIN1_F: Q1.2 (S), U1.M9 (GPIOB_RXP05)
/PIN2: D1.6, Q2.3 (D), SOCKET1.2
/PIN2_F: Q2.2 (S), U1.K10 (GPIOB_RXP06)
/PIN3: D2.3, Q3.3 (D), SOCKET1.3
/PIN3_F: Q3.2 (S), U1.N10 (GPIOB_RXP07)
/PIN4: D2.6, Q4.3 (D), SOCKET1.4
/PIN4_F: Q4.2 (S), U1.K11 (GPIOB_RXP08)
/PIN5: D3.3, Q5.3 (D), SOCKET1.5
/PIN5_F: Q5.2 (S), U1.M11 (GPIOB_RXP09)
/PIN6: D3.6, Q6.3 (D), SOCKET1.6
/PIN6_F: Q6.2 (S), U1.K8 (GPIOB_RXN02)
/PIN7: D4.3, Q7.3 (D), SOCKET1.7
/PIN7_F: Q7.2 (S), U1.M7 (GPIOB_RXN01)
/PIN8: D4.6, Q8.3 (D), SOCKET1.8
/PIN8_F: Q8.2 (S), U1.K7 (GPIOB_RXN00)
/PIN9: D5.3, Q9.3 (D), SOCKET1.9
/PIN9_F: Q9.2 (S), U1.M13 (GPIOB_CLKP0)
/PIN10: D5.6, Q10.3 (D), SOCKET1.10
/PIN10_F: Q10.2 (S), U1.L13 (GPIOB_CLKN0)
/PIN11: D6.3, Q11.3 (D), SOCKET1.11
/PIN11_F: Q11.2 (S), U1.N11 (GPIOB_RXP10)
/PIN12: D6.6, Q12.3 (D), SOCKET1.12
/PIN12_F: Q12.2 (S), U1.N9 (GPIOB_RXN05)
/PIN13: D7.3, Q13.3 (D), SOCKET1.13
/PIN13_F: Q13.2 (S), U1.L9 (GPIOB_RXN04)
/PIN14: D7.6, Q14.3 (D), SOCKET1.14
/PIN14_F: Q14.2 (S), U1.N8 (GPIOB_RXN03)
/PIN15: D8.3, Q15.3 (D), SOCKET1.15
/PIN15_F: Q15.2 (S), U1.G11 (GPIOR_88_CDI28)
/PIN16: D8.6, Q16.3 (D), SOCKET1.16
/PIN16_F: Q16.2 (S), U1.E11 (GPIOR_85)
/PIN17: D9.3, Q17.3 (D), SOCKET1.17
/PIN17_F: Q17.2 (S), U1.E13 (GPIOR_78_EXTFB0_CDI31)
/PIN18: D9.6, Q18.3 (D), SOCKET1.18
/PIN18_F: Q18.2 (S), U1.F12 (GPIOR_77_PLLIN1)
/PIN19: D10.3, Q19.3 (D), SOCKET1.19
/PIN19_F: Q19.2 (S), U1.D13 (GPIOR_76_PLLIN0)
/PIN20: D10.6, Q20.3 (D), SOCKET1.20
/PIN20_F: Q20.2 (S), U1.F11 (GPIOR_81_MREFCLK)
/PIN21: D11.3, Q21.3 (D), SOCKET1.21
/PIN21_F: Q21.2 (S), U1.C1 (GPIOL_73_EXTFB1_CDI15)
/PIN22: D11.6, Q22.3 (D), SOCKET1.22
/PIN22_F: Q22.2 (S), U1.F3 (GPIOL_72_EXTFB0_CDI14)
/PIN23: D12.3, Q23.3 (D), SOCKET1.23
/PIN23_F: Q23.2 (S), U1.J12 (GPIOR_157_PLLIN)
/PIN24: D12.6, Q24.3 (D), SOCKET1.24
/PIN24_F: Q24.2 (S), U1.H13 (GPIOR_155)
/PIN25: D13.3, Q25.3 (D), SOCKET1.25
/PIN25_F: Q25.2 (S), U1.B1 (GPIOL_75_PLLIN1)
/PIN26: D13.6, Q26.3 (D), SOCKET1.26
/PIN26_F: Q26.2 (S), U1.E3 (GPIOL_74_PLLIN0)
/PIN27: D14.3, Q27.3 (D), SOCKET1.27
/PIN27_F: Q27.2 (S), U1.F2 (GPIOL_21_CTRL1_CDI5)
/PIN28: D14.6, Q28.3 (D), SOCKET1.28
/PIN28_F: Q28.2 (S), U1.E1 (GPIOL_20_CTRL0_CDI4)
/PIN29: D15.3, Q29.3 (D), SOCKET1.29
/PIN29_F: Q29.2 (S), U1.G3 (GPIOL_25_CLK1)
/PIN30: D15.6, Q30.3 (D), SOCKET1.30
/PIN30_F: Q30.2 (S), U1.L10 (GPIOB_RXN06)
/PIN31: D16.3, Q31.3 (D), SOCKET1.31
/PIN31_F: Q31.2 (S), U1.N12 (GPIOB_RXN10)
/PIN32: D16.6, Q32.3 (D), SOCKET1.32
/PIN32_F: Q32.2 (S), U1.M12 (GPIOB_RXN09)
/PIN33: D17.3, Q33.3 (D), SOCKET1.33
/PIN33_F: Q33.2 (S), U1.L11 (GPIOB_RXN08)
/PIN34: D17.6, Q34.3 (D), SOCKET1.34
/PIN34_F: Q34.2 (S), U1.M10 (GPIOB_RXN07)
/PIN35: D18.3, Q35.3 (D), SOCKET1.35
/PIN35_F: Q35.2 (S), U1.K13 (GPIOB_RXN12_EXTFB0)
/PIN36: D18.6, Q36.3 (D), SOCKET1.36
/PIN36_F: Q36.2 (S), U1.L7 (GPIOB_RXP00)
/PIN37: D19.3, Q37.3 (D), SOCKET1.37
/PIN37_F: Q37.2 (S), U1.N7 (GPIOB_RXP01)
/PIN38: D19.6, Q38.3 (D), SOCKET1.38
/PIN38_F: Q38.2 (S), U1.L8 (GPIOB_RXP02)
/PIN39: D20.3, Q39.3 (D), SOCKET1.39
/PIN39_F: Q39.2 (S), U1.M8 (GPIOB_RXP03)
/PIN40: D20.6, Q40.3 (D), SOCKET1.40
/PIN40_F: Q40.2 (S), U1.K9 (GPIOB_RXP04)
/SER_RXD: J_JTAG1.1
/SER_TXD: J_JTAG1.2
/SPI_CLK: J_DISPLAY1.4, R11.1, U1.K1 (GPIOL_01_CCK), U5.6 (SCK)
/SPI_MOSI: J_DISPLAY1.3, U1.J1 (GPIOL_08_CDI0), U5.5 (SI/IO0)
GND: C1.2, C2.2, C3.2, C4.1, C5.2, C7.2, D1.1, D1.4, D2.1, D2.4, D3.1, D3.4, D4.1, D4.4, D5.1, D5.4, D6.1, D6.4, D7.1, D7.4, D8.1, D8.4, D9.1, D9.4, D10.1, D10.4, D11.1, D11.4, D12.1, D12.4, D13.1, D13.4, D14.1, D14.4, D15.1, D15.4, D16.1, D16.4, D17.1, D17.4, D18.1, D18.4, D19.1, D19.4, D20.1, D20.4, J_DISPLAY1.1, J_DISPLAY1.8, J_DISPLAY1.9, J_DISPLAY1.12, J_DISPLAY1.MP (MountPin), J_EXT1.1, J_EXT1.4, J_EXT1.7, J_EXT1.10, J_EXT1.13, J_EXT1.16, J_EXT1.MP (MountPin), J_JTAG1.5, J_JTAG1.7, R5.2, R11.2, R13.2, R14.2, R15.2, U1.A1 (GND), U1.A13 (GND), U1.C11 (GNDA_MIPI), U1.D1 (GPIOL_69_CBSEL1), U1.D3 (GNDA_MIPI), U1.D11 (GNDA_MIPI), U1.E2 (GND), U1.E5 (GNDA_MIPI), U1.E12 (GND), U1.F5 (GND), U1.F6 (GND), U1.F8 (GND), U1.G6 (GND), U1.G7 (GND), U1.J7 (GND), U1.J8 (GND), U1.K2 (GND), U1.K12 (GND), U1.L12 (GND), U1.M4 (GND), U1.N1 (GND), U1.N13 (GND), U2.3 (GND), U3.3 (GND), U4.4 (GND), U4.7 (MODE), U5.4 (GND), X1.2 (GND)
LINE: C1.1, C4.2, C5.1, D1.2, D1.5, D2.2, D2.5, D3.2, D3.5, D4.2, D4.5, D5.2, D5.5, D6.2, D6.5, D7.2, D7.5, D8.2, D8.5, D9.2, D9.5, D10.2, D10.5, D11.2, D11.5, D12.2, D12.5, D13.2, D13.5, D14.2, D14.5, D15.2, D15.5, D16.2, D16.5, D17.2, D17.5, D18.2, D18.5, D19.2, D19.5, D20.2, D20.5, U2.2 (VI), U3.2 (VI), U4.2 (VIN), U4.6 (EN)
unnamed: C6.1, U4.5 (VBST)
unnamed: C6.2, L1.1, U4.3 (SW)
unnamed: LED_DONE1.2 (A), R1.2
unnamed: R4.2, R5.1, U4.8 (VFB)
unnamed: LED_DONE1.1 (K), U1.C2 (GPIOL_71_~STATUS)
unnamed: R12.2, R13.1, U1.D2 (GPIOL_70_CBSEL0)
unnamed: R15.1, U1.G13 (GPIOR_150_CBUS1)
unnamed: R2.2, U1.L2 (CDONE)
unnamed: R14.1, U1.N4 (REF_RES)

Notes on the sheet:
Populate to enable fast read from external FLASH during boot
PCB cost seems to be $350 for setup including 4 layers and via-in-pad. That gives us about 100 boards for the same price (i.e. unit-cost is $0). For 1000 boards, we get $650 cost. Without via-in-pad, it seems we can have a 100 boards for $160 Assembly for the same seems to be around $400 for 100 pi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
Molex connector: https://www.molex.com/en-us/products/part-detail/502598-2393 Mating cable: 15015-xx23 Corresponding flexes: https://rhu004.sma-promail.com/SQLImages/kelmscott/Molex/PDF_Images/987650-6721.PDF 0.3A per contact for the connector, 0.2A for the cable
Another option: Kyocera connector: https://ele.kyocera.com/assets/products/connector/6844.pdf Corresponding FPC cable: https://tools.molex.com/pdm_docs/sd/150320221_sd.pdf
Clock considerations: - 2 PLLs with a secondary output divider each, only integer mode - PLL VCO is between 400 and 1000MHz for fast, 350 to 800 for slow devices - Internal clock is based on 105/125MHz (based on device) - There are CLKDIV resources that support 2/3.5/4/5/(8) divisor settings
Select boot image
TODO: Sequencing recommendations (VCC first, IO second) are not followed. To be checked with vendor!!!
Need to make sure CRESET stays low until VCORE gets valid
Probably want the APS6404L-3SQR-SN variant: $1.46 @ Mouser
TODO: make sure footprint matches TANG NANO 9k
Display: https://www.crystalfontz.com/product/cfal12832c0091bw-small-oled-white-monochrome
MIPI is not used, so 2.5V supply is tied to 1.2V

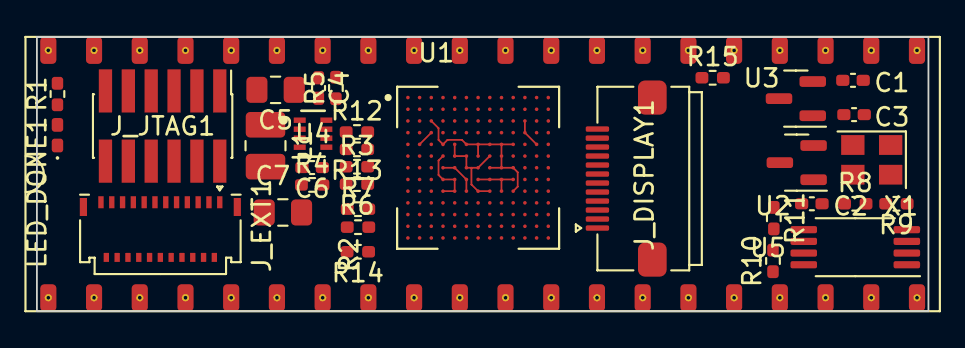
[picture p51: board unic_t13.kicad_pcb from above]

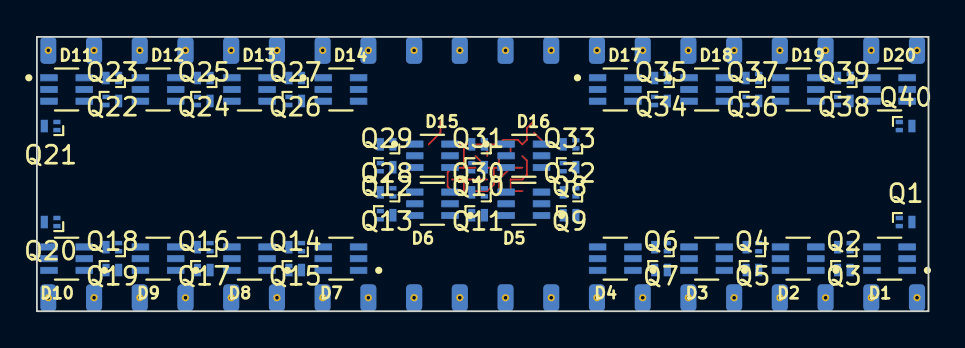
[picture p52: board unic_t13.kicad_pcb from below]

Board: 4 copper layers, 49.5 x 15.2 mm, 96 parts (60 on the bottom side), 122 nets.

Other parts of the board:
DISPLAY1#2: Housing; CFAL12832C-0091B-W_A
