andrastantos/unic/(commit log)

2023-05-09 Unic project started.
    [unic.kicad_pcb, unic.kicad_sch]
2023-05-11 PCB file for unic
2023-05-11 Various datasheets added.
    [UG105-1.8.3E_GW1N-4 Pinout.xlsx, UG114-1.6.1E_GW1N-9 Pinout.xlsx]
2023-06-26 More info on protection circuits.
2023-12-11 Much missing stuff added back
    [GW1N_GowinPowerEstimator_V1.xlsx, Gowin_GPE_GW2A_v1.2.xlsx, UG105-1.8.3E_GW1N-4 Pinout.xlsx, UG114-1.6.1E_GW1N-9 Pinout.xlsx, UG168-1.2E_GW2A-18 & GW1N-9 FPGA Products Packages Compatibility Comparison.xlsx, UG169-1.2E_GW2A-18 & GW1N-4 FPGA Products Packages Compatibility Comparison.xlsx, extender_boards.ods, unic.kicad_pcb]
2023-12-11 Added ESD diode from within FPGA.
    There is a transient on this diode when
    driven high hard from an external source.
    The length of the transient is about 7ns.
2023-12-13 Added extra diodes to shunt ESD path.
    [unic_gw1.kicad_pcb, unic_gw1.kicad_sch]
2023-12-13 More simulation of high-voltage transients.
2023-12-19 GW1-based board is fully routed. Cleanup still needed!
    [unic_gw1.kicad_pcb, unic_gw1.kicad_sch]
2023-12-20 Much more GoWin documentation.
    [UG803-1.6.3E_GW1NR-9 Pinout.xlsx, UG985-1.4.1E_GW5A-25 Pinout.xlsx]
2023-12-20 Small fixes to board file
    [unic_gw1.kicad_pcb]
2023-12-20 Migrated to KiCad 7.
    [unic_gw1.kicad_pcb, unic_gw1.kicad_sch]
2023-12-20 Fixed GoWin part footprint reference.
2023-12-21 Board more or less done.
    [unic_gw1.kicad_pcb]
2023-12-25 Development board more or less done.
    [devel_gw1.kicad_pcb, devel_gw1.kicad_sch]
2023-12-25 Library changes related to development board.
2023-12-26 DIP adapter board for development board.
    [devel_adapter.kicad_pcb, devel_adapter.kicad_sch]
2023-12-26 Adapter board is production ready
    [devel_adapter-B_Cu.gbr, devel_adapter-B_Mask.gbr, devel_adapter-Edge_Cuts.gbr, devel_adapter-F_Cu.gbr, devel_adapter-F_Mask.gbr, devel_adapter-F_Silkscreen.gbr, devel_adapter-NPTH.drl, devel_adapter-PTH.drl]
2023-12-26 Devel board is production ready
    [devel_gw1-B_Cu.gbr, devel_gw1-B_Mask.gbr, devel_gw1-Edge_Cuts.gbr, devel_gw1-F_Cu.gbr, devel_gw1-F_Mask.gbr, devel_gw1-F_Silkscreen.gbr, devel_gw1-NPTH.drl, devel_gw1-PTH.drl]
2023-12-27 Added power input connector
    [devel_gw1.kicad_pcb, devel_gw1.kicad_sch]
2023-12-27 Added power jack with 3D model
2023-12-28 Replaced TSSOP FLASH with SO-8 one due to availability concerns.
    [devel_gw1-B_Cu.gbr, devel_gw1-B_Mask.gbr, devel_gw1-Edge_Cuts.gbr, devel_gw1-F_Cu.gbr, devel_gw1-F_Mask.gbr, devel_gw1-F_Silkscreen.gbr, devel_gw1-NPTH.drl, devel_gw1-PTH.drl]
2023-12-29 Updated FLASH part to package that's actually available.
    [unic_gw1.kicad_pcb, unic_gw1.kicad_sch]
2023-12-29 Updated footprints for LCD connector and PSRAM
    [unic_gw1.kicad_pcb, unic_gw1.kicad_sch]
2023-12-29 Populated part numbers for most parts.
    [devel_gw1.kicad_pcb, devel_gw1.kicad_sch]
2023-12-30 Reworked switcher components and layout.
    [unic_gw1.kicad_pcb, unic_gw1.kicad_sch]
2023-12-30 Switched back to 0805 caps: they're cheaper. TODO: part number updates.
    [unic_gw1.kicad_pcb, unic_gw1.kicad_sch]
2024-01-04 Ready to roll with DEVEL board!
    [devel_adapter-B_Cu.gbr, devel_adapter-B_Mask.gbr, devel_adapter-Edge_Cuts.gbr, devel_adapter-F_Cu.gbr, devel_adapter-F_Mask.gbr, devel_adapter-F_Silkscreen.gbr, devel_adapter-NPTH.drl, devel_adapter-PTH.drl]
2024-02-12 Devel updates.
    [devel_gw1.kicad_sch, dip64_gw.kicad_pcb, dip64_gw.kicad_sch]
2024-02-12 BOM checked in
    [devel_gw1_bom.xlsx]
2024-02-12 First FPGA project.
    This is also an attempt at a universal CST file, but the toolset is too
    brain-dead to allow for that. I will have to auto-generate this from
    a template once the Python flow is worked out.
2024-02-12 Some updated to UNIC GW1 based on post-release learnings.
    [unic_gw1.kicad_sch]
2024-02-15 Added PNG parser to OLED driver; added logo as well.
2024-02-16 Some outstanding changes to T13 board
2024-03-26 Simulation circuit updates.
2024-04-30 Updated board file; started cover CAD.
    This checkin marks the hopefully complete V1.0 design for the form-factor
    board.
    It also contains the first (incomplete) iteration of the cover design.
    It has a bunch of interference with components on the PCB which
    needs to be cleaned. It's also unclear if snaps have to be 1.5mm thick.
    Seems excessive. Finally, I don't think the OLED display can even survive
    such stiff snaps. But it at least a start.
    [cover.FCStd, unic_gw1.kicad_pcb, unic_gw1.kicad_sch]
2024-05-01 Added test-points, edge clearance, some cleanup.
    [unic_gw1.kicad_pcb, unic_gw1.kicad_sch]
2024-05-03 Added fiducials and some other flourishes.
    [unic_gw1.kicad_pcb, unic_gw1.kicad_sch]
2024-05-05 Lots of (local) footprint cleanup and readying for board release.
    [unic_gw1.kicad_pcb, unic_gw1.kicad_sch]
2024-05-05 DRC-clean DIP-40 header.
    [unic_gw1.kicad_pcb]
2024-05-05 Fixed some footprints, fab drawings.
    [unic_gw1.kicad_pcb, unic_gw1.kicad_sch]
2024-05-31 Fixed GoWin part number
    [unic_gw1.kicad_sch]
2024-05-31 Release files.
    [unic_gw1-B_Cu.gbr, unic_gw1-B_Fab.gbr, unic_gw1-B_Mask.gbr, unic_gw1-B_Paste.gbr, unic_gw1-B_Silkscreen.gbr, unic_gw1-Edge_Cuts.gbr, unic_gw1-F_Cu.gbr, unic_gw1-F_Fab.gbr]
2024-05-31 Documentation drawings
    [docs.kicad_pcb, docs.kicad_sch]
2024-06-05 Changed PCB to match that of manufacturing:
    1. Removed solder paste from U1 (as it will be hand-soldered).
    2. Changed vias to have pads on top/bottom.
    [unic_gw1.kicad_pcb]
2024-08-04 ECO for switcher part change
    [unic_gw1.kicad_sch]
2024-08-09 New diodes are added
    PCB is also fixed up, but fab notes
    need cleaning. Also, I need to select
    an actual diode.
    [unic_gw1.kicad_pcb, unic_gw1.kicad_sch]
2024-08-09 Updated diode part and footprint.
    [unic_gw1.kicad_pcb, unic_gw1.kicad_sch]
2024-08-09 Fixed fab notes
    [unic_gw1.kicad_pcb]
2024-08-12 Started RP2350-based UnIC.
    [unic_rp.kicad_pcb, unic_rp.kicad_sch]
2024-08-12 Some diode simulations.
2024-08-12 Small DIP exercises.
    [unic_gw1_mini.kicad_pcb]
2024-08-12 More work towards RP based UnIC
    The IO connections are mostly figured out, component placement
    as well. Still need new inductor, proper XTAL, USB and of course
    a lot of routing, including power.
    [unic_rp.kicad_pcb, unic_rp.kicad_sch]
2024-08-13 More work towards UnIC-RP. This time power supplies are cleaned up a bit.
    [unic_rp.kicad_pcb, unic_rp.kicad_sch]
2024-08-13 Some notes about SWDBG over USB-C
    [unic_rp.kicad_sch]
2024-08-13 Much more complet RP schematic.
    The USB-based debug setup is now drawn up. Component
    placement is also complete. A thorough review is needed
    especially on component footprints!
    [unic_rp.kicad_pcb, unic_rp.kicad_sch]
2024-08-14 Missed USB connector model.
2024-08-14 More work towards routing RP board.
    [unic_rp.kicad_pcb]
2024-08-15 More or less complete schematic.
    Component selection is not final, but functionality around
    USB-C connector is. We even have UART output on it now as
    well as USB VBUS detection and control on the right pins.
    [unic_rp.kicad_pcb, unic_rp.kicad_sch]
2024-08-15 Component selection I think now is complete.
    [unic_rp.kicad_pcb, unic_rp.kicad_sch]
2024-08-15 Board fully routed except for power.
    [unic_rp.kicad_pcb]
2024-08-16 Work towards power routing
    [unic_rp.kicad_pcb]
2024-08-16 More or less complete routing.
    There are a few clearance violations with NPTH that doesn't
    make sense. Also, power planes are not in yet, only wires.
    [unic_rp.kicad_pcb, unic_rp.kicad_sch]
2024-08-18 Shadow tracer board.
    This is a board that (with the proper core) can shadow a to-be-simulated
    IC with its UnIC equivalent and trigger on any waveform mismatches.
    It can be used to quickly track down differences in behavior between
    the real and the UnIC versions of implementations.
    [shadow_tracer.kicad_pcb, shadow_tracer.kicad_sch]
2024-08-19 Diode upgrade PCB.
    This little guy would go underneath a UnIC V1.0 board
    and upgrade all the diodes with proper Schottky ones.
    Then GND and LINE wold need to be blue-wired over to
    UnIC to make the whole contraption work.
    [diode_upgrade-B_Cu.gbr, diode_upgrade-B_Mask.gbr, diode_upgrade-Edge_Cuts.gbr, diode_upgrade-F_Cu.gbr, diode_upgrade-F_Mask.gbr, diode_upgrade-NPTH.drl, diode_upgrade-PTH.drl, diode_upgrade-job.gbrjob]
2024-08-20 Programmer more or less complete.
    Missing LEDs, I guess.
    [programmer.kicad_pcb, programmer.kicad_sch]
2024-08-20 Release package for programmer.
    [programmer-B_Cu.gbr, programmer-B_Mask.gbr, programmer-Edge_Cuts.gbr, programmer-F_Cu.gbr, programmer-F_Mask.gbr, programmer-F_Silkscreen.gbr, programmer-NPTH.drl, programmer-PTH.drl]
2024-08-20 True release package for programmer.
    [programmer-B_Cu.gbr, programmer-B_Mask.gbr, programmer-Edge_Cuts.gbr, programmer-F_Cu.gbr, programmer-F_Mask.gbr, programmer-F_Silkscreen.gbr, programmer-NPTH.drl, programmer-PTH.drl]
2024-08-21 Added BOM notes
    [programmer.kicad_sch]
2024-08-21 Shadow tracer release package.
    [shadow_tracer-B_Cu.gbr, shadow_tracer-B_Mask.gbr, shadow_tracer-B_Silkscreen.gbr, shadow_tracer-Edge_Cuts.gbr, shadow_tracer-F_Cu.gbr, shadow_tracer-F_Mask.gbr, shadow_tracer-F_Silkscreen.gbr, shadow_tracer-NPTH.drl]
2024-09-03 Much UnIC RP cleanup.
    [unic_rp.kicad_pcb, unic_rp.kicad_sch]
2024-09-04 Second programmer variant.
    [programmer2.kicad_pcb, programmer2.kicad_sch]
2024-09-04 Finished programmer 2.
    [programmer2.kicad_pcb, programmer2.kicad_sch]
2024-09-04 Beautified schematic and PCB for programmer 2.
    [programmer2.kicad_pcb, programmer2.kicad_sch]
2024-09-08 Programmer bring-up changes and notes
    [programmer-B_Cu.gbr, programmer-B_Mask.gbr, programmer-Edge_Cuts.gbr, programmer-F_Cu.gbr, programmer-F_Mask.gbr, programmer-F_Silkscreen.gbr, programmer-NPTH.drl, programmer-PTH.drl]
2024-09-08 Updated programmer schematic and PCBs.
    All known changes are incorporated.
    p.s.: I decided to stick with this rather sketchy LDO.
    The reason for this is that it's heatsink tab is connected
    to VCC, which happens to be the fill on the top layer
    so a GND-connected alternative would be less well cooled.
    [programmer.kicad_pcb, programmer.kicad_sch, programmer2.kicad_pcb, programmer2.kicad_sch]
2024-09-13 Some quick schematic beautification.
    [shadow_tracer.kicad_sch]
2024-09-27 Started Z80 sampler project.
    [z80_sampler.kicad_pcb, z80_sampler.kicad_sch]
2024-09-29 Z80 sampler project complete.
    [z80_sampler.kicad_pcb, z80_sampler.kicad_sch]
2024-10-23 Release package
    [z80_sampler-B_Cu.gbr, z80_sampler-B_Mask.gbr, z80_sampler-Edge_Cuts.gbr, z80_sampler-F_Cu.gbr, z80_sampler-F_Mask.gbr, z80_sampler-F_Silkscreen.gbr, z80_sampler-NPTH.drl, z80_sampler-PTH.drl]
2025-01-09 cover has now some room for pins
    [cover.FCStd]
2025-01-10 Started integrated USB programmer variant of UnIC.
    This is far from done, but shows some hope for fitting.
    [board_gw1_usb.kicad_pcb, board_gw1_usb.kicad_sch]
2025-01-10 Added new OLED display "datasheet".
    This should be more or less functionally compatible to the
    old one, but much more widely available and cheaper (on AliBaba), being the form factor that's used in the Ledger
    nano S thingy.
    It is configured as 4-wire SPI (i.e. separate C/D pin), which is a
    bit of a bummer, but what can you do.
2025-01-10 Some small outstanding changes.
    [z80_sampler.kicad_sch]
2025-01-10 Whops, failed to save schematic before commit.
    [board_gw1_usb.kicad_sch]
2025-01-10 Integrated JTAG controller mostly routed.
    There are still some keepout violations and power nets
    are incomplete, but at least there's a light at the end
    if the tunnel.
    [board_gw1_usb.kicad_pcb, board_gw1_usb.kicad_sch]
2025-01-13 UnIC with FT232H is fully routed.
    Not all that nicely, power needs a lot more work. But at least
    connectivity is there.
    [board_gw1_usb.kicad_pcb, board_gw1_usb.kicad_sch]
2025-01-13 UnIC wuth ISB (V2.0) is pretty much complete.
    [board_gw1_usb.kicad_pcb, board_gw1_usb.kicad_sch]
2025-01-14 Brought UnIC V1 up to date with latest changes.
    Updated OLED display connector and pinout
    Added DC/DC 33pF cap
    Added keepouts on bottom side for case clamps
    [unic_gw1.kicad_pcb, unic_gw1.kicad_sch]
2025-01-14 Small keepout shape cleanup on UnIC V2
    [board_gw1_usb.kicad_pcb]
2025-01-17 Some cleanup
    [board_gw1_usb.kicad_pcb]
2025-01-17 Some progress towards 32-pin UnIC variant.
    Components are more or less placed, routing is not done.
    [board_gw1_32.kicad_pcb, board_gw1_32.kicad_sch]
2025-01-22 24-pin UnIC is fully routed.
    [board_gw1_24.kicad_pcb, board_gw1_24.kicad_sch]
2025-01-22 Cleaned up some shapes, added series resistor to clock.
    [board_gw1_24.kicad_pcb, board_gw1_24.kicad_sch]
2025-01-24 Planes are flooded for 24-pin design.
    [board_gw1_24.kicad_pcb]
2025-01-24 Restarted 40-pin design with learnings from the 24-pin one.
    [board_gw1_40.kicad_pcb, board_gw1_40.kicad_sch]
2025-01-24 Some progress with 40-pin board.
    In the end, it might not be any better than the old one.
    We shall see...
    [board_gw1_40.kicad_pcb, board_gw1_40.kicad_sch]
2025-01-27 Some progress on 40-pin USB
    [board_gw1_40.kicad_pcb, board_gw1_40.kicad_sch]
