andrastantos/unic/(notices)

Notices in the files:
devel_gw1/devel_gw1.kicad_pcb:
(C) 2024 Andras Tantos &
board_gw1_32/board_gw1_32.kicad_pcb:
(C) 2025 Modular Circuits
(C) 2025
small_dip_excercises/unic_gw1_mini.kicad_pcb:
(C) 2024 Modular Circuits
(C) 2024 MC
